december454/Microcontroller-Engine-Governor/Photos/Carb-Wiring Harness.jpg

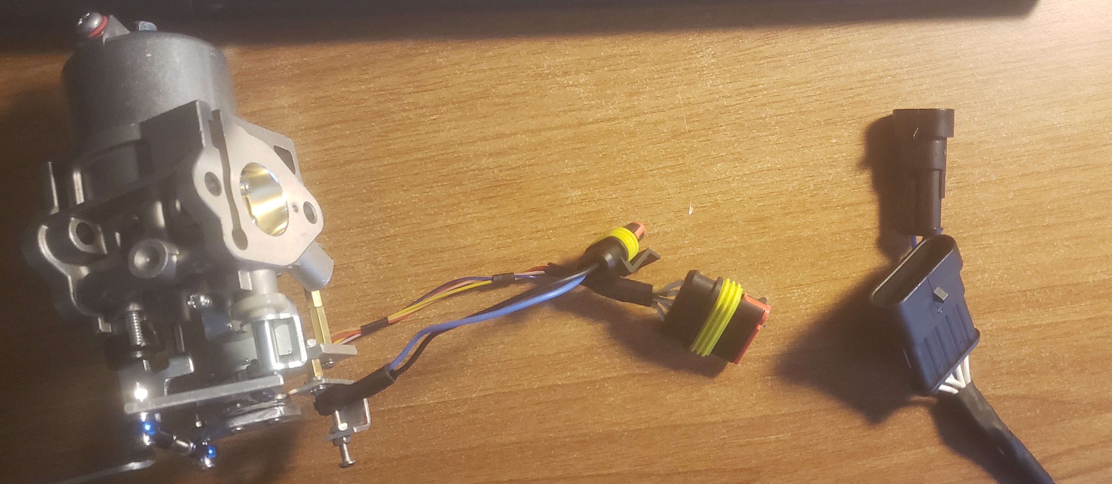
Photos/Carb-Wiring Harness.jpg
