december454/Microcontroller-Engine-Governor/Photos/Commented-Enclosure-Electronics.jpg

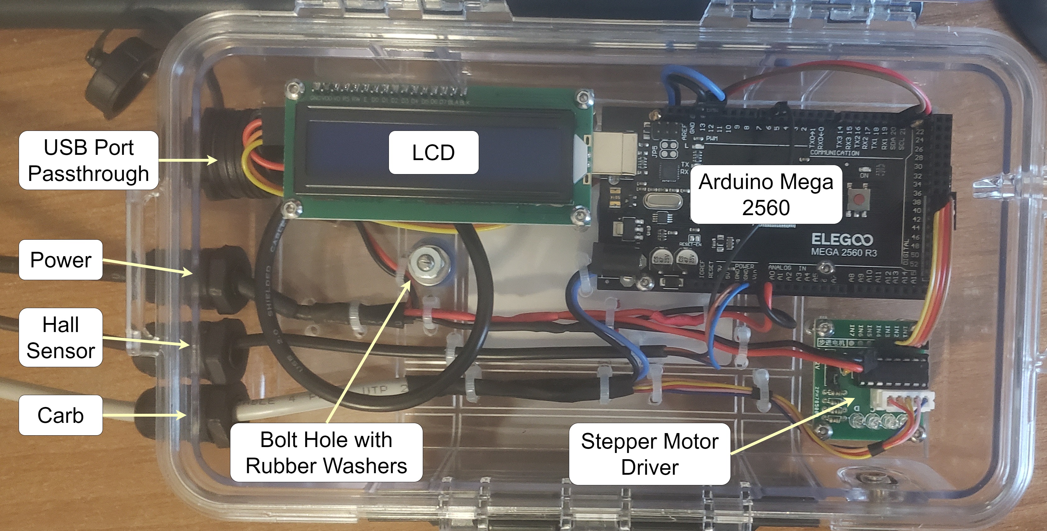
Photos/Commented-Enclosure-Electronics.jpg
