december454/Microcontroller-Engine-Governor/Diagrams/Fall 2022 - Engine Governor Simulator.pdf

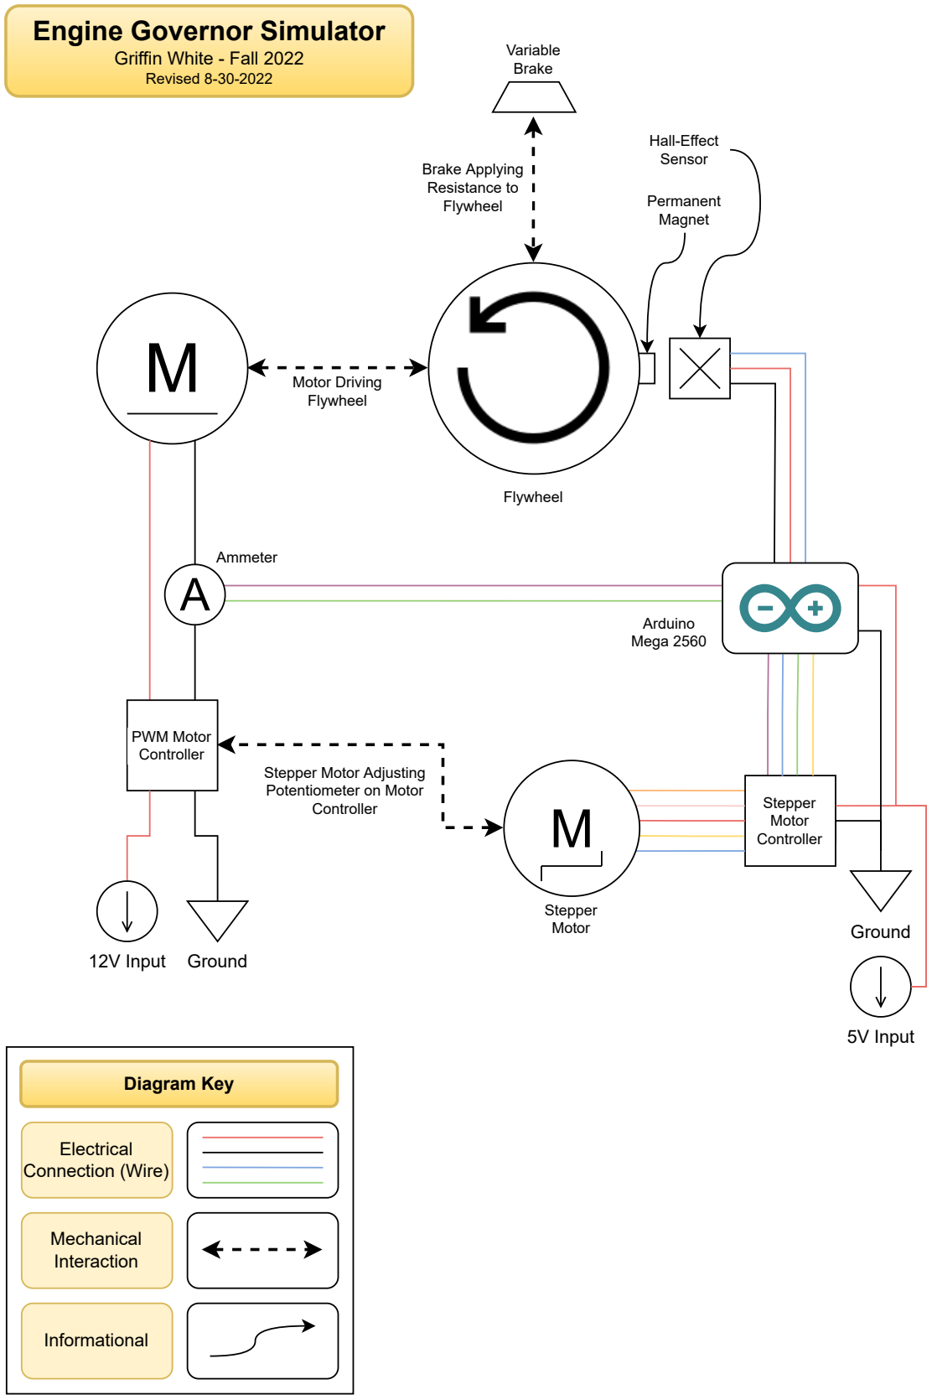
[picture p21: figure]
Ground; Stepper Motor Adjusting Potentiometer on Motor Controller; Motor Driving Flywheel; Variable Brake; Flywheel; Permanent Magnet; Hall-Effect Sensor Brake Applying; Resistance to Flywheel; Stepper Motor Controller; 5V Input; Arduino Mega 2560; Engine Governor Simulator; Griffin White - Fall 2022 Revised 8-30-2022; Diagram Key; Electrical Connection (Wire); Informational; Mechanical Interaction; PWM Motor Controller; 12V Input; Ammeter; Stepper Motor

### Component Descriptions and Functions

The flywheel assembly rotates at a constant speed. It is spun by a DC motor.

M

### Flywheel

DC Motor | The DC motor spins the flywheel. Its speed is controlled via a PWN motor controller.

### PWM Motor Controller

The PMW motor controller regulates the duty cycle of the DC motor, thereby regulating its speed. Its potentiometer is controlled by the stepper motor.

### Stepper

Motor | M

The stepper motor controls the position of the PWM motor controller's potentiometer, thereby controlling the speed of the motor. It is controlled by the Arduino.

### Hall-Effect Sensor

The hall-effect sensor produces a signal each time that a magnet passes by it. Using this signal, we can measure the RPM of the flywheel.

The brake applies a friction force to the flywheel, causing it to slow down.

### Variable Brake

Arduino | The Arduino microcontroller monitors the flywheel RPM and adjusts the stepper motor as needed.

PWM
Motor
Controller

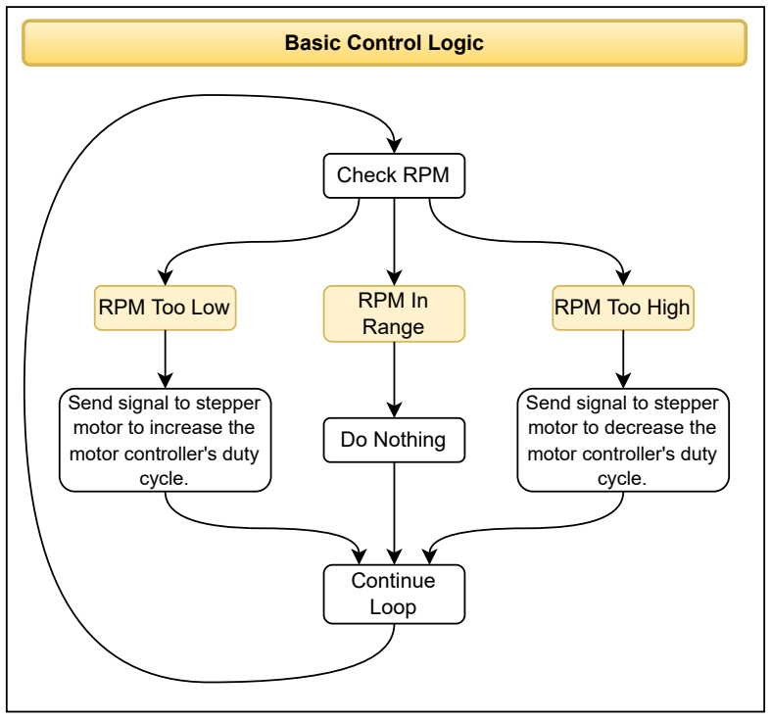
[picture p22: figure]
Check RPM; RPM Too Low; RPM In; Range; RPM Too High; Do Nothing; Send signal to stepper motor to increase the motor controller's duty cycle.; Send signal to stepper motor to decrease the motor controller's duty cycle.; Continue Loop; Basic Control Logic

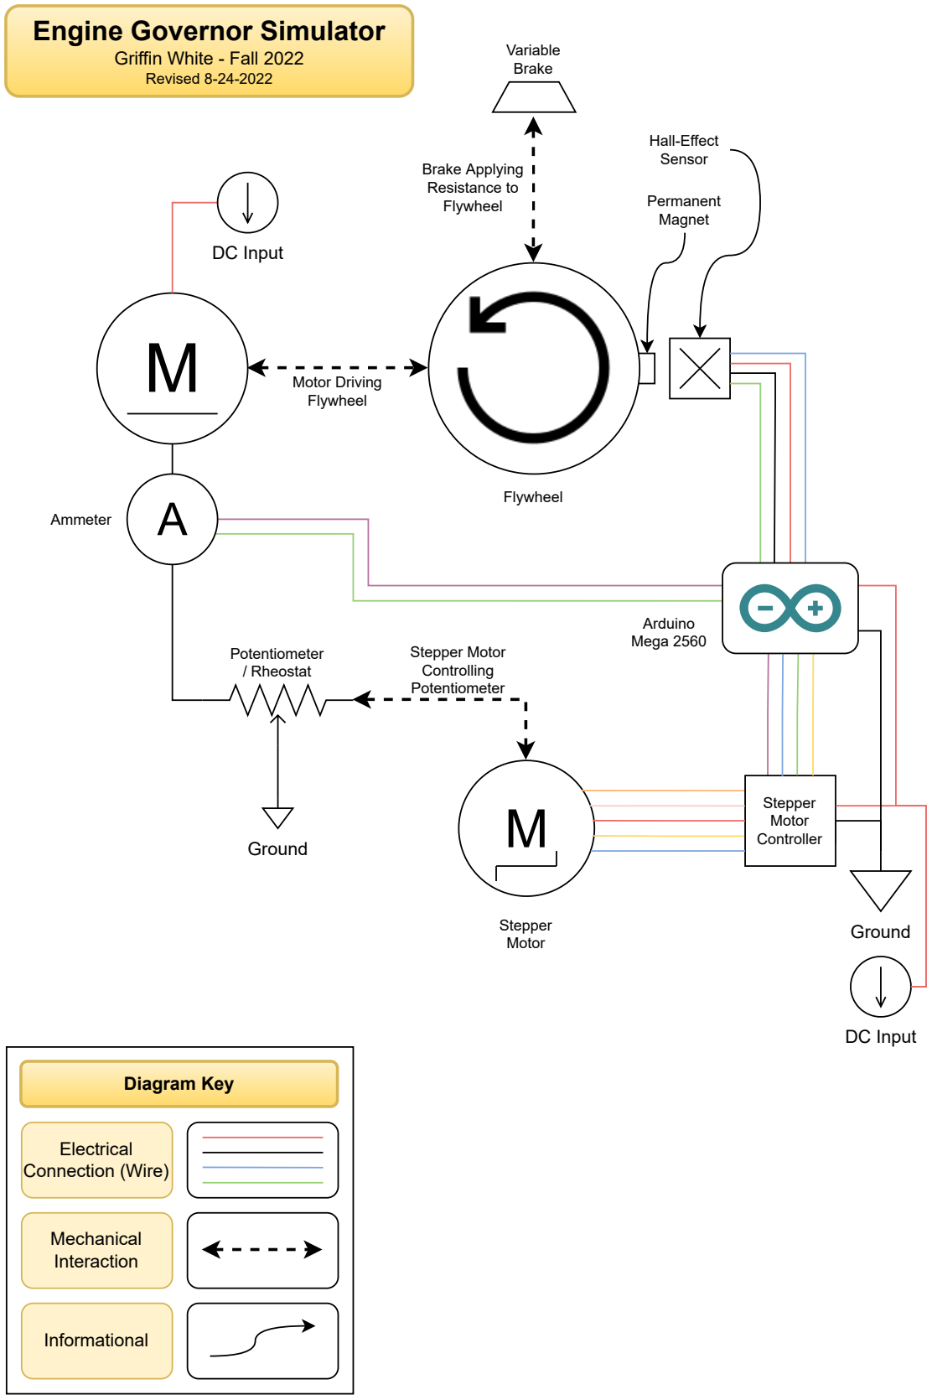
[picture p23: figure]
Ground; DC Input; Stepper Motor Controlling Potentiometer; Stepper Motor; Motor Driving Flywheel; Flywheel; Permanent Magnet; Hall-Effect Sensor Brake Applying; Resistance to Flywheel; Stepper Motor Controller; Arduino Mega 2560; Ammeter; Potentiometer / Rheostat; Engine Governor Simulator; Griffin White - Fall 2022 Revised 8-24-2022; Diagram Key; Electrical Connection (Wire); Informational; Mechanical Interaction

### Component Descriptions and Functions

The flywheel assembly rotates at a constant speed. It is spun by a DC motor.

M

### Flywheel

DC Motor | The DC motor spins the flywheel. Its speed is controlled via a potentiometer.

### Potentiometer / Rheostat

The potentiometer regulates the amount of current supplied to the DC motor, thereby regulating its speed. It is controlled by the stepper motor.

### Stepper

Motor | M

The stepper motor precisely controls the position of the potentiometer, thereby controlling the speed of the motor. It is controlled by the Arduino.

### Hall-Effect Sensor

The hall-effect sensor produces a signal each time that a magnet passes by it. Using this signal, we can measure the RPM of the flywheel.

The brake applies a friction force to the flywheel, causing it to slow down.

### Variable Brake

Arduino | The Arduino microcontroller monitors the flywheel RPM and adjusts the stepper motor as needed.

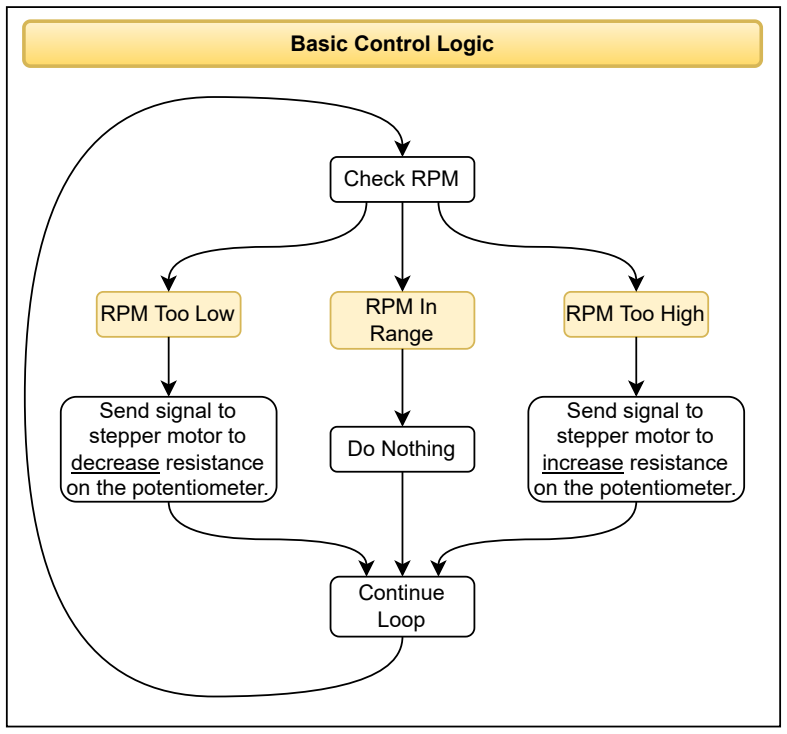
[picture p24: figure]
Check RPM; RPM Too Low; RPM In; Range; RPM Too High; Do Nothing; Send signal to stepper motor to decrease resistance on the potentiometer.; Send signal to stepper motor to increase resistance on the potentiometer.; Continue Loop; Basic Control Logic

## Permanent Magnet

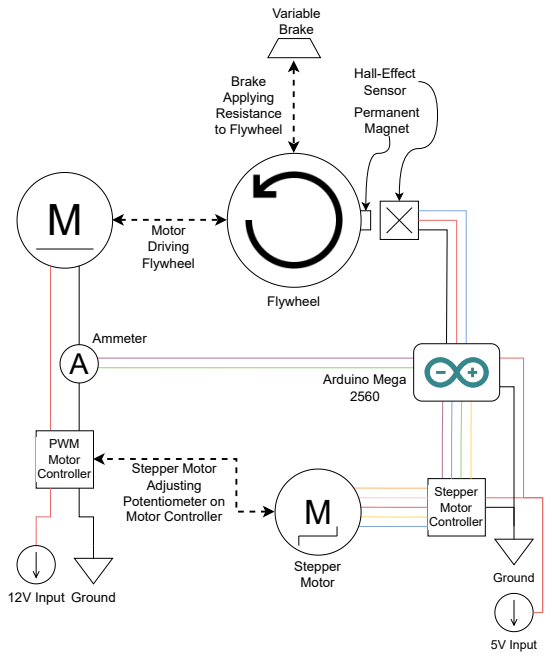
[picture p25: page 3]
Ground; Stepper Motor Adjusting Potentiometer on Motor Controller; Motor Driving Flywheel; Flywheel; Hall-Effect Sensor Brake Applying Resistance to Flywheel; Stepper Motor Controller; 5V Input; Arduino Mega 2560; PWM Motor Controller; 12V Input; Ammeter; Stepper Motor
