december454/Microcontroller-Engine-Governor/Diagrams/Spring 2023 - Microcontroller Engine Governor.pdf

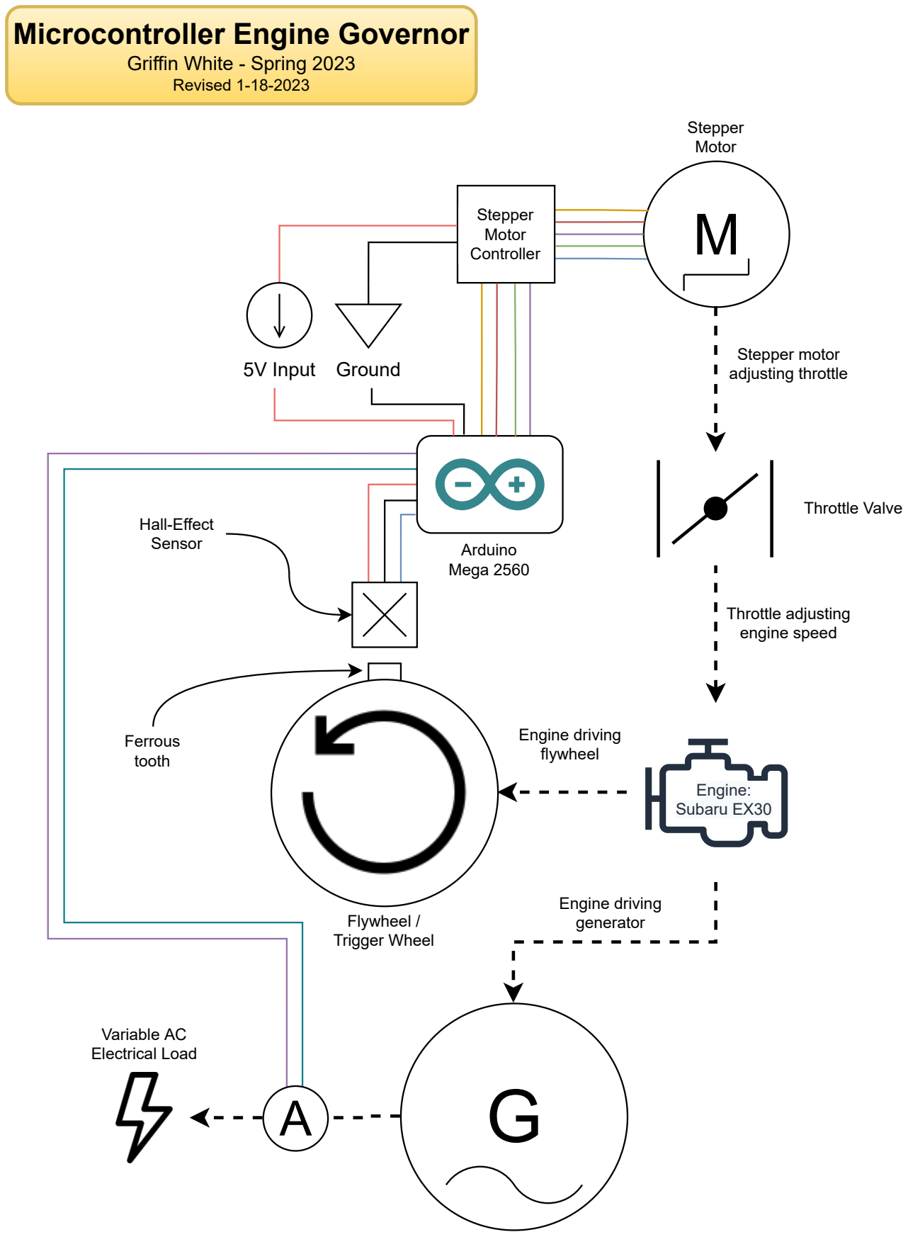
[picture p26: figure]
Microcontroller Engine Governor; Griffin White - Spring 2023 Revised 1-18-2023; Flywheel / Trigger Wheel; Engine driving flywheel; Engine driving generator; Ferrous tooth; Hall-Effect Sensor; Stepper Motor; Stepper motor adjusting throttle; Throttle Valve; Throttle adjusting engine speed; Stepper Motor Controller; Arduino Mega 2560; Engine: Subaru EX30; Variable AC Electrical Load; 5V Input Ground

### Component Descriptions and Functions

The flywheel assembly rotates at a constant speed. It is spun by the gasoline engine.

Flywheel /
Trigger Wheel
Engine | The engine spins the flywheel. Its speed is controlled via the throttle valve.

### Throttle Valve

The throttle valve regulates the amount of fuel / air provided to the engine, thereby regulating its speed. It is controlled by the stepper motor.

### Stepper

Motor | M

The stepper motor controls the position of the throttle valve, thereby controlling the speed of the engine. It is controlled by the Arduino.

### Hall-Effect Sensor

The hall-effect sensor produces a signal each time that a ferrous tooth passes by it. Using this signal, we can measure the RPM of the flywheel.

The electrical load places more / less strain on the generator, requiring the throttle to increase / decrease accordingly.

Variable AC
Electrical Load
Arduino | The Arduino microcontroller monitors the flywheel RPM and adjusts the stepper motor as needed.

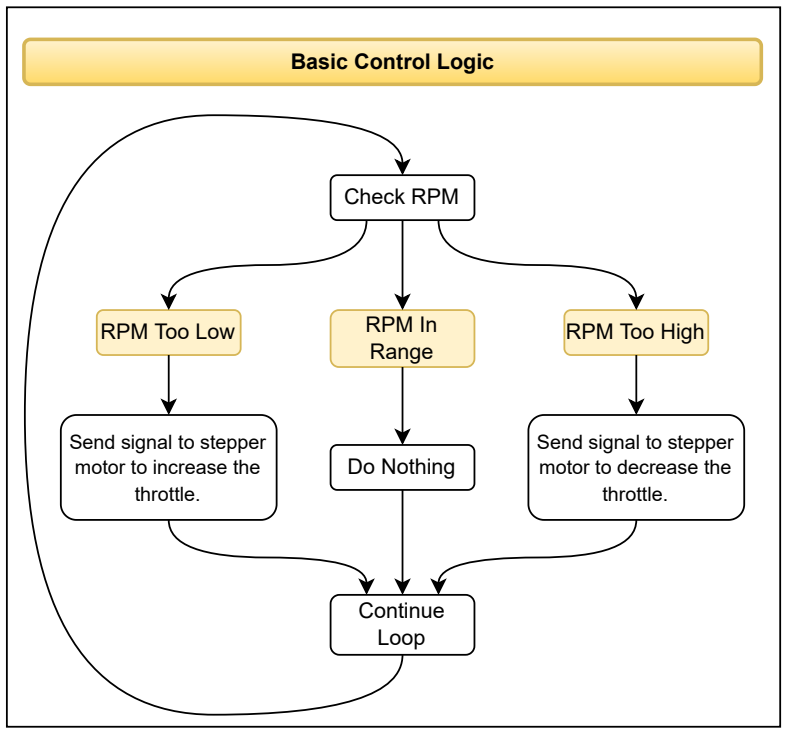
[picture p27: figure]
Check RPM; RPM Too Low; RPM In; Range; RPM Too High; Do Nothing; Send signal to stepper motor to increase the throttle.; Send signal to stepper motor to decrease the throttle.; Continue Loop; Basic Control Logic
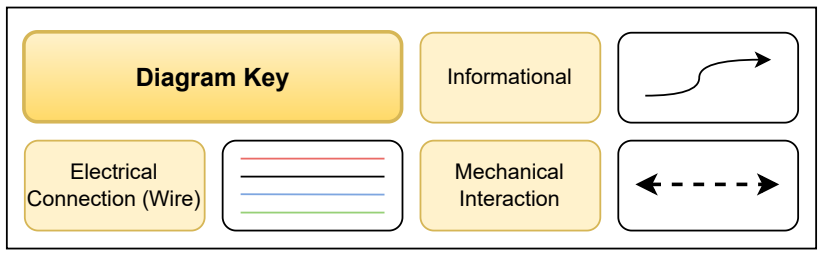
[picture p28: figure]
AC Generator; Ammeter Diagram Key; Electrical Connection (Wire); Mechanical Interaction; Informational
