december454/Microcontroller-Engine-Governor/Data-Logging/Experiments/Mechanical Governor/Abrupt Load Decrease/Trial 1.xlsx

Sheet: Trial 1
 |  |  |  |  |  |  |  |  |  | Results
1226 | 0 | 0 | 0 | 0 | 0 | 0 | 0 | 0 | 0 | Avg RPM | Std Dev | Dev from Setpoint | 20 sec to 60 sec
1276 | 0 | 0 | 0 | 0 | 0 | 0 | 0 | 0 | 0 | 3605.452559 | 37.95415156 | 29.75028714
1326 | 0 | 0 | 0 | 0 | 0 | 0 | 0 | 0 | 0 | Min RPM | Max RPM | Range
1376 | 0 | 0 | 0 | 0 | 0 | 0 | 0 | 0 | 0 | 3420.75 | 3841.23 | 420.48
1426 | 0 | 0 | 0 | 0 | 0 | 0 | 0 | 0 | 0 | Max Startup RPM | Startup Time (ms) | Overshoot Time (ms) | 0 sec to 20 sec
1476 | 0 | 0 | 0 | 0 | 0 | 0 | 0 | 0 | 0 | 3737.85 | 2950 | 150
1526 | 0 | 0 | 0 | 0 | 0 | 0 | 0 | 0 | 0
1576 | 0 | 0 | 0 | 0 | 0 | 0 | 0 | 0 | 0 | Before Load Change
1626 | 0 | 0 | 0 | 0 | 0 | 0 | 0 | 0 | 0 | Avg RPM | Std Dev | Dev from Setpoint | 20 sec to 35 sec
1676 | 0 | 0 | 0 | 0 | 0 | 0 | 0 | 0 | 0 | 3588.108372 | 32.09954969 | 24.88305648
1726 | 0 | 0 | 0 | 0 | 0 | 0 | 0 | 0 | 0 | Min RPM | Max RPM | Range
1776 | 0 | 0 | 0 | 0 | 0 | 0 | 0 | 0 | 0 | 3420.75 | 3841.23 | 420.48
1826 | 0 | 0 | 0 | 0 | 0 | 0 | 0 | 0 | 0 | During Load Change
1876 | 0 | 0 | 0 | 0 | 0 | 0 | 0 | 0 | 0 | Avg RPM | Std Dev | Dev from Setpoint | 35 sec to 45 sec
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
