december454/Microcontroller-Engine-Governor/Data-Logging/Experiments/Mechanical Governor/Abrupt Load Decrease/Trial 10.xlsx

Sheet: Trial 10
Time | RPM | Steps Remaining | PID p | PID i | PID d | RPM Change | P Cmd | I Cmd | D Cmd | Results
1226 | 0 | 0 | 0 | 0 | 0 | 0 | 0 | 0 | 0 | Avg RPM | Std Dev | Dev from Setpoint | 20 sec to 60 sec
1276 | 0 | 0 | 0 | 0 | 0 | 0 | 0 | 0 | 0 | 3603.397528 | 35.49804307 | 26.67525593
1326 | 0 | 0 | 0 | 0 | 0 | 0 | 0 | 0 | 0 | Min RPM | Max RPM | Range
1376 | 0 | 0 | 0 | 0 | 0 | 0 | 0 | 0 | 0 | 3426.22 | 3799.39 | 373.17
1426 | 0 | 0 | 0 | 0 | 0 | 0 | 0 | 0 | 0 | Max Startup RPM | Startup Time (ms) | Overshoot Time (ms) | 0 sec to 20 sec
1476 | 0 | 0 | 0 | 0 | 0 | 0 | 0 | 0 | 0 | 3840.25 | 1100 | 100
1526 | 0 | 0 | 0 | 0 | 0 | 0 | 0 | 0 | 0
1576 | 0 | 0 | 0 | 0 | 0 | 0 | 0 | 0 | 0 | Before Load Change
1626 | 0 | 0 | 0 | 0 | 0 | 0 | 0 | 0 | 0 | Avg RPM | Std Dev | Dev from Setpoint | 20 sec to 35 sec
1676 | 0 | 0 | 0 | 0 | 0 | 0 | 0 | 0 | 0 | 3590.40515 | 31.70714232 | 23.18654485
1726 | 0 | 0 | 0 | 0 | 0 | 0 | 0 | 0 | 0 | Min RPM | Max RPM | Range
1776 | 0 | 0 | 0 | 0 | 0 | 0 | 0 | 0 | 0 | 3493.25 | 3794.59 | 301.34
1826 | 0 | 0 | 0 | 0 | 0 | 0 | 0 | 0 | 0 | During Load Change
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
