december454/Microcontroller-Engine-Governor/Data-Logging/Experiments/Mechanical Governor/Abrupt Load Decrease/Trial 2.xlsx

Sheet: Trial 2
Time | RPM | Steps Remaining | PID p | PID i | PID d | RPM Change | P Cmd | I Cmd | D Cmd | Results
1226 | 0 | 0 | 0 | 0 | 0 | 0 | 0 | 0 | 0 | Avg RPM | Std Dev | Dev from Setpoint | 20 sec to 60 sec
1276 | 0 | 0 | 0 | 0 | 0 | 0 | 0 | 0 | 0 | 3608.396192 | 35.09744687 | 28.64583021
1326 | 0 | 0 | 0 | 0 | 0 | 0 | 0 | 0 | 0 | Min RPM | Max RPM | Range
1376 | 0 | 0 | 0 | 0 | 0 | 0 | 0 | 0 | 0 | 3512.88 | 3826.53 | 313.65
1426 | 0 | 0 | 0 | 0 | 0 | 0 | 0 | 0 | 0 | Max Startup RPM | Startup Time (ms) | Overshoot Time (ms) | 0 sec to 20 sec
1476 | 0 | 0 | 0 | 0 | 0 | 0 | 0 | 0 | 0 | 3726.71 | 650 | 50
1526 | 0 | 0 | 0 | 0 | 0 | 0 | 0 | 0 | 0
1576 | 0 | 0 | 0 | 0 | 0 | 0 | 0 | 0 | 0 | Before Load Change
1626 | 0 | 0 | 0 | 0 | 0 | 0 | 0 | 0 | 0 | Avg RPM | Std Dev | Dev from Setpoint | 20 sec to 35 sec
1676 | 0 | 0 | 0 | 0 | 0 | 0 | 0 | 0 | 0 | 3589.850199 | 26.70385528 | 22.26548173
1726 | 0 | 0 | 0 | 0 | 0 | 0 | 0 | 0 | 0 | Min RPM | Max RPM | Range
1776 | 0 | 0 | 0 | 0 | 0 | 0 | 0 | 0 | 0 | 3544.42 | 3826.53 | 282.11
1826 | 0 | 0 | 0 | 0 | 0 | 0 | 0 | 0 | 0 | During Load Change
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
