december454/Microcontroller-Engine-Governor/Data-Logging/Experiments/Mechanical Governor/Abrupt Load Decrease/Trial 3.xlsx

Sheet: Trial 3
Time | RPM | Steps Remaining | PID p | PID i | PID d | RPM Change | P Cmd | I Cmd | D Cmd | Results
1226 | 0 | 0 | 0 | 0 | 0 | 0 | 0 | 0 | 0 | Avg RPM | Std Dev | Dev from Setpoint | 20 sec to 60 sec
1276 | 0 | 0 | 0 | 0 | 0 | 0 | 0 | 0 | 0 | 3605.248539 | 37.4981848 | 28.23121099
1326 | 0 | 0 | 0 | 0 | 0 | 0 | 0 | 0 | 0 | Min RPM | Max RPM | Range
1376 | 0 | 0 | 0 | 0 | 0 | 0 | 0 | 0 | 0 | 3423.88 | 3834.36 | 410.48
1426 | 0 | 0 | 0 | 0 | 0 | 0 | 0 | 0 | 0 | Max Startup RPM | Startup Time (ms) | Overshoot Time (ms) | 0 sec to 20 sec
1476 | 0 | 0 | 0 | 0 | 0 | 0 | 0 | 0 | 0 | 3948.41 | 800 | 50
1526 | 0 | 0 | 0 | 0 | 0 | 0 | 0 | 0 | 0
1576 | 0 | 0 | 0 | 0 | 0 | 0 | 0 | 0 | 0 | Before Load Change
1626 | 0 | 0 | 0 | 0 | 0 | 0 | 0 | 0 | 0 | Avg RPM | Std Dev | Dev from Setpoint | 20 sec to 35 sec
1676 | 0 | 0 | 0 | 0 | 0 | 0 | 0 | 0 | 0 | 3589.564053 | 30.91480292 | 23.66318937
1726 | 0 | 0 | 0 | 0 | 0 | 0 | 0 | 0 | 0 | Min RPM | Max RPM | Range
1776 | 0 | 0 | 0 | 0 | 0 | 0 | 0 | 0 | 0 | 3517.82 | 3809.04 | 291.22
1826 | 0 | 0 | 0 | 0 | 0 | 0 | 0 | 0 | 0 | During Load Change
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
