december454/Microcontroller-Engine-Governor/Data-Logging/Experiments/Mechanical Governor/Abrupt Load Decrease/Trial 4.xlsx

Sheet: Trial 4
Time | RPM | Steps Remaining | PID p | PID i | PID d | RPM Change | P Cmd | I Cmd | D Cmd | Results
1226 | 0 | 0 | 0 | 0 | 0 | 0 | 0 | 0 | 0 | Avg RPM | Std Dev | Dev from Setpoint | 20 sec to 60 sec
1276 | 0 | 0 | 0 | 0 | 0 | 0 | 0 | 0 | 0 | 3607.228989 | 33.62950333 | 27.28516854
1326 | 0 | 0 | 0 | 0 | 0 | 0 | 0 | 0 | 0 | Min RPM | Max RPM | Range
1376 | 0 | 0 | 0 | 0 | 0 | 0 | 0 | 0 | 0 | 3476.25 | 3803.25 | 327
1426 | 0 | 0 | 0 | 0 | 0 | 0 | 0 | 0 | 0 | Max Startup RPM | Startup Time (ms) | Overshoot Time (ms) | 0 sec to 20 sec
1476 | 0 | 0 | 0 | 0 | 0 | 0 | 0 | 0 | 0 | 3792.67 | 700 | N/A
1526 | 0 | 0 | 0 | 0 | 0 | 0 | 0 | 0 | 0
1576 | 0 | 0 | 0 | 0 | 0 | 0 | 0 | 0 | 0 | Before Load Change
1626 | 0 | 0 | 0 | 0 | 0 | 0 | 0 | 0 | 0 | Avg RPM | Std Dev | Dev from Setpoint | 20 sec to 35 sec
1676 | 0 | 0 | 0 | 0 | 0 | 0 | 0 | 0 | 0 | 3591.365847 | 25.2606089 | 22.40186047
1726 | 0 | 0 | 0 | 0 | 0 | 0 | 0 | 0 | 0 | Min RPM | Max RPM | Range
1776 | 0 | 0 | 0 | 0 | 0 | 0 | 0 | 0 | 0 | 3512.06 | 3638.13 | 126.07
1826 | 0 | 0 | 0 | 0 | 0 | 0 | 0 | 0 | 0 | During Load Change
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
