december454/Microcontroller-Engine-Governor/Data-Logging/3-1-2023/Generator RPM Graph - 3-1-2023 (Intake Leak).png

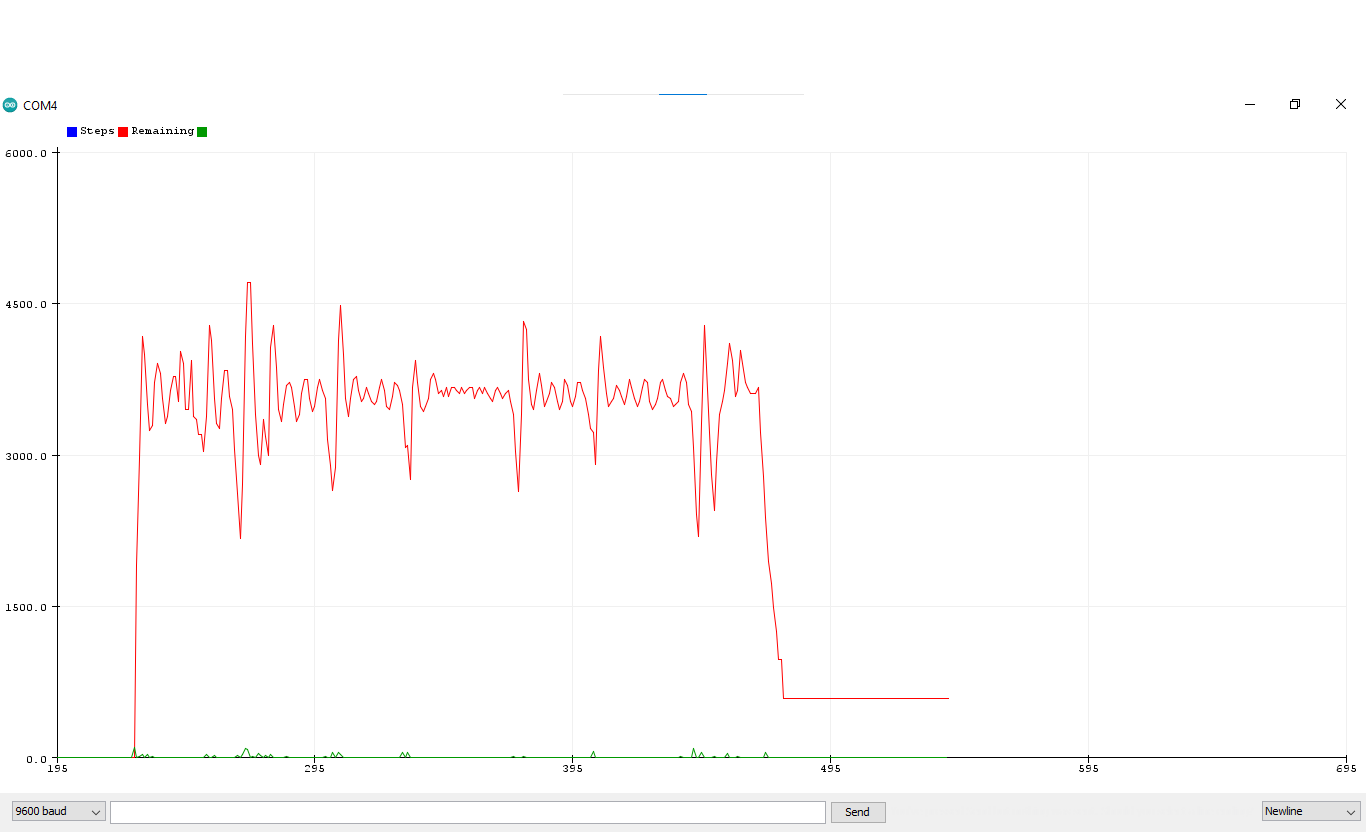
Data-Logging/3-1-2023/Generator RPM Graph - 3-1-2023 (Intake Leak).png
