december454/Microcontroller-Engine-Governor/Photos/Carburetor - Original Stepper Mounting - Commented.jpg

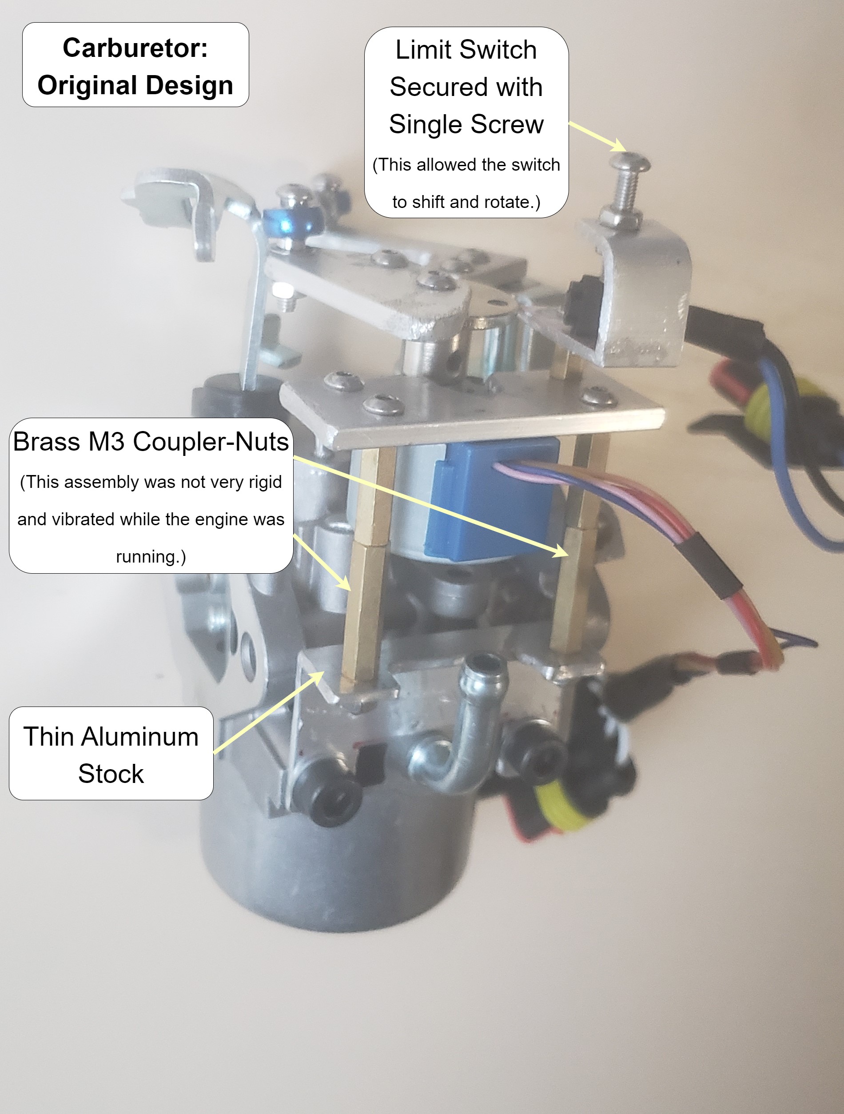
Photos/Carburetor - Original Stepper Mounting - Commented.jpg
