december454/Microcontroller-Engine-Governor/Photos/Carburetor - Revised Stepper Mounting - Commented.jpg

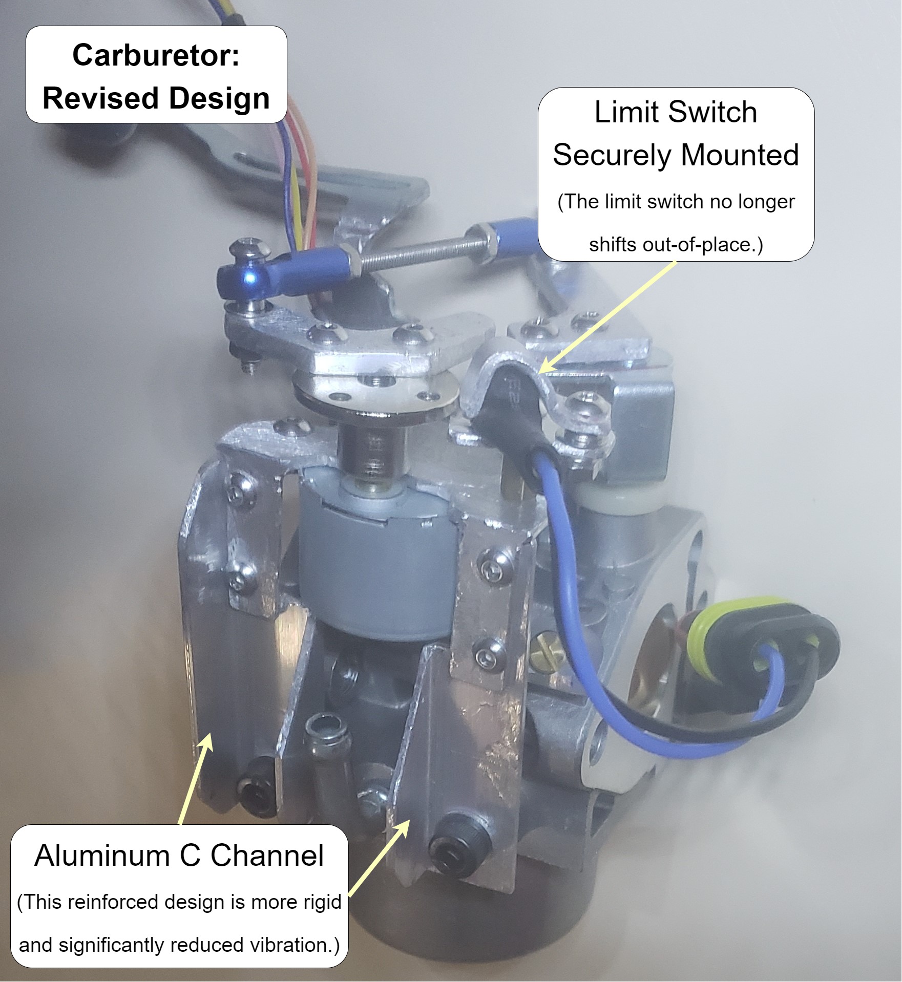
Photos/Carburetor - Revised Stepper Mounting - Commented.jpg
