december454/Microcontroller-Engine-Governor/Photos/Commented Engine Governor Carb - Initial.jpg

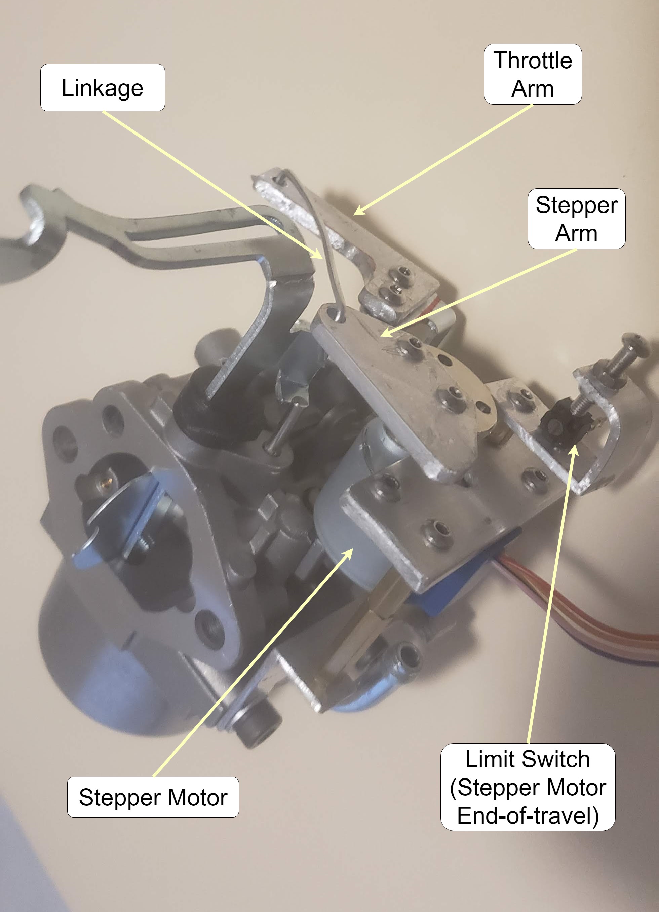
Photos/Commented Engine Governor Carb - Initial.jpg
