december454/Microcontroller-Engine-Governor/Photos/Enclosure - New LCD and Switches - Commented.jpg

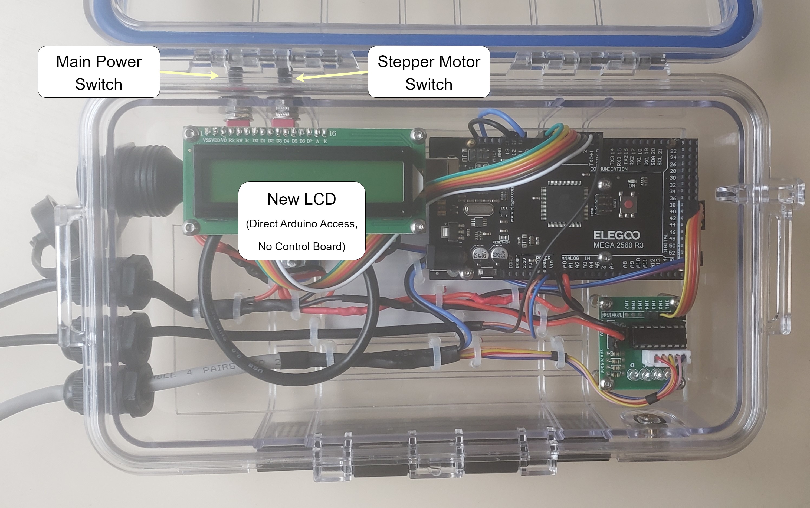
Photos/Enclosure - New LCD and Switches - Commented.jpg
