december454/Microcontroller-Engine-Governor/Photos/Enclosure-Cables Detail.jpg

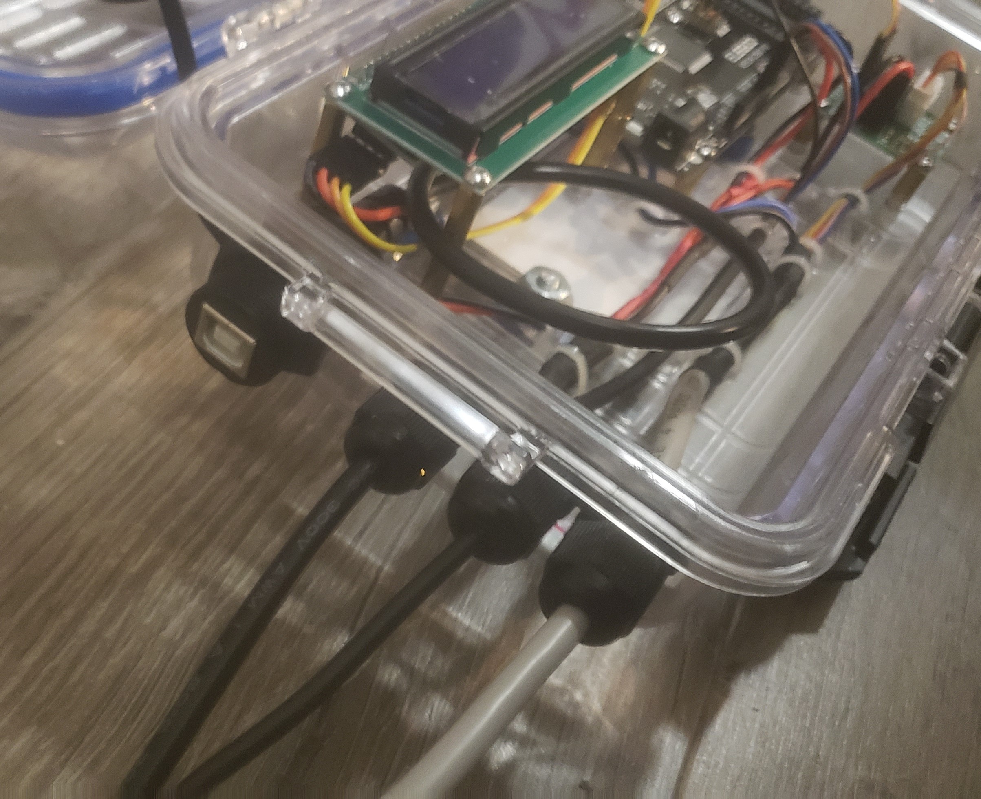
Photos/Enclosure-Cables Detail.jpg
