december454/Microcontroller-Engine-Governor/Photos/Enclosure-Lid Closed.jpg

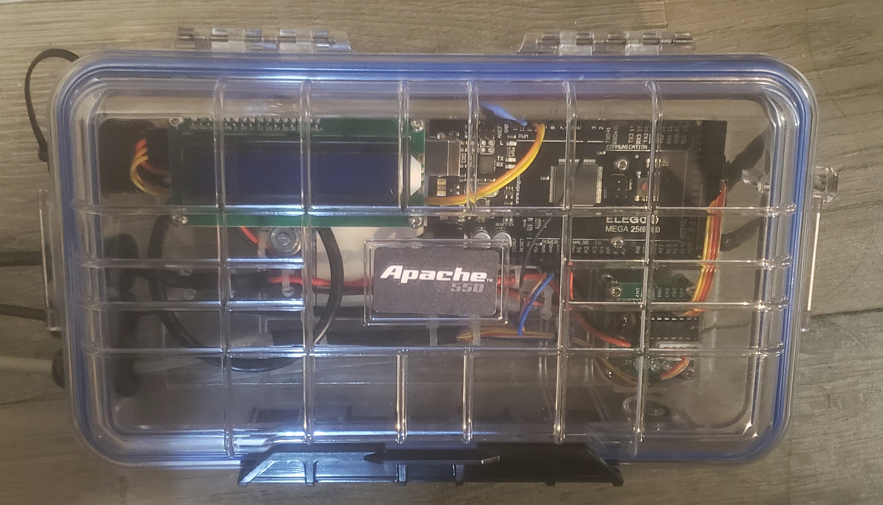
Photos/Enclosure-Lid Closed.jpg
