december454/Microcontroller-Engine-Governor/Photos/Switches - Detail - Commented.jpg

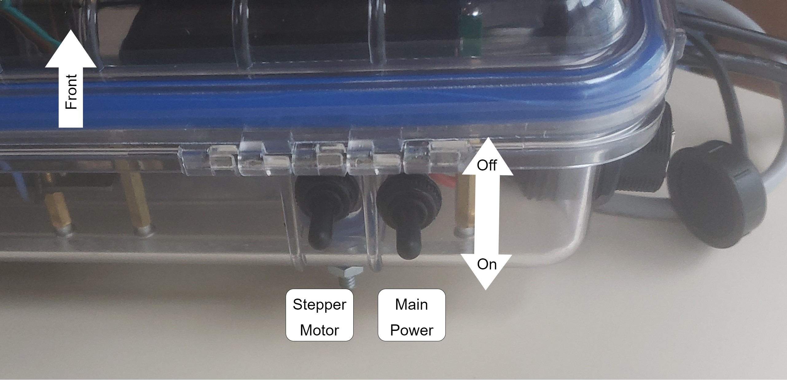
Photos/Switches - Detail - Commented.jpg
