december454/Microcontroller-Engine-Governor/Data-Logging/4-4-2023/4-4-2023 - PID Tuning - PID P Alt - (P 013 I 025 D 1) - Dynamic D Disabled.txt

------ Microcontroller Engine Governor - Version: 1.16 ------
-------------------------------------------------------------
PID Gains:        Kp: 0.013000   Ki: 0.025000   Kd: 1.000000
-------------------------------------------------------------
Set RPM:             3600    |  Min RPM:                300
                             |
RPM Precision        10       |  PID I Precision:         70
                             |
Start Steps:         850     |  Max Steps:               1200
                             |
RPM Calc Interval:   1       |  Num Magnets:             1
                             |
LCD Update Interval: 400     |  Serial Update Interval:  50
-------------------------------------------------------------

Time,RPM,Steps Remaining, PID p, PID i, PID d, RPM Change, P Cmd, I Cmd, D Cmd
1642,0.00,0,0,0,0,0.00,0,0,0
1692,0.00,0,0,0,0,0.00,0,0,0
1742,0.00,0,0,0,0,0.00,0,0,0
1792,0.00,0,0,0,0,0.00,0,0,0
1842,0.00,0,0,0,0,0.00,0,0,0
1892,0.00,0,0,0,0,0.00,0,0,0
1942,0.00,0,0,0,0,0.00,0,0,0
1992,0.00,0,0,0,0,0.00,0,0,0
2042,0.00,0,0,0,0,0.00,0,0,0
2092,0.00,0,0,0,0,0.00,0,0,0
2142,0.00,0,0,0,0,0.00,0,0,0
2192,0.00,0,0,0,0,0.00,0,0,0
2242,0.00,0,0,0,0,0.00,0,0,0
2292,0.00,0,0,0,0,0.00,0,0,0
2342,0.00,0,0,0,0,0.00,0,0,0
2392,0.00,0,0,0,0,0.00,0,0,0
2442,0.00,0,0,0,0,0.00,0,0,0
2492,0.00,0,0,0,0,0.00,0,0,0
2542,0.00,0,0,0,0,0.00,0,0,0
2592,0.00,0,0,0,0,0.00,0,0,0
2642,0.00,0,0,0,0,0.00,0,0,0
2692,0.00,0,0,0,0,0.00,0,0,0
2742,0.00,0,0,0,0,0.00,0,0,0
2792,0.00,0,0,0,0,0.00,0,0,0
2842,0.00,0,0,0,0,0.00,0,0,0
2892,0.00,0,0,0,0,0.00,0,0,0
2942,0.00,0,0,0,0,0.00,0,0,0
2992,0.00,0,0,0,0,0.00,0,0,0
3042,0.00,0,0,0,0,0.00,0,0,0
3092,0.00,0,0,0,0,0.00,0,0,0
3142,inf,0,0,0,0,inf,0,0,0
3192,inf,0,0,0,0,inf,0,0,0
3243,inf,0,0,0,0,inf,0,0,0
3293,inf,0,0,0,0,inf,0,0,0
3343,309.82,13,42,0,0,inf,42,0,0
3393,309.82,0,42,0,0,inf,42,0,0
3443,706.21,0,37,0,-4,-396.39,79,0,4
3493,748.09,23,37,0,0,-41.88,116,0,4
3543,1124.78,15,32,0,-7,-376.68,148,0,11
3593,1135.59,25,32,0,0,-10.81,180,0,11
3643,1507.99,0,27,0,-9,-372.40,207,0,20
3693,1535.78,0,26,0,0,-27.79,233,0,20
3743,1795.98,11,23,0,0,-17.67,279,0,27
3793,2061.86,16,19,0,0,-12.40,318,0,35
3843,2279.29,0,17,0,-8,-217.43,335,0,43
3893,2494.59,18,14,0,6,165.45,379,0,74
3943,2685.28,4,11,0,0,11.59,401,0,83
3993,2852.80,0,9,0,0,7.07,419,0,91
4043,3144.65,0,5,0,-7,-141.65,438,0,106
4093,3267.97,3,4,0,0,4.99,452,0,113
4143,3393.67,0,2,0,0,-3.83,456,0,119
4193,3602.31,0,1,0,0,-0.81,458,0,119
4243,3665.69,0,0,-1,0,11.68,459,1,119
4293,3826.53,-1,-2,0,0,10.77,467,1,124
4343,3945.29,-4,-4,0,-4,-68.32,477,1,131
4393,3997.87,0,-5,0,0,16.05,491,1,136
4443,4055.15,0,-5,0,-2,-43.38,506,1,141
4493,4285.71,-28,-8,0,-25,-356.96,529,1,183
4543,3995.74,0,-5,0,0,302.26,547,1,209
4593,3995.74,-3,-5,0,0,254.76,573,1,242
4643,4173.62,-10,-7,0,-12,-175.76,593,1,272
4694,3995.74,0,-5,0,0,254.76,610,1,297
4744,4040.95,-2,-5,0,-2,-43.08,633,1,352
4794,3986.18,0,-5,0,0,-13.72,647,1,352
4844,3945.29,0,-4,0,0,12.49,659,1,352
4894,4261.36,-50,-8,0,-45,-639.05,675,1,419
4944,3917.47,0,-4,0,0,-13.26,686,1,419
4994,3825.55,0,-2,0,0,39.43,694,1,419
5044,3838.28,0,-3,0,-2,-36.00,702,1,421
5094,3824.58,0,-2,0,0,27.50,709,1,423
5144,3757.52,-44,-2,0,-44,-9.39,719,1,555
5194,3757.52,-42,-2,0,-44,0.94,724,1,687
5244,3722.08,-7,-1,0,-13,26.98,730,1,726
5294,3632.84,0,0,0,0,41.83,731,1,739
5344,3546.10,0,0,1,0,38.99,731,2,739
5394,3494.06,0,1,0,0,8.16,733,3,739
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
