december454/Microcontroller-Engine-Governor/Data-Logging/4-4-2023/4-4-2023 - PID Tuning - PID P Alt - (P 013 I 025 D 1) - Major RPM Change Disabled.txt

Time	RPM	Steps Remaining	 PID p	 PID i	 PID d	 RPM Change	 P Cmd	 I Cmd	 D Cmd
1716	0	0	0	0	0	0	0	0	0
1766	0	0	0	0	0	0	0	0	0
1816	0	0	0	0	0	0	0	0	0
1866	0	0	0	0	0	0	0	0	0
1916	0	0	0	0	0	0	0	0	0
1966	0	0	0	0	0	0	0	0	0
2016	0	0	0	0	0	0	0	0	0
2066	0	0	0	0	0	0	0	0	0
2116	0	0	0	0	0	0	0	0	0
2166	0	0	0	0	0	0	0	0	0
2216	0	0	0	0	0	0	0	0	0
2266	0	0	0	0	0	0	0	0	0
2316	0	0	0	0	0	0	0	0	0
2366	0	0	0	0	0	0	0	0	0
2416	0	0	0	0	0	0	0	0	0
2466	0	0	0	0	0	0	0	0	0
2516	0	0	0	0	0	0	0	0	0
2566	0	0	0	0	0	0	0	0	0
2616	0	0	0	0	0	0	0	0	0
2666	0	0	0	0	0	0	0	0	0
2716	0	0	0	0	0	0	0	0	0
2766	0	0	0	0	0	0	0	0	0
2816	0	0	0	0	0	0	0	0	0
2866	0	0	0	0	0	0	0	0	0
2916	0	0	0	0	0	0	0	0	0
2966	0	0	0	0	0	0	0	0	0
3016	0	0	0	0	0	0	0	0	0
3066	0	0	0	0	0	0	0	0	0
3116	0	0	0	0	0	0	0	0	0
3166	0	0	0	0	0	0	0	0	0
3216	0	0	0	0	0	0	0	0	0
3266	0	0	0	0	0	0	0	0	0
3316	0	0	0	0	0	0	0	0	0
3366	0	0	0	0	0	0	0	0	0
3416	0	0	0	0	0	0	0	0	0
3466	0	0	0	0	0	0	0	0	0
3516	0	0	0	0	0	0	0	0	0
3566	0	0	0	0	0	0	0	0	0
3616	0	0	0	0	0	0	0	0	0
3666	0	0	0	0	0	0	0	0	0
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
4767	inf	0	0	0	0	inf	0	0	0
4817	inf	0	0	0	0	inf	0	0	0
4867	inf	0	0	0	0	inf	0	0	0
4917	inf	0	0	0	0	inf	0	0	0
4967	342.43	0	42	0	0	inf	42	0	0
5017	798.21	10	36	0	-5	-455.79	78	0	5
5067	798.21	0	36	0	-5	-455.79	78	0	5
5117	759.88	0	36	0	0	38.33	114	0	5
5167	742.94	26	37	0	0	16.94	151	0	5
5217	742.94	0	37	0	0	16.94	151	0	5
5267	731.92	8	37	0	0	11.02	188	0	5
5317	1131.31	0	32	0	-7	-399.39	220	0	12
5367	1144.16	10	31	0	0	-12.86	251	0	12
5417	1535.94	0	26	0	-10	-391.78	277	0	22
5467	1792.76	4	23	0	-7	-237.39	326	0	29
5517	1808.75	0	23	0	0	-16	349	0	29
5567	2154.24	0	18	0	-5	-158.5	387	0	40
5617	2310.18	0	16	0	0	-16.95	419	0	45
5667	2517.62	0	14	0	0	2.54	447	0	54
5718	2910.36	0	8	0	-5	-112.9	477	0	71
5768	3068.11	0	6	0	-8	-165.64	492	0	79
5818	3207.87	0	5	0	0	9.63	507	0	87
5868	3460.21	0	1	0	-2	-122.42	514	0	97
5918	3573.13	0	0	0	0	5.97	515	0	97
5968	3763.17	0	-2	0	0	-81.29	519	0	97
6018	3843.2	0	-3	0	0	7.89	527	0	102
6068	3975.62	0	-4	0	-4	-67.33	539	0	112
6118	4051.86	-5	-5	0	-3	-51.86	558	0	118
6168	4077.19	0	-6	0	0	35.77	575	0	123
6218	4144.79	-6	-7	0	0	12.64	601	0	129
6268	4162.04	0	-7	0	0	1.15	622	0	131
6318	4174.78	0	-7	0	0	13.99	643	0	133
6368	4447.08	-31	-11	0	-27	-415.91	674	0	194
6418	4029.01	0	-5	0	0	278.86	695	0	201
6468	4534.46	-42	-12	0	-38	-505.45	734	0	324
6518	4200.5	-6	-7	0	0	-4.7	763	0	326
6568	4137.93	0	-6	0	0	11.45	783	0	326
6618	4142.5	0	-7	0	-1	-18.22	803	0	327
6668	4088.31	-4	-6	0	-3	-58.22	826	0	340
6718	4006.41	0	-5	0	0	9.65	841	0	340
6768	4030.09	0	-5	0	-2	-31.16	856	0	343
6818	4014.99	-17	-5	0	-16	-234.75	873	1	443
6868	3779.29	-10	-2	0	-16	328.05	885	1	470
6918	3780.24	-12	-2	0	-22	415.56	898	1	519
6968	3858.02	-2	-3	0	0	129.22	915	1	533
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
