december454/Microcontroller-Engine-Governor/Data-Logging/4-4-2023/4-4-2023 - PID Tuning - PID P Alt - (P 02 I 025 D 2) - Major RPM Change Disabled.txt

------ Microcontroller Engine Governor - Version: 1.16 ------
-------------------------------------------------------------
PID Gains:        Kp: 0.020000   Ki: 0.025000   Kd: 2.000000
-------------------------------------------------------------
Set RPM:             3600    |  Min RPM:                300
                             |
RPM Precision        10       |  PID I Precision:         70
                             |
Start Steps:         850     |  Max Steps:               1200
                             |
RPM Calc Interval:   1       |  Num Magnets:             1
                             |
LCD Update Interval: 400     |  Serial Update Interval:  50
-------------------------------------------------------------

Time,RPM,Steps Remaining, PID p, PID i, PID d, RPM Change, P Cmd, I Cmd, D Cmd
90,inf,0,0,0,0,0.00,0,0,0
140,3205.13,0,0,0,0,0.00,0,0,0
190,3187.42,0,0,0,0,0.00,0,0,0
240,3240.44,0,0,0,0,0.00,0,0,0
290,3248.86,0,0,0,0,0.00,0,0,0
340,3258.74,0,0,0,0,0.00,0,0,0
390,3196.25,0,0,0,0,0.00,0,0,0
440,3151.92,0,0,0,0,0.00,0,0,0
490,3152.58,0,0,0,0,0.00,0,0,0
540,3186.74,0,0,0,0,0.00,0,0,0
590,3161.89,0,0,0,0,0.00,0,0,0
640,3143.99,0,0,0,0,0.00,0,0,0
690,3205.13,0,0,0,0,0.00,0,0,0
740,3160.56,0,0,0,0,0.00,0,0,0
790,3110.74,0,0,0,0,0.00,0,0,0
840,3056.86,0,0,0,0,0.00,0,0,0
890,3070.00,0,0,0,0,0.00,0,0,0
940,3038.28,0,0,0,0,0.00,0,0,0
990,3046.30,0,0,0,0,0.00,0,0,0
1040,3022.97,0,0,0,0,0.00,0,0,0
1090,3022.37,0,0,0,0,0.00,0,0,0
1140,2946.38,0,0,0,0,0.00,0,0,0
1190,2954.50,0,0,0,0,0.00,0,0,0
1240,2925.12,0,0,0,0,0.00,0,0,0
1290,2931.41,0,0,0,0,0.00,0,0,0
1340,2881.29,0,0,0,0,0.00,0,0,0
1390,2873.56,0,0,0,0,0.00,0,0,0
1440,2831.79,0,0,0,0,0.00,0,0,0
1490,2805.31,0,0,0,0,0.00,0,0,0
1540,2777.78,0,0,0,0,0.00,0,0,0
1590,2726.28,0,0,0,0,0.00,0,0,0
1640,2653.46,0,0,0,0,0.00,0,0,0
1690,2627.43,0,0,0,0,0.00,0,0,0
1740,2633.43,0,0,0,0,0.00,0,0,0
1790,2592.91,0,0,0,0,0.00,0,0,0
1840,2616.43,0,0,0,0,0.00,0,0,0
1890,2610.97,0,0,0,0,0.00,0,0,0
1940,2639.92,0,0,0,0,0.00,0,0,0
1990,2581.76,0,0,0,0,0.00,0,0,0
2040,2526.53,0,0,0,0,0.00,0,0,0
2091,2477.29,0,0,0,0,0.00,0,0,0
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
