december454/Microcontroller-Engine-Governor/Data-Logging/4-5-2023/4-5-2023 - PID Tuning - PID P Alt - (P 013 I 025 D 0_1).txt

846,0.00,0,0,0,0,0.00,0,0,0
9996,0.00,0,0,0,0,0.00,0,0,0
10046,0.00,0,0,0,0,0.00,0,0,0
10096,0.00,0,0,0,0,0.00,0,0,0
------ Microcontroller Engine Governor - Version: 1.16 ------
-------------------------------------------------------------
PID Gains:        Kp: 0.013000   Ki: 0.025000   Kd: 0.100000
-------------------------------------------------------------
Set RPM:             3600    |  Min RPM:                300
                             |
RPM Precision        20       |  PID I Precision:         70
                             |
Start Steps:         850     |  Max Steps:               1200
                             |
RPM Calc Interval:   1       |  Num Magnets:             1
                             |
LCD Update Interval: 400     |  Serial Update Interval:  50
-------------------------------------------------------------

Time,RPM,Steps Remaining, PID p, PID i, PID d, RPM Change, P Cmd, I Cmd, D Cmd
1717,0.00,0,0,0,0,0.00,0,0,0
1767,0.00,0,0,0,0,0.00,0,0,0
1817,0.00,0,0,0,0,0.00,0,0,0
1867,0.00,0,0,0,0,0.00,0,0,0
1917,0.00,0,0,0,0,0.00,0,0,0
1967,0.00,0,0,0,0,0.00,0,0,0
2017,0.00,0,0,0,0,0.00,0,0,0
2067,0.00,0,0,0,0,0.00,0,0,0
2117,0.00,0,0,0,0,0.00,0,0,0
2167,0.00,0,0,0,0,0.00,0,0,0
2217,0.00,0,0,0,0,0.00,0,0,0
2267,0.00,0,0,0,0,0.00,0,0,0
2317,0.00,0,0,0,0,0.00,0,0,0
2367,0.00,0,0,0,0,0.00,0,0,0
2417,0.00,0,0,0,0,0.00,0,0,0
2467,0.00,0,0,0,0,0.00,0,0,0
2518,0.00,0,0,0,0,0.00,0,0,0
2568,0.00,0,0,0,0,0.00,0,0,0
2618,0.00,0,0,0,0,0.00,0,0,0
2668,0.00,0,0,0,0,0.00,0,0,0
2718,0.00,0,0,0,0,0.00,0,0,0
2768,0.00,0,0,0,0,0.00,0,0,0
2818,0.00,0,0,0,0,0.00,0,0,0
2868,0.00,0,0,0,0,0.00,0,0,0
2918,0.00,0,0,0,0,0.00,0,0,0
2968,0.00,0,0,0,0,0.00,0,0,0
3018,0.00,0,0,0,0,0.00,0,0,0
3068,0.00,0,0,0,0,0.00,0,0,0
3118,0.00,0,0,0,0,0.00,0,0,0
3168,0.00,0,0,0,0,0.00,0,0,0
3218,0.00,0,0,0,0,0.00,0,0,0
3268,0.00,0,0,0,0,0.00,0,0,0
3318,0.00,0,0,0,0,0.00,0,0,0
3368,0.00,0,0,0,0,0.00,0,0,0
3418,0.00,0,0,0,0,0.00,0,0,0
3468,0.00,0,0,0,0,0.00,0,0,0
3518,0.00,0,0,0,0,0.00,0,0,0
3568,0.00,0,0,0,0,0.00,0,0,0
3618,0.00,0,0,0,0,0.00,0,0,0
3668,0.00,0,0,0,0,0.00,0,0,0
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
6069,inf,0,0,0,0,inf,0,0,0
6119,828.09,29,36,0,0,inf,36,0,0
6169,828.09,0,36,0,0,inf,36,0,0
6219,779.87,5,36,0,0,48.22,72,0,0
6269,766.64,33,36,0,0,13.23,108,0,0
6319,766.64,0,36,0,0,13.23,108,0,0
6369,760.96,13,36,0,0,5.68,144,0,0
6419,1171.88,9,31,0,0,-410.92,175,0,0
6469,1186.52,9,31,0,0,-14.65,206,0,0
6519,1573.81,0,26,0,-1,-387.29,232,0,1
6569,1841.17,10,22,0,0,-249.32,280,0,1
6619,2129.47,17,19,0,0,-248.83,321,0,1
6669,2154.24,0,18,0,0,-24.77,339,0,1
6719,2619.63,11,12,0,0,-150.90,381,0,1
6769,2814.26,3,10,0,0,-205.11,403,0,1
6819,2992.22,0,7,0,0,-178.49,420,0,1
6870,3163.22,0,5,0,0,-4.00,437,0,1
6920,3457.81,0,1,0,0,-139.96,444,0,2
6970,3575.69,0,0,0,0,24.89,445,0,2
7020,3795.55,0,-2,0,0,-97.32,449,0,2
7070,3849.11,0,-3,0,0,23.85,457,0,2
7120,4012.84,0,-5,0,0,-85.11,470,0,2
7170,4140.22,-4,-7,0,0,-57.47,494,0,2
7220,4125.41,0,-6,0,0,28.56,513,0,2
7270,4263.79,-5,-8,0,0,-2.42,543,0,2
7320,4310.34,0,-9,0,0,-17.27,570,0,2
7370,4410.47,-6,-10,0,0,-67.68,607,0,2
7420,4443.13,-9,-10,0,0,-36.55,646,0,3
7470,4441.81,0,-10,0,0,18.49,677,0,3
7520,4443.13,-4,-10,0,0,33.15,719,0,3
7570,4458.98,-9,-11,0,0,1.33,762,0,3
7620,4512.64,0,-11,0,0,-54.98,795,0,3
7670,4477.61,-3,-11,0,0,-35.80,838,0,3
7720,4373.18,-7,-10,0,0,14.07,878,0,3
7770,4357.93,0,-9,0,0,16.52,906,0,3
7820,4342.79,-3,-9,0,0,31.66,943,0,3
7870,4359.20,-8,-9,0,0,15.26,981,0,3
7920,4357.93,0,-9,0,0,2.53,1009,0,3
7970,4311.58,-5,-9,0,0,-34.42,1044,0,3
8020,4278.38,0,-8,0,0,30.73,1069,0,3
8070,4230.12,-4,-8,0,0,31.24,1101,0,3
8120,4228.93,0,-8,0,0,-14.26,1124,0,3
8170,4184.10,-3,-7,0,0,16.40,1153,0,3
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
