december454/Microcontroller-Engine-Governor/Data-Logging/4-5-2023/4-5-2023 - PID Tuning - PID P Alt - (P 013 I 025 D 3) - Dynamic D Gain Disabled.txt

------ Microcontroller Engine Governor - Version: 1.16 ------
-------------------------------------------------------------
PID Gains:        Kp: 0.013000   Ki: 0.025000   Kd: 3.000000
-------------------------------------------------------------
Set RPM:             3600    |  Min RPM:                300
                             |
RPM Precision        10       |  PID I Precision:         70
                             |
Start Steps:         850     |  Max Steps:               1200
                             |
RPM Calc Interval:   1       |  Num Magnets:             1
                             |
LCD Update Interval: 400     |  Serial Update Interval:  50
-------------------------------------------------------------

Time,RPM,Steps Remaining, PID p, PID i, PID d, RPM Change, P Cmd, I Cmd, D Cmd
1731,0.00,0,0,0,0,0.00,0,0,0
1781,0.00,0,0,0,0,0.00,0,0,0
1831,0.00,0,0,0,0,0.00,0,0,0
1881,0.00,0,0,0,0,0.00,0,0,0
1931,0.00,0,0,0,0,0.00,0,0,0
1981,0.00,0,0,0,0,0.00,0,0,0
2031,0.00,0,0,0,0,0.00,0,0,0
2081,0.00,0,0,0,0,0.00,0,0,0
2131,0.00,0,0,0,0,0.00,0,0,0
2181,0.00,0,0,0,0,0.00,0,0,0
2231,0.00,0,0,0,0,0.00,0,0,0
2281,0.00,0,0,0,0,0.00,0,0,0
2331,0.00,0,0,0,0,0.00,0,0,0
2381,0.00,0,0,0,0,0.00,0,0,0
2432,0.00,0,0,0,0,0.00,0,0,0
2482,0.00,0,0,0,0,0.00,0,0,0
2532,0.00,0,0,0,0,0.00,0,0,0
2582,0.00,0,0,0,0,0.00,0,0,0
2632,0.00,0,0,0,0,0.00,0,0,0
2682,0.00,0,0,0,0,0.00,0,0,0
2732,0.00,0,0,0,0,0.00,0,0,0
2782,0.00,0,0,0,0,0.00,0,0,0
2832,0.00,0,0,0,0,0.00,0,0,0
2882,0.00,0,0,0,0,0.00,0,0,0
2932,0.00,0,0,0,0,0.00,0,0,0
2982,0.00,0,0,0,0,0.00,0,0,0
3032,0.00,0,0,0,0,0.00,0,0,0
3082,0.00,0,0,0,0,0.00,0,0,0
3132,0.00,0,0,0,0,0.00,0,0,0
3182,0.00,0,0,0,0,0.00,0,0,0
3232,0.00,0,0,0,0,0.00,0,0,0
3282,0.00,0,0,0,0,0.00,0,0,0
3332,0.00,0,0,0,0,0.00,0,0,0
3382,0.00,0,0,0,0,0.00,0,0,0
3432,0.00,0,0,0,0,0.00,0,0,0
3482,0.00,0,0,0,0,0.00,0,0,0
3532,0.00,0,0,0,0,0.00,0,0,0
3582,0.00,0,0,0,0,0.00,0,0,0
3632,0.00,0,0,0,0,0.00,0,0,0
3682,0.00,0,0,0,0,0.00,0,0,0
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
8635,inf,0,0,0,0,inf,0,0,0
8685,inf,0,0,0,0,inf,0,0,0
8735,507.80,32,40,0,0,inf,40,0,0
8785,507.80,0,40,0,0,inf,40,0,0
8835,595.99,31,39,0,-2,-88.19,79,0,2
8885,595.99,0,39,0,-2,-88.19,79,0,2
8935,996.88,0,33,0,-19,-400.88,112,0,21
8985,965.19,1,34,0,1,31.69,146,0,22
9035,1271.62,0,30,0,-19,-306.43,176,0,41
9085,1609.96,0,25,0,-25,-327.80,231,0,66
9135,1624.26,8,25,0,-1,-14.30,256,0,67
9185,1883.95,19,22,0,-1,-10.82,300,0,91
9235,2108.22,0,19,0,-24,-224.27,319,0,115
9285,2302.73,0,16,0,-20,-181.09,354,0,136
9335,2500.00,0,14,0,-22,-180.53,384,0,159
9385,2676.18,0,12,0,-22,-174.51,410,0,181
9435,2860.41,19,9,0,16,110.47,442,0,306
9485,2977.96,0,8,0,-3,-24.04,458,0,322
9535,3176.62,-4,5,0,-17,-119.14,476,0,353
9585,3257.33,3,4,0,1,11.36,489,0,371
9635,3361.72,0,3,0,0,13.62,494,0,389
9686,3547.78,0,0,1,0,24.50,497,1,389
9736,3595.40,0,1,0,0,32.43,498,1,389
9786,3653.19,0,0,-1,0,-39.60,498,3,389
9836,3711.95,0,-1,0,0,-87.89,499,3,389
9886,3757.52,-105,-2,0,-104,-11.26,507,3,701
9936,3747.19,-70,-1,0,-73,279.66,514,3,847
9986,3745.32,-34,-1,0,-38,144.72,519,3,923
10036,3689.13,0,-1,0,0,85.41,523,3,923
10086,3677.37,0,-1,0,0,25.42,525,3,923
10136,3665.69,0,0,-1,0,35.27,527,4,923
10186,3690.94,0,-1,0,0,7.28,529,5,923
10236,3712.87,0,-1,0,0,-0.92,533,5,923
10286,3651.41,0,0,-1,0,15.17,534,7,923
10336,3723.01,0,-1,0,0,-57.32,536,8,923
10386,3665.69,0,0,-1,0,27.07,538,9,923
10437,3737.85,0,-1,0,0,23.43,543,9,923
10487,3750.94,0,-1,0,0,10.35,548,9,923
10537,3762.23,0,-2,0,0,23.74,553,9,923
10587,3820.68,-1,-2,0,-6,-34.72,559,9,943
10637,3749.06,0,-1,0,-6,10.34,564,9,961
10687,3785.01,0,-2,0,-6,-25.61,570,9,979
10737,3784.06,0,-2,0,-7,25.95,576,9,999
10787,3757.52,-30,-2,0,-29,-10.33,583,9,1093
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
