december454/Microcontroller-Engine-Governor/Data-Logging/4-5-2023/4-5-2023 - PID Tuning - PID P Alt - (P 013 I 025 D 3) - Dynamic D Gain Updated.txt

------ Microcontroller Engine Governor - Version: 1.16 ------
-------------------------------------------------------------
PID Gains:        Kp: 0.013000   Ki: 0.025000   Kd: 3.000000
-------------------------------------------------------------
Set RPM:             3600    |  Min RPM:                300
                             |
RPM Precision        10       |  PID I Precision:         70
                             |
Start Steps:         850     |  Max Steps:               1200
                             |
RPM Calc Interval:   1       |  Num Magnets:             1
                             |
LCD Update Interval: 400     |  Serial Update Interval:  50
-------------------------------------------------------------

Time,RPM,Steps Remaining, PID p, PID i, PID d, RPM Change, P Cmd, I Cmd, D Cmd
1718,0.00,0,0,0,0,0.00,0,0,0
1768,0.00,0,0,0,0,0.00,0,0,0
1818,0.00,0,0,0,0,0.00,0,0,0
1868,0.00,0,0,0,0,0.00,0,0,0
1918,0.00,0,0,0,0,0.00,0,0,0
1968,0.00,0,0,0,0,0.00,0,0,0
2018,0.00,0,0,0,0,0.00,0,0,0
2068,0.00,0,0,0,0,0.00,0,0,0
2118,0.00,0,0,0,0,0.00,0,0,0
2168,0.00,0,0,0,0,0.00,0,0,0
2219,0.00,0,0,0,0,0.00,0,0,0
2269,0.00,0,0,0,0,0.00,0,0,0
2319,0.00,0,0,0,0,0.00,0,0,0
2369,0.00,0,0,0,0,0.00,0,0,0
2419,0.00,0,0,0,0,0.00,0,0,0
2469,0.00,0,0,0,0,0.00,0,0,0
2519,0.00,0,0,0,0,0.00,0,0,0
2569,0.00,0,0,0,0,0.00,0,0,0
2619,0.00,0,0,0,0,0.00,0,0,0
2669,0.00,0,0,0,0,0.00,0,0,0
2719,0.00,0,0,0,0,0.00,0,0,0
2769,0.00,0,0,0,0,0.00,0,0,0
2819,0.00,0,0,0,0,0.00,0,0,0
2869,0.00,0,0,0,0,0.00,0,0,0
2919,0.00,0,0,0,0,0.00,0,0,0
2969,0.00,0,0,0,0,0.00,0,0,0
3019,0.00,0,0,0,0,0.00,0,0,0
3069,0.00,0,0,0,0,0.00,0,0,0
3119,0.00,0,0,0,0,0.00,0,0,0
3169,0.00,0,0,0,0,0.00,0,0,0
3219,0.00,0,0,0,0,0.00,0,0,0
3269,0.00,0,0,0,0,0.00,0,0,0
3319,0.00,0,0,0,0,0.00,0,0,0
3369,0.00,0,0,0,0,0.00,0,0,0
3419,0.00,0,0,0,0,0.00,0,0,0
3469,0.00,0,0,0,0,0.00,0,0,0
3519,0.00,0,0,0,0,0.00,0,0,0
3569,0.00,0,0,0,0,0.00,0,0,0
3619,0.00,0,0,0,0,0.00,0,0,0
3670,0.00,0,0,0,0,0.00,0,0,0
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
4920,inf,0,0,0,0,inf,0,0,0
4970,inf,0,0,0,0,inf,0,0,0
5020,493.88,33,40,0,0,inf,40,0,0
5070,493.88,0,40,0,0,inf,40,0,0
5120,628.01,23,38,0,-4,-134.13,78,0,4
5170,1069.52,4,32,0,-23,-441.51,110,0,27
5220,1069.52,0,32,0,-23,-441.51,110,0,27
5270,1506.48,0,27,0,-33,-449.25,170,0,60
5320,1488.54,10,27,0,1,17.94,197,0,61
5370,1719.79,0,24,0,-19,-231.25,221,0,80
5420,2020.47,0,20,0,-31,-319.22,265,0,112
5470,2191.06,0,18,0,-22,-200.35,303,0,136
5520,2381.71,0,15,0,-20,-171.28,336,0,158
5570,2562.79,0,13,0,-21,-170.06,364,0,180
5620,2709.54,0,11,0,-20,-150.68,388,0,200
5670,2852.25,0,9,0,-20,-150.04,408,0,220
5720,2858.78,40,9,0,38,256.49,435,0,348
5770,3015.08,5,7,0,14,91.80,448,0,399
5820,3288.03,36,4,0,45,273.22,459,0,448
5870,3385.24,0,2,0,0,2.29,467,0,456
5920,3562.95,0,0,0,0,-86.70,469,0,456
5970,3645.20,0,0,-1,0,-5.31,469,2,456
6020,3791.71,0,-2,0,-4,-74.24,473,2,460
6070,3733.20,0,-1,0,0,133.78,479,2,474
6120,4117.49,-59,-6,0,-69,-372.17,491,2,598
6170,4127.68,-29,-6,0,-28,-135.14,516,2,1028
6220,3746.25,0,-1,0,0,281.67,525,2,1050
6270,4071.66,-6,-6,0,-15,-79.11,545,2,1191
6320,4144.79,-32,-7,0,-30,-153.31,573,2,1519
6370,3992.55,0,-5,0,0,257.95,589,2,1598
6420,3992.55,-4,-5,0,0,179.91,613,2,1667
6470,4158.58,-35,-7,0,-35,-166.03,632,2,1738
6520,3994.67,0,-5,0,0,255.82,649,2,1806
6571,3845.17,-1,-3,0,0,253.19,668,2,1860
6621,3986.18,0,-5,0,0,6.37,685,2,1930
6671,3969.30,0,-4,0,0,29.63,698,2,1933
6721,3917.47,-2,-4,0,0,27.82,715,2,1936
6771,3892.06,-1,-3,0,-4,-25.08,724,2,1940
6821,3864.98,0,-3,0,0,15.00,733,2,1942
6871,3815.82,0,-2,0,0,11.68,740,2,1942
6921,3730.42,0,-1,0,0,22.40,744,2,1942
6971,3705.53,0,-1,0,0,15.63,748,2,1943
7021,3517.82,0,1,0,0,337.23,753,2,1993
7071,3526.92,0,0,0,0,448.69,758,2,2104
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
