december454/Microcontroller-Engine-Governor/Data-Logging/4-5-2023/4-5-2023 - PID Tuning - PID P Alt - (P 02 I 025 D 3) - Dynamic D Gain Updated.txt

------ Microcontroller Engine Governoe, P Cmd, I Cmd, D Cmd
------ Microcontroller Engine Governor - Version: 1.16 ------
-------------------------------------------------------------
PID Gains:        Kp: 0.020000   Ki: 0.025000   Kd: 3.000000
-------------------------------------------------------------
Set RPM:             3600    |  Min RPM:                300
                             |
RPM Precision        10       |  PID I Precision:         70
                             |
Start Steps:         850     |  Max Steps:               1200
                             |
RPM Calc Interval:   1       |  Num Magnets:             1
                             |
LCD Update Interval: 400     |  Serial Update Interval:  50
-------------------------------------------------------------

Time,RPM,Steps Remaining, PID p, PID i, PID d, RPM Change, P Cmd, I Cmd, D Cmd
1648,0.00,0,0,0,0,0.00,0,0,0
1698,0.00,0,0,0,0,0.00,0,0,0
1748,0.00,0,0,0,0,0.00,0,0,0
1798,0.00,0,0,0,0,0.00,0,0,0
1848,0.00,0,0,0,0,0.00,0,0,0
1898,0.00,0,0,0,0,0.00,0,0,0
1948,0.00,0,0,0,0,0.00,0,0,0
1998,0.00,0,0,0,0,0.00,0,0,0
2048,0.00,0,0,0,0,0.00,0,0,0
2098,0.00,0,0,0,0,0.00,0,0,0
2148,0.00,0,0,0,0,0.00,0,0,0
2198,0.00,0,0,0,0,0.00,0,0,0
2248,0.00,0,0,0,0,0.00,0,0,0
2298,0.00,0,0,0,0,0.00,0,0,0
2348,0.00,0,0,0,0,0.00,0,0,0
2398,0.00,0,0,0,0,0.00,0,0,0
2448,0.00,0,0,0,0,0.00,0,0,0
2498,0.00,0,0,0,0,0.00,0,0,0
2548,0.00,0,0,0,0,0.00,0,0,0
2598,0.00,0,0,0,0,0.00,0,0,0
2648,0.00,0,0,0,0,0.00,0,0,0
2698,0.00,0,0,0,0,0.00,0,0,0
2748,0.00,0,0,0,0,0.00,0,0,0
2798,0.00,0,0,0,0,0.00,0,0,0
2848,0.00,0,0,0,0,0.00,0,0,0
2898,0.00,0,0,0,0,0.00,0,0,0
2948,0.00,0,0,0,0,0.00,0,0,0
2998,0.00,0,0,0,0,0.00,0,0,0
3048,0.00,0,0,0,0,0.00,0,0,0
3098,0.00,0,0,0,0,0.00,0,0,0
3148,0.00,0,0,0,0,0.00,0,0,0
3198,0.00,0,0,0,0,0.00,0,0,0
3248,0.00,0,0,0,0,0.00,0,0,0
3298,0.00,0,0,0,0,0.00,0,0,0
3348,inf,0,0,0,0,inf,0,0,0
3398,inf,0,0,0,0,inf,0,0,0
3448,inf,0,0,0,0,inf,0,0,0
3499,530.80,20,61,0,0,inf,61,0,0
3549,1059.85,0,50,0,-28,-529.04,111,0,28
3599,1078.28,20,50,0,-1,-18.44,161,0,29
3649,1388.50,0,44,0,-21,-310.22,205,0,50
3699,1664.08,11,38,0,-18,-225.92,286,0,71
3749,1701.07,11,37,0,-3,-36.99,323,0,74
3799,2008.57,12,31,0,-8,-86.97,387,0,102
3849,2221.23,18,27,0,-2,-20.53,441,0,124
3899,2481.80,1,22,0,-13,-108.76,487,0,155
3949,2615.97,9,19,0,2,17.91,525,0,176
3999,2908.10,0,13,0,-29,-205.40,555,0,216
4049,3241.14,-29,7,0,-46,-280.23,588,0,285
4099,3145.31,35,9,0,27,184.32,614,0,402
4149,3393.67,0,4,0,0,71.34,620,0,402
4199,3546.10,0,1,1,0,-4.19,626,2,402
4249,3647.86,0,0,-1,0,24.11,628,4,402
4299,3934.94,-44,-6,0,-39,-198.95,640,5,463
4349,3746.25,0,-2,0,0,383.70,653,5,558
4399,4221.78,-104,-12,0,-101,-474.59,678,5,735
4449,3993.61,0,-7,0,0,195.16,701,5,806
4499,4246.89,-64,-12,0,-58,-252.21,741,5,1015
4549,3994.67,0,-7,0,0,417.09,769,5,1125
4599,3992.55,-3,-7,0,0,454.53,813,5,1314
4649,4396.25,-96,-15,0,-93,-403.70,851,5,1497
4699,4430.01,-105,-16,0,-93,-436.40,898,5,1732
4749,3992.55,0,-7,0,0,238.76,927,5,1750
4799,3992.55,-5,-7,0,0,320.28,970,5,1890
4849,4249.29,-58,-12,0,-55,-256.74,1003,5,2016
4899,3993.61,0,-7,0,0,256.89,1028,5,2089
4950,4067.25,-18,-9,0,-14,-72.57,1063,5,2289
5000,3993.61,0,-7,0,0,105.87,1085,5,2329
5050,3969.30,0,-7,0,0,15.82,1106,5,2329
5100,4058.44,-72,-9,0,-67,-313.12,1131,5,2468
5150,3745.32,0,-2,0,0,279.37,1142,6,2541
5200,3867.97,-17,-5,0,-21,-134.77,1153,6,2575
5250,3734.13,0,-2,0,0,116.96,1160,7,2600
5300,3681.88,0,-1,0,0,34.67,1165,7,2600
5350,3611.85,0,0,0,0,19.24,1166,8,2600
5400,3562.95,0,0,0,0,34.18,1166,8,2600
5450,3498.13,0,2,0,0,4.90,1170,9,2600
5500,3465.00,0,2,0,0,31.50,1176,9,2600
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
