december454/Microcontroller-Engine-Governor/Data-Logging/4-3-2023/4-3-2023 - PID Tuning - Corrected PID P Alt - (P 013 PA 025 D 0) - Disable Major RPM Change.txt

------ Microcontroller Engine Governor - Version: 1.16 ------
-------------------------------------------------------------
PID Gains:   Kp: 0.013000   KpAlt: 0.025000   Kd: 0.000000
-------------------------------------------------------------
Set RPM:             3600    |  Min RPM:                300
                             |
RPM Precision       10       |  PID I Precision:         70
                             |
Start Steps:         850     |  Max Steps:               1200
                             |
RPM Calc Interval:   1       |  Num Magnets:             1
                             |
LCD Update Interval: 400     |  Serial Update Interval:  50
-------------------------------------------------------------

Time,RPM,Steps Remaining, PID p, PID pAlt, PID d, RPM Change, P Cmd, P Alt Cmd, D Cmd
1742,0.00,0,0,0,0,0.00,0,0,0
1792,0.00,0,0,0,0,0.00,0,0,0
1842,0.00,0,0,0,0,0.00,0,0,0
1892,0.00,0,0,0,0,0.00,0,0,0
1942,0.00,0,0,0,0,0.00,0,0,0
1992,0.00,0,0,0,0,0.00,0,0,0
2042,0.00,0,0,0,0,0.00,0,0,0
2092,0.00,0,0,0,0,0.00,0,0,0
2142,0.00,0,0,0,0,0.00,0,0,0
2192,0.00,0,0,0,0,0.00,0,0,0
2242,0.00,0,0,0,0,0.00,0,0,0
2292,0.00,0,0,0,0,0.00,0,0,0
2342,0.00,0,0,0,0,0.00,0,0,0
2392,0.00,0,0,0,0,0.00,0,0,0
2442,0.00,0,0,0,0,0.00,0,0,0
2492,0.00,0,0,0,0,0.00,0,0,0
2542,0.00,0,0,0,0,0.00,0,0,0
2592,0.00,0,0,0,0,0.00,0,0,0
2642,0.00,0,0,0,0,0.00,0,0,0
2692,0.00,0,0,0,0,0.00,0,0,0
2742,0.00,0,0,0,0,0.00,0,0,0
2792,0.00,0,0,0,0,0.00,0,0,0
2842,0.00,0,0,0,0,0.00,0,0,0
2892,0.00,0,0,0,0,0.00,0,0,0
2942,0.00,0,0,0,0,0.00,0,0,0
2992,0.00,0,0,0,0,0.00,0,0,0
3042,0.00,0,0,0,0,0.00,0,0,0
3092,0.00,0,0,0,0,0.00,0,0,0
3142,0.00,0,0,0,0,0.00,0,0,0
3192,0.00,0,0,0,0,0.00,0,0,0
3243,0.00,0,0,0,0,0.00,0,0,0
3293,0.00,0,0,0,0,0.00,0,0,0
3343,0.00,0,0,0,0,0.00,0,0,0
3393,0.00,0,0,0,0,0.00,0,0,0
3443,0.00,0,0,0,0,0.00,0,0,0
3493,0.00,0,0,0,0,0.00,0,0,0
3543,0.00,0,0,0,0,0.00,0,0,0
3593,0.00,0,0,0,0,0.00,0,0,0
3643,0.00,0,0,0,0,0.00,0,0,0
3693,0.00,0,0,0,0,0.00,0,0,0
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
5494,inf,0,0,0,0,inf,0,0,0
5544,inf,0,0,0,0,inf,0,0,0
5594,inf,0,0,0,0,inf,0,0,0
5644,459.09,19,40,0,0,inf,40,0,0
5694,459.09,0,40,0,0,inf,40,0,0
5744,549.37,27,39,0,0,-90.28,79,0,0
5794,549.37,0,39,0,0,-90.28,79,0,0
5844,723.21,8,37,0,0,-173.83,116,0,0
5894,723.21,0,37,0,0,-173.83,116,0,0
5944,702.74,0,37,0,0,20.46,153,0,0
5994,1039.86,0,33,0,0,-337.12,186,0,0
6044,1042.03,5,33,0,0,-2.17,219,0,0
6094,1431.43,0,28,0,0,-389.41,247,0,0
6144,1702.03,15,24,0,0,-254.99,298,0,0
6194,1719.20,3,24,0,0,-17.17,322,0,0
6244,2005.88,6,20,0,0,-16.23,362,0,0
6294,2255.98,6,17,0,0,-16.84,396,0,0
6344,2470.76,2,14,0,0,4.89,424,0,0
6394,2678.57,0,11,0,0,13.46,446,0,0
6444,3032.75,2,7,0,0,-167.42,471,0,0
6494,3191.49,0,5,0,0,-161.80,483,0,0
6544,3336.30,0,3,0,0,17.16,494,0,0
6594,3594.54,0,1,0,0,15.30,496,0,0
6644,3675.57,0,0,-1,0,9.03,497,2,0
6694,3886.01,0,-3,0,0,-115.27,504,2,0
6744,4071.66,-4,-6,0,0,-112.83,521,2,0
6794,4126.55,0,-6,0,0,18.24,539,2,0
6844,4242.08,-7,-8,0,0,8.41,569,2,0
6894,4345.31,0,-9,0,0,-55.92,595,2,0
6944,4411.76,-5,-10,0,0,-56.36,633,2,0
6994,4398.83,0,-10,0,0,16.83,663,2,0
7044,4641.09,-4,-13,0,0,-341.86,707,2,0
7094,4724.41,-9,-14,0,0,-423.95,752,2,0
7144,4798.46,-13,-15,0,0,-499.24,799,2,0
7194,4297.99,0,-9,0,0,459.38,831,2,0
7244,4400.12,-2,-10,0,0,0.00,874,2,0
7294,4319.03,-7,-9,0,0,13.72,910,2,0
7344,4306.63,0,-9,0,0,41.19,937,2,0
7394,4274.72,-5,-8,0,0,26.97,971,2,0
7444,4256.53,0,-8,0,0,-15.65,995,2,0
7494,4285.71,-3,-8,0,0,-44.83,1027,2,0
7544,4260.15,0,-8,0,0,41.54,1052,2,0
7595,4243.28,-1,-8,0,0,38.76,1085,2,0
7645,4257.73,-7,-8,0,0,26.76,1118,2,0
7695,4299.23,0,-9,0,0,-24.50,1144,2,0
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
