december454/Microcontroller-Engine-Governor/Data-Logging/4-3-2023/4-3-2023 - PID Tuning - Corrected PID P Alt - (P 013 PA 025 D 1) - Disable Major RPM Change.txt

------ Microcontroller Engine Governor - Version: 1.16 ------
-------------------------------------------------------------
PID Gains:   Kp: 0.013000   KpAlt: 0.025000   Kd: 1.000000
-------------------------------------------------------------
Set RPM:             3600    |  Min RPM:                300
                             |
RPM Precision       10       |  PID I Precision:         70
                             |
Start Steps:         850     |  Max Steps:               1200
                             |
RPM Calc Interval:   1       |  Num Magnets:             1
                             |
LCD Update Interval: 400     |  Serial Update Interval:  50
-------------------------------------------------------------

Time,RPM,Steps Remaining, PID p, PID pAlt, PID d, RPM Change, P Cmd, P Alt Cmd, D Cmd
1659,0.00,0,0,0,0,0.00,0,0,0
1709,0.00,0,0,0,0,0.00,0,0,0
1759,0.00,0,0,0,0,0.00,0,0,0
1809,0.00,0,0,0,0,0.00,0,0,0
1859,0.00,0,0,0,0,0.00,0,0,0
1909,0.00,0,0,0,0,0.00,0,0,0
1959,0.00,0,0,0,0,0.00,0,0,0
2009,0.00,0,0,0,0,0.00,0,0,0
2059,0.00,0,0,0,0,0.00,0,0,0
2109,0.00,0,0,0,0,0.00,0,0,0
2159,0.00,0,0,0,0,0.00,0,0,0
2209,0.00,0,0,0,0,0.00,0,0,0
2259,0.00,0,0,0,0,0.00,0,0,0
2309,0.00,0,0,0,0,0.00,0,0,0
2359,0.00,0,0,0,0,0.00,0,0,0
2409,0.00,0,0,0,0,0.00,0,0,0
2459,0.00,0,0,0,0,0.00,0,0,0
2509,0.00,0,0,0,0,0.00,0,0,0
2560,0.00,0,0,0,0,0.00,0,0,0
2610,0.00,0,0,0,0,0.00,0,0,0
2660,0.00,0,0,0,0,0.00,0,0,0
2710,0.00,0,0,0,0,0.00,0,0,0
2760,0.00,0,0,0,0,0.00,0,0,0
2810,0.00,0,0,0,0,0.00,0,0,0
2860,0.00,0,0,0,0,0.00,0,0,0
2910,0.00,0,0,0,0,0.00,0,0,0
2960,0.00,0,0,0,0,0.00,0,0,0
3010,0.00,0,0,0,0,0.00,0,0,0
3060,0.00,0,0,0,0,0.00,0,0,0
3110,0.00,0,0,0,0,0.00,0,0,0
3160,0.00,0,0,0,0,0.00,0,0,0
3210,0.00,0,0,0,0,0.00,0,0,0
3260,0.00,0,0,0,0,0.00,0,0,0
3310,0.00,0,0,0,0,0.00,0,0,0
3360,0.00,0,0,0,0,0.00,0,0,0
3410,0.00,0,0,0,0,0.00,0,0,0
3460,0.00,0,0,0,0,0.00,0,0,0
3510,0.00,0,0,0,0,0.00,0,0,0
3560,0.00,0,0,0,0,0.00,0,0,0
3610,0.00,0,0,0,0,0.00,0,0,0
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
6712,inf,0,0,0,0,inf,0,0,0
6762,inf,0,0,0,0,inf,0,0,0
6812,474.25,35,40,0,0,inf,40,0,0
6862,474.25,0,40,0,0,inf,40,0,0
6912,621.12,30,38,0,-1,-146.87,78,0,1
6962,621.12,0,38,0,-1,-146.87,78,0,1
7012,1004.96,0,33,0,-6,-383.84,111,0,7
7062,1056.56,0,33,0,0,-51.60,144,0,7
7112,1472.03,17,27,0,-2,-91.07,199,0,16
7162,1719.59,0,24,0,-7,-247.56,223,0,23
7212,1973.68,7,21,0,-7,-239.58,268,0,30
7262,1988.34,0,20,0,0,-14.65,288,0,30
7312,2331.36,0,16,0,-9,-234.64,323,0,42
7362,2407.70,0,15,0,0,2.71,353,0,45
7412,2773.67,5,10,0,0,-2.56,387,0,60
7462,2921.70,0,8,0,-7,-159.78,405,0,67
7512,3056.86,5,7,0,0,-4.35,427,0,73
7562,3192.17,0,5,0,0,2.72,437,0,80
7612,3418.41,0,2,0,-4,-104.96,445,0,90
7662,3506.31,0,1,0,0,5.75,449,1,90
7712,3684.60,0,-1,-1,0,-92.64,450,2,90
7762,3747.19,0,-1,0,0,15.98,453,3,90
7812,3890.04,0,-3,0,-4,-69.36,460,3,98
7862,3995.74,-6,-5,0,-3,-58.73,476,3,105
7912,3990.42,0,-5,0,0,42.92,490,3,109
7962,4039.86,0,-5,0,-1,-28.09,505,3,113
8012,4037.68,-4,-5,0,-2,-40.88,525,3,117
8062,3983.01,0,-4,0,0,39.52,538,3,119
8112,3984.06,0,-4,0,-1,-21.05,551,3,120
8162,4087.19,-26,-6,0,-21,-321.19,567,3,165
8212,3766.95,-18,-2,0,-20,257.73,575,3,226
8262,4022.53,-14,-5,0,-17,-256.52,586,3,267
8312,3716.55,0,-1,0,-8,135.53,591,3,283
8363,3686.41,0,-1,-1,0,-3.62,594,5,291
8413,3557.87,0,0,1,0,39.25,594,6,291
8463,3564.64,0,0,0,0,-30.24,594,7,291
8513,3505.49,0,1,0,0,38.93,596,9,291
8563,3510.41,0,1,1,0,-33.36,599,11,291
8613,3433.28,0,2,0,0,47.00,603,11,291
8663,3433.28,0,2,0,0,-19.53,608,11,291
8713,3435.64,0,2,0,-1,-37.36,612,11,292
8763,3579.10,0,0,0,0,-82.59,618,11,305
8813,3445.11,0,2,0,-1,-47.60,624,11,306
8863,3420.75,0,2,0,0,33.08,629,11,307
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
