december454/Microcontroller-Engine-Governor/Data-Logging/4-3-2023/4-3-2023 - PID Tuning - PID P Alt - (P 013 PA 025 D 1) - Disable Major RPM Change.txt

------ Microcontroller Engine Governor - Version: 1.16 ------
-------------------------------------------------------------
PID Gains:   Kp: 0.013000   KpAlt: 0.025000   Kd: 1.000000
-------------------------------------------------------------
Set RPM:             3600    |  Min RPM:                300
                             |
RPM Precision       10       |  PID I Precision:         70
                             |
Start Steps:         850     |  Max Steps:               1200
                             |
RPM Calc Interval:   1       |  Num Magnets:             1
                             |
LCD Update Interval: 400     |  Serial Update Interval:  50
-------------------------------------------------------------

Time,RPM,Steps Remaining, PID p, PID pAlt, PID d, RPM Change, P Cmd, P Alt Cmd, D Cmd
1753,0.00,0,0,0,0,0.00,0,0,0
1803,0.00,0,0,0,0,0.00,0,0,0
1853,0.00,0,0,0,0,0.00,0,0,0
1903,0.00,0,0,0,0,0.00,0,0,0
1953,0.00,0,0,0,0,0.00,0,0,0
2003,0.00,0,0,0,0,0.00,0,0,0
2053,0.00,0,0,0,0,0.00,0,0,0
2103,0.00,0,0,0,0,0.00,0,0,0
2153,0.00,0,0,0,0,0.00,0,0,0
2203,0.00,0,0,0,0,0.00,0,0,0
2253,0.00,0,0,0,0,0.00,0,0,0
2304,0.00,0,0,0,0,0.00,0,0,0
2354,0.00,0,0,0,0,0.00,0,0,0
2404,0.00,0,0,0,0,0.00,0,0,0
2454,0.00,0,0,0,0,0.00,0,0,0
2504,0.00,0,0,0,0,0.00,0,0,0
2554,0.00,0,0,0,0,0.00,0,0,0
2604,0.00,0,0,0,0,0.00,0,0,0
2654,0.00,0,0,0,0,0.00,0,0,0
2704,0.00,0,0,0,0,0.00,0,0,0
2754,0.00,0,0,0,0,0.00,0,0,0
2804,0.00,0,0,0,0,0.00,0,0,0
2854,0.00,0,0,0,0,0.00,0,0,0
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
12900,3660.32,0,0,-1,0,-49.34,571,21,230
12950,3610.98,0,0,0,0,49.34,571,22,230
13000,3639.89,0,0,0,0,-18.45,571,23,230
13050,3600.58,0,0,-1,0,-37.68,571,24,230
13100,3597.98,0,0,0,-1,33.76,571,24,231
13150,3542.75,0,0,1,-1,42.34,571,25,232
13200,3584.23,0,0,0,0,-27.20,571,26,232
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
