december454/Microcontroller-Engine-Governor/Data-Logging/4-3-2023/4-3-2023 - PID Tuning - PID P Alt - (P 013 PA 025 D 1).txt

------ Microcontroller Engine Governor - Version: 1.16 ------
-------------------------------------------------------------
PID Gains:        Kp: 0.013000   KpAlt: 0.025000   Kd: 1.000000
-------------------------------------------------------------
Set RPM:             3600    |  Min RPM:                300
                             |
RPM Precision        10       |  PID I Precision:         70
                             |
Start Steps:         850     |  Max Steps:               1200
                             |
RPM Calc Interval:   1       |  Num Magnets:             1
                             |
LCD Update Interval: 400     |  Serial Update Interval:  50
-------------------------------------------------------------

Time,RPM,Steps Remaining, PID p, PID pAlt, PID d, RPM Change, P Cmd, P Alt Cmd, D Cmd
1641,0.00,0,0,0,0,0.00,0,0,0
1691,0.00,0,0,0,0,0.00,0,0,0
1741,0.00,0,0,0,0,0.00,0,0,0
1792,0.00,0,0,0,0,0.00,0,0,0
1842,0.00,0,0,0,0,0.00,0,0,0
1892,0.00,0,0,0,0,0.00,0,0,0
1942,0.00,0,0,0,0,0.00,0,0,0
1992,0.00,0,0,0,0,0.00,0,0,0
2042,0.00,0,0,0,0,0.00,0,0,0
2092,0.00,0,0,0,0,0.00,0,0,0
2142,0.00,0,0,0,0,0.00,0,0,0
2192,0.00,0,0,0,0,0.00,0,0,0
2242,0.00,0,0,0,0,0.00,0,0,0
2292,0.00,0,0,0,0,0.00,0,0,0
2342,0.00,0,0,0,0,0.00,0,0,0
2392,0.00,0,0,0,0,0.00,0,0,0
2442,0.00,0,0,0,0,0.00,0,0,0
2492,0.00,0,0,0,0,0.00,0,0,0
2542,0.00,0,0,0,0,0.00,0,0,0
2592,0.00,0,0,0,0,0.00,0,0,0
2642,0.00,0,0,0,0,0.00,0,0,0
2692,0.00,0,0,0,0,0.00,0,0,0
2742,0.00,0,0,0,0,0.00,0,0,0
2792,0.00,0,0,0,0,0.00,0,0,0
2842,0.00,0,0,0,0,0.00,0,0,0
2892,0.00,0,0,0,0,0.00,0,0,0
2942,0.00,0,0,0,0,0.00,0,0,0
2992,0.00,0,0,0,0,0.00,0,0,0
3042,0.00,0,0,0,0,0.00,0,0,0
3092,0.00,0,0,0,0,0.00,0,0,0
3142,0.00,0,0,0,0,0.00,0,0,0
3192,0.00,0,0,0,0,0.00,0,0,0
3243,0.00,0,0,0,0,0.00,0,0,0
3293,0.00,0,0,0,0,0.00,0,0,0
3343,0.00,0,0,0,0,0.00,0,0,0
3393,0.00,0,0,0,0,0.00,0,0,0
3443,0.00,0,0,0,0,0.00,0,0,0
3493,0.00,0,0,0,0,0.00,0,0,0
3543,0.00,0,0,0,0,0.00,0,0,0
3593,0.00,0,0,0,0,0.00,0,0,0
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
15348,inf,0,0,0,0,inf,0,0,0
15398,inf,0,0,0,0,inf,0,0,0
15448,inf,0,0,0,0,inf,0,0,0
15498,inf,0,0,0,0,inf,0,0,0
15548,325.56,0,42,0,0,inf,42,0,0
15598,650.96,28,38,0,-3,-325.40,80,0,3
15648,650.96,0,38,0,-3,-325.40,80,0,3
15698,713.06,13,37,0,0,-62.11,117,0,3
15748,1118.74,6,32,0,-7,-405.67,149,0,10
15798,1125.45,16,32,0,0,-6.72,181,0,10
15848,1482.07,0,27,0,-8,-356.62,208,0,18
15898,1743.98,17,24,0,-6,-239.32,259,0,24
15948,1764.71,6,23,0,0,-20.72,282,0,24
15998,2027.85,12,20,0,0,-17.39,322,0,32
16048,2260.40,13,17,0,0,-18.92,356,0,39
16098,2455.39,9,14,0,0,3.62,384,0,47
16148,2638.06,3,12,0,1,23.40,408,0,57
16198,2807.94,0,10,0,0,14.80,428,0,65
16248,3103.66,0,6,0,-7,-137.48,450,0,79
16299,3225.11,3,4,0,0,10.44,464,0,86
16349,3316.38,0,3,0,0,5.14,470,0,91
16399,3526.92,0,0,-1,0,-97.57,474,1,95
16449,3600.58,0,0,0,0,-114.36,475,3,95
16499,3745.32,0,-1,0,0,-79.63,477,6,95
16549,3885.00,-6,-3,0,-4,-68.21,485,6,103
16599,3766.01,-4,-2,0,-5,242.55,494,6,127
16649,4251.70,-33,-8,0,-34,-485.70,511,6,197
16699,4016.06,0,-5,0,0,92.40,526,6,209
16749,4035.51,-2,-5,0,-1,-19.45,546,6,231
16799,4004.27,0,-5,0,-1,-20.21,560,6,232
16849,3954.65,0,-4,0,0,51.76,573,6,234
16899,4193.46,-33,-7,0,-28,-426.51,591,6,278
16949,3967.20,0,-4,0,0,13.69,603,6,281
16999,3960.92,0,-4,0,-3,-55.69,614,6,284
17049,3901.17,0,-3,0,0,-8.10,624,6,284
17099,3758.46,-26,-2,0,-26,6.60,635,6,383
17149,3921.57,-8,-4,0,-10,-154.62,645,6,411
17199,3757.52,-6,-2,0,-11,118.45,651,6,434
17249,3654.97,0,0,-1,0,35.97,653,9,445
17299,3654.08,0,0,-1,0,-19.48,654,12,445
17349,3591.09,0,0,0,0,0.00,654,12,445
17399,3562.95,0,0,0,0,-2.54,654,12,446
17449,3507.95,0,1,-2,0,43.19,656,17,446
17499,3524.44,0,0,-1,0,-44.16,657,19,446
17549,3455.42,0,1,0,0,47.61,660,22,446
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
