december454/Microcontroller-Engine-Governor/Data-Logging/3-10-2023/3-10-2023 - Simulator - Microseconds Test (Control - Milliseconds).txt

------- Microcontroller Governor Sim -- Version: 1.03 -------
-------------------------------------------------------------
PID Gains:        Kp: 1.10       Ki: 0.00       Kd: 0.00
-------------------------------------------------------------
Set RPM:             500.00  |  Min RPM:                300
                             |
RPM Precision        2       |  PID I Precision:         22
                             |
Start Steps:         900     |  Max Steps:               1200
                             |
RPM Calc Interval:   8       |  Num Magnets:             8
                             |
LCD Update Interval: 400     |  Serial Update Interval:  100
-------------------------------------------------------------

Time,RPM,Steps Remaining, PID p, PID i, PID d
100,0.00,0,0,0,0
200,inf,0,0,0,0
300,500.00,0,0,0,0
400,500.00,0,0,0,0
500,504.20,0,-4,0,0
600,504.20,0,-4,0,0
700,504.20,0,-4,0,0
800,500.00,0,-4,0,0
900,495.87,0,4,0,0
1000,500.00,0,4,0,0
1100,500.00,0,4,0,0
1200,500.00,0,4,0,0
1300,500.00,0,4,0,0
1400,504.20,0,-4,0,0
1500,495.87,0,4,0,0
1600,500.00,0,4,0,0
1700,500.00,0,4,0,0
1800,495.87,2,4,0,0
1900,495.87,0,4,0,0
2000,504.20,0,-4,0,0
2100,500.00,0,-4,0,0
2200,495.87,0,4,0,0
2300,500.00,0,4,0,0
2400,495.87,3,4,0,0
2501,495.87,0,4,0,0
2601,500.00,0,4,0,0
2701,504.20,0,-4,0,0
2801,495.87,0,4,0,0
2902,500.00,0,4,0,0
3002,500.00,0,4,0,0
3102,500.00,0,4,0,0
3202,500.00,0,4,0,0
3302,500.00,0,4,0,0
3402,500.00,0,4,0,0
3502,500.00,0,4,0,0
3602,500.00,0,4,0,0
3702,500.00,0,4,0,0
3802,500.00,0,4,0,0
3902,504.20,0,-4,0,0
4002,500.00,0,-4,0,0
4102,500.00,0,-4,0,0
4202,500.00,0,-4,0,0
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
