december454/Microcontroller-Engine-Governor/Data-Logging/3-24-2023/3-24-2023 - PID Tuning - (I 003) 2.txt

------ Microcontroller Engine Governor - Version: 1.13 ------
-------------------------------------------------------------
PID Gains:        Kp: 0.010000   Ki: 0.005000   Kd: 3.000000
-------------------------------------------------------------
Set RPM:             3600    |  Min RPM:                300
                             |
RPM Precision        2       |  PID I Precision:         202
                             |
Start Steps:         900     |  Max Steps:               1200
                             |
RPM Calc Interval:   1       |  Num Magnets:             1
                             |
LCD Update Interval: 400     |  Serial Update Interval:  50
-------------------------------------------------------------

Time,RPM,Steps Remaining, PID p, PID i, PID d
1810,0.00,0,0,0,0
1860,0.00,0,0,0,0
1910,0.00,0,0,0,0
1960,0.00,0,0,0,0
2010,0.00,0,0,0,0
2060,0.00,0,0,0,0
2110,0.00,0,0,0,0
2160,0.00,0,0,0,0
2210,0.00,0,0,0,0
2260,0.00,0,0,0,0
2310,0.00,0,0,0,0
2360,0.00,0,0,0,0
2410,0.00,0,0,0,0
2460,0.00,0,0,0,0
2510,0.00,0,0,0,0
2560,0.00,0,0,0,0
2610,0.00,0,0,0,0
2660,0.00,0,0,0,0
2710,0.00,0,0,0,0
2760,0.00,0,0,0,0
2810,0.00,0,0,0,0
2860,0.00,0,0,0,0
2910,0.00,0,0,0,0
2960,0.00,0,0,0,0
3010,0.00,0,0,0,0
3060,0.00,0,0,0,0
3110,0.00,0,0,0,0
3160,0.00,0,0,0,0
3210,0.00,0,0,0,0
3260,0.00,0,0,0,0
3310,0.00,0,0,0,0
3360,0.00,0,0,0,0
3410,0.00,0,0,0,0
3460,0.00,0,0,0,0
3510,0.00,0,0,0,0
3560,0.00,0,0,0,0
3610,0.00,0,0,0,0
3660,0.00,0,0,0,0
3710,0.00,0,0,0,0
3760,0.00,0,0,0,0
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
13515,inf,0,0,0,0
13565,inf,0,0,0,0
13615,548.53,18,30,0,0
13665,548.53,0,30,0,0
13715,623.47,11,29,0,-2
13765,623.47,0,29,0,-2
13815,590.04,16,30,0,0
13865,955.96,8,26,0,-17
13915,955.96,0,26,0,-17
13965,942.45,0,26,0,0
14015,1297.02,0,23,0,-23
14065,1548.79,0,20,0,-19
14115,1546.55,3,20,0,0
14166,1736.92,0,18,0,-16
14216,1907.18,0,16,0,-16
14266,2078.71,0,15,0,-17
14316,2212.06,0,13,0,-14
14366,2218.61,0,13,0,0
14416,2341.19,0,12,0,0
14466,2448.18,0,11,0,0
14516,2638.52,-3,9,0,-14
14566,2724.80,0,8,0,-13
14616,2826.46,0,7,0,-15
14666,2906.98,5,6,0,1
14716,3062.47,-1,5,0,-18
14766,3163.22,-6,4,0,-13
14816,3225.81,0,3,0,-13
14866,3247.46,0,3,0,2
14916,3357.21,0,2,0,-6
14966,3351.96,1,2,0,1
15016,3382.19,0,2,0,1
15066,3468.21,0,1,0,0
15116,3488.37,0,1,0,0
15166,3545.26,0,0,0,0
15216,3564.64,0,0,0,0
15266,3640.78,0,0,0,0
15316,3645.20,0,0,0,0
15366,3646.09,0,0,0,0
15416,3645.20,0,0,0,0
15466,3695.49,0,0,0,0
15516,3676.47,0,0,0,0
15566,3704.62,0,-1,0,0
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
