december454/Microcontroller-Engine-Governor/Data-Logging/3-27-2023/3-27-2023 - PID Tuning - (P 02 I 005 D 6) .txt

------ Microcontroller Engine Governor - Version: 1.13 ------
-------------------------------------------------------------
PID Gains:        Kp: 0.020000   Ki: 0.005000   Kd: 6.000000
-------------------------------------------------------------
Set RPM:             3600    |  Min RPM:                300
                             |
RPM Precision        2       |  PID I Precision:         202
                             |
Start Steps:         800     |  Max Steps:               1200
                             |
RPM Calc Interval:   1       |  Num Magnets:             1
                             |
LCD Update Interval: 400     |  Serial Update Interval:  50
-------------------------------------------------------------

Time,RPM,Steps Remaining, PID p, PID i, PID d
1543,0.00,0,0,0,0
1593,0.00,0,0,0,0
1643,0.00,0,0,0,0
1693,0.00,0,0,0,0
1743,0.00,0,0,0,0
1793,0.00,0,0,0,0
1843,0.00,0,0,0,0
1893,0.00,0,0,0,0
1943,0.00,0,0,0,0
1993,0.00,0,0,0,0
2043,0.00,0,0,0,0
2093,0.00,0,0,0,0
2143,0.00,0,0,0,0
2193,0.00,0,0,0,0
2243,0.00,0,0,0,0
2293,0.00,0,0,0,0
2343,0.00,0,0,0,0
2393,0.00,0,0,0,0
2443,0.00,0,0,0,0
2493,0.00,0,0,0,0
2543,0.00,0,0,0,0
2593,0.00,0,0,0,0
2643,0.00,0,0,0,0
2693,0.00,0,0,0,0
2743,0.00,0,0,0,0
2793,0.00,0,0,0,0
2843,0.00,0,0,0,0
2893,0.00,0,0,0,0
2944,0.00,0,0,0,0
2994,0.00,0,0,0,0
3044,0.00,0,0,0,0
3094,0.00,0,0,0,0
3144,0.00,0,0,0,0
3194,inf,0,0,0,0
3244,inf,0,0,0,0
3294,471.03,55,62,0,0
3344,471.03,6,62,0,0
3394,1002.00,0,51,0,-53
3444,959.26,21,52,0,4
3494,949.37,31,53,0,0
3544,928.05,48,53,0,1
3594,1253.97,0,46,0,-39
3644,1300.50,27,45,0,-6
3694,1619.70,0,39,0,-53
3744,1970.57,-11,32,0,-53
3794,2153.01,-7,28,0,-36
3844,2283.80,0,26,0,-30
3894,2630.66,-16,19,0,-37
3944,2736.23,-9,17,0,-33
3994,2896.31,-5,14,0,-34
4044,2884.62,46,14,0,35
4094,3187.42,0,8,0,-23
4144,3165.22,12,8,0,12
4194,3536.07,0,1,0,0
4244,3519.47,0,1,0,0
4294,3546.94,0,1,0,0
4344,3659.43,0,-1,0,0
4395,3704.62,0,-2,0,0
4445,3801.32,0,-4,-1,0
4495,3830.44,0,-4,0,0
4545,3917.47,-13,-6,0,-20
4595,4084.97,-138,-9,0,-131
4645,3778.34,0,-3,0,0
4695,3977.72,-77,-7,0,-79
4745,3779.29,0,-3,0,0
4795,3881.99,0,-5,0,0
4845,3791.71,-1,-3,0,0
4895,3769.79,0,-3,0,0
4945,3781.19,0,-3,0,0
4995,3740.65,0,-2,0,0
5045,3699.14,0,-1,0,0
5095,3684.60,0,-1,0,0
5145,3678.27,0,-1,0,0
5195,3641.66,0,0,0,0
5245,3573.98,0,0,0,0
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
