december454/Microcontroller-Engine-Governor/Data-Logging/3-27-2023/3-27-2023 - PID Tuning - (P 02 I 005 D 8) - Load.txt

------ Microcontroller Engine Governor - 50
-------------------------------------------------------------

Time,RPM,Steps Remaining, PID p, PID i, PID d
e Interval:  50
-------------------------------------------------------------

Time,RPM,Steps Remaining, PID p, PID i, PID d
------ Microcontroller Engine Governor - Version: 1.13 ------
-------------------------------------------------------------
PID Gains:        Kp: 0.020000   Ki: 0.000000   Kd: 8.000000
-------------------------------------------------------------
Set RPM:             3600    |  Min RPM:                300
                             |
RPM Precision        2       |  PID I Precision:         202
                             |
Start Steps:         900     |  Max Steps:               1200
                             |
RPM Calc Interval:   1       |  Num Magnets:             1
                             |
LCD Update Interval: 400     |  Serial Update Interval:  50
-------------------------------------------------------------

Time,RPM,Steps Remaining, PID p, PID i, PID d
1720,0.00,0,0,0,0
1770,0.00,0,0,0,0
1820,0.00,0,0,0,0
1870,0.00,0,0,0,0
1920,0.00,0,0,0,0
1970,0.00,0,0,0,0
2020,0.00,0,0,0,0
2070,0.00,0,0,0,0
2120,0.00,0,0,0,0
2170,0.00,0,0,0,0
2220,inf,0,0,0,0
2270,inf,0,0,0,0
2320,inf,0,0,0,0
2370,475.24,37,62,0,0
2420,475.24,0,62,0,0
2470,546.09,40,61,0,-5
2520,546.09,0,61,0,-5
2570,822.28,0,55,0,-30
2620,815.00,36,55,0,0
2670,1157.41,0,48,0,-51
2720,1180.36,29,48,0,-3
2770,1499.10,0,42,0,-62
2820,1766.58,-14,36,0,-52
2870,1779.36,14,36,0,-3
2920,2008.03,18,31,0,-4
2970,2191.70,24,28,0,0
3020,2332.81,39,25,0,17
3070,2521.86,2,21,0,-14
3120,2560.16,20,20,0,8
3170,2616.89,0,19,0,-8
3220,2712.97,0,17,0,1
3270,3009.63,-85,11,0,-101
3320,3008.42,-45,11,0,-70
3371,3108.81,0,9,0,-7
3421,3186.07,23,8,0,34
3471,3485.94,0,2,0,0
3521,3441.16,0,3,0,0
3571,3577.39,0,0,0,0
3621,3574.83,0,0,0,0
3671,3705.53,0,-2,0,0
3721,3720.24,0,-2,0,0
3771,3753.75,0,-3,0,0
3821,3760.34,0,-3,0,0
3871,3790.75,-1,-3,0,0
3921,3824.58,0,-4,0,0
3971,3830.44,0,-4,0,0
4021,3824.58,0,-4,0,0
4071,3823.60,0,-4,0,0
4121,3791.71,0,-3,0,0
4171,3772.64,-1,-3,0,0
4221,3750.00,0,-3,0,0
4271,3766.01,0,-3,0,0
4321,3720.24,0,-2,0,0
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
