december454/Microcontroller-Engine-Governor/Data-Logging/3-27-2023/3-27-2023 - PID Tuning - D Major RPM Change - (P 02 I 0 D 8) - Load 2.txt

------ Microcontroller Engine Governor 
------ Microcontroller Engine Governor - Version: 1.13 ------
-------------------------------------------------------------
PID Gains:        Kp: 0.020000   Ki: 0.000000   Kd: 8.000000
-------------------------------------------------------------
Set RPM:             3600    |  Min RPM:                300
                             |
RPM Precision        2       |  PID I Precision:         202
                             |
Start Steps:         850     |  Max Steps:               1200
                             |
RPM Calc Interval:   1       |  Num Magnets:             1
                             |
LCD Update Interval: 400     |  Serial Update Interval:  50
-------------------------------------------------------------

Time,RPM,Steps Remaining, PID p, PID i, PID d, RPM Change
1643,0.00,0,0,0,0,0.00
1693,0.00,0,0,0,0,0.00
1743,0.00,0,0,0,0,0.00
1793,0.00,0,0,0,0,0.00
1843,0.00,0,0,0,0,0.00
1893,0.00,0,0,0,0,0.00
1943,0.00,0,0,0,0,0.00
1993,0.00,0,0,0,0,0.00
2043,0.00,0,0,0,0,0.00
2093,0.00,0,0,0,0,0.00
2143,0.00,0,0,0,0,0.00
2193,0.00,0,0,0,0,0.00
2243,0.00,0,0,0,0,0.00
2293,0.00,0,0,0,0,0.00
2343,0.00,0,0,0,0,0.00
2393,0.00,0,0,0,0,0.00
2443,0.00,0,0,0,0,0.00
2493,0.00,0,0,0,0,0.00
2543,0.00,0,0,0,0,0.00
2593,0.00,0,0,0,0,0.00
2643,0.00,0,0,0,0,0.00
2693,0.00,0,0,0,0,0.00
2743,0.00,0,0,0,0,0.00
2793,0.00,0,0,0,0,0.00
2843,0.00,0,0,0,0,0.00
2893,0.00,0,0,0,0,0.00
2944,0.00,0,0,0,0,0.00
2994,0.00,0,0,0,0,0.00
3044,0.00,0,0,0,0,0.00
3094,0.00,0,0,0,0,0.00
3144,0.00,0,0,0,0,0.00
3194,0.00,0,0,0,0,0.00
3244,0.00,0,0,0,0,0.00
3294,0.00,0,0,0,0,0.00
3344,0.00,0,0,0,0,0.00
3394,0.00,0,0,0,0,0.00
3444,0.00,0,0,0,0,0.00
3494,0.00,0,0,0,0,0.00
3544,0.00,0,0,0,0,0.00
3594,0.00,0,0,0,0,0.00
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
4194,inf,0,0,0,0,inf
4244,inf,0,0,0,0,inf
4294,555.37,31,60,0,0,inf
4344,555.37,0,60,0,0,inf
4395,700.48,0,57,0,-13,-145.11
4445,1094.97,0,50,0,-58,-394.49
4495,1101.24,17,49,0,0,-6.27
4545,1521.92,24,41,0,-14,-73.62
4595,1706.48,0,37,0,-42,-184.57
4645,1945.78,-24,33,0,-60,-225.20
4695,1958.22,8,32,0,-3,-12.45
4745,2194.27,0,28,0,-27,-91.95
4795,2306.63,12,25,0,0,-1.42
4845,2444.99,9,23,0,0,-1.99
4895,2596.05,0,20,0,-14,-44.17
4945,2867.52,-76,14,0,-92,-231.78
4995,2866.42,-13,14,0,-36,-95.32
5045,3147.95,-72,9,0,-100,-238.16
5095,3027.25,47,11,0,45,120.71
5145,3028.47,72,11,0,62,148.83
5195,3186.07,0,8,0,5,12.23
5245,3340.76,-54,5,0,-68,-154.01
5295,3368.52,-3,4,0,-10,-26.27
5345,3434.07,2,3,0,0,12.63
5395,3448.28,0,3,0,0,15.13
5445,3540.24,0,1,0,0,103.19
5495,3518.65,0,1,0,0,28.29
5545,3554.50,0,0,0,0,-44.91
5595,3557.87,0,0,0,0,34.08
5645,3628.45,0,0,0,0,-29.60
5695,3609.24,0,0,0,0,7.83
5745,3646.97,0,0,0,0,-23.78
5795,3618.82,0,0,0,0,28.16
5846,3638.13,0,0,0,0,-6.17
5896,3641.66,0,0,0,0,24.92
5946,3710.12,0,-2,0,-1,-53.36
5996,3639.89,0,0,0,0,102.62
6046,3785.01,-15,-3,0,-13,-227.98
6096,3679.18,0,-1,0,0,59.61
6146,3617.94,0,0,0,0,14.02
6196,3609.24,0,0,0,0,9.58
6246,3564.64,0,0,0,0,30.76
6296,3585.09,0,0,0,0,-19.60
6347,3548.62,0,1,0,0,32.19
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
