december454/Microcontroller-Engine-Governor/Data-Logging/3-27-2023/3-27-2023 - PID Tuning - D Major RPM Change - (P 02 I 0 D 8) - Load.txt

------ Microcontroller Engine Governor - Version: 1.13 ------
-------------------------------------------------------------
PID Gains:        Kp: 0.020000   Ki: 0.000000   Kd: 8.000000
-------------------------------------------------------------
Set RPM:             3600    |  Min RPM:                300
                             |
RPM Precision        2       |  PID I Precision:         202
                             |
Start Steps:         900     |  Max Steps:               1200
                             |
RPM Calc Interval:   1       |  Num Magnets:             1
                             |
LCD Update Interval: 400     |  Serial Update Interval:  50
-------------------------------------------------------------

Time,RPM,Steps Remaining, PID p, PID i, PID d
1735,0.00,0,0,0,0
1785,0.00,0,0,0,0
1835,0.00,0,0,0,0
1885,0.00,0,0,0,0
1935,0.00,0,0,0,0
1985,0.00,0,0,0,0
2035,0.00,0,0,0,0
2085,0.00,0,0,0,0
2135,0.00,0,0,0,0
2185,0.00,0,0,0,0
2235,0.00,0,0,0,0
2285,0.00,0,0,0,0
2335,0.00,0,0,0,0
2385,0.00,0,0,0,0
2435,0.00,0,0,0,0
2485,0.00,0,0,0,0
2535,0.00,0,0,0,0
2585,0.00,0,0,0,0
2635,0.00,0,0,0,0
2685,0.00,0,0,0,0
2735,0.00,0,0,0,0
2785,0.00,0,0,0,0
2835,0.00,0,0,0,0
2885,0.00,0,0,0,0
2935,0.00,0,0,0,0
2985,0.00,0,0,0,0
3035,0.00,0,0,0,0
3085,0.00,0,0,0,0
3135,0.00,0,0,0,0
3185,0.00,0,0,0,0
3235,0.00,0,0,0,0
3286,0.00,0,0,0,0
3336,0.00,0,0,0,0
3386,0.00,0,0,0,0
3436,0.00,0,0,0,0
3486,0.00,0,0,0,0
3536,0.00,0,0,0,0
3586,0.00,0,0,0,0
3636,0.00,0,0,0,0
3686,0.00,0,0,0,0
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
7337,inf,0,0,0,0
7387,inf,0,0,0,0
7437,inf,0,0,0,0
7487,inf,0,0,0,0
7537,352.53,19,64,0,0
7587,873.52,0,54,0,-60
7638,852.85,51,54,0,2
7688,1114.74,9,49,0,-38
7738,1114.74,0,49,0,-38
7788,1402.39,0,43,0,-49
7838,1457.73,17,42,0,-10
7888,1665.00,0,38,0,-46
7938,1884.90,-7,34,0,-52
7988,2090.88,-17,30,0,-48
8038,2102.02,3,29,0,-3
8088,2315.89,0,25,0,-31
8138,2407.70,6,23,0,3
8188,2570.25,0,20,0,-26
8238,2689.14,0,18,0,-18
8288,2781.90,-11,16,0,-36
8338,2881.84,-9,14,0,-40
8388,3088.96,-79,10,0,-94
8438,3008.42,0,11,0,-11
8488,3165.89,-45,8,0,-61
8538,3340.01,-57,5,0,-64
8588,3340.76,0,5,0,-14
8638,3419.19,-4,3,0,-20
8688,3503.85,0,1,0,0
8738,3567.18,0,0,0,0
8788,3579.95,0,0,0,0
8838,3685.50,0,-1,0,0
8888,3670.17,0,-1,0,0
8938,3719.32,0,-2,0,0
8988,3724.86,0,-2,0,0
9038,3782.15,0,-3,0,0
9088,3824.58,-27,-4,0,-24
9138,3778.34,0,-3,0,0
9188,3750.94,0,-3,0,0
9238,3660.32,0,-1,0,0
9288,3617.07,0,0,0,0
9338,3579.95,0,0,0,0
9388,3593.67,0,0,0,0
9438,3561.25,0,0,0,0
9488,3568.88,0,0,0,0
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
