december454/Microcontroller-Engine-Governor/Data-Logging/3-27-2023/3-27-2023 - PID Tuning - D Major RPM Change - (P 04 I 0 D 16) - Load 2.txt

------ Microcontroller Engine Governor - Ver
-------------------------------------------------------------

Time,RPM,Steps Remaining, PID p, PID i, PID d, RPM Change
 50
-------------------------------------------------------------

Time,RPM,Steps Remaining, PID p, PID i, PID d, RPM Change
------ Microcontroller Engine Governor - Version: 1.13 ------
-------------------------------------------------------------
PID Gains:        Kp: 0.040000   Ki: 0.000000   Kd: 16.000000
-------------------------------------------------------------
Set RPM:             3600    |  Min RPM:                300
                             |
RPM Precision        2       |  PID I Precision:         202
                             |
Start Steps:         850     |  Max Steps:               1200
                             |
RPM Calc Interval:   1       |  Num Magnets:             1
                             |
LCD Update Interval: 400     |  Serial Update Interval:  50
-------------------------------------------------------------

Time,RPM,Steps Remaining, PID p, PID i, PID d, RPM Change
1643,0.00,0,0,0,0,0.00
1693,0.00,0,0,0,0,0.00
1743,0.00,0,0,0,0,0.00
1793,0.00,0,0,0,0,0.00
1843,0.00,0,0,0,0,0.00
1893,0.00,0,0,0,0,0.00
1943,0.00,0,0,0,0,0.00
1993,0.00,0,0,0,0,0.00
2043,0.00,0,0,0,0,0.00
2093,0.00,0,0,0,0,0.00
2143,0.00,0,0,0,0,0.00
2193,0.00,0,0,0,0,0.00
2243,0.00,0,0,0,0,0.00
2293,0.00,0,0,0,0,0.00
2343,0.00,0,0,0,0,0.00
2393,0.00,0,0,0,0,0.00
2443,0.00,0,0,0,0,0.00
2493,0.00,0,0,0,0,0.00
2543,0.00,0,0,0,0,0.00
2593,0.00,0,0,0,0,0.00
2643,0.00,0,0,0,0,0.00
2693,0.00,0,0,0,0,0.00
2743,0.00,0,0,0,0,0.00
2793,0.00,0,0,0,0,0.00
2843,0.00,0,0,0,0,0.00
2893,0.00,0,0,0,0,0.00
2944,0.00,0,0,0,0,0.00
2994,0.00,0,0,0,0,0.00
3044,0.00,0,0,0,0,0.00
3094,0.00,0,0,0,0,0.00
3144,0.00,0,0,0,0,0.00
3194,0.00,0,0,0,0,0.00
3244,0.00,0,0,0,0,0.00
3294,0.00,0,0,0,0,0.00
3344,0.00,0,0,0,0,0.00
3394,0.00,0,0,0,0,0.00
3444,0.00,0,0,0,0,0.00
3494,0.00,0,0,0,0,0.00
3544,0.00,0,0,0,0,0.00
3594,0.00,0,0,0,0,0.00
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
3794,inf,0,0,0,0,inf
3844,inf,0,0,0,0,inf
3894,inf,0,0,0,0,inf
3944,390.83,94,128,0,0,inf
3994,954.93,-17,105,0,-143,-564.10
4044,954.87,97,105,0,0,0.06
4094,1324.39,-24,91,0,-128,-369.52
4144,1352.94,62,89,0,-10,-28.55
4194,1556.50,0,81,0,-83,-203.56
4244,1774.73,-8,73,0,-88,-188.27
4294,1822.82,23,71,0,-23,-48.09
4344,2025.66,13,62,0,-35,-65.90
4395,2226.51,-17,54,0,-80,-131.25
4445,2318.03,10,51,0,-35,-60.70
4495,2428.76,95,46,0,57,90.56
4545,2634.81,-15,38,0,-65,-98.46
4595,2785.52,-43,32,0,-93,-128.30
4645,2866.97,-71,29,0,-103,-129.25
4695,3009.63,-162,23,0,-196,-245.16
4745,3010.23,-54,23,0,-97,-121.73
4795,3159.89,302,17,0,297,352.99
4845,3185.39,74,16,0,64,76.19
4895,3339.27,198,10,0,191,203.48
4945,3462.60,-7,5,0,-30,-106.15
4995,3558.72,0,1,0,0,412.69
5045,3580.81,0,0,0,0,9.43
5095,3690.04,0,-3,0,-2,-58.08
5145,3700.05,0,-4,0,0,22.96
5195,3916.45,-393,-12,0,-383,-359.42
5245,3558.72,0,1,0,0,312.25
5295,3908.29,-358,-12,0,-350,-350.41
5345,3780.24,0,-7,0,0,-45.18
5395,3689.13,0,-3,0,0,39.43
5445,3671.07,0,-2,0,0,-34.71
5495,3590.23,0,0,0,0,30.33
5545,3551.14,0,1,0,0,19.44
5595,3484.32,0,4,0,0,11.37
5645,3537.74,0,2,0,0,-43.68
5695,3488.37,1,4,0,0,28.63
5745,3570.58,0,1,0,-1,-53.58
5795,3557.03,0,1,0,0,21.21
5846,3558.72,0,1,0,0,4.23
5896,3536.07,1,2,0,0,22.65
5946,3602.31,0,0,0,0,-43.59
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
