december454/Microcontroller-Engine-Governor/Data-Logging/3-27-2023/3-27-2023 - PID Tuning - D Major RPM Change - (P 06 I 0 D 24) - Load 2.txt

------ Microcontroller Engine Governor -
------ Microcontroller Engine Governor - Version: 1.13 ------
-------------------------------------------------------------
PID Gains:        Kp: 0.060000   Ki: 0.000000   Kd: 24.000000
-------------------------------------------------------------
Set RPM:             3600    |  Min RPM:                300
                             |
RPM Precision        2       |  PID I Precision:         202
                             |
Start Steps:         850     |  Max Steps:               1200
                             |
RPM Calc Interval:   1       |  Num Magnets:             1
                             |
LCD Update Interval: 400     |  Serial Update Interval:  50
-------------------------------------------------------------

Time,RPM,Steps Remaining, PID p, PID i, PID d, RPM Change
1629,0.00,0,0,0,0,0.00
1679,0.00,0,0,0,0,0.00
1729,0.00,0,0,0,0,0.00
1779,0.00,0,0,0,0,0.00
1829,0.00,0,0,0,0,0.00
1879,0.00,0,0,0,0,0.00
1929,0.00,0,0,0,0,0.00
1979,0.00,0,0,0,0,0.00
2029,0.00,0,0,0,0,0.00
2079,0.00,0,0,0,0,0.00
2129,0.00,0,0,0,0,0.00
2179,0.00,0,0,0,0,0.00
2229,0.00,0,0,0,0,0.00
2279,0.00,0,0,0,0,0.00
2329,0.00,0,0,0,0,0.00
2379,0.00,0,0,0,0,0.00
2429,0.00,0,0,0,0,0.00
2479,0.00,0,0,0,0,0.00
2529,0.00,0,0,0,0,0.00
2579,0.00,0,0,0,0,0.00
2629,0.00,0,0,0,0,0.00
2679,0.00,0,0,0,0,0.00
2729,0.00,0,0,0,0,0.00
2779,0.00,0,0,0,0,0.00
2829,0.00,0,0,0,0,0.00
2879,inf,0,0,0,0,inf
2929,inf,0,0,0,0,inf
2979,inf,0,0,0,0,inf
3030,491.19,147,186,0,0,inf
3080,491.19,98,186,0,0,inf
3130,589.07,120,180,0,-23,-97.88
3180,1010.17,0,155,0,-171,-421.10
3230,1021.94,131,154,0,-4,-11.77
3280,1410.17,-63,131,0,-221,-388.23
3330,1482.65,50,127,0,-42,-72.48
3380,1825.71,-14,106,0,-136,-181.51
3430,1994.42,64,96,0,-27,-34.91
3480,2094.68,0,90,0,-85,-100.26
3530,2399.62,-140,72,0,-236,-256.45
3580,2509.20,-169,65,0,-258,-258.30
3630,2635.28,278,57,0,224,214.81
3680,2638.52,163,57,0,114,109.74
3730,2885.17,19,42,0,-6,-6.09
3780,3028.47,118,34,0,91,75.84
3830,3165.89,-108,26,0,-153,-127.61
3880,3179.31,740,25,0,728,546.47
3930,3662.11,-8,-3,0,-15,-298.88
3980,3517.82,0,4,0,0,85.35
4030,3639.01,0,-2,0,-5,-76.91
4080,3667.48,0,-4,0,0,8.99
4130,3744.38,0,-8,0,0,-40.68
4180,3749.06,0,-8,0,0,15.05
4230,3791.71,0,-11,0,0,-38.89
4281,3807.11,-11,-12,0,0,-26.86
4331,3723.01,-4,-7,0,0,26.05
4381,3715.63,-1,-6,0,0,-34.65
4431,3689.13,0,-5,0,0,35.73
4481,3661.22,0,-3,0,0,3.58
4531,3640.78,0,-2,0,0,24.91
4581,3612.72,0,0,0,0,13.98
4631,3541.08,0,3,0,0,26.11
4681,3495.69,1,6,0,0,12.26
4731,3480.28,3,7,0,0,14.60
4781,3526.92,2,4,0,-1,-37.74
4832,3523.61,3,4,0,0,26.69
4882,3606.64,0,0,0,0,-48.76
4932,3592.81,0,0,0,0,30.37
4982,3623.19,0,-1,0,0,-38.96
5032,3626.69,0,-1,0,0,10.55
5082,3665.69,-1,-3,0,0,-24.03
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
