december454/Microcontroller-Engine-Governor/Data-Logging/3-27-2023/3-27-2023 - PID Tuning - D Smoothing - (P 03 I 0 D 12) .txt

------ Microcontroller Engine Govehange
------ Microcontroller Engine Governor - Version: 1.14 ------
-------------------------------------------------------------
PID Gains:        Kp: 0.030000   Ki: 0.000000   Kd: 12.000000
-------------------------------------------------------------
Set RPM:             3600    |  Min RPM:                300
                             |
RPM Precision        2       |  PID I Precision:         202
                             |
Start Steps:         800     |  Max Steps:               1200
                             |
RPM Calc Interval:   1       |  Num Magnets:             1
                             |
LCD Update Interval: 400     |  Serial Update Interval:  50
-------------------------------------------------------------

Time,RPM,Steps Remaining, PID p, PID i, PID d, RPM Change
1589,0.00,0,0,0,0,0.00
1639,0.00,0,0,0,0,0.00
1689,0.00,0,0,0,0,0.00
1739,0.00,0,0,0,0,0.00
1789,0.00,0,0,0,0,0.00
1839,0.00,0,0,0,0,0.00
1889,0.00,0,0,0,0,0.00
1939,0.00,0,0,0,0,0.00
1989,0.00,0,0,0,0,0.00
2039,0.00,0,0,0,0,0.00
2089,0.00,0,0,0,0,0.00
2139,0.00,0,0,0,0,0.00
2189,0.00,0,0,0,0,0.00
2239,0.00,0,0,0,0,0.00
2289,0.00,0,0,0,0,0.00
2339,0.00,0,0,0,0,0.00
2390,0.00,0,0,0,0,0.00
2440,0.00,0,0,0,0,0.00
2490,0.00,0,0,0,0,0.00
2540,inf,0,0,0,0,inf
2590,inf,0,0,0,0,inf
2640,547.67,89,91,0,0,inf
2690,547.67,41,91,0,0,inf
2740,643.58,19600,88,0,19520,-95.92
2790,1076.35,-15539,75,0,-15616,-432.77
2840,1076.35,-15495,75,0,-15616,-432.77
2890,1515.30,7609,62,0,7552,-412.77
2940,1586.63,29874,60,0,29824,-71.33
2990,1785.29,52,54,0,0,-22.24
3040,1990.97,26139,48,0,26112,-205.69
3090,2217.29,-9417,41,0,-9472,-168.11
3140,2415.46,18327,35,0,18304,-217.66
3190,2516.36,18321,32,0,18304,-100.51
3240,2741.73,5,25,0,0,-143.43
3290,3027.25,10,17,0,0,-166.29
3340,3073.77,0,15,0,0,13.28
3390,3389.06,0,6,0,0,-121.09
3440,3512.88,0,2,0,0,0.00
3490,3759.40,0,-4,0,0,-126.56
3540,3859.02,0,-7,0,0,1.99
3590,3973.51,-8,-11,0,0,50.10
3640,4035.51,-10,-13,0,0,-8.67
3690,4311.58,-18,-21,0,0,-161.06
3740,4508.57,-17,-27,0,0,-174.56
3790,4503.15,-23,-27,0,0,-244.21
3840,4418.26,-14,-24,0,0,-107.92
3890,4322.77,-13,-21,0,0,49.14
3940,4279.60,-16,-20,0,0,294.96
3990,4239.68,-11,-19,0,0,26.53
4040,4481.63,-23,-26,0,0,-290.51
4090,4024.68,0,-12,0,0,324.40
4140,4026.85,-10,-12,0,0,150.26
4190,4066.14,-5,-13,0,0,-40.38
4240,3956.74,0,-10,0,0,8.37
4290,3829.46,-5,-6,0,0,24.60
4340,3740.65,-1,-4,0,0,30.09
4390,3665.69,0,-1,0,0,15.29
4440,3613.59,0,0,0,0,26.31
4490,3530.24,0,2,0,0,26.79
4540,3439.58,3,4,0,0,37.47
4590,3388.30,0,6,0,0,29.34
4640,3345.97,0,7,0,0,23.30
4690,3267.26,1,9,0,0,28.72
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
