december454/Microcontroller-Engine-Governor/Data-Logging/3-27-2023/3-27-2023 - PID Tuning - D Smoothing 30 - (P 03 I 0 D 12) .txt

------ Microcontroller Engine Governor - Version: 1.14 ------
-------------------------------------------------------------
PID Gains:        Kp: 0.030000   Ki: 0.000000   Kd: 12.000000
-------------------------------------------------------------
Set RPM:             3600    |  Min RPM:                300
                             |
RPM Precision        2       |  PID I Precision:         202
                             |
Start Steps:         800     |  Max Steps:               1200
                             |
RPM Calc Interval:   1       |  Num Magnets:             1
                             |
LCD Update Interval: 400     |  Serial Update Interval:  50
-------------------------------------------------------------

Time,RPM,Steps Remaining, PID p, PID i, PID d, RPM Change
1543,0.00,0,0,0,0,0.00
1593,0.00,0,0,0,0,0.00
1643,0.00,0,0,0,0,0.00
1693,0.00,0,0,0,0,0.00
1743,0.00,0,0,0,0,0.00
1793,0.00,0,0,0,0,0.00
1843,0.00,0,0,0,0,0.00
1893,0.00,0,0,0,0,0.00
1943,0.00,0,0,0,0,0.00
1993,0.00,0,0,0,0,0.00
2043,0.00,0,0,0,0,0.00
2093,0.00,0,0,0,0,0.00
2143,inf,0,0,0,0,inf
2193,inf,0,0,0,0,inf
2243,558.06,55,91,0,0,inf
2293,1074.73,27948,75,0,27904,-516.67
2343,1094.97,49,75,0,0,-20.24
2393,1415.63,-28062,65,0,-28160,-320.66
2443,1723.35,31793,56,0,31744,-249.29
2493,1765.33,17824,55,0,17792,-41.98
2543,2022.38,26146,47,0,26112,-84.65
2593,2233.47,32,40,0,0,-10.26
2643,2397.70,27,36,0,0,26.35
2693,2608.24,22,29,0,0,44.28
2743,2801.64,10,23,0,0,-20.78
2793,3260.16,6,10,0,0,-245.09
2843,3367.00,2,6,0,0,-203.11
2893,3533.57,0,1,0,0,-132.98
2944,3661.22,0,-1,0,0,-0.89
2994,3882.99,-4,-8,0,0,-119.82
3044,3954.65,-1,-10,0,0,6.27
3094,4106.21,-6,-15,0,0,-78.29
3144,4356.67,-20,-22,0,0,-313.54
3194,4293.07,-7,-20,0,0,-268.39
3244,4388.53,-16,-23,0,0,-78.19
3294,4285.71,-18,-20,0,0,22.15
3344,4582.95,-23,-29,0,0,-557.19
3394,4043.13,-11,-13,0,0,265.98
3444,4332.76,-10,-21,0,0,-24.89
3494,4024.68,-9,-12,0,0,438.27
3544,4117.49,-7,-15,0,0,-92.80
3594,3862.00,0,-7,0,0,334.98
3644,3862.00,-5,-7,0,0,38.16
3694,3781.19,-1,-5,0,0,27.85
3744,3697.31,0,-2,0,0,36.82
3794,3635.48,0,-1,0,0,30.21
3844,3546.94,0,1,0,0,34.72
3894,3472.22,0,3,0,0,17.77
3944,3391.36,4,6,0,0,28.61
3994,3385.24,0,6,0,0,26.95
4044,3351.96,0,7,0,0,-9.71
4094,3282.28,6,9,0,0,20.96
4144,3342.25,4,7,0,0,-33.18
4194,3377.62,0,6,0,0,-48.72
4244,3392.90,0,6,0,0,120.81
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
