december454/Microcontroller-Engine-Governor/Data-Logging/3-27-2023/3-27-2023 - PID Tuning - Dynamic D Gain 240 - (P 02 I 0 D 8) .txt

------ Microcontroller Engine Governor ------- Microcontroller Engine Governor - Version: 1.16 ------
-------------------------------------------------------------
PID Gains:        Kp: 0.020000   Ki: 0.000000   Kd: 8.000000
-------------------------------------------------------------
Set RPM:             3600    |  Min RPM:                300
                             |
RPM Precision        2       |  PID I Precision:         202
                             |
Start Steps:         850     |  Max Steps:               1200
                             |
RPM Calc Interval:   1       |  Num Magnets:             1
                             |
LCD Update Interval: 400     |  Serial Update Interval:  50
-------------------------------------------------------------

Time,RPM,Steps Remaining, PID p, PID i, PID d, RPM Change
1629,0.00,0,0,0,0,0.00
1679,0.00,0,0,0,0,0.00
1729,0.00,0,0,0,0,0.00
1779,0.00,0,0,0,0,0.00
1829,0.00,0,0,0,0,0.00
1879,0.00,0,0,0,0,0.00
1929,0.00,0,0,0,0,0.00
1979,0.00,0,0,0,0,0.00
2029,0.00,0,0,0,0,0.00
2079,0.00,0,0,0,0,0.00
2129,0.00,0,0,0,0,0.00
2179,0.00,0,0,0,0,0.00
2229,0.00,0,0,0,0,0.00
2279,0.00,0,0,0,0,0.00
2329,0.00,0,0,0,0,0.00
2379,0.00,0,0,0,0,0.00
2429,0.00,0,0,0,0,0.00
2479,0.00,0,0,0,0,0.00
2529,0.00,0,0,0,0,0.00
2579,0.00,0,0,0,0,0.00
2629,0.00,0,0,0,0,0.00
2679,0.00,0,0,0,0,0.00
2729,0.00,0,0,0,0,0.00
2779,0.00,0,0,0,0,0.00
2829,0.00,0,0,0,0,0.00
2879,0.00,0,0,0,0,0.00
2929,0.00,0,0,0,0,0.00
2979,0.00,0,0,0,0,0.00
3030,0.00,0,0,0,0,0.00
3080,0.00,0,0,0,0,0.00
3130,inf,0,0,0,0,inf
3180,inf,0,0,0,0,inf
3230,inf,0,0,0,0,inf
3280,407.96,28,63,0,0,inf
3330,908.21,0,53,0,-61,-500.25
3380,903.12,51,53,0,0,5.09
3430,1269.04,-11,46,0,-62,-365.91
3480,1317.41,28,45,0,-8,-48.37
3530,1558.12,0,40,0,-49,-240.71
3580,1607.89,0,39,0,-10,-49.77
3630,1893.22,0,34,0,-42,-171.06
3680,2020.75,13,31,0,-12,-48.10
3730,2164.50,23,28,0,-4,-14.27
3780,2305.92,0,25,0,-43,-141.42
3830,2459.82,0,22,0,-47,-147.15
3880,2635.74,47,19,0,31,87.57
3930,2635.74,58,19,0,47,131.79
3980,2754.82,53,16,0,52,137.58
4030,3033.98,-44,11,0,-59,-149.92
4080,3017.50,-18,11,0,-43,-114.46
4130,3029.08,122,11,0,117,278.53
4180,3362.47,-61,4,0,-84,-183.16
4230,3358.71,0,4,0,0,368.00
4280,3428.57,-4,3,0,-17,-89.30
4330,3518.65,0,1,0,-1,-64.81
4380,3573.13,0,0,0,0,6.82
4430,3673.77,0,-1,0,0,-56.70
4480,3680.08,0,-1,0,0,18.15
4530,3763.17,0,-3,0,0,-40.16
4580,3774.53,0,-3,0,0,26.78
4630,3821.66,0,-4,0,0,-29.95
4680,3864.98,-45,-5,0,-42,-84.74
4730,3777.39,0,-3,0,0,288.76
4780,3854.06,-38,-5,0,-40,-75.72
4830,3779.29,0,-3,0,0,237.85
4880,3781.19,0,-3,0,0,0.00
4930,3767.90,0,-3,0,0,22.85
4980,3723.01,0,-2,0,0,-15.64
5030,3732.27,-1,-2,0,0,-172.71
5080,3615.33,0,0,0,0,-4.35
5130,3563.79,0,0,0,0,231.75
5180,3562.95,0,0,0,0,120.75
5230,3516.17,0,1,0,0,26.57
5280,3543.59,0,1,0,0,-28.24
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
