december454/Microcontroller-Engine-Governor/Data-Logging/3-27-2023/3-27-2023 - PID Tuning - Dynamic D Gain 300 - (P 02 I 0 D 8).txt

------ Microcontroller Engine Governoe
------ Microcontroller Engine Governor - Version: 1.16 ------
-------------------------------------------------------------
PID Gains:        Kp: 0.020000   Ki: 0.005000   Kd: 8.000000
-------------------------------------------------------------
Set RPM:             3600    |  Min RPM:                300
                             |
RPM Precision        2       |  PID I Precision:         202
                             |
Start Steps:         850     |  Max Steps:               1200
                             |
RPM Calc Interval:   1       |  Num Magnets:             1
                             |
LCD Update Interval: 400     |  Serial Update Interval:  50
-------------------------------------------------------------

Time,RPM,Steps Remaining, PID p, PID i, PID d, RPM Change
1629,0.00,0,0,0,0,0.00
1679,0.00,0,0,0,0,0.00
1729,0.00,0,0,0,0,0.00
1779,0.00,0,0,0,0,0.00
1829,0.00,0,0,0,0,0.00
1879,0.00,0,0,0,0,0.00
1929,0.00,0,0,0,0,0.00
1979,0.00,0,0,0,0,0.00
2029,0.00,0,0,0,0,0.00
2079,0.00,0,0,0,0,0.00
2129,0.00,0,0,0,0,0.00
2179,0.00,0,0,0,0,0.00
2229,0.00,0,0,0,0,0.00
2279,0.00,0,0,0,0,0.00
2329,0.00,0,0,0,0,0.00
2379,0.00,0,0,0,0,0.00
2429,0.00,0,0,0,0,0.00
2479,0.00,0,0,0,0,0.00
2529,0.00,0,0,0,0,0.00
2579,inf,0,0,0,0,inf
2629,inf,0,0,0,0,inf
2679,inf,0,0,0,0,inf
2729,inf,0,0,0,0,inf
4370,2850.12,13,14,0,0,inf
4420,5023.44,-274,-28,0,-254,-382.35
4470,4643.96,-13,-20,0,0,-1.44
4520,4641.09,-15,-20,0,0,1.44
4570,4641.09,-219,-20,0,-201,-327.02
4620,4312.82,-3,-14,0,0,1.24
4670,4314.06,-7,-14,0,0,-1.24
4720,4468.28,-286,-17,0,-270,-440.35
4770,4027.93,-1,-8,0,0,327.47
4820,4143.65,-51,-10,0,-55,-104.87
4870,4246.89,-258,-12,0,-249,-467.60
4920,3779.29,0,-3,0,0,351.80
4970,3908.29,-59,-6,0,-64,-128.04
5020,3558.72,0,0,0,0,439.15
5070,3801.32,0,-4,-1,0,-243.44
5120,3585.09,0,0,-7,0,27.63
5170,3364.74,0,4,0,0,163.01
5220,3412.97,0,3,0,0,33.72
5270,3332.59,13,5,0,14,31.39
5320,3174.60,81,8,0,74,166.90
5370,3309.07,55,5,0,65,80.00
5420,3340.76,-59,5,0,-73,-175.53
5470,3185.39,0,8,0,-7,-18.16
5520,3028.47,95,11,0,97,244.50
5570,3165.22,-40,8,0,-54,-136.76
5620,3018.11,10,11,0,15,38.13
5670,3028.47,79,11,0,76,181.46
5720,3113.32,-5,9,0,-32,-76.27
5770,3027.25,55,11,0,53,139.32
5820,3165.22,-45,8,0,-54,-136.76
5870,3115.91,36,9,0,40,102.28
5920,3186.74,0,8,0,-9,-21.52
5970,3175.95,53,8,0,64,153.69
6020,3200.34,128,7,0,133,316.66
6070,3260.16,0,6,0,-10,-25.31
6120,3294.53,-1,6,0,-26,-56.19
6170,3348.96,113,5,0,123,379.60
6220,3411.42,0,3,0,0,-51.20
6270,3427.00,0,3,0,0,30.81
6320,3523.61,0,1,0,0,-53.80
6370,3543.59,0,1,0,0,26.99
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
