december454/Microcontroller-Engine-Governor/Data-Logging/3-27-2023/3-27-2023 - PID Tuning - PID D Overspeed Control.txt

------ Microcontroller Engine Governor - Version: 1.13 ------
-------------------------------------------------------------
PID Gains:        Kp: 0.010000   Ki: 0.005000   Kd: 3.000000
-------------------------------------------------------------
Set RPM:             3600    |  Min RPM:                300
                             |
RPM Precision        2       |  PID I Precision:         202
                             |
Start Steps:         900     |  Max Steps:               1200
                             |
RPM Calc Interval:   1       |  Num Magnets:             1
                             |
LCD Update Interval: 400     |  Serial Update Interval:  50
-------------------------------------------------------------

Time,RPM,Steps Remaining, PID p, PID i, PID d
1727,0.00,0,0,0,0
1777,0.00,0,0,0,0
1827,0.00,0,0,0,0
1878,0.00,0,0,0,0
1928,0.00,0,0,0,0
1978,0.00,0,0,0,0
2028,0.00,0,0,0,0
2078,0.00,0,0,0,0
2128,0.00,0,0,0,0
2178,0.00,0,0,0,0
2228,0.00,0,0,0,0
2278,0.00,0,0,0,0
2328,0.00,0,0,0,0
2378,0.00,0,0,0,0
2428,0.00,0,0,0,0
2478,0.00,0,0,0,0
2528,0.00,0,0,0,0
2578,0.00,0,0,0,0
2628,0.00,0,0,0,0
2678,0.00,0,0,0,0
2728,0.00,0,0,0,0
2778,0.00,0,0,0,0
2828,0.00,0,0,0,0
2878,0.00,0,0,0,0
2928,0.00,0,0,0,0
2978,0.00,0,0,0,0
3028,0.00,0,0,0,0
3078,0.00,0,0,0,0
3128,0.00,0,0,0,0
3178,0.00,0,0,0,0
3228,0.00,0,0,0,0
3278,0.00,0,0,0,0
3328,0.00,0,0,0,0
3378,0.00,0,0,0,0
3428,0.00,0,0,0,0
3478,0.00,0,0,0,0
3528,0.00,0,0,0,0
3578,0.00,0,0,0,0
3628,0.00,0,0,0,0
3678,0.00,0,0,0,0
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
10782,inf,0,0,0,0
10832,inf,0,0,0,0
10882,506.91,0,30,0,0
10932,506.91,0,30,0,0
10982,579.71,3,30,0,-2
11032,969.99,0,26,0,-18
11082,972.01,23,26,0,0
11132,1317.87,0,22,0,-23
11182,1327.79,10,22,0,0
11232,1572.16,0,20,0,-19
11282,1775.57,0,18,0,-17
11332,1779.57,0,18,0,0
11382,1949.32,9,16,0,0
11432,2090.88,0,15,0,-14
11482,2277.56,0,13,0,-24
11532,2355.16,0,12,0,-14
11582,2457.00,0,11,0,-12
11632,2571.58,0,10,0,-15
11682,2662.41,6,9,0,1
11732,2753.30,0,8,0,1
11782,2853.88,0,7,0,1
11832,3027.86,0,5,0,-11
11882,3106.88,0,4,0,-13
11932,3169.91,0,4,0,3
11982,3315.65,-13,2,0,-21
12032,3351.96,1,2,0,0
12082,3406.77,0,1,0,0
12132,3531.90,0,0,0,0
12182,3564.64,0,0,0,0
12232,3719.32,0,-1,0,0
12282,3646.09,0,0,0,0
12332,3714.71,0,-1,0,0
12382,3709.20,0,-1,0,0
12432,3749.06,0,-1,0,0
12482,3791.71,0,-1,0,0
12532,3770.74,0,-1,0,0
12582,3801.32,0,-2,-1,0
12632,3796.51,0,-1,-8,0
12682,3810.98,0,-2,0,0
12732,3792.67,0,-1,0,0
12782,3791.71,0,-1,0,0
12832,3812.91,0,-2,0,0
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
