december454/Microcontroller-Engine-Governor/Data-Logging/3-27-2023/3-27-2023 - PID Tuning - Tuning Dynamic D Gain - (P 02 I 005 D 8) .txt

------ Microcontroller Engine Governor - Version: 1.14 ------
-------------------------------------------------------------
PID Gains:        Kp: 0.020000   Ki: 0.005000   Kd: 8.000000
-------------------------------------------------------------
Set RPM:             3600    |  Min RPM:                300
                             |
RPM Precision        2       |  PID I Precision:         202
                             |
Start Steps:         800     |  Max Steps:               1200
                             |
RPM Calc Interval:   1       |  Num Magnets:             1
                             |
LCD Update Interval: 400     |  Serial Update Interval:  50
-------------------------------------------------------------

Time,RPM,Steps Remaining, PID p, PID i, PID d
1521,0.00,0,0,0,0
1571,0.00,0,0,0,0
1622,0.00,0,0,0,0
1672,0.00,0,0,0,0
1722,0.00,0,0,0,0
1772,0.00,0,0,0,0
1822,0.00,0,0,0,0
1872,0.00,0,0,0,0
1922,0.00,0,0,0,0
1972,0.00,0,0,0,0
2022,0.00,0,0,0,0
2072,0.00,0,0,0,0
2122,0.00,0,0,0,0
2172,0.00,0,0,0,0
2222,0.00,0,0,0,0
2272,0.00,0,0,0,0
2322,0.00,0,0,0,0
2372,0.00,0,0,0,0
2422,0.00,0,0,0,0
2472,0.00,0,0,0,0
2522,0.00,0,0,0,0
2572,0.00,0,0,0,0
2622,0.00,0,0,0,0
2672,0.00,0,0,0,0
2722,0.00,0,0,0,0
2772,0.00,0,0,0,0
2822,0.00,0,0,0,0
2872,0.00,0,0,0,0
2922,0.00,0,0,0,0
2972,0.00,0,0,0,0
3022,0.00,0,0,0,0
3072,0.00,0,0,0,0
3122,0.00,0,0,0,0
3172,0.00,0,0,0,0
3222,0.00,0,0,0,0
3272,0.00,0,0,0,0
3322,0.00,0,0,0,0
3372,0.00,0,0,0,0
3422,0.00,0,0,0,0
3472,0.00,0,0,0,0
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
7124,inf,0,0,0,0
7174,inf,0,0,0,0
7224,508.04,45,61,0,0
7274,508.04,0,61,0,0
7324,639.17,26,59,0,-11
7374,1095.37,0,50,0,-66
7424,1105.05,36,49,0,-1
7474,1499.25,-13,42,0,-78
7524,1530.30,1,41,0,-6
7574,1790.19,4,36,0,-17
7624,1992.83,24,32,0,-3
7674,2132.20,0,29,0,-39
7724,2412.35,-21,23,0,-68
7774,2510.04,-27,21,0,-72
7824,2635.74,45,19,0,30
7874,2815.84,-17,15,0,-42
7924,2866.97,-26,14,0,-58
7974,3015.68,-34,11,0,-52
8024,3165.22,-53,8,0,-78
8074,3027.25,56,11,0,53
8124,3166.56,14,8,0,7
8174,3176.62,64,8,0,71
8224,3351.96,0,4,0,0
8274,3477.05,0,2,0,-1
8324,3495.69,0,2,0,0
8374,3549.46,0,1,0,0
8424,3629.32,0,0,0,0
8474,3720.24,0,-2,0,0
8524,3713.79,0,-2,0,0
8574,3775.48,0,-3,0,0
8624,3759.40,0,-3,0,0
8674,3802.28,0,-4,0,0
8724,3790.75,-2,-3,0,0
8774,3770.74,-2,-3,-2,0
8824,3779.29,-17,-3,-20,0
8875,3785.01,-155,-3,-160,0
8925,3785.01,-1272,-3,-1278,0
8975,3562.95,-10212,0,-10221,0
9025,3541.08,-16220,1,-16230,0
9075,3346.72,208,5,0,210
9125,3342.25,88,5,0,87
9175,3165.89,41,8,0,49
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
