december454/Microcontroller-Engine-Governor/Data-Logging/3-27-2023/3-27-2023 - PID Tuning - Tuning Dynamic D Gain - (P 023 I 0 D 12) .txt

------ Microcontroller Engine Governor - Version: 1.14 ------
-------------------------------------------------------------
PID Gains:        Kp: 0.023000   Ki: 0.000000   Kd: 12.000000
-------------------------------------------------------------
Set RPM:             3600    |  Min RPM:                300
                             |
RPM Precision        2       |  PID I Precision:         202
                             |
Start Steps:         800     |  Max Steps:               1200
                             |
RPM Calc Interval:   1       |  Num Magnets:             1
                             |
LCD Update Interval: 400     |  Serial Update Interval:  50
-------------------------------------------------------------

Time,RPM,Steps Remaining, PID p, PID i, PID d
1543,0.00,0,0,0,0
1593,0.00,0,0,0,0
1643,0.00,0,0,0,0
1693,0.00,0,0,0,0
1743,0.00,0,0,0,0
1793,0.00,0,0,0,0
1843,0.00,0,0,0,0
1893,0.00,0,0,0,0
1943,0.00,0,0,0,0
1993,0.00,0,0,0,0
2043,0.00,0,0,0,0
2093,0.00,0,0,0,0
2143,0.00,0,0,0,0
2193,0.00,0,0,0,0
2243,0.00,0,0,0,0
2293,0.00,0,0,0,0
2343,0.00,0,0,0,0
2393,0.00,0,0,0,0
2443,0.00,0,0,0,0
2493,0.00,0,0,0,0
2543,0.00,0,0,0,0
2593,0.00,0,0,0,0
2643,inf,0,0,0,0
2693,inf,0,0,0,0
2743,521.99,53,70,0,0
2793,521.99,7,70,0,0
2843,660.56,23,67,0,-18
2893,1113.75,-22,57,0,-102
2944,1124.02,35,56,0,-2
2994,1499.25,-34,48,0,-112
3044,1763.88,-15,42,0,-64
3094,1782.32,11,41,0,-6
3144,2042.76,0,35,0,-45
3194,2148.38,25,33,0,0
3244,2297.79,-7,29,0,-39
3294,2359.60,28,28,0,3
3344,2539.79,-48,24,0,-76
3394,2510.04,10,25,0,-9
3444,2526.53,97,24,0,83
3494,2755.33,0,19,0,-32
3544,2866.97,-46,16,0,-64
3594,3016.89,-77,13,0,-101
3644,3008.42,-73,13,0,-106
3694,3029.08,0,13,0,-22
3744,3027.25,51,13,0,58
3794,3175.95,90,9,0,93
3844,3227.19,-27,8,0,-39
3894,3341.50,-337,5,0,-359
3944,3351.96,0,5,0,-16
3994,3354.20,-26,5,0,-39
4044,3546.94,0,1,0,0
4094,3441.16,1,3,0,0
4144,3481.09,0,2,0,0
4194,3578.24,0,0,0,0
4244,3580.81,0,0,0,0
4294,3660.32,0,-1,0,0
4344,3720.24,-1,-2,0,0
4395,3712.87,0,-2,0,0
4445,3766.95,0,-3,0,0
4495,3767.90,0,-3,0,0
4545,3801.32,0,-4,0,0
4595,3778.34,0,-4,0,0
4645,3781.19,0,-4,0,0
4695,3745.32,0,-3,0,0
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
