december454/Microcontroller-Engine-Governor/Data-Logging/3-27-2023/3-27-2023 - PID Tuning - Tuning Dynamic D Gain - (P 025 I 005 D 8) .txt

------ Microcontroller Engine Governor - Version: 1.14 ------
-------------------------------------------------------------
PID Gains:        Kp: 0.025000   Ki: 0.005000   Kd: 8.000000
-------------------------------------------------------------
Set RPM:             3600    |  Min RPM:                300
                             |
RPM Precision        2       |  PID I Precision:         202
                             |
Start Steps:         800     |  Max Steps:               1200
                             |
RPM Calc Interval:   1       |  Num Magnets:             1
                             |
LCD Update Interval: 400     |  Serial Update Interval:  50
-------------------------------------------------------------

Time,RPM,Steps Remaining, PID p, PID i, PID d
1423,0.00,0,0,0,0
1473,0.00,0,0,0,0
1523,0.00,0,0,0,0
1573,0.00,0,0,0,0
1623,0.00,0,0,0,0
1673,0.00,0,0,0,0
1723,0.00,0,0,0,0
1773,0.00,0,0,0,0
1823,0.00,0,0,0,0
1873,0.00,0,0,0,0
1923,0.00,0,0,0,0
1973,0.00,0,0,0,0
2023,0.00,0,0,0,0
2073,0.00,0,0,0,0
2123,0.00,0,0,0,0
2173,0.00,0,0,0,0
2223,0.00,0,0,0,0
2273,0.00,0,0,0,0
2323,0.00,0,0,0,0
2373,0.00,0,0,0,0
2423,0.00,0,0,0,0
2473,0.00,0,0,0,0
2523,0.00,0,0,0,0
2573,0.00,0,0,0,0
2623,0.00,0,0,0,0
2673,0.00,0,0,0,0
2723,0.00,0,0,0,0
2774,0.00,0,0,0,0
2824,0.00,0,0,0,0
2874,0.00,0,0,0,0
2924,0.00,0,0,0,0
2974,0.00,0,0,0,0
3024,0.00,0,0,0,0
3074,0.00,0,0,0,0
3124,0.00,0,0,0,0
3174,0.00,0,0,0,0
3224,0.00,0,0,0,0
3274,0.00,0,0,0,0
3324,0.00,0,0,0,0
3374,0.00,0,0,0,0
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
3474,inf,0,0,0,0
3524,inf,0,0,0,0
3574,inf,0,0,0,0
3624,493.40,41,77,0,0
3674,493.40,0,77,0,0
3724,630.12,23,74,0,-11
3774,1073.73,0,63,0,-63
3824,1117.15,25,62,0,-6
3874,1556.50,37,51,0,-12
3924,1758.29,0,46,0,-46
3974,2052.83,-13,38,0,-56
4024,2060.72,10,38,0,-2
4074,2299.20,0,32,0,-24
4124,2618.26,-36,24,0,-61
4174,2737.23,-26,21,0,-53
4224,2866.42,-31,18,0,-61
4275,3020.54,-22,14,0,-37
4325,3165.22,-52,10,0,-75
4375,3395.97,-98,5,0,-110
4425,3351.21,-2,6,0,-11
4475,3530.24,0,1,0,0
4525,3484.32,0,2,0,0
4575,3521.95,0,1,0,0
4625,3649.63,0,-1,0,0
4675,3607.50,0,0,0,0
4725,3719.32,-1,-2,0,0
4775,3761.28,-1,-4,0,0
4825,3765.06,0,-4,0,0
4875,3827.51,0,-5,0,0
4925,3788.84,0,-4,0,0
4975,3829.46,0,-5,0,0
5025,3813.88,0,-5,0,0
5075,3779.29,-2,-4,0,0
5125,3785.97,-1,-4,0,0
5175,3755.63,0,-3,0,0
5225,3750.00,0,-3,0,0
5275,3708.28,0,-2,0,0
5325,3674.67,0,-1,0,0
5376,3649.63,0,-1,0,0
5426,3631.08,0,0,0,0
5476,3607.50,0,0,0,0
5526,3602.31,0,0,0,0
5576,3588.52,0,0,0,0
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
