december454/Microcontroller-Engine-Governor/Data-Logging/3-27-2023/3-27-2023 - PID Tuning - Tuning Dynamic D Gain 100 - (P 025 I 0 D 12) .txt

------ Microcontroller Engine Governor - Version: 1.14 ------
-------------------------------------------------------------
PID Gains:        Kp: 0.025000   Ki: 0.000000   Kd: 12.000000
-------------------------------------------------------------
Set RPM:             3600    |  Min RPM:                300
                             |
RPM Precision        2       |  PID I Precision:         202
                             |
Start Steps:         800     |  Max Steps:               1200
                             |
RPM Calc Interval:   1       |  Num Magnets:             1
                             |
LCD Update Interval: 400     |  Serial Update Interval:  50
-------------------------------------------------------------

Time,RPM,Steps Remaining, PID p, PID i, PID d
1519,0.00,0,0,0,0
1569,0.00,0,0,0,0
1619,0.00,0,0,0,0
1669,0.00,0,0,0,0
1719,0.00,0,0,0,0
1769,0.00,0,0,0,0
1819,0.00,0,0,0,0
1869,0.00,0,0,0,0
1920,0.00,0,0,0,0
1970,0.00,0,0,0,0
2020,0.00,0,0,0,0
2070,0.00,0,0,0,0
2120,0.00,0,0,0,0
2170,0.00,0,0,0,0
2220,0.00,0,0,0,0
2270,0.00,0,0,0,0
2320,0.00,0,0,0,0
2370,0.00,0,0,0,0
2420,0.00,0,0,0,0
2470,0.00,0,0,0,0
2520,0.00,0,0,0,0
2570,0.00,0,0,0,0
2620,0.00,0,0,0,0
2670,0.00,0,0,0,0
2720,0.00,0,0,0,0
2770,0.00,0,0,0,0
2820,0.00,0,0,0,0
2870,0.00,0,0,0,0
2920,0.00,0,0,0,0
2970,0.00,0,0,0,0
3020,0.00,0,0,0,0
3070,0.00,0,0,0,0
3120,0.00,0,0,0,0
3170,0.00,0,0,0,0
3220,0.00,0,0,0,0
3270,0.00,0,0,0,0
3320,0.00,0,0,0,0
3371,0.00,0,0,0,0
3421,0.00,0,0,0,0
3471,0.00,0,0,0,0
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
3871,inf,0,0,0,0
3921,inf,0,0,0,0
3971,inf,0,0,0,0
4021,378.82,41,80,0,0
4071,907.55,-8,67,0,-96
4121,909.53,58,67,0,0
4171,1349.28,-46,56,0,-117
4221,1354.40,37,56,0,-1
4271,1617.95,-3,49,0,-85
4321,1869.86,-33,43,0,-90
4371,1981.51,-6,40,0,-47
4421,2050.02,0,38,0,-27
4471,2150.85,20,36,0,0
4521,2319.83,0,32,0,-46
4571,2380.20,24,30,0,6
4621,2468.32,26,28,0,11
4671,2547.55,21,26,0,7
4721,2615.52,12,24,0,8
4771,2758.87,22,21,0,6
4822,2743.74,58,21,0,48
4872,3007.22,-86,14,0,-119
4922,2884.62,158,17,0,150
4972,3027.86,38,14,0,40
5022,3155.24,118,11,0,113
5072,3187.42,37,10,0,31
5122,3366.25,-47,5,0,-69
5172,3407.54,0,4,0,0
5222,3418.41,0,4,0,0
5272,3477.05,0,3,0,0
5322,3495.69,0,2,0,0
5372,3578.24,0,0,0,0
5422,3587.66,0,0,0,0
5472,3655.86,0,-1,0,0
5522,3650.52,0,-1,0,0
5572,3891.05,-279,-7,0,-279
5622,3557.87,0,1,0,0
5672,3961.96,-342,-9,0,-345
5722,3559.56,0,1,0,0
5772,3959.87,-313,-8,0,-320
5822,3915.43,-291,-7,0,-285
5872,3541.08,0,1,0,0
5922,3703.70,-508,-2,0,-508
5972,3426.22,3,4,0,0
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
