december454/Microcontroller-Engine-Governor/Data-Logging/3-27-2023/3-27-2023 - PID Tuning - Tuning Dynamic D Gain 100 - (P 03 I 0 D 12) .txt

------ Microcontroller Engine Governor :  50
-------------------------------------------------------------

Time,RPM,Steps Remaining, PID p, PID i, PID d
e Interval:  50
-------------------------------------------------------------

Time,RPM,Steps Remaining, PID p, PID i, PID d
------ Microcontroller Engine Governor - Version: 1.14 ------
-------------------------------------------------------------
PID Gains:        Kp: 0.030000   Ki: 0.000000   Kd: 12.000000
-------------------------------------------------------------
Set RPM:             3600    |  Min RPM:                300
                             |
RPM Precision        2       |  PID I Precision:         202
                             |
Start Steps:         800     |  Max Steps:               1200
                             |
RPM Calc Interval:   1       |  Num Magnets:             1
                             |
LCD Update Interval: 400     |  Serial Update Interval:  50
-------------------------------------------------------------

Time,RPM,Steps Remaining, PID p, PID i, PID d
1544,0.00,0,0,0,0
1594,0.00,0,0,0,0
1644,0.00,0,0,0,0
1694,0.00,0,0,0,0
1744,0.00,0,0,0,0
1794,0.00,0,0,0,0
1844,0.00,0,0,0,0
1894,0.00,0,0,0,0
1944,0.00,0,0,0,0
1994,0.00,0,0,0,0
2044,0.00,0,0,0,0
2094,0.00,0,0,0,0
2144,0.00,0,0,0,0
2194,0.00,0,0,0,0
2244,0.00,0,0,0,0
2294,0.00,0,0,0,0
2344,0.00,0,0,0,0
2394,0.00,0,0,0,0
2444,0.00,0,0,0,0
2494,0.00,0,0,0,0
2544,0.00,0,0,0,0
2594,0.00,0,0,0,0
2644,0.00,0,0,0,0
2694,0.00,0,0,0,0
2744,0.00,0,0,0,0
2794,0.00,0,0,0,0
2844,0.00,0,0,0,0
2894,0.00,0,0,0,0
2944,inf,0,0,0,0
2994,inf,0,0,0,0
3044,inf,0,0,0,0
3094,403.94,77,95,0,0
3144,972.13,-27,78,0,-111
3194,972.13,0,78,0,-111
3244,964.13,37,79,0,1
3294,1294.67,71,69,0,3
3344,1428.84,18,65,0,-38
3394,1465.70,36,64,0,-10
3444,1708.43,0,56,0,-83
3494,1944.01,-14,49,0,-81
3544,2197.16,-35,42,0,-87
3594,2415.46,-84,35,0,-126
3644,2510.04,-20,32,0,-60
3694,2618.71,-23,29,0,-63
3744,2754.82,0,25,0,-23
3794,2866.97,-40,21,0,-64
3844,3007.82,-71,17,0,-100
3894,3117.21,-48,14,0,-64
3944,3167.23,-95,12,0,-120
3994,3351.96,-101,7,0,-116
4044,3362.47,-3,7,0,-14
4094,3428.57,4,5,0,0
4144,3465.00,0,4,0,0
4194,3582.52,0,0,0,0
4244,3608.37,0,0,0,0
4294,3711.03,-192,-3,0,-205
4344,3950.49,-323,-10,0,-314
4395,3572.28,0,0,0,0
4445,3814.85,-25,-6,0,-25
4495,3780.24,0,-5,0,0
4545,3879.98,-72,-8,0,-76
4595,3558.72,0,1,0,0
4645,3960.92,-317,-10,0,-324
4695,3741.58,-3,-4,0,0
4745,3540.24,0,1,0,0
4795,3839.26,-213,-7,0,-209
4845,3559.56,0,1,0,0
4895,3566.33,0,1,0,0
4945,3481.09,0,3,0,0
4995,3469.01,2,3,0,0
5045,3472.22,0,3,0,-1
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
