december454/Microcontroller-Engine-Governor/Data-Logging/3-29-2023/3-29-2023 - PID Tuning - (P 015 I 0 D 0).txt

------ Microcontroller Engine Governor - 0
-------------------------------------------------------------

Time,RPM,Steps Remaining, PID p, PID i, PID d, RPM Change
 50
-------------------------------------------------------------

Time,RPM,Steps Remaining, PID p, PID i, PID d, RPM Change
------ Microcontroller Engine Governor - Version: 1.16 ------
-------------------------------------------------------------
PID Gains:        Kp: 0.015000   Ki: 0.000000   Kd: 0.000000
-------------------------------------------------------------
Set RPM:             3600    |  Min RPM:                300
                             |
RPM Precision        2       |  PID I Precision:         52
                             |
Start Steps:         850     |  Max Steps:               1200
                             |
RPM Calc Interval:   1       |  Num Magnets:             1
                             |
LCD Update Interval: 400     |  Serial Update Interval:  50
-------------------------------------------------------------

Time,RPM,Steps Remaining, PID p, PID i, PID d, RPM Change
1636,0.00,0,0,0,0,0.00
1686,0.00,0,0,0,0,0.00
1736,0.00,0,0,0,0,0.00
1786,0.00,0,0,0,0,0.00
1836,0.00,0,0,0,0,0.00
1886,0.00,0,0,0,0,0.00
1936,0.00,0,0,0,0,0.00
1986,0.00,0,0,0,0,0.00
2036,0.00,0,0,0,0,0.00
2086,0.00,0,0,0,0,0.00
2136,0.00,0,0,0,0,0.00
2186,0.00,0,0,0,0,0.00
2236,0.00,0,0,0,0,0.00
2286,0.00,0,0,0,0,0.00
2336,0.00,0,0,0,0,0.00
2386,0.00,0,0,0,0,0.00
2436,0.00,0,0,0,0,0.00
2486,0.00,0,0,0,0,0.00
2536,0.00,0,0,0,0,0.00
2586,0.00,0,0,0,0,0.00
2636,0.00,0,0,0,0,0.00
2686,0.00,0,0,0,0,0.00
2736,0.00,0,0,0,0,0.00
2786,0.00,0,0,0,0,0.00
2836,0.00,0,0,0,0,0.00
2886,0.00,0,0,0,0,0.00
2936,0.00,0,0,0,0,0.00
2987,inf,0,0,0,0,inf
3037,inf,0,0,0,0,inf
3087,526.83,42,46,0,0,inf
3137,526.83,0,46,0,0,inf
3187,604.21,39,44,0,0,-77.37
3237,604.21,0,44,0,0,-77.37
3287,1012.83,0,38,0,0,-408.62
3337,1015.57,2,38,0,0,-2.74
3387,1462.42,29,32,0,0,-24.81
3437,1732.90,9,28,0,0,-270.49
3487,2012.34,19,23,0,0,-264.91
3537,2029.22,0,23,0,0,-16.88
3587,2270.66,0,19,0,0,-15.36
3637,2478.11,0,16,0,0,-6.53
3687,2933.12,3,10,0,0,-128.86
3737,3063.10,0,8,0,0,-184.57
3787,3230.67,0,5,0,0,1.39
3837,3533.57,0,0,0,0,-155.19
3887,3649.63,0,0,0,0,8.01
3937,3887.02,0,-4,0,0,-106.78
3987,3977.72,0,-5,0,0,22.28
4037,4144.79,-2,-8,0,0,12.64
4087,4225.35,0,-9,0,0,-80.56
4137,4334.01,-5,-11,0,0,-71.43
4187,4349.09,0,-11,0,0,21.54
4237,4455.00,-3,-12,0,0,-139.70
4287,4383.40,-7,-11,0,0,29.66
4337,4378.28,0,-11,0,0,-30.46
4387,4288.16,-2,-10,0,0,33.36
4438,4288.16,-9,-10,0,0,-14.66
4488,4277.16,-1,-10,0,0,9.78
4538,4273.50,-7,-10,0,0,26.95
4588,4300.46,0,-10,0,0,-12.29
4638,4286.94,-4,-10,0,0,-12.22
4688,4248.09,0,-9,0,0,19.34
4738,4248.09,-3,-9,0,0,21.77
4788,4280.82,0,-10,0,0,-32.73
4838,4255.32,-2,-9,0,0,-26.39
4888,4163.20,0,-8,0,0,38.48
4938,4054.05,0,-6,0,0,36.48
4988,3977.72,0,-5,0,0,32.97
5038,3914.40,0,-4,0,0,32.96
5088,3838.28,-1,-3,0,0,26.70
5138,3785.97,0,-2,0,0,21.14
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
