december454/Microcontroller-Engine-Governor/Data-Logging/3-29-2023/3-29-2023 - PID Tuning - (P 015 I 0 D 6).txt

------ Microcontroller Engine Governor - Version: 1.16 ------
-------------------------------------------------------------
PID Gains:        Kp: 0.015000   Ki: 0.000000   Kd: 6.000000
-------------------------------------------------------------
Set RPM:             3600    |  Min RPM:                300
                             |
RPM Precision        2       |  PID I Precision:         72
                             |
Start Steps:         850     |  Max Steps:               1200
                             |
RPM Calc Interval:   1       |  Num Magnets:             1
                             |
LCD Update Interval: 400     |  Serial Update Interval:  50
-------------------------------------------------------------

Time,RPM,Steps Remaining, PID p, PID i, PID d, RPM Change
1560,0.00,0,0,0,0,0.00
1610,0.00,0,0,0,0,0.00
1660,0.00,0,0,0,0,0.00
1710,0.00,0,0,0,0,0.00
1760,0.00,0,0,0,0,0.00
1810,0.00,0,0,0,0,0.00
1860,0.00,0,0,0,0,0.00
1910,0.00,0,0,0,0,0.00
1960,0.00,0,0,0,0,0.00
2010,0.00,0,0,0,0,0.00
2060,0.00,0,0,0,0,0.00
2110,0.00,0,0,0,0,0.00
2160,0.00,0,0,0,0,0.00
2210,0.00,0,0,0,0,0.00
2260,0.00,0,0,0,0,0.00
2310,0.00,0,0,0,0,0.00
2360,0.00,0,0,0,0,0.00
2410,inf,0,0,0,0,inf
2460,inf,0,0,0,0,inf
2510,inf,0,0,0,0,inf
2560,477.92,15,46,0,0,inf
2610,477.92,0,46,0,0,inf
2660,623.75,0,44,0,-9,-145.83
2710,1046.61,0,38,0,-44,-422.86
2760,1043.33,18,38,0,0,3.28
2810,1400.69,0,32,0,-49,-357.36
2860,1399.65,0,33,0,0,1.05
2910,1597.44,21,30,0,-1,-9.13
2960,1833.74,0,26,0,-44,-236.30
3010,2036.66,-2,23,0,-39,-195.04
3060,2203.61,-8,20,0,-35,-159.46
3110,2344.85,-9,18,0,-31,-131.81
3160,2462.65,-9,17,0,-29,-117.07
3210,2585.32,-16,15,0,-37,-143.11
3260,2618.71,0,14,0,-20,-78.93
3310,2753.81,0,12,0,-4,-15.08
3360,2844.14,11,11,0,2,7.57
3410,2920.56,4,10,0,5,17.16
3460,2982.11,0,9,0,7,24.51
3510,3186.74,0,6,0,-10,-34.82
3560,3192.17,8,6,0,7,22.58
3610,3085.78,42,7,0,52,175.08
3660,3491.62,0,1,0,0,47.79
3710,3351.21,0,3,0,0,62.54
3760,3510.41,0,1,0,0,-56.58
3810,3516.17,0,1,0,0,1.65
3860,3592.81,0,0,0,0,-45.88
3910,3582.52,0,0,0,0,11.16
3960,3665.69,0,0,0,0,-47.74
4011,3656.75,0,0,0,0,29.66
4061,3692.76,0,-1,0,0,-18.99
4111,3693.67,0,-1,0,0,21.04
4161,3744.38,0,-2,0,0,-36.10
4211,3750.00,0,-2,0,0,13.17
4261,3801.32,0,-3,0,0,-42.86
4311,3801.32,-1,-3,0,0,-22.98
4361,3795.55,0,-2,0,0,16.40
4411,3831.42,0,-3,0,0,-24.31
4461,3765.06,0,-2,0,0,35.29
4511,3789.79,0,-2,0,0,-19.05
4561,3768.84,0,-2,0,0,21.91
4611,3801.32,0,-3,0,0,-16.31
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
