december454/Microcontroller-Engine-Governor/Data-Logging/3-29-2023/3-29-2023 - PID Tuning - Tweaking Equations - (P 015 I 002 D 6).txt

------ Microcontroller Engine Governor - Version: 1.16 ------
-------------------------------------------------------------
PID Gains:        Kp: 0.015000   Ki: 0.002000   Kd: 6.000000
-------------------------------------------------------------
Set RPM:             3600    |  Min RPM:                300
                             |
RPM Precision        2       |  PID I Precision:         152
                             |
Start Steps:         850     |  Max Steps:               1200
                             |
RPM Calc Interval:   1       |  Num Magnets:             1
                             |
LCD Update Interval: 400     |  Serial Update Interval:  50
-------------------------------------------------------------

Time,RPM,Steps Remaining, PID p, PID i, PID d, RPM Change
88,inf,0,0,0,0,0.00
138,3666.59,0,0,0,0,0.00
188,3685.50,0,0,0,0,0.00
238,3687.32,0,0,0,0,0.00
288,3628.45,0,0,0,0,0.00
338,3676.47,0,0,0,0,0.00
388,3638.13,0,0,0,0,0.00
438,3656.75,0,0,0,0,0.00
488,3638.13,0,0,0,0,0.00
538,3685.50,0,0,0,0,0.00
588,3666.59,0,0,0,0,0.00
638,3666.59,0,0,0,0,0.00
688,3646.97,0,0,0,0,0.00
738,3695.49,0,0,0,0,0.00
788,3675.57,0,0,0,0,0.00
838,3694.58,0,0,0,0,0.00
888,3656.75,0,0,0,0,0.00
939,3639.01,0,0,0,0,0.00
989,3601.44,0,0,0,0,0.00
1039,3646.97,0,0,0,0,0.00
1089,3599.71,0,0,0,0,0.00
1139,3638.13,0,0,0,0,0.00
1189,3619.69,0,0,0,0,0.00
1239,3629.32,0,0,0,0,0.00
1289,3619.69,0,0,0,0,0.00
1339,3647.86,0,0,0,0,0.00
1389,3601.44,0,0,0,0,0.00
1439,3638.13,0,0,0,0,0.00
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
1589,3637.25,0,0,0,0,0.00
1639,3665.69,0,0,0,0,0.00
1689,3629.32,0,0,0,0,0.00
1739,3677.37,0,0,0,0,0.00
1789,3639.01,0,0,0,0,0.00
1839,3686.41,0,0,0,0,0.00
1889,3657.64,0,0,0,0,0.00
1939,3685.50,0,0,0,0,0.00
1989,3666.59,0,0,0,0,0.00
2039,3637.25,0,0,0,0,0.00
2089,3686.41,0,0,0,0,0.00
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
