december454/Microcontroller-Engine-Governor/Data-Logging/3-9-2023/3-9-2023 - PID Tuning Initial - Kd 01 - V109 - Calc Int 1.txt

------ Microcontroller Engine Governor - Version: 1.09 ------
-------------------------------------------------------------
PID Gains:        Kp: 0.100000   Ki: 0.000000   Kd: 10.000000
-------------------------------------------------------------
Set RPM:             3600    |  Min RPM:                300
                             |
RPM Precision        2       |  PID I Precision:         22
                             |
Start Steps:         900     |  Max Steps:               1200
                             |
RPM Calc Interval:   1       |  Num Magnets:             1
                             |
LCD Update Interval: 400     |  Serial Update Interval:  50
-------------------------------------------------------------

Time,RPM,Steps Remaining, PID p, PID i, PID d
87,0.00,0,0,0,0
137,0.00,0,0,0,0
187,0.00,0,0,0,0
237,0.00,0,0,0,0
287,0.00,0,0,0,0
337,0.00,0,0,0,0
387,0.00,0,0,0,0
437,0.00,0,0,0,0
487,0.00,0,0,0,0
537,0.00,0,0,0,0
587,0.00,0,0,0,0
637,0.00,0,0,0,0
687,0.00,0,0,0,0
737,0.00,0,0,0,0
787,0.00,0,0,0,0
837,0.00,0,0,0,0
887,0.00,0,0,0,0
937,0.00,0,0,0,0
987,0.00,0,0,0,0
1037,0.00,0,0,0,0
1087,0.00,0,0,0,0
1137,0.00,0,0,0,0
1187,0.00,0,0,0,0
1238,0.00,0,0,0,0
1288,0.00,0,0,0,0
1338,0.00,0,0,0,0
1388,0.00,0,0,0,0
1438,0.00,0,0,0,0
1488,0.00,0,0,0,0
1538,0.00,0,0,0,0
1588,0.00,0,0,0,0
1638,0.00,0,0,0,0
1688,0.00,0,0,0,0
1738,0.00,0,0,0,0
1788,0.00,0,0,0,0
1838,0.00,0,0,0,0
1888,0.00,0,0,0,0
1938,0.00,0,0,0,0
1988,0.00,0,0,0,0
2038,0.00,0,0,0,0
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
6285,inf,0,0,0,0
6335,inf,0,0,0,0
6385,inf,0,0,0,0
6435,422.54,-296,317,0,0
6486,1016.95,-245,258,0,-100
6536,1052.63,-248,254,0,-6
6586,1304.35,-219,229,0,-54
6636,1333.33,-211,226,0,-6
6686,1578.95,-175,202,0,-64
6736,1818.18,-171,178,0,-59
6786,1875.00,-147,172,0,-17
6836,2142.86,-128,145,0,-51
6886,2307.69,-115,129,0,-32
6936,2500.00,-94,110,0,0
6986,3000.00,-59,60,0,-129
7036,3157.89,-33,44,0,-226
7086,3333.33,-22,26,0,0
7136,3333.33,-23,26,0,108
7186,3529.41,-3,7,0,276
7236,4000.00,-32,-40,0,-166
7286,4000.00,-26,-40,0,0
7336,4615.38,-94,-101,0,-253
7386,4615.38,-100,-101,0,-253
7436,4000.00,-30,-40,0,410
7486,5000.00,-133,-140,0,-833
7536,5000.00,-136,-140,0,-833
7586,5000.00,-139,-140,0,-595
7636,4285.71,-57,-68,0,510
7686,4000.00,-36,-40,0,190
7736,3750.00,-2,-15,0,540
7786,4285.71,-62,-68,0,-204
7836,4285.71,-56,-68,0,-382
7887,4000.00,-38,-40,0,190
7937,4000.00,-34,-40,0,0
7987,3529.41,0,7,0,276
8037,3750.00,-5,-15,0,-137
8087,3333.33,-15,26,0,231
8137,3529.41,0,7,0,0
8187,3529.41,0,7,0,-115
8237,3157.89,-42,44,0,92
8287,3529.41,0,7,0,-108
8337,3000.00,-50,60,0,175
8387,3157.89,-41,44,0,0
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
