december454/Microcontroller-Engine-Governor/Data-Logging/3-9-2023/3-9-2023 - PID Tuning Initial - Kd 01 - V109.txt

------ Microcontroller Engine Governor - Version: 1.09 ------
-------------------------------------------------------------
PID Gains:        Kp: 0.100000   Ki: 0.000000   Kd: 0.010000
-------------------------------------------------------------
Set RPM:             3600    |  Min RPM:                300
                             |
RPM Precision        2       |  PID I Precision:         22
                             |
Start Steps:         900     |  Max Steps:               1200
                             |
RPM Calc Interval:   8       |  Num Magnets:             1
                             |
LCD Update Interval: 400     |  Serial Update Interval:  100
-------------------------------------------------------------

Time,RPM,Steps Remaining, PID p, PID i, PID d
113,0.00,0,0,0,0
214,0.00,0,0,0,0
314,0.00,0,0,0,0
414,0.00,0,0,0,0
514,0.00,0,0,0,0
614,0.00,0,0,0,0
714,0.00,0,0,0,0
814,0.00,0,0,0,0
914,0.00,0,0,0,0
1014,0.00,0,0,0,0
2775,0.00,0,0,0,0
2875,0.00,0,0,0,0
2975,0.00,0,0,0,0
3075,0.00,0,0,0,0
3175,0.00,0,0,0,0
3275,0.00,0,0,0,0
3375,0.00,0,0,0,0
3475,0.00,0,0,0,0
3575,0.00,0,0,0,0
3675,0.00,0,0,0,0
3775,0.00,0,0,0,0
3875,0.00,0,0,0,0
3975,0.00,0,0,0,0
4075,0.00,0,0,0,0
4175,0.00,0,0,0,0
4275,0.00,0,0,0,0
4375,0.00,0,0,0,0
4475,0.00,0,0,0,0
4575,0.00,0,0,0,0
4675,0.00,0,0,0,0
4775,0.00,0,0,0,0
4875,0.00,0,0,0,0
4975,0.00,0,0,0,0
5075,0.00,0,0,0,0
5175,0.00,0,0,0,0
5275,0.00,0,0,0,0
5376,0.00,0,0,0,0
5476,0.00,0,0,0,0
5576,0.00,0,0,0,0
5676,0.00,0,0,0,0
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
6776,inf,0,0,0,0
6876,inf,0,0,0,0
8657,3350.73,-23,24,0,0
8757,3350.73,0,24,0,0
8857,4571.43,0,-97,0,0
8957,4033.61,0,-43,0,0
9057,3779.53,0,-17,0,0
9157,3555.56,0,4,0,0
9257,3555.56,0,4,0,0
9357,3356.64,0,24,0,0
9457,3076.92,-34,52,0,0
9558,3076.92,0,52,0,0
9658,2874.25,-20,72,0,0
9758,2874.25,0,72,0,0
9858,2742.86,-8,85,0,0
9958,2742.86,0,85,0,0
10058,2651.93,0,94,0,0
10158,2727.27,-69,87,0,0
10258,2727.27,0,87,0,0
10358,2944.79,-8,65,0,0
10458,3243.24,-27,35,0,0
10558,3243.24,0,35,0,0
10658,3529.41,0,7,0,0
10758,3779.53,0,-17,0,0
10858,4033.61,-17,-43,0,0
10958,4067.80,-38,-46,0,0
11058,4067.80,0,-46,0,0
11158,4102.56,0,-50,0,0
11258,4000.00,0,-40,0,0
11358,3902.44,0,-30,0,0
11458,3720.93,0,-12,0,0
11558,3720.93,0,-12,0,0
11658,3555.56,0,4,0,0
11758,3428.57,0,17,0,0
11858,3428.57,0,17,0,0
11958,3356.64,0,24,0,0
12058,3287.67,0,31,0,0
12158,3356.64,-14,24,0,0
12258,3356.64,0,24,0,0
12358,3428.57,0,17,0,0
12459,3609.02,0,0,0,0
12559,3692.31,-1,-9,0,0
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
