december454/Microcontroller-Engine-Governor/Data-Logging/3-9-2023/3-9-2023 - PID Tuning Initial - Kd 10 - V109.txt

------ Microcontroller Engine Governor - Version: 1.09 ------
-------------------------------------------------------------
PID Gains:        Kp: 0.100000   Ki: 0.000000   Kd: 10.000000
-------------------------------------------------------------
Set RPM:             3600    |  Min RPM:                300
                             |
RPM Precision        2       |  PID I Precision:         22
                             |
Start Steps:         900     |  Max Steps:               1200
                             |
RPM Calc Interval:   8       |  Num Magnets:             1
                             |
LCD Update Interval: 400     |  Serial Update Interval:  100
-------------------------------------------------------------

Time,RPM,Steps Remaining, PID p, PID i, PID d
113,0.00,0,0,0,0
214,0.00,0,0,0,0
314,0.00,0,0,0,0
414,0.00,0,0,0,0
514,0.00,0,0,0,0
614,0.00,0,0,0,0
714,0.00,0,0,0,0
814,0.00,0,0,0,0
2359,0.00,0,0,0,0
2459,0.00,0,0,0,0
2560,0.00,0,0,0,0
2660,0.00,0,0,0,0
2760,0.00,0,0,0,0
2860,0.00,0,0,0,0
2960,0.00,0,0,0,0
3060,0.00,0,0,0,0
3160,0.00,0,0,0,0
3260,0.00,0,0,0,0
3360,0.00,0,0,0,0
3460,0.00,0,0,0,0
3560,0.00,0,0,0,0
3660,0.00,0,0,0,0
3760,0.00,0,0,0,0
3860,0.00,0,0,0,0
3960,inf,0,0,0,0
4060,inf,0,0,0,0
5813,3647.80,-3,-4,0,0
5913,3647.80,0,-4,0,0
6013,4615.38,-1,-101,0,-93
6113,4000.00,0,-40,0,51
6213,3779.53,0,-17,0,17
6313,3555.56,0,4,0,16
6413,3555.56,0,4,0,16
6513,3333.33,0,26,0,15
6614,3096.77,-33,50,0,15
6714,3096.77,0,50,0,15
6814,2857.14,-23,74,0,14
6914,2857.14,0,74,0,14
7014,2696.63,-17,90,0,9
7114,2696.63,0,90,0,9
7214,2580.65,-14,101,0,6
7314,2651.93,-89,94,0,-3
7414,2651.93,0,94,0,-3
7514,2891.57,-31,70,0,-14
7614,2891.57,0,70,0,-14
7714,3200.00,0,40,0,-20
7814,3529.41,0,7,0,-24
7914,3779.53,0,-17,0,-19
8014,3966.94,-32,-36,0,-15
8114,3966.94,0,-36,0,-15
8214,4067.80,0,-46,0,-8
8314,4067.80,0,-46,0,0
8414,3966.94,0,-36,0,8
8514,3870.97,-3,-27,0,7
8614,3870.97,0,-27,0,7
8714,3750.00,0,-15,0,9
8814,3636.36,0,-3,0,8
8914,3503.65,0,9,0,9
9014,3503.65,0,9,0,9
9114,3428.57,0,17,0,5
9214,3404.26,0,19,0,1
9314,3404.26,-15,19,0,0
9414,3404.26,0,19,0,0
9515,3529.41,0,7,0,-9
9615,3582.09,0,1,0,-3
9715,3636.36,0,-3,0,-4
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
