december454/Microcontroller-Engine-Governor/Data-Logging/3-9-2023/Disregard 3-9-2023 - PID Tuning Initial - Ki 0001 - V109.txt

------ Microcontroller Engine Governor - Version: 1.09 ------
-------------------------------------------------------------
PID Gains:        Kp: 0.10       Ki: 0.00       Kd: 0.00
-------------------------------------------------------------
Set RPM:             3600    |  Min RPM:                300
                             |
RPM Precision        2       |  PID I Precision:         22
                             |
Start Steps:         900     |  Max Steps:               1200
                             |
RPM Calc Interval:   8       |  Num Magnets:             1
                             |
LCD Update Interval: 400     |  Serial Update Interval:  100
-------------------------------------------------------------

Time,RPM,Steps Remaining, PID p, PID i, PID d
113,0.00,0,0,0,0
214,0.00,0,0,0,0
314,0.00,0,0,0,0
414,0.00,0,0,0,0
514,0.00,0,0,0,0
614,0.00,0,0,0,0
714,0.00,0,0,0,0
814,0.00,0,0,0,0
914,0.00,0,0,0,0
1014,0.00,0,0,0,0
1114,0.00,0,0,0,0
1214,0.00,0,0,0,0
1314,0.00,0,0,0,0
1414,0.00,0,0,0,0
1514,0.00,0,0,0,0
1614,0.00,0,0,0,0
1714,0.00,0,0,0,0
1814,0.00,0,0,0,0
1914,0.00,0,0,0,0
2014,0.00,0,0,0,0
2114,0.00,0,0,0,0
2214,0.00,0,0,0,0
2314,0.00,0,0,0,0
2414,0.00,0,0,0,0
2514,0.00,0,0,0,0
2614,0.00,0,0,0,0
2714,0.00,0,0,0,0
2814,0.00,0,0,0,0
2914,0.00,0,0,0,0
3014,0.00,0,0,0,0
3115,0.00,0,0,0,0
3215,0.00,0,0,0,0
3315,0.00,0,0,0,0
3415,0.00,0,0,0,0
3515,0.00,0,0,0,0
3615,0.00,0,0,0,0
3715,0.00,0,0,0,0
3815,0.00,0,0,0,0
3915,0.00,0,0,0,0
4015,0.00,0,0,0,0
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
8772,inf,0,0,0,0
8872,inf,0,0,0,0
10693,3571.43,-1,2,0,0
10793,3571.43,0,2,0,0
10893,4485.98,0,-88,0,0
10993,4102.56,0,-50,0,0
11094,3840.00,0,-24,0,0
11194,3609.02,0,0,0,0
11294,3609.02,0,0,0,0
11394,3404.26,0,19,0,0
11494,3200.00,-10,40,0,0
11594,3200.00,0,40,0,0
11694,2962.96,0,63,0,0
11794,2962.96,0,63,0,0
11894,2758.62,0,84,0,0
11994,2608.70,-89,99,0,0
12094,2608.70,0,99,0,0
12194,2553.19,-81,104,0,0
12294,2553.19,0,104,0,0
12394,2758.62,-36,84,0,0
12494,2758.62,0,84,0,0
12594,3037.97,0,56,0,0
12694,3380.28,0,21,0,0
12794,3664.12,0,-6,0,0
12894,3664.12,0,-6,0,0
12994,3902.44,0,-30,0,0
13094,4067.80,0,-46,0,0
13194,4067.80,0,-46,0,0
13294,4000.00,-3,-40,0,0
13394,3902.44,-16,-30,0,0
13494,3902.44,0,-30,0,0
13594,3809.52,0,-20,0,0
13694,3692.31,0,-9,0,0
13794,3609.02,0,0,0,0
13894,3609.02,0,0,0,0
13995,3478.26,0,12,0,0
14095,3404.26,0,19,0,0
14195,3478.26,-3,12,0,0
14295,3478.26,0,12,0,0
14395,3529.41,0,7,0,0
14495,3555.56,0,4,0,0
14595,3636.36,0,-3,0,0
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
