december454/Microcontroller-Engine-Governor/Data-Logging/3-9-2023/GovernorOutputTest.txt

Time,RPM,Steps Remaining, PID p, PID i, PID d
100,0.00,0,0,0,0
200,inf,0,0,0,0
300,504.20,0,-4,0,0
400,504.20,0,-4,0,0
500,504.20,0,-4,0,0
600,504.20,0,-4,0,0
700,504.20,0,-4,0,0
800,504.20,0,-4,0,0
900,504.20,0,-4,0,0
1000,500.00,0,-4,0,0
1100,504.20,0,-4,0,0
1200,500.00,0,-4,0,0
1300,500.00,0,-4,0,0
1400,500.00,0,-4,0,0
1500,500.00,0,-4,0,0
1600,500.00,0,-4,0,0
1700,504.20,0,-4,0,0
1800,500.00,0,-4,0,0
1900,500.00,0,-4,0,0
2000,495.87,0,4,0,0
2100,500.00,0,4,0,0
2200,500.00,0,4,0,0
2300,500.00,0,4,0,0
2400,504.20,0,-4,0,0
2500,504.20,0,-4,0,0
2600,500.00,0,-4,0,0
2700,500.00,0,-4,0,0
2800,500.00,0,-4,0,0
2900,504.20,0,-4,0,0
3000,504.20,0,-4,0,0
3100,500.00,0,-4,0,0
3200,500.00,0,-4,0,0
3300,500.00,0,-4,0,0
3400,504.20,0,-4,0,0
3500,504.20,0,-4,0,0
3600,504.20,0,-4,0,0
3700,500.00,0,-4,0,0
3800,500.00,0,-4,0,0
3900,500.00,0,-4,0,0
4000,500.00,0,-4,0,0
4100,504.20,0,-4,0,0
4200,504.20,0,-4,0,0
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
