december454/Microcontroller-Engine-Governor/Data-Logging/3-9-2023/Test 5.txt

------ Microcontroller Engine Governor - Version: 1.09 ------
-------------------------------------------------------------
PID Gains:        Kp: 0.007000   Ki: 0.000000   Kd: 1.000000
-------------------------------------------------------------
Set RPM:             3600    |  Min RPM:                300
                             |
RPM Precision        2       |  PID I Precision:         22
                             |
Start Steps:         900     |  Max Steps:               1200
                             |
RPM Calc Interval:   1       |  Num Magnets:             1
                             |
LCD Update Interval: 400     |  Serial Update Interval:  50
-------------------------------------------------------------

Time,RPM,Steps Remaining, PID p, PID i, PID d
87,0.00,0,0,0,0
137,0.00,0,0,0,0
187,0.00,0,0,0,0
237,0.00,0,0,0,0
287,0.00,0,0,0,0
337,0.00,0,0,0,0
387,0.00,0,0,0,0
437,0.00,0,0,0,0
487,0.00,0,0,0,0
537,0.00,0,0,0,0
587,0.00,0,0,0,0
637,0.00,0,0,0,0
687,0.00,0,0,0,0
737,0.00,0,0,0,0
787,0.00,0,0,0,0
837,0.00,0,0,0,0
887,0.00,0,0,0,0
937,0.00,0,0,0,0
987,0.00,0,0,0,0
1037,0.00,0,0,0,0
1087,0.00,0,0,0,0
1137,0.00,0,0,0,0
1187,0.00,0,0,0,0
1238,0.00,0,0,0,0
1288,0.00,0,0,0,0
1338,0.00,0,0,0,0
1388,0.00,0,0,0,0
1438,0.00,0,0,0,0
1488,0.00,0,0,0,0
1538,0.00,0,0,0,0
1588,0.00,0,0,0,0
1638,0.00,0,0,0,0
1688,0.00,0,0,0,0
1738,0.00,0,0,0,0
1788,0.00,0,0,0,0
1838,0.00,0,0,0,0
1888,0.00,0,0,0,0
1938,0.00,0,0,0,0
1988,0.00,0,0,0,0
2038,0.00,0,0,0,0
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
6038,inf,0,0,0,0
6088,845.07,0,19,0,0
6138,845.07,0,19,0,0
6188,845.07,0,19,0,0
6238,1071.43,0,17,0,-4
6288,1090.91,0,17,0,0
6338,1304.35,0,16,0,-4
6388,1500.00,5,14,0,-4
6438,1500.00,0,14,0,0
6488,1666.67,0,13,0,-4
6538,1935.48,0,11,0,-8
6588,1875.00,0,12,0,1
6638,2068.97,0,10,0,-4
6688,2142.86,0,10,0,0
6738,2307.69,0,9,0,0
6788,2400.00,0,8,0,0
6838,2608.70,0,6,0,-4
6888,2500.00,0,7,0,4
6938,3000.00,-10,4,0,-18
6988,3000.00,0,4,0,-13
7038,3157.89,-11,3,0,-15
7088,3157.89,0,3,0,-8
7138,3157.89,0,3,0,0
7189,3529.41,-19,0,0,-20
7239,3333.33,0,1,0,10
7289,3529.41,0,0,0,-11
7339,3529.41,0,0,0,0
7389,3529.41,2,0,0,12
7439,3333.33,15,1,0,24
7489,3529.41,15,0,0,26
7539,4000.00,-34,-2,0,-44
7589,3750.00,-1,-1,0,-13
7639,3750.00,-1,-1,0,-13
7689,3750.00,0,-1,0,0
7739,3529.41,0,0,0,12
7789,4000.00,-45,-2,0,-44
7839,3750.00,0,-1,0,0
7889,3750.00,0,-1,0,0
7939,3750.00,0,-1,0,0
7989,3750.00,0,-1,0,0
8039,3750.00,-4,-1,0,-13
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
