december454/Microcontroller-Engine-Governor/Data-Logging/3-9-2023/Test6.txt

------ Microcontroller Engine Governor - Version: 1.09 ------
-------------------------------------------------------------
PID Gains:        Kp: 0.008000   Ki: 0.000000   Kd: 1.000000
-------------------------------------------------------------
Set RPM:             3600    |  Min RPM:                300
                             |
RPM Precision        2       |  PID I Precision:         22
                             |
Start Steps:         900     |  Max Steps:               1200
                             |
RPM Calc Interval:   1       |  Num Magnets:             1
                             |
LCD Update Interval: 400     |  Serial Update Interval:  50
-------------------------------------------------------------

Time,RPM,Steps Remaining, PID p, PID i, PID d
87,0.00,0,0,0,0
137,0.00,0,0,0,0
187,0.00,0,0,0,0
237,0.00,0,0,0,0
287,0.00,0,0,0,0
337,0.00,0,0,0,0
387,0.00,0,0,0,0
437,0.00,0,0,0,0
487,0.00,0,0,0,0
537,0.00,0,0,0,0
587,0.00,0,0,0,0
637,0.00,0,0,0,0
687,0.00,0,0,0,0
737,0.00,0,0,0,0
787,0.00,0,0,0,0
837,0.00,0,0,0,0
887,0.00,0,0,0,0
937,0.00,0,0,0,0
987,0.00,0,0,0,0
1037,0.00,0,0,0,0
1087,0.00,0,0,0,0
1137,0.00,0,0,0,0
1187,0.00,0,0,0,0
1238,0.00,0,0,0,0
1288,0.00,0,0,0,0
1338,0.00,0,0,0,0
1388,0.00,0,0,0,0
1438,0.00,0,0,0,0
3013,0.00,0,0,0,0
3063,0.00,0,0,0,0
3113,0.00,0,0,0,0
3163,0.00,0,0,0,0
3213,0.00,0,0,0,0
3263,0.00,0,0,0,0
3313,0.00,0,0,0,0
3363,0.00,0,0,0,0
3414,0.00,0,0,0,0
3464,0.00,0,0,0,0
3514,0.00,0,0,0,0
3564,0.00,0,0,0,0
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
10216,inf,0,0,0,0
10266,inf,0,0,0,0
10316,inf,0,0,0,0
10366,500.00,0,24,0,0
10416,500.00,0,24,0,0
10466,659.34,0,23,0,-1
10516,1016.95,0,20,0,-6
10566,1016.95,0,20,0,0
10616,1250.00,0,18,0,-4
10667,1276.60,0,18,0,0
10717,1500.00,10,16,0,0
10767,1764.71,0,14,0,-7
10817,1875.00,3,13,0,-5
10867,1875.00,0,13,0,0
10917,2068.97,0,12,0,0
10967,2307.69,0,10,0,-6
11017,2307.69,1,10,0,0
11068,2400.00,5,9,0,4
11118,2608.70,0,7,0,0
11168,2608.70,0,7,0,5
11218,3000.00,-2,4,0,-13
11268,3000.00,0,4,0,-7
11318,3000.00,4,4,0,7
11368,3157.89,2,3,0,0
11418,3333.33,0,2,0,0
11468,3529.41,0,0,0,-11
11518,3529.41,-1,0,0,-11
11568,3333.33,17,2,0,23
11618,3750.00,-5,-1,0,-13
11668,3529.41,2,0,0,12
11718,3750.00,-2,-1,0,-13
11768,3750.00,-1,-1,0,-13
11819,4000.00,-16,-3,0,-29
11869,3750.00,12,-1,0,15
11919,3529.41,23,0,0,27
11969,4000.00,-25,-3,0,-29
12019,3750.00,0,-1,0,0
12069,4000.00,-36,-3,0,-44
12119,3750.00,-2,-1,0,-13
12169,3750.00,0,-1,0,0
12219,3333.33,25,2,0,39
12269,3529.41,27,0,0,44
12319,3529.41,0,0,0,0
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
