december454/Microcontroller-Engine-Governor/Data-Logging/3-24-2023/3-24-2023 - PID Tuning - (I 003).txt

------ Microcontroller Engine Governor - Version: 1.13 ------
-------------------------------------------------------------
PID Gains:        Kp: 0.010000   Ki: 0.003000   Kd: 3.000000
-------------------------------------------------------------
Set RPM:             3600    |  Min RPM:                300
                             |
RPM Precision        2       |  PID I Precision:         202
                             |
Start Steps:         900     |  Max Steps:               1200
                             |
RPM Calc Interval:   1       |  Num Magnets:             1
                             |
LCD Update Interval: 400     |  Serial Update Interval:  50
-------------------------------------------------------------

Time,RPM,Steps Remaining, PID p, PID i, PID d
87,inf,0,0,0,0
137,3570.58,0,0,0,0
187,3568.03,0,0,0,0
237,3576.54,0,0,0,0
287,3604.90,0,0,0,0
337,3591.95,0,0,0,0
387,3605.77,0,0,0,0
437,3580.81,0,0,0,0
487,3586.80,0,0,0,0
537,3581.66,0,0,0,0
587,3624.06,0,0,0,0
637,3550.30,0,0,0,0
687,3585.09,0,0,0,0
737,3558.72,0,0,0,0
787,3577.39,0,0,0,0
837,3587.66,0,0,0,0
887,3553.66,0,0,0,0
937,3579.10,0,0,0,0
987,3526.92,0,0,0,0
1037,3573.13,0,0,0,0
1087,3518.65,0,0,0,0
1137,3574.83,0,0,0,0
1187,3546.10,0,0,0,0
1238,3541.91,0,0,0,0
1288,3518.65,0,0,0,0
1338,3556.19,0,0,0,0
1388,3538.57,0,0,0,0
1438,3593.67,0,0,0,0
1488,3564.64,0,0,0,0
1538,3593.67,0,0,0,0
1588,3588.52,0,0,0,0
1638,3606.64,0,0,0,0
1688,3563.79,0,0,0,0
1738,3610.98,0,0,0,0
1788,3538.57,0,0,0,0
1838,3564.64,0,0,0,0
1888,3556.19,0,0,0,0
1938,3564.64,0,0,0,0
1988,3509.59,0,0,0,0
2038,3509.59,0,0,0,0
2088,3563.79,0,0,0,0
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
