december454/Microcontroller-Engine-Governor/Data-Logging/3-24-2023/3-24-2023 - Tuning - RPM Precision 30 2.txt

------ Microcontroller Engine Governor - Version: 1.13 ------
-------------------------------------------------------------
PID Gains:        Kp: 0.010000   Ki: 0.000000   Kd: 3.000000
-------------------------------------------------------------
Set RPM:             3600    |  Min RPM:                300
                             |
RPM Precision        30       |  PID I Precision:         50
                             |
Start Steps:         900     |  Max Steps:               1200
                             |
RPM Calc Interval:   1       |  Num Magnets:             1
                             |
LCD Update Interval: 400     |  Serial Update Interval:  50
-------------------------------------------------------------

Time,RPM,Steps Remaining, PID p, PID i, PID d
87,inf,0,0,0,0
137,3628.45,0,0,0,0
187,3623.19,0,0,0,0
237,3592.81,0,0,0,0
287,3637.25,0,0,0,0
337,3628.45,0,0,0,0
387,3610.98,0,0,0,0
437,3607.50,0,0,0,0
487,3677.37,0,0,0,0
537,3656.75,0,0,0,0
587,3669.28,0,0,0,0
637,3657.64,0,0,0,0
687,3662.11,0,0,0,0
737,3592.81,0,0,0,0
787,3562.10,0,0,0,0
837,3570.58,0,0,0,0
887,3629.32,0,0,0,0
937,3600.58,0,0,0,0
987,3638.13,0,0,0,0
1037,3577.39,0,0,0,0
1087,3599.71,0,0,0,0
1137,3599.71,0,0,0,0
1187,3645.20,0,0,0,0
1238,3610.11,0,0,0,0
1288,3638.13,0,0,0,0
1338,3627.57,0,0,0,0
1388,3645.20,0,0,0,0
1438,3610.11,0,0,0,0
1488,3638.13,0,0,0,0
1538,3638.13,0,0,0,0
1588,3629.32,0,0,0,0
1638,3579.95,0,0,0,0
1688,3661.22,0,0,0,0
1738,3585.09,0,0,0,0
1788,3653.19,0,0,0,0
1838,3638.13,0,0,0,0
1888,3629.32,0,0,0,0
1938,3628.45,0,0,0,0
1988,3653.19,0,0,0,0
2038,3597.98,0,0,0,0
2088,3656.75,0,0,0,0
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
