december454/Microcontroller-Engine-Governor/Data-Logging/3-24-2023/3-24-2023 - Tuning - RPM Precision 50.txt

------ Microcontroller Engine Governor - Version: 1.13 ------
-------------------------------------------------------------
PID Gains:        Kp: 0.010000   Ki: 0.000000   Kd: 3.000000
-------------------------------------------------------------
Set RPM:             3600    |  Min RPM:                300
                             |
RPM Precision        50       |  PID I Precision:         70
                             |
Start Steps:         900     |  Max Steps:               1200
                             |
RPM Calc Interval:   1       |  Num Magnets:             1
                             |
LCD Update Interval: 400     |  Serial Update Interval:  50
-------------------------------------------------------------

Time,RPM,Steps Remaining, PID p, PID i, PID d
87,inf,0,0,0,0
137,3578.24,0,0,0,0
187,3622.31,0,0,0,0
237,3576.54,0,0,0,0
287,3643.43,0,0,0,0
337,3585.09,0,0,0,0
387,3605.77,0,0,0,0
437,3668.38,0,0,0,0
487,3607.50,0,0,0,0
537,3592.81,0,0,0,0
587,3622.31,0,0,0,0
637,3561.25,0,0,0,0
687,3620.56,0,0,0,0
737,3553.66,0,0,0,0
787,3629.32,0,0,0,0
837,3600.58,0,0,0,0
887,3606.64,0,0,0,0
937,3607.50,0,0,0,0
987,3661.22,0,0,0,0
1037,3615.33,0,0,0,0
1087,3653.19,0,0,0,0
1137,3619.69,0,0,0,0
1187,3622.31,0,0,0,0
1238,3603.17,0,0,0,0
1288,3590.23,0,0,0,0
1338,3554.50,0,0,0,0
1388,3607.50,0,0,0,0
1438,3585.94,0,0,0,0
1488,3607.50,0,0,0,0
1538,3575.69,0,0,0,0
1588,3612.72,0,0,0,0
1638,3604.04,0,0,0,0
1688,3645.20,0,0,0,0
1738,3614.46,0,0,0,0
1788,3637.25,0,0,0,0
1838,3615.33,0,0,0,0
1888,3614.46,0,0,0,0
1938,3599.71,0,0,0,0
1988,3636.36,0,0,0,0
2038,3629.32,0,0,0,0
2088,3677.37,0,0,0,0
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
