december454/Microcontroller-Engine-Governor/Data-Logging/3-24-2023/3-24-2023 - Tuning - RPM Precision 70.txt

------ Microcontroller Engine Governor - Version: 1.13 ------
-------------------------------------------------------------
PID Gains:        Kp: 0.010000   Ki: 0.000000   Kd: 3.000000
-------------------------------------------------------------
Set RPM:             3600    |  Min RPM:                300
                             |
RPM Precision        70       |  PID I Precision:         90
                             |
Start Steps:         900     |  Max Steps:               1200
                             |
RPM Calc Interval:   1       |  Num Magnets:             1
                             |
LCD Update Interval: 400     |  Serial Update Interval:  50
-------------------------------------------------------------

Time,RPM,Steps Remaining, PID p, PID i, PID d
87,inf,0,0,0,0
137,3622.31,0,0,0,0
187,3608.37,0,0,0,0
237,3629.32,0,0,0,0
287,3623.19,0,0,0,0
337,3652.30,0,0,0,0
387,3623.19,0,0,0,0
437,3677.37,0,0,0,0
487,3568.88,0,0,0,0
537,3577.39,0,0,0,0
587,3576.54,0,0,0,0
637,3614.46,0,0,0,0
687,3585.09,0,0,0,0
737,3606.64,0,0,0,0
787,3561.25,0,0,0,0
837,3683.69,0,0,0,0
887,3547.78,0,0,0,0
937,3575.69,0,0,0,0
987,3547.78,0,0,0,0
1037,3547.78,0,0,0,0
1087,3545.26,0,0,0,0
1137,3548.62,0,0,0,0
1187,3605.77,0,0,0,0
1238,3581.66,0,0,0,0
1288,3606.64,0,0,0,0
1338,3576.54,0,0,0,0
1388,3629.32,0,0,0,0
1438,3607.50,0,0,0,0
1488,3644.31,0,0,0,0
1538,3623.19,0,0,0,0
1588,3639.01,0,0,0,0
1638,3572.28,0,0,0,0
1688,3638.13,0,0,0,0
1738,3668.38,0,0,0,0
1788,3608.37,0,0,0,0
1838,3654.08,0,0,0,0
1888,3599.71,0,0,0,0
1938,3630.20,0,0,0,0
1988,3598.85,0,0,0,0
2038,3615.33,0,0,0,0
2088,3576.54,0,0,0,0
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
