december454/Microcontroller-Engine-Governor/Data-Logging/3-20-2023/3-20-2023 - Load Test (15A Chop Saw - Rigid CM14500) - Dynamic D Gain Improved .txt

Time	RPM	Steps Remaining	 PID p	 PID i	 PID d
1766	0	0	0	0	0
1816	0	0	0	0	0
1866	0	0	0	0	0
1916	0	0	0	0	0
1966	0	0	0	0	0
2016	0	0	0	0	0
2066	0	0	0	0	0
2116	0	0	0	0	0
2166	0	0	0	0	0
2216	0	0	0	0	0
2266	0	0	0	0	0
2316	0	0	0	0	0
2366	0	0	0	0	0
2416	0	0	0	0	0
2466	0	0	0	0	0
2516	0	0	0	0	0
2566	inf	0	0	0	0
2616	inf	0	0	0	0
2666	515.55	0	30	0	0
2716	515.55	0	30	0	0
2766	643.17	0	29	0	-4
2816	1030.29	0	25	0	-19
2866	1012.15	6	25	0	0
2916	1249.58	0	23	0	-14
2966	1252.09	0	23	0	0
3016	1487.21	0	21	0	-18
3066	1710.96	0	18	0	-18
3116	1715.85	0	18	0	0
3166	1901.62	8	16	0	0
3216	2073.54	14	15	0	0
3266	2223.54	0	13	0	-16
3316	2347.42	0	12	0	-14
3366	2468.32	0	11	0	-14
3416	2590.67	0	10	0	-15
3466	2687.21	11	9	0	7
3516	2791.22	0	8	0	1
3566	2872.46	0	7	0	2
3616	3026.02	6	5	0	11
3666	3078.19	5	5	0	1
3716	3154.57	0	4	0	2
3766	3288.03	0	3	0	-10
3816	3326.68	0	2	0	1
3866	3367.76	0	2	0	1
3916	3477.86	0	1	0	0
3966	3460.21	0	1	0	0
4016	3557.03	0	0	0	0
4066	3569.73	0	0	0	0
4116	3646.09	0	0	0	0
4166	3646.97	0	0	0	0
4216	3742.51	0	-1	0	0
4267	3700.05	0	-1	0	0
4317	3761.28	0	-1	0	0
4367	4025.76	-90	-4	0	-88
4417	3777.39	0	-1	0	0
4467	3782.15	0	-1	0	0
4517	3760.34	0	-1	0	0
4567	3760.34	0	-1	0	0
4617	3731.34	0	-1	0	0
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
