december454/Microcontroller-Engine-Governor/Data-Logging/3-10-2023/3-10-2023 - PID Tuning - D 10 (MICROS).txt

------ Microcontroller Engine Governor - Version: 1.11 ------
-------------------------------------------------------------
PID Gains:        Kp: 0.010000   Ki: 0.000000   Kd: 10.000000
-------------------------------------------------------------
Set RPM:             3600    |  Min RPM:                300
                             |
RPM Precision        2       |  PID I Precision:         22
                             |
Start Steps:         900     |  Max Steps:               1200
                             |
RPM Calc Interval:   1       |  Num Magnets:             1
                             |
LCD Update Interval: 400     |  Serial Update Interval:  50
-------------------------------------------------------------

Time,RPM,Steps Remaining, PID p, PID i, PID d
87,0.00,0,0,0,0
137,0.00,0,0,0,0
187,0.00,0,0,0,0
237,0.00,0,0,0,0
287,0.00,0,0,0,0
337,0.00,0,0,0,0
387,0.00,0,0,0,0
437,0.00,0,0,0,0
487,0.00,0,0,0,0
537,0.00,0,0,0,0
587,0.00,0,0,0,0
637,0.00,0,0,0,0
687,0.00,0,0,0,0
737,0.00,0,0,0,0
787,0.00,0,0,0,0
837,0.00,0,0,0,0
887,0.00,0,0,0,0
937,0.00,0,0,0,0
987,0.00,0,0,0,0
1037,0.00,0,0,0,0
1087,0.00,0,0,0,0
1137,0.00,0,0,0,0
1187,0.00,0,0,0,0
1238,0.00,0,0,0,0
1288,0.00,0,0,0,0
1338,0.00,0,0,0,0
1388,0.00,0,0,0,0
2969,0.00,0,0,0,0
3019,0.00,0,0,0,0
3069,0.00,0,0,0,0
3119,0.00,0,0,0,0
3169,0.00,0,0,0,0
3219,0.00,0,0,0,0
3269,0.00,0,0,0,0
3319,0.00,0,0,0,0
3369,0.00,0,0,0,0
3419,0.00,0,0,0,0
3469,0.00,0,0,0,0
3519,0.00,0,0,0,0
3569,0.00,0,0,0,0
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
6771,inf,0,0,0,0
6821,inf,0,0,0,0
6871,528.56,13,30,0,0
6921,528.56,0,30,0,0
6971,579.69,13,30,0,-4
7021,579.69,0,30,0,-4
7071,926.15,0,26,0,-54
7121,923.19,0,26,0,0
7171,1263.16,-13,23,0,-72
7221,1257.02,0,23,0,1
7271,1478.71,16,21,0,2
7321,1617.43,0,19,0,-37
7371,1595.24,0,20,0,5
7421,1642.40,12,19,0,3
7471,1735.71,0,18,0,-26
7521,1838.24,-8,17,0,-32
7571,1834.86,0,17,0,1
7621,1928.52,7,16,0,4
7671,1995.21,17,16,0,4
7721,2059.59,0,15,0,-21
7771,2118.64,0,14,0,-26
7821,2192.66,-4,14,0,-28
7871,2248.54,-5,13,0,-23
7921,2315.53,-13,12,0,-28
7971,2362.95,-9,12,0,-22
8022,2403.46,-5,11,0,-17
8072,2412.74,3,11,0,-7
8122,2469.54,-14,11,0,-27
8172,2490.45,-2,11,0,-16
8222,2535.50,-8,10,0,-24
8272,2596.50,-14,10,0,-33
8322,2735.73,-96,8,0,-116
8372,2617.80,0,9,0,-10
8422,2573.78,23,10,0,33
8472,2634.35,53,9,0,45
8522,2617.34,0,9,0,-12
8572,2634.81,57,9,0,59
8622,2752.80,30,8,0,36
8672,2930.83,-12,6,0,-22
8722,2734.73,56,8,0,60
8772,2882.95,0,7,0,-24
8822,2735.23,64,8,0,62
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
