december454/Microcontroller-Engine-Governor/Data-Logging/3-10-2023/3-10-2023 - PID Tuning - D 3 (Dynamic Gain).txt

------ Microcontroller Engine Governor - Version: 1.11 ------
-------------------------------------------------------------
PID Gains:        Kp: 0.010000   Ki: 0.000000   Kd: 3.000000
-------------------------------------------------------------
Set RPM:             3600    |  Min RPM:                300
                             |
RPM Precision        2       |  PID I Precision:         22
                             |
Start Steps:         900     |  Max Steps:               1200
                             |
RPM Calc Interval:   1       |  Num Magnets:             1
                             |
LCD Update Interval: 400     |  Serial Update Interval:  50
-------------------------------------------------------------

Time,RPM,Steps Remaining, PID p, PID i, PID d
87,0.00,0,0,0,0
137,0.00,0,0,0,0
187,0.00,0,0,0,0
237,0.00,0,0,0,0
287,0.00,0,0,0,0
337,0.00,0,0,0,0
387,0.00,0,0,0,0
437,0.00,0,0,0,0
487,0.00,0,0,0,0
537,0.00,0,0,0,0
587,0.00,0,0,0,0
637,0.00,0,0,0,0
687,0.00,0,0,0,0
737,0.00,0,0,0,0
787,0.00,0,0,0,0
837,0.00,0,0,0,0
887,0.00,0,0,0,0
937,0.00,0,0,0,0
987,0.00,0,0,0,0
1037,0.00,0,0,0,0
1087,0.00,0,0,0,0
1137,0.00,0,0,0,0
1187,0.00,0,0,0,0
1238,0.00,0,0,0,0
1288,0.00,0,0,0,0
1338,0.00,0,0,0,0
1388,0.00,0,0,0,0
1438,0.00,0,0,0,0
1488,0.00,0,0,0,0
1538,0.00,0,0,0,0
1588,0.00,0,0,0,0
1638,0.00,0,0,0,0
1688,0.00,0,0,0,0
1738,0.00,0,0,0,0
1788,0.00,0,0,0,0
1838,0.00,0,0,0,0
1888,0.00,0,0,0,0
1938,0.00,0,0,0,0
1988,0.00,0,0,0,0
2038,0.00,0,0,0,0
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
5804,inf,0,0,0,0
5854,inf,0,0,0,0
5904,859.30,0,27,0,0
5954,863.26,9,27,0,0
6004,1115.32,0,24,0,-14
6054,1112.92,14,24,0,0
6104,1359.31,0,22,0,-16
6154,1365.37,1,22,0,0
6204,1575.96,0,20,0,-16
6254,1769.70,0,18,0,-16
6304,1776.83,0,18,0,0
6354,1949.32,0,16,0,0
6404,2102.02,6,14,0,0
6454,2245.17,7,13,0,-1
6504,2365.18,8,12,0,0
6554,2477.29,5,11,0,0
6604,2587.10,1,10,0,0
6654,2691.07,0,9,0,1
6704,2775.21,0,8,0,2
6754,2881.84,12,7,0,13
6804,3122.40,-1,4,0,-24
6854,3250.27,-26,3,0,-40
6904,3337.78,-50,2,0,-55
6955,3337.04,-14,2,0,-33
7005,3346.72,0,2,0,4
7055,3475.44,0,1,0,-8
7105,3498.13,0,1,0,1
7155,3585.94,0,0,0,-1
7205,3587.66,0,0,0,0
7255,3625.82,0,0,0,-1
7305,3639.89,0,0,0,0
7355,3686.41,0,0,0,-3
7405,3649.63,0,0,0,1
7455,3690.04,0,0,0,-2
7505,3773.58,-13,-1,0,-24
7555,3758.46,0,-1,0,-1
7605,3722.08,0,-1,0,4
7655,3753.75,0,-1,0,-5
7705,3741.58,-32,-1,0,-32
7755,3555.34,13,0,0,15
7805,3658.54,0,0,0,4
7855,3620.56,0,0,0,0
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
