december454/Microcontroller-Engine-Governor/Data-Logging/3-10-2023/3-10-2023 - PID Tuning - D 3 (MICROS).txt

------ Microcontroller Engine Governor - Version: 1.11 ------
-------------------------------------------------------------
PID Gains:        Kp: 0.010000   Ki: 0.000000   Kd: 3.000000
-------------------------------------------------------------
Set RPM:             3600    |  Min RPM:                300
                             |
RPM Precision        2       |  PID I Precision:         22
                             |
Start Steps:         900     |  Max Steps:               1200
                             |
RPM Calc Interval:   1       |  Num Magnets:             1
                             |
LCD Update Interval: 400     |  Serial Update Interval:  50
-------------------------------------------------------------

Time,RPM,Steps Remaining, PID p, PID i, PID d
87,0.00,0,0,0,0
137,0.00,0,0,0,0
187,0.00,0,0,0,0
237,0.00,0,0,0,0
287,0.00,0,0,0,0
337,0.00,0,0,0,0
387,0.00,0,0,0,0
437,0.00,0,0,0,0
487,0.00,0,0,0,0
537,0.00,0,0,0,0
587,0.00,0,0,0,0
637,0.00,0,0,0,0
687,0.00,0,0,0,0
737,0.00,0,0,0,0
787,0.00,0,0,0,0
837,0.00,0,0,0,0
887,0.00,0,0,0,0
937,0.00,0,0,0,0
987,0.00,0,0,0,0
1037,0.00,0,0,0,0
1087,0.00,0,0,0,0
1137,0.00,0,0,0,0
1187,0.00,0,0,0,0
1238,0.00,0,0,0,0
1288,0.00,0,0,0,0
1338,0.00,0,0,0,0
1388,0.00,0,0,0,0
1438,0.00,0,0,0,0
1488,0.00,0,0,0,0
1538,0.00,0,0,0,0
1588,0.00,0,0,0,0
1638,0.00,0,0,0,0
1688,0.00,0,0,0,0
1738,0.00,0,0,0,0
1788,0.00,0,0,0,0
1838,0.00,0,0,0,0
1888,0.00,0,0,0,0
1938,0.00,0,0,0,0
1988,0.00,0,0,0,0
2038,0.00,0,0,0,0
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
6214,inf,0,0,0,0
6264,inf,0,0,0,0
6315,inf,0,0,0,0
6365,474.52,0,31,0,0
6415,1044.79,0,25,0,-30
6465,1047.49,6,25,0,0
6515,1310.96,0,22,0,-17
6565,1311.07,0,22,0,0
6615,1500.45,0,20,0,-14
6665,1677.10,0,19,0,-14
6715,1676.35,0,19,0,0
6765,1827.93,7,17,0,0
6815,1973.94,0,16,0,-14
6865,2110.00,0,14,0,-13
6915,2238.14,0,13,0,-14
6965,2365.93,0,12,0,-14
7015,2487.15,0,11,0,-14
7065,2598.75,0,10,0,-14
7115,2695.90,0,9,0,-13
7165,2775.21,4,8,0,1
7215,2858.23,0,7,0,2
7265,3022.37,-6,5,0,-13
7315,3094.70,0,5,0,-13
7365,3147.29,2,4,0,3
7415,3199.66,0,4,0,4
7465,3301.78,0,2,0,-10
7515,3337.04,0,2,0,4
7565,3399.82,-3,2,0,-9
7615,3423.09,4,1,0,4
7665,3441.16,0,1,0,5
7715,3470.62,0,1,0,-8
7766,3419.19,3,1,0,13
7816,3533.57,-19,0,0,-30
7866,3359.46,51,2,0,59
7916,3532.74,-19,0,0,-28
7966,3360.21,52,2,0,57
8016,3620.56,-4,0,0,-11
8066,3534.40,-31,0,0,-34
8116,3477.86,14,1,0,15
8166,3485.13,0,1,0,-6
8216,3359.46,12,2,0,24
8266,3532.74,-18,0,0,-30
8316,3360.21,22,2,0,29
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
