december454/Microcontroller-Engine-Governor/Data-Logging/3-10-2023/3-10-2023 - Test (PID P Only - MICROS.txt

------ Microcontroller Engine Governor - Version: 1.10 ------
-------------------------------------------------------------
PID Gains:        Kp: 0.010000   Ki: 0.000000   Kd: 0.000000
-------------------------------------------------------------
Set RPM:             3600    |  Min RPM:                300
                             |
RPM Precision        2       |  PID I Precision:         22
                             |
Start Steps:         900     |  Max Steps:               1200
                             |
RPM Calc Interval:   1       |  Num Magnets:             1
                             |
LCD Update Interval: 400     |  Serial Update Interval:  50
-------------------------------------------------------------

Time,RPM,Steps Remaining, PID p, PID i, PID d
87,0.00,0,0,0,0
137,0.00,0,0,0,0
187,0.00,0,0,0,0
237,0.00,0,0,0,0
287,0.00,0,0,0,0
337,0.00,0,0,0,0
387,0.00,0,0,0,0
437,0.00,0,0,0,0
487,0.00,0,0,0,0
537,0.00,0,0,0,0
587,0.00,0,0,0,0
637,0.00,0,0,0,0
687,0.00,0,0,0,0
737,0.00,0,0,0,0
787,0.00,0,0,0,0
837,0.00,0,0,0,0
887,0.00,0,0,0,0
937,0.00,0,0,0,0
987,0.00,0,0,0,0
1037,0.00,0,0,0,0
1087,0.00,0,0,0,0
1137,0.00,0,0,0,0
1187,0.00,0,0,0,0
1238,0.00,0,0,0,0
1288,0.00,0,0,0,0
1338,0.00,0,0,0,0
1388,0.00,0,0,0,0
1438,0.00,0,0,0,0
1488,0.00,0,0,0,0
1538,0.00,0,0,0,0
1588,0.00,0,0,0,0
1638,0.00,0,0,0,0
1688,0.00,0,0,0,0
1738,0.00,0,0,0,0
1788,0.00,0,0,0,0
1838,0.00,0,0,0,0
1888,0.00,0,0,0,0
1938,0.00,0,0,0,0
1988,0.00,0,0,0,0
2038,0.00,0,0,0,0
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
6372,inf,0,0,0,0
6422,inf,0,0,0,0
6472,520.98,21,30,0,0
6522,520.98,0,30,0,0
6572,619.58,18,29,0,0
6622,619.58,0,29,0,0
6672,965.13,0,26,0,0
6722,995.49,0,26,0,0
6772,1305.48,0,22,0,0
6822,1462.70,15,21,0,0
6872,1424.77,8,21,0,0
6922,1436.78,0,21,0,0
6972,1439.68,0,21,0,0
7022,1733.10,8,18,0,0
7072,1978.37,0,16,0,0
7122,2215.33,0,13,0,0
7172,2394.25,0,12,0,0
7222,2565.42,0,10,0,0
7272,2728.26,4,8,0,0
7322,2889.62,0,7,0,0
7372,3197.61,0,4,0,0
7422,3318.58,0,2,0,0
7472,3434.07,0,1,0,0
7522,3651.41,0,0,0,0
7572,3739.72,0,-1,0,0
7622,3900.16,-1,-3,0,0
7672,4048.58,0,-4,0,0
7723,4099.48,0,-4,0,0
7773,4179.44,0,-5,0,0
7823,4269.85,0,-6,0,0
7873,4243.28,0,-6,0,0
7923,4192.29,0,-5,0,0
7973,4166.67,0,-5,0,0
8023,4173.62,0,-5,0,0
8073,4135.65,0,-5,0,0
8123,4073.87,0,-4,0,0
8173,4033.34,-2,-4,0,0
8223,3975.62,0,-3,0,0
8273,3956.74,0,-3,0,0
8323,3877.97,0,-2,0,0
8373,3830.44,0,-2,0,0
8423,3770.74,0,-1,0,0
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
