december454/Microcontroller-Engine-Governor/Data-Logging/Experiments/Mechanical Governor/Adjustment Test.txt

------ Microcontroller Engine Governor - Version: 1.16 ------
-------------------------------------------------------------
PID Gains:        Kp: 0.013000   Ki: 0.025000   Kd: 1.000000
-------------------------------------------------------------
Set RPM:             3600    |  Min RPM:                300
                             |
RPM Precision        10       |  PID I Precision:         70
                             |
Start Steps:         850     |  Max Steps:               1200
                             |
RPM Calc Interval:   1       |  Num Magnets:             1
                             |
LCD Update Interval: 400     |  Serial Update Interval:  50
-------------------------------------------------------------

Time,RPM,Steps Remaining, PID p, PID i, PID d, RPM Change, P Cmd, I Cmd, D Cmd
1226,0.00,0,0,0,0,0.00,0,0,0
1276,0.00,0,0,0,0,0.00,0,0,0
1326,0.00,0,0,0,0,0.00,0,0,0
1376,0.00,0,0,0,0,0.00,0,0,0
1426,0.00,0,0,0,0,0.00,0,0,0
1476,0.00,0,0,0,0,0.00,0,0,0
1526,0.00,0,0,0,0,0.00,0,0,0
1576,0.00,0,0,0,0,0.00,0,0,0
1626,0.00,0,0,0,0,0.00,0,0,0
1676,0.00,0,0,0,0,0.00,0,0,0
1726,0.00,0,0,0,0,0.00,0,0,0
1776,0.00,0,0,0,0,0.00,0,0,0
1826,0.00,0,0,0,0,0.00,0,0,0
1876,0.00,0,0,0,0,0.00,0,0,0
1926,0.00,0,0,0,0,0.00,0,0,0
1976,0.00,0,0,0,0,0.00,0,0,0
2026,0.00,0,0,0,0,0.00,0,0,0
2076,0.00,0,0,0,0,0.00,0,0,0
2126,0.00,0,0,0,0,0.00,0,0,0
2176,0.00,0,0,0,0,0.00,0,0,0
2226,0.00,0,0,0,0,0.00,0,0,0
2276,0.00,0,0,0,0,0.00,0,0,0
2326,0.00,0,0,0,0,0.00,0,0,0
2376,0.00,0,0,0,0,0.00,0,0,0
2426,0.00,0,0,0,0,0.00,0,0,0
2476,0.00,0,0,0,0,0.00,0,0,0
2526,0.00,0,0,0,0,0.00,0,0,0
2576,0.00,0,0,0,0,0.00,0,0,0
2626,0.00,0,0,0,0,0.00,0,0,0
2676,0.00,0,0,0,0,0.00,0,0,0
2726,0.00,0,0,0,0,0.00,0,0,0
2776,0.00,0,0,0,0,0.00,0,0,0
2826,0.00,0,0,0,0,0.00,0,0,0
2876,0.00,0,0,0,0,0.00,0,0,0
2926,0.00,0,0,0,0,0.00,0,0,0
2976,0.00,0,0,0,0,0.00,0,0,0
3026,0.00,0,0,0,0,0.00,0,0,0
3076,0.00,0,0,0,0,0.00,0,0,0
3126,0.00,0,0,0,0,0.00,0,0,0
3176,0.00,0,0,0,0,0.00,0,0,0
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
7828,inf,0,0,0,0,inf,0,0,0
7878,inf,0,0,0,0,inf,0,0,0
7928,inf,0,0,0,0,inf,0,0,0
7979,470.65,6,40,0,0,inf,40,0,0
8029,919.91,9,34,0,-6,-449.26,74,0,6
8079,929.66,30,34,0,0,-9.75,108,0,6
8129,1361.78,10,29,0,-9,-432.12,137,0,15
8179,1387.86,11,28,0,0,-26.08,165,0,15
8229,1744.59,0,24,0,-10,-356.73,189,0,25
8279,2049.46,0,20,0,-10,-313.75,233,0,35
8329,2281.72,0,17,0,-9,-244.23,270,0,44
8379,2546.26,0,13,0,-10,-248.46,299,0,54
8429,2779.84,0,10,0,-11,-246.91,322,0,65
8479,2992.82,1,7,0,0,-5.36,346,0,75
8529,3239.04,0,4,0,-6,-113.39,356,0,87
8579,3518.65,0,1,0,0,187.80,365,0,116
8629,3670.17,0,0,0,0,14.42,366,0,116
8679,3960.92,-30,-4,0,-27,-416.50,373,1,157
8729,3670.17,0,0,0,0,29.88,375,1,157
8779,3602.31,0,0,0,0,15.93,375,2,157
8829,3545.26,0,0,1,0,21.07,375,3,157
8879,3576.54,0,0,0,0,11.12,375,4,157
8929,3664.79,0,0,-1,0,-42.48,375,5,157
8979,3625.82,0,0,0,0,39.87,375,6,157
9029,3644.31,0,0,-1,0,-29.86,375,8,157
9079,3591.09,0,0,0,0,-24.39,375,8,157
9129,3606.64,0,0,0,0,49.14,375,8,157
9179,3574.83,0,0,0,0,33.54,375,8,157
9229,3627.57,0,0,0,0,-45.05,375,8,157
9279,3590.23,0,0,0,0,-32.86,375,8,157
9329,3627.57,0,0,0,0,-45.91,375,8,157
9379,3591.95,0,0,0,0,-31.43,375,8,157
9430,3635.48,0,0,0,0,-33.18,375,8,157
9480,3591.95,0,0,0,0,-38.27,375,8,157
9530,3624.06,0,0,0,0,-32.97,375,8,157
9580,3583.37,0,0,0,0,24.13,375,8,157
9630,3639.01,0,0,0,0,-57.35,375,8,157
9680,3601.44,0,0,0,0,-55.64,375,8,157
9730,3632.84,0,0,0,0,-39.17,375,8,157
9780,3601.44,0,0,0,0,-34.04,375,8,157
9830,3632.84,0,0,0,0,-42.61,375,8,157
9880,3591.09,0,0,0,0,-39.15,375,8,157
9930,3614.46,0,0,0,0,-22.50,375,8,157
9980,3591.09,0,0,0,0,-45.10,375,8,157
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
