december454/Microcontroller-Engine-Governor/Experiment Summaries/Summary - Mech Gov - Constant Load.xlsx

Sheet: Summary
Summary of Results
Mechanical Governor - Constant Load (1500 W)
Average of Results |  |  |  | Average of Results (TRIMMEAN: 20%)
Avg RPM | Std Dev | Dev from Setpoint | 20 sec to 60 sec | Avg RPM | Std Dev | Dev from Setpoint | 20 sec to 60 sec
3591.036511 | 28.59153512 | 22.62482272 |  | 3591.018532 | 28.38395039 | 22.6023221
Min RPM | Max RPM | Range |  | Min RPM | Max RPM | Range
3421.415 | 3828.879 | 407.464 |  | 3419.13625 | 3826.50625 | 405.90125
Max Startup RPM | Startup Time (ms) | Overshoot Time (ms) | 0 sec to 20 sec | Max Startup RPM | Startup Time (ms) | Overshoot Time (ms) | 0 sec to 20 sec
3808.065 | 810 | 85 |  | 3804.89125 | 787.5 | 81.25
Min Results |  |  |  | Max Results
Avg RPM | Std Dev | Dev from Setpoint | 20 sec to 60 sec | Avg RPM | Std Dev | Dev from Setpoint | 20 sec to 60 sec
3588.930175 | 24.1934204 | 21.2413608 |  | 3593.286679 | 34.65032771 | 24.18828964
Min RPM | Max RPM | Range |  | Min RPM | Max RPM | Range
3357.21 | 3663.9 | 240.81 |  | 3503.85 | 4012.84 | 586.62
Max Startup RPM | Startup Time (ms) | Overshoot Time (ms) | 0 sec to 20 sec | Max Startup RPM | Startup Time (ms) | Overshoot Time (ms) | 0 sec to 20 sec
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
