december454/Microcontroller-Engine-Governor/Experiment Summaries/Summary - Mech Gov - Load Decrease.xlsx

Sheet: Summary
Summary of Results
Mechanical Governor - Abrupt Load Decrease (1500 W)
Average of Results |  |  |  | Average of Results (TRIMMEAN: 20%)
Avg RPM | Std Dev | Dev from Setpoint | 20 sec to 60 sec | Avg RPM | Std Dev | Dev from Setpoint | 20 sec to 60 sec
3604.124026 | 34.96268966 | 26.6819563 |  | 3604.33096 | 34.91150942 | 26.58625156
Min RPM | Max RPM | Range |  | Min RPM | Max RPM | Range
3449.891 | 3829.066 | 379.175 |  | 3453.03 | 3820.85875 | 365.32875
Max Startup RPM | Startup Time (ms) | Overshoot Time (ms) | 0 sec to 20 sec | Max Startup RPM | Startup Time (ms) | Overshoot Time (ms) | 0 sec to 20 sec
3816.028 | 1010 | 72.22222222 |  | 3810.87625 | 812.5 | 72.22222222
Min Results |  |  |  | Max Results
Avg RPM | Std Dev | Dev from Setpoint | 20 sec to 60 sec | Avg RPM | Std Dev | Dev from Setpoint | 20 sec to 60 sec
3598.196392 | 32.3806697 | 24.37926342 |  | 3608.396192 | 37.95415156 | 29.75028714
Min RPM | Max RPM | Range |  | Min RPM | Max RPM | Range
3360.97 | 3766.01 | 276.83 |  | 3513.7 | 3957.78 | 592.29
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
