december454/Microcontroller-Engine-Governor/Experiment Summaries/Summary - Mech Gov - Load Increase (Initially No Load).xlsx

Sheet: Summary
Summary of Results
Mechanical Governor - Abrupt Load Increase (1800 W) - Initially No Load
Average of Results |  |  |  | Average of Results (TRIMMEAN: 20%)
Avg RPM | Std Dev | Dev from Setpoint | 20 sec to 60 sec | Avg RPM | Std Dev | Dev from Setpoint | 20 sec to 60 sec
3621.392909 | 36.40855016 | 32.64970537 |  | 3621.261028 | 35.93307733 | 32.47378433
Min RPM | Max RPM | Range |  | Min RPM | Max RPM | Range
3355.882 | 3848.323 | 492.441 |  | 3353.0775 | 3845.3625 | 493.80375
Max Startup RPM | Startup Time (ms) | Overshoot Time (ms) | 0 sec to 20 sec | Max Startup RPM | Startup Time (ms) | Overshoot Time (ms) | 0 sec to 20 sec
3806.079 | 735 | 70 |  | 3806.28125 | 737.5 | 62.5
Min Results |  |  |  | Max Results
Avg RPM | Std Dev | Dev from Setpoint | 20 sec to 60 sec | Avg RPM | Std Dev | Dev from Setpoint | 20 sec to 60 sec
3618.867303 | 33.94419031 | 30.05661673 |  | 3624.973558 | 42.67669272 | 36.6501623
Min RPM | Max RPM | Range |  | Min RPM | Max RPM | Range
3313.45 | 3793.63 | 449.15 |  | 3420.75 | 3926.7 | 524.83
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
