december454/Microcontroller-Engine-Governor/Experiment Summaries/Summary - Mech Gov - Load Increse (Initially Constant Load).xlsx

Sheet: Summary
Summary of Results
Mechanical Governor - Abrupt Load Increase (1800 W) - Initially Constant Load (1500 W)
Average of Results |  |  |  | Average of Results (TRIMMEAN: 20%)
Avg RPM | Std Dev | Dev from Setpoint | 20 sec to 60 sec | Avg RPM | Std Dev | Dev from Setpoint | 20 sec to 60 sec
3584.925905 | 32.75827472 | 26.46512609 |  | 3584.824622 | 32.73308754 | 26.40999532
Min RPM | Max RPM | Range |  | Min RPM | Max RPM | Range
3354.257 | 3775.106 | 420.849 |  | 3354.59625 | 3781.12 | 429.31
Max Startup RPM | Startup Time (ms) | Overshoot Time (ms) | 0 sec to 20 sec | Max Startup RPM | Startup Time (ms) | Overshoot Time (ms) | 0 sec to 20 sec
3783.134 | 700 | 83.33333333 |  | 3778.70125 | 725 | 83.33333333
Min Results |  |  |  | Max Results
Avg RPM | Std Dev | Dev from Setpoint | 20 sec to 60 sec | Avg RPM | Std Dev | Dev from Setpoint | 20 sec to 60 sec
3582.592871 | 29.12169641 | 25.19189763 |  | 3588.069201 | 36.5963505 | 28.17940075
Min RPM | Max RPM | Range |  | Min RPM | Max RPM | Range
3327.42 | 3675.57 | 297.19 |  | 3378.38 | 3826.53 | 476.82
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
