december454/Microcontroller-Engine-Governor/Experiment Summaries/Summary - Mech Gov - No Load.xlsx

Sheet: Summary
Summary of Results
Mechanical Governor - No Load
Average of Results |  |  |  | Average of Results (TRIMMEAN: 20%)
Avg RPM | Std Dev | Dev from Setpoint | 20 sec to 60 sec | Avg RPM | Std Dev | Dev from Setpoint | 20 sec to 60 sec
3623.258367 | 33.38791005 | 32.65228215 |  | 3623.146019 | 33.20737197 | 32.62889513
Min RPM | Max RPM | Range |  | Min RPM | Max RPM | Range
3423.649 | 3823.963 | 400.314 |  | 3417.9525 | 3822.97125 | 396.28
Max Startup RPM | Startup Time (ms) | Overshoot Time (ms) | 0 sec to 20 sec | Max Startup RPM | Startup Time (ms) | Overshoot Time (ms) | 0 sec to 20 sec
3866.228 | 700 | 85 |  | 3863.89375 | 756.25 | 81.25
Min Results |  |  |  | Max Results
Avg RPM | Std Dev | Dev from Setpoint | 20 sec to 60 sec | Avg RPM | Std Dev | Dev from Setpoint | 20 sec to 60 sec
3618.964732 | 30.77506683 | 29.93099875 |  | 3628.450787 | 37.44505793 | 35.56066167
Min RPM | Max RPM | Range |  | Min RPM | Max RPM | Range
3360.97 | 3768.84 | 308.35 |  | 3531.9 | 3887.02 | 524.55
Max Startup RPM | Startup Time (ms) | Overshoot Time (ms) | 0 sec to 20 sec | Max Startup RPM | Startup Time (ms) | Overshoot Time (ms) | 0 sec to 20 sec
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
