december454/Microcontroller-Engine-Governor/Experiment Summaries/Summary - Micocontroller Gov - No Load.xlsx

Sheet: Summary
Summary of Results
Electronic Governor - No Load
Average of Results |  |  |  | Average of Results (TRIMMEAN: 20%)
Avg RPM | Std Dev | Dev from Setpoint | 20 sec to 60 sec | Avg RPM | Std Dev | Dev from Setpoint | 20 sec to 60 sec
3595.865453 | 47.1880583 | 36.33313858 |  | 3595.783235 | 47.17078248 | 36.40963951
Min RPM | Max RPM | Range |  | Min RPM | Max RPM | Range
3406.712 | 3765.55 | 358.838 |  | 3410.8375 | 3755.6775 | 344.93125
Max Startup RPM | Startup Time (ms) | Overshoot Time (ms) | 0 sec to 20 sec | Max Startup RPM | Startup Time (ms) | Overshoot Time (ms) | 0 sec to 20 sec
4123.878 | 1005 | 1060 |  | 4049.32875 | 1093.75 | 1087.5
Min Results |  |  |  | Max Results
Avg RPM | Std Dev | Dev from Setpoint | 20 sec to 60 sec | Avg RPM | Std Dev | Dev from Setpoint | 20 sec to 60 sec
3593.187378 | 40.89195619 | 31.84474407 |  | 3599.201273 | 53.62236698 | 40.20952559
Min RPM | Max RPM | Range |  | Min RPM | Max RPM | Range
3309.8 | 3711.95 | 241.33 |  | 3470.62 | 3898.13 | 587.6
Max Startup RPM | Startup Time (ms) | Overshoot Time (ms) | 0 sec to 20 sec | Max Startup RPM | Startup Time (ms) | Overshoot Time (ms) | 0 sec to 20 sec
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
