december454/Microcontroller-Engine-Governor/Experiment Summaries/Summary - Micrcontroller Gov - Load Decrease.xlsx

Sheet: Summary
Summary of Results
Microcontroller Governor - Abrupt Load Decrease (1500 W)
Average of Results |  |  |  | Average of Results (TRIMMEAN: 20%)
Avg RPM | Std Dev | Dev from Setpoint | 20 sec to 60 sec | Avg RPM | Std Dev | Dev from Setpoint | 20 sec to 60 sec
3593.468886 | 55.79376167 | 40.35171286 |  | 3594.030179 | 55.9153824 | 40.44712859
Min RPM | Max RPM | Range |  | Min RPM | Max RPM | Range
3348.066 | 3904.763 | 556.697 |  | 3342.8775 | 3875.16875 | 536.48875
Max Startup RPM | Startup Time (ms) | Overshoot Time (ms) | 0 sec to 20 sec | Max Startup RPM | Startup Time (ms) | Overshoot Time (ms) | 0 sec to 20 sec
3865.345 | 1090 | 815 |  | 3861.8825 | 1087.5 | 812.5
Min Results |  |  |  | Max Results
Avg RPM | Std Dev | Dev from Setpoint | 20 sec to 60 sec | Avg RPM | Std Dev | Dev from Setpoint | 20 sec to 60 sec
3584.627441 | 45.56922697 | 33.52397004 |  | 3597.819988 | 65.04533054 | 46.41612984
Min RPM | Max RPM | Range |  | Min RPM | Max RPM | Range
3309.07 | 3799.39 | 405.79 |  | 3428.57 | 4246.89 | 869.27
Max Startup RPM | Startup Time (ms) | Overshoot Time (ms) | 0 sec to 20 sec | Max Startup RPM | Startup Time (ms) | Overshoot Time (ms) | 0 sec to 20 sec
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
