december454/Microcontroller-Engine-Governor/Experiment Summaries/Summary - Microcontroller Gov - Constant Load.xlsx

Sheet: Summary
Summary of Results
Microcontroller Governor - Constant Load (1500 W)
Average of Results |  |  |  | Average of Results (TRIMMEAN: 20%)
Avg RPM | Std Dev | Dev from Setpoint | 20 sec to 60 sec | Avg RPM | Std Dev | Dev from Setpoint | 20 sec to 60 sec
3601.420891 | 267.3100685 | 42.77790762 |  | 3591.168421 | 39.04763626 | 31.22240793
Min RPM | Max RPM | Range |  | Min RPM | Max RPM | Range
3429.035 | 8606.601 | 5177.566 |  | 3437.52375 | 3765.92875 | 343.395
Max Startup RPM | Startup Time (ms) | Overshoot Time (ms) | 0 sec to 20 sec | Max Startup RPM | Startup Time (ms) | Overshoot Time (ms) | 0 sec to 20 sec
3889.187 | 1015 | 650 |  | 3887.7525 | 1112.5 | 631.25
Min Results |  |  |  | Max Results
Avg RPM | Std Dev | Dev from Setpoint | 20 sec to 60 sec | Avg RPM | Std Dev | Dev from Setpoint | 20 sec to 60 sec
3577.908577 | 33.27409705 | 26.28214732 |  | 3706.952971 | 2327.445498 | 151.7176654
Min RPM | Max RPM | Range |  | Min RPM | Max RPM | Range
3309.07 | 3673.77 | 226.29 |  | 3481.09 | 52264.81 | 48802.21
Max Startup RPM | Startup Time (ms) | Overshoot Time (ms) | 0 sec to 20 sec | Max Startup RPM | Startup Time (ms) | Overshoot Time (ms) | 0 sec to 20 sec
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
