december454/Microcontroller-Engine-Governor/Experiment Summaries/Summary - Microcontroller Gov - Load Increase (Constant Load).xlsx

Sheet: Summary
Summary of Results
Microcontroller Governor - Abrupt Load Increase (1800 W) - Initially Constant Load (1500 W)
Average of Results |  |  |  | Average of Results (TRIMMEAN: 20%)
Avg RPM | Std Dev | Dev from Setpoint | 20 sec to 60 sec | Avg RPM | Std Dev | Dev from Setpoint | 20 sec to 60 sec
3590.146853 | 69.39110553 | 41.97250062 |  | 3590.238026 | 69.22807848 | 41.82801186
Min RPM | Max RPM | Range |  | Min RPM | Max RPM | Range
3125.638 | 3865.506 | 739.868 |  | 3123.9275 | 3862.77125 | 737.30625
Max Startup RPM | Startup Time (ms) | Overshoot Time (ms) | 0 sec to 20 sec | Max Startup RPM | Startup Time (ms) | Overshoot Time (ms) | 0 sec to 20 sec
3851.939 | 1060 | 510 |  | 3855.6975 | 1062.5 | 493.75
Min Results |  |  |  | Max Results
Avg RPM | Std Dev | Dev from Setpoint | 20 sec to 60 sec | Avg RPM | Std Dev | Dev from Setpoint | 20 sec to 60 sec
3585.042297 | 66.07216598 | 39.15411985 |  | 3594.522022 | 74.01426142 | 45.94679151
Min RPM | Max RPM | Range |  | Min RPM | Max RPM | Range
3101.74 | 3760.34 | 609.42 |  | 3163.22 | 3992.55 | 890.81
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
