december454/Microcontroller-Engine-Governor/Experiment Summaries/Summary - Microcontroller Gov - Load Increase (No Load).xlsx

Sheet: Summary
Summary of Results
Microcontroller Governor - Abrupt Load Increase (1800 W) - Initially No Load
Average of Results |  |  |  | Average of Results (TRIMMEAN: 20%)
Avg RPM | Std Dev | Dev from Setpoint | 20 sec to 60 sec | Avg RPM | Std Dev | Dev from Setpoint | 20 sec to 60 sec
3591.251318 | 78.85041627 | 51.01983021 |  | 3591.374443 | 78.62774414 | 51.09879682
Min RPM | Max RPM | Range |  | Min RPM | Max RPM | Range
3116.703 | 3880.832 | 764.129 |  | 3121.31875 | 3878.8975 | 764.6025
Max Startup RPM | Startup Time (ms) | Overshoot Time (ms) | 0 sec to 20 sec | Max Startup RPM | Startup Time (ms) | Overshoot Time (ms) | 0 sec to 20 sec
4106.042 | 980 | 1150 |  | 4018.07125 | 1068.75 | 1193.75
Min Results |  |  |  | Max Results
Avg RPM | Std Dev | Dev from Setpoint | 20 sec to 60 sec | Avg RPM | Std Dev | Dev from Setpoint | 20 sec to 60 sec
3586.755506 | 72.51614917 | 46.11093633 |  | 3594.762135 | 86.96606045 | 55.29699126
Min RPM | Max RPM | Range |  | Min RPM | Max RPM | Range
3034.59 | 3810.98 | 687.22 |  | 3161.89 | 3966.16 | 837.25
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
