december454/Microcontroller-Engine-Governor/Experiment Summaries/Summary - No Throttle Input - Constant Load.xlsx

Sheet: Summary
Summary of Results
No Throttle Input - Constant Load (1500 W)
Average of Results |  |  |  | Average of Results (TRIMMEAN: 20%)
Avg RPM | Std Dev | Dev from Setpoint | 20 sec to 60 sec | Avg RPM | Std Dev | Dev from Setpoint | 20 sec to 60 sec
3600.099973 | 28.69888217 | 27.58760549 |  | 3601.537903 | 28.49370707 | 26.74118914
Min RPM | Max RPM | Range |  | Min RPM | Max RPM | Range
3509.778 | 3703.749 | 193.971 |  | 3512.66875 | 3704.8675 | 193.02125
Max Startup RPM | Startup Time (ms) | Overshoot Time (ms) | 0 sec to 20 sec | Max Startup RPM | Startup Time (ms) | Overshoot Time (ms) | 0 sec to 20 sec
3663.019 | 1110 | #DIV/0! |  | 3661.09875 | 1106.25 | #NUM!
Min Results |  |  |  | Max Results
Avg RPM | Std Dev | Dev from Setpoint | 20 sec to 60 sec | Avg RPM | Std Dev | Dev from Setpoint | 20 sec to 60 sec
3564.453795 | 26.13321288 | 21.96123596 |  | 3624.242709 | 32.90595223 | 39.98530587
Min RPM | Max RPM | Range |  | Min RPM | Max RPM | Range
3457.02 | 3652.3 | 150.48 |  | 3539.41 | 3746.25 | 245.06
Max Startup RPM | Startup Time (ms) | Overshoot Time (ms) | 0 sec to 20 sec | Max Startup RPM | Startup Time (ms) | Overshoot Time (ms) | 0 sec to 20 sec
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
