december454/Microcontroller-Engine-Governor/Experiment Summaries/Summary - No Throttle Input - No load.xlsx

Sheet: Summary
Summary of Results
No Throttle Input - No Load
Average of Results |  |  |  | Average of Results (TRIMMEAN: 20%)
Avg RPM | Std Dev | Dev from Setpoint | 20 sec to 60 sec | Avg RPM | Std Dev | Dev from Setpoint | 20 sec to 60 sec
3613.906226 | 32.67058817 | 37.85657553 |  | 3614.758541 | 32.51143077 | 36.82308208
Min RPM | Max RPM | Range |  | Min RPM | Max RPM | Range
3506.961 | 3732.109 | 225.148 |  | 3507.25 | 3727.155 | 227.3425
Max Startup RPM | Startup Time (ms) | Overshoot Time (ms) | 0 sec to 20 sec | Max Startup RPM | Startup Time (ms) | Overshoot Time (ms) | 0 sec to 20 sec
3666.905 | 2785 | #DIV/0! |  | 3664.55375 | 2737.5 | #NUM!
Min Results |  |  |  | Max Results
Avg RPM | Std Dev | Dev from Setpoint | 20 sec to 60 sec | Avg RPM | Std Dev | Dev from Setpoint | 20 sec to 60 sec
3564.857553 | 28.82616373 | 27.63867665 |  | 3656.13638 | 37.78827184 | 56.34242197
Min RPM | Max RPM | Range |  | Min RPM | Max RPM | Range
3423.09 | 3690.94 | 158.67 |  | 3588.52 | 3812.91 | 274.07
Max Startup RPM | Startup Time (ms) | Overshoot Time (ms) | 0 sec to 20 sec | Max Startup RPM | Startup Time (ms) | Overshoot Time (ms) | 0 sec to 20 sec
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
