december454/Microcontroller-Engine-Governor/Data-Logging/4-4-2023/4-4-2023 - PID Tuning - PID P Alt - (P 02 I 025 D 2) - Major RPM Change Disabled.xlsx

Sheet: 4-4-2023 - PID Tuning - PID P A
Time | RPM | Steps Remaining | PID p | PID i | PID d | RPM Change | P Cmd | I Cmd | D Cmd
90 | inf | 0 | 0 | 0 | 0 | 0 | 0 | 0 | 0
140 | 3205.13 | 0 | 0 | 0 | 0 | 0 | 0 | 0 | 0
190 | 3187.42 | 0 | 0 | 0 | 0 | 0 | 0 | 0 | 0
240 | 3240.44 | 0 | 0 | 0 | 0 | 0 | 0 | 0 | 0
290 | 3248.86 | 0 | 0 | 0 | 0 | 0 | 0 | 0 | 0
340 | 3258.74 | 0 | 0 | 0 | 0 | 0 | 0 | 0 | 0
390 | 3196.25 | 0 | 0 | 0 | 0 | 0 | 0 | 0 | 0
440 | 3151.92 | 0 | 0 | 0 | 0 | 0 | 0 | 0 | 0
490 | 3152.58 | 0 | 0 | 0 | 0 | 0 | 0 | 0 | 0
540 | 3186.74 | 0 | 0 | 0 | 0 | 0 | 0 | 0 | 0
590 | 3161.89 | 0 | 0 | 0 | 0 | 0 | 0 | 0 | 0
640 | 3143.99 | 0 | 0 | 0 | 0 | 0 | 0 | 0 | 0
690 | 3205.13 | 0 | 0 | 0 | 0 | 0 | 0 | 0 | 0
740 | 3160.56 | 0 | 0 | 0 | 0 | 0 | 0 | 0 | 0
790 | 3110.74 | 0 | 0 | 0 | 0 | 0 | 0 | 0 | 0
840 | 3056.86 | 0 | 0 | 0 | 0 | 0 | 0 | 0 | 0
890 | 3070 | 0 | 0 | 0 | 0 | 0 | 0 | 0 | 0
940 | 3038.28 | 0 | 0 | 0 | 0 | 0 | 0 | 0 | 0
990 | 3046.3 | 0 | 0 | 0 | 0 | 0 | 0 | 0 | 0
1040 | 3022.97 | 0 | 0 | 0 | 0 | 0 | 0 | 0 | 0
1090 | 3022.37 | 0 | 0 | 0 | 0 | 0 | 0 | 0 | 0
1140 | 2946.38 | 0 | 0 | 0 | 0 | 0 | 0 | 0 | 0
1190 | 2954.5 | 0 | 0 | 0 | 0 | 0 | 0 | 0 | 0
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
