december454/Microcontroller-Engine-Governor/Data-Logging/4-5-2023/4-5-2023 - PID Tuning - PID P Alt - (P 013 I 025 D 0_1).xlsx

Sheet: 4-5-2023 - PID Tuning - PID P A
Time | RPM | Steps Remaining | PID p | PID i | PID d | RPM Change | P Cmd | I Cmd | D Cmd
1717 | 0 | 0 | 0 | 0 | 0 | 0 | 0 | 0 | 0
1767 | 0 | 0 | 0 | 0 | 0 | 0 | 0 | 0 | 0
1817 | 0 | 0 | 0 | 0 | 0 | 0 | 0 | 0 | 0
1867 | 0 | 0 | 0 | 0 | 0 | 0 | 0 | 0 | 0
1917 | 0 | 0 | 0 | 0 | 0 | 0 | 0 | 0 | 0
1967 | 0 | 0 | 0 | 0 | 0 | 0 | 0 | 0 | 0
2017 | 0 | 0 | 0 | 0 | 0 | 0 | 0 | 0 | 0
2067 | 0 | 0 | 0 | 0 | 0 | 0 | 0 | 0 | 0
2117 | 0 | 0 | 0 | 0 | 0 | 0 | 0 | 0 | 0
2167 | 0 | 0 | 0 | 0 | 0 | 0 | 0 | 0 | 0
2217 | 0 | 0 | 0 | 0 | 0 | 0 | 0 | 0 | 0
2267 | 0 | 0 | 0 | 0 | 0 | 0 | 0 | 0 | 0
2317 | 0 | 0 | 0 | 0 | 0 | 0 | 0 | 0 | 0
2367 | 0 | 0 | 0 | 0 | 0 | 0 | 0 | 0 | 0
2417 | 0 | 0 | 0 | 0 | 0 | 0 | 0 | 0 | 0
2467 | 0 | 0 | 0 | 0 | 0 | 0 | 0 | 0 | 0
2518 | 0 | 0 | 0 | 0 | 0 | 0 | 0 | 0 | 0
2568 | 0 | 0 | 0 | 0 | 0 | 0 | 0 | 0 | 0
2618 | 0 | 0 | 0 | 0 | 0 | 0 | 0 | 0 | 0
2668 | 0 | 0 | 0 | 0 | 0 | 0 | 0 | 0 | 0
2718 | 0 | 0 | 0 | 0 | 0 | 0 | 0 | 0 | 0
2768 | 0 | 0 | 0 | 0 | 0 | 0 | 0 | 0 | 0
2818 | 0 | 0 | 0 | 0 | 0 | 0 | 0 | 0 | 0
2868 | 0 | 0 | 0 | 0 | 0 | 0 | 0 | 0 | 0
2918 | 0 | 0 | 0 | 0 | 0 | 0 | 0 | 0 | 0
2968 | 0 | 0 | 0 | 0 | 0 | 0 | 0 | 0 | 0
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
