december454/Microcontroller-Engine-Governor/Data-Logging/4-5-2023/4-5-2023 - PID Tuning - PID P Alt - (P 013 I 025 D 3) - Dynamic D Gain Disabled.xlsx

Sheet: 4-5-2023 - PID Tuning - PID P A
Time | RPM | Steps Remaining | PID p | PID i | PID d | RPM Change | P Cmd | I Cmd | D Cmd
1731 | 0 | 0 | 0 | 0 | 0 | 0 | 0 | 0 | 0
1781 | 0 | 0 | 0 | 0 | 0 | 0 | 0 | 0 | 0
1831 | 0 | 0 | 0 | 0 | 0 | 0 | 0 | 0 | 0
1881 | 0 | 0 | 0 | 0 | 0 | 0 | 0 | 0 | 0
1931 | 0 | 0 | 0 | 0 | 0 | 0 | 0 | 0 | 0
1981 | 0 | 0 | 0 | 0 | 0 | 0 | 0 | 0 | 0
2031 | 0 | 0 | 0 | 0 | 0 | 0 | 0 | 0 | 0
2081 | 0 | 0 | 0 | 0 | 0 | 0 | 0 | 0 | 0
2131 | 0 | 0 | 0 | 0 | 0 | 0 | 0 | 0 | 0
2181 | 0 | 0 | 0 | 0 | 0 | 0 | 0 | 0 | 0
2231 | 0 | 0 | 0 | 0 | 0 | 0 | 0 | 0 | 0
2281 | 0 | 0 | 0 | 0 | 0 | 0 | 0 | 0 | 0
2331 | 0 | 0 | 0 | 0 | 0 | 0 | 0 | 0 | 0
2381 | 0 | 0 | 0 | 0 | 0 | 0 | 0 | 0 | 0
2432 | 0 | 0 | 0 | 0 | 0 | 0 | 0 | 0 | 0
2482 | 0 | 0 | 0 | 0 | 0 | 0 | 0 | 0 | 0
2532 | 0 | 0 | 0 | 0 | 0 | 0 | 0 | 0 | 0
2582 | 0 | 0 | 0 | 0 | 0 | 0 | 0 | 0 | 0
2632 | 0 | 0 | 0 | 0 | 0 | 0 | 0 | 0 | 0
2682 | 0 | 0 | 0 | 0 | 0 | 0 | 0 | 0 | 0
2732 | 0 | 0 | 0 | 0 | 0 | 0 | 0 | 0 | 0
2782 | 0 | 0 | 0 | 0 | 0 | 0 | 0 | 0 | 0
2832 | 0 | 0 | 0 | 0 | 0 | 0 | 0 | 0 | 0
2882 | 0 | 0 | 0 | 0 | 0 | 0 | 0 | 0 | 0
2932 | 0 | 0 | 0 | 0 | 0 | 0 | 0 | 0 | 0
2982 | 0 | 0 | 0 | 0 | 0 | 0 | 0 | 0 | 0
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
