december454/Microcontroller-Engine-Governor/Data-Logging/4-5-2023/4-5-2023 - PID Tuning - PID P Alt - (P 02 I 025 D 3) - Dynamic D Gain Updated.xlsx

Sheet: 4-5-2023 - PID Tuning - PID P A
Time | RPM | Steps Remaining | PID p | PID i | PID d | RPM Change | P Cmd | I Cmd | D Cmd
1648 | 0 | 0 | 0 | 0 | 0 | 0 | 0 | 0 | 0
1698 | 0 | 0 | 0 | 0 | 0 | 0 | 0 | 0 | 0
1748 | 0 | 0 | 0 | 0 | 0 | 0 | 0 | 0 | 0
1798 | 0 | 0 | 0 | 0 | 0 | 0 | 0 | 0 | 0
1848 | 0 | 0 | 0 | 0 | 0 | 0 | 0 | 0 | 0
1898 | 0 | 0 | 0 | 0 | 0 | 0 | 0 | 0 | 0
1948 | 0 | 0 | 0 | 0 | 0 | 0 | 0 | 0 | 0
1998 | 0 | 0 | 0 | 0 | 0 | 0 | 0 | 0 | 0
2048 | 0 | 0 | 0 | 0 | 0 | 0 | 0 | 0 | 0
2098 | 0 | 0 | 0 | 0 | 0 | 0 | 0 | 0 | 0
2148 | 0 | 0 | 0 | 0 | 0 | 0 | 0 | 0 | 0
2198 | 0 | 0 | 0 | 0 | 0 | 0 | 0 | 0 | 0
2248 | 0 | 0 | 0 | 0 | 0 | 0 | 0 | 0 | 0
2298 | 0 | 0 | 0 | 0 | 0 | 0 | 0 | 0 | 0
2348 | 0 | 0 | 0 | 0 | 0 | 0 | 0 | 0 | 0
2398 | 0 | 0 | 0 | 0 | 0 | 0 | 0 | 0 | 0
2448 | 0 | 0 | 0 | 0 | 0 | 0 | 0 | 0 | 0
2498 | 0 | 0 | 0 | 0 | 0 | 0 | 0 | 0 | 0
2548 | 0 | 0 | 0 | 0 | 0 | 0 | 0 | 0 | 0
2598 | 0 | 0 | 0 | 0 | 0 | 0 | 0 | 0 | 0
2648 | 0 | 0 | 0 | 0 | 0 | 0 | 0 | 0 | 0
2698 | 0 | 0 | 0 | 0 | 0 | 0 | 0 | 0 | 0
2748 | 0 | 0 | 0 | 0 | 0 | 0 | 0 | 0 | 0
2798 | 0 | 0 | 0 | 0 | 0 | 0 | 0 | 0 | 0
2848 | 0 | 0 | 0 | 0 | 0 | 0 | 0 | 0 | 0
2898 | 0 | 0 | 0 | 0 | 0 | 0 | 0 | 0 | 0
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
