december454/Microcontroller-Engine-Governor/Data-Logging/4-3-2023/4-3-2023 - PID Tuning - Corrected PID D - (P 013 PA 025 D 1) - Disable Major RPM Change.xlsx

Sheet: 4-3-2023 - PID Tuning - Correct
Time | RPM | Steps Remaining | PID p | PID pAlt | PID d | RPM Change | P Cmd | P Alt Cmd | D Cmd
1650 | 0 | 0 | 0 | 0 | 0 | 0 | 0 | 0 | 0
1700 | 0 | 0 | 0 | 0 | 0 | 0 | 0 | 0 | 0
1750 | 0 | 0 | 0 | 0 | 0 | 0 | 0 | 0 | 0
1800 | 0 | 0 | 0 | 0 | 0 | 0 | 0 | 0 | 0
1850 | 0 | 0 | 0 | 0 | 0 | 0 | 0 | 0 | 0
1900 | 0 | 0 | 0 | 0 | 0 | 0 | 0 | 0 | 0
1950 | 0 | 0 | 0 | 0 | 0 | 0 | 0 | 0 | 0
2000 | 0 | 0 | 0 | 0 | 0 | 0 | 0 | 0 | 0
2050 | 0 | 0 | 0 | 0 | 0 | 0 | 0 | 0 | 0
2100 | 0 | 0 | 0 | 0 | 0 | 0 | 0 | 0 | 0
2150 | 0 | 0 | 0 | 0 | 0 | 0 | 0 | 0 | 0
2200 | 0 | 0 | 0 | 0 | 0 | 0 | 0 | 0 | 0
2250 | 0 | 0 | 0 | 0 | 0 | 0 | 0 | 0 | 0
2300 | 0 | 0 | 0 | 0 | 0 | 0 | 0 | 0 | 0
2350 | 0 | 0 | 0 | 0 | 0 | 0 | 0 | 0 | 0
2400 | 0 | 0 | 0 | 0 | 0 | 0 | 0 | 0 | 0
2450 | 0 | 0 | 0 | 0 | 0 | 0 | 0 | 0 | 0
2500 | 0 | 0 | 0 | 0 | 0 | 0 | 0 | 0 | 0
2550 | inf | 0 | 0 | 0 | 0 | inf | 0 | 0 | 0
2600 | inf | 0 | 0 | 0 | 0 | inf | 0 | 0 | 0
2650 | 483.11 | 16 | 40 | 0 | 0 | inf | 40 | 0 | 0
2700 | 483.11 | 0 | 40 | 0 | 0 | inf | 40 | 0 | 0
2750 | 555.16 | 23 | 39 | 0 | 0 | -72.06 | 79 | 0 | 0
2800 | 944.11 | 25 | 34 | 0 | -6 | -388.94 | 113 | 0 | 6
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
