december454/Microcontroller-Engine-Governor/Data-Logging/4-3-2023/4-3-2023 - PID Tuning - Corrected PID P Alt - (P 013 PA 025 D 0) - Disable Major RPM Change.xlsx

Sheet: 4-3-2023 - PID Tuning - Correct
Time | RPM | Steps Remaining | PID p | PID pAlt | PID d | RPM Change | P Cmd | P Alt Cmd | D Cmd
1742 | 0 | 0 | 0 | 0 | 0 | 0 | 0 | 0 | 0
1792 | 0 | 0 | 0 | 0 | 0 | 0 | 0 | 0 | 0
1842 | 0 | 0 | 0 | 0 | 0 | 0 | 0 | 0 | 0
1892 | 0 | 0 | 0 | 0 | 0 | 0 | 0 | 0 | 0
1942 | 0 | 0 | 0 | 0 | 0 | 0 | 0 | 0 | 0
1992 | 0 | 0 | 0 | 0 | 0 | 0 | 0 | 0 | 0
2042 | 0 | 0 | 0 | 0 | 0 | 0 | 0 | 0 | 0
2092 | 0 | 0 | 0 | 0 | 0 | 0 | 0 | 0 | 0
2142 | 0 | 0 | 0 | 0 | 0 | 0 | 0 | 0 | 0
2192 | 0 | 0 | 0 | 0 | 0 | 0 | 0 | 0 | 0
2242 | 0 | 0 | 0 | 0 | 0 | 0 | 0 | 0 | 0
2292 | 0 | 0 | 0 | 0 | 0 | 0 | 0 | 0 | 0
2342 | 0 | 0 | 0 | 0 | 0 | 0 | 0 | 0 | 0
2392 | 0 | 0 | 0 | 0 | 0 | 0 | 0 | 0 | 0
2442 | 0 | 0 | 0 | 0 | 0 | 0 | 0 | 0 | 0
2492 | 0 | 0 | 0 | 0 | 0 | 0 | 0 | 0 | 0
2542 | 0 | 0 | 0 | 0 | 0 | 0 | 0 | 0 | 0
2592 | 0 | 0 | 0 | 0 | 0 | 0 | 0 | 0 | 0
2642 | 0 | 0 | 0 | 0 | 0 | 0 | 0 | 0 | 0
2692 | 0 | 0 | 0 | 0 | 0 | 0 | 0 | 0 | 0
2742 | 0 | 0 | 0 | 0 | 0 | 0 | 0 | 0 | 0
2792 | 0 | 0 | 0 | 0 | 0 | 0 | 0 | 0 | 0
2842 | 0 | 0 | 0 | 0 | 0 | 0 | 0 | 0 | 0
2892 | 0 | 0 | 0 | 0 | 0 | 0 | 0 | 0 | 0
2942 | 0 | 0 | 0 | 0 | 0 | 0 | 0 | 0 | 0
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
