december454/Microcontroller-Engine-Governor/Data-Logging/4-3-2023/4-3-2023 - PID Tuning - Corrected PID P Alt - (P 013 PA 025 D 1) - Disable Major RPM Change.xlsx

Sheet: 4-3-2023 - PID Tuning - Correct
Time | RPM | Steps Remaining | PID p | PID pAlt | PID d | RPM Change | P Cmd | P Alt Cmd | D Cmd
1659 | 0 | 0 | 0 | 0 | 0 | 0 | 0 | 0 | 0
1709 | 0 | 0 | 0 | 0 | 0 | 0 | 0 | 0 | 0
1759 | 0 | 0 | 0 | 0 | 0 | 0 | 0 | 0 | 0
1809 | 0 | 0 | 0 | 0 | 0 | 0 | 0 | 0 | 0
1859 | 0 | 0 | 0 | 0 | 0 | 0 | 0 | 0 | 0
1909 | 0 | 0 | 0 | 0 | 0 | 0 | 0 | 0 | 0
1959 | 0 | 0 | 0 | 0 | 0 | 0 | 0 | 0 | 0
2009 | 0 | 0 | 0 | 0 | 0 | 0 | 0 | 0 | 0
2059 | 0 | 0 | 0 | 0 | 0 | 0 | 0 | 0 | 0
2109 | 0 | 0 | 0 | 0 | 0 | 0 | 0 | 0 | 0
2159 | 0 | 0 | 0 | 0 | 0 | 0 | 0 | 0 | 0
2209 | 0 | 0 | 0 | 0 | 0 | 0 | 0 | 0 | 0
2259 | 0 | 0 | 0 | 0 | 0 | 0 | 0 | 0 | 0
2309 | 0 | 0 | 0 | 0 | 0 | 0 | 0 | 0 | 0
2359 | 0 | 0 | 0 | 0 | 0 | 0 | 0 | 0 | 0
2409 | 0 | 0 | 0 | 0 | 0 | 0 | 0 | 0 | 0
2459 | 0 | 0 | 0 | 0 | 0 | 0 | 0 | 0 | 0
2509 | 0 | 0 | 0 | 0 | 0 | 0 | 0 | 0 | 0
2560 | 0 | 0 | 0 | 0 | 0 | 0 | 0 | 0 | 0
2610 | 0 | 0 | 0 | 0 | 0 | 0 | 0 | 0 | 0
2660 | 0 | 0 | 0 | 0 | 0 | 0 | 0 | 0 | 0
2710 | 0 | 0 | 0 | 0 | 0 | 0 | 0 | 0 | 0
2760 | 0 | 0 | 0 | 0 | 0 | 0 | 0 | 0 | 0
2810 | 0 | 0 | 0 | 0 | 0 | 0 | 0 | 0 | 0
2860 | 0 | 0 | 0 | 0 | 0 | 0 | 0 | 0 | 0
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
