december454/Microcontroller-Engine-Governor/Data-Logging/4-3-2023/4-3-2023 - PID Tuning - PID P Alt - (P 013 PA 025 D 1) - Disable Major RPM Change.xlsx

Sheet: 4-3-2023 - PID Tuning - PID P A
Time | RPM | Steps Remaining | PID p | PID pAlt | PID d | RPM Change | P Cmd | P Alt Cmd | D Cmd
1753 | 0 | 0 | 0 | 0 | 0 | 0 | 0 | 0 | 0
1803 | 0 | 0 | 0 | 0 | 0 | 0 | 0 | 0 | 0
1853 | 0 | 0 | 0 | 0 | 0 | 0 | 0 | 0 | 0
1903 | 0 | 0 | 0 | 0 | 0 | 0 | 0 | 0 | 0
1953 | 0 | 0 | 0 | 0 | 0 | 0 | 0 | 0 | 0
2003 | 0 | 0 | 0 | 0 | 0 | 0 | 0 | 0 | 0
2053 | 0 | 0 | 0 | 0 | 0 | 0 | 0 | 0 | 0
2103 | 0 | 0 | 0 | 0 | 0 | 0 | 0 | 0 | 0
2153 | 0 | 0 | 0 | 0 | 0 | 0 | 0 | 0 | 0
2203 | 0 | 0 | 0 | 0 | 0 | 0 | 0 | 0 | 0
2253 | 0 | 0 | 0 | 0 | 0 | 0 | 0 | 0 | 0
2304 | 0 | 0 | 0 | 0 | 0 | 0 | 0 | 0 | 0
2354 | 0 | 0 | 0 | 0 | 0 | 0 | 0 | 0 | 0
2404 | 0 | 0 | 0 | 0 | 0 | 0 | 0 | 0 | 0
2454 | 0 | 0 | 0 | 0 | 0 | 0 | 0 | 0 | 0
2504 | 0 | 0 | 0 | 0 | 0 | 0 | 0 | 0 | 0
2554 | 0 | 0 | 0 | 0 | 0 | 0 | 0 | 0 | 0
2604 | 0 | 0 | 0 | 0 | 0 | 0 | 0 | 0 | 0
2654 | 0 | 0 | 0 | 0 | 0 | 0 | 0 | 0 | 0
2704 | 0 | 0 | 0 | 0 | 0 | 0 | 0 | 0 | 0
2754 | 0 | 0 | 0 | 0 | 0 | 0 | 0 | 0 | 0
2804 | 0 | 0 | 0 | 0 | 0 | 0 | 0 | 0 | 0
2854 | 0 | 0 | 0 | 0 | 0 | 0 | 0 | 0 | 0
2904 | 0 | 0 | 0 | 0 | 0 | 0 | 0 | 0 | 0
2954 | 0 | 0 | 0 | 0 | 0 | 0 | 0 | 0 | 0
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
