december454/Microcontroller-Engine-Governor/Data-Logging/4-3-2023/4-3-2023 - PID Tuning - PID P Alt - (P 013 PA 025 D 1).xlsx

Sheet: 4-3-2023 - PID Tuning - PID P A
Time | RPM | Steps Remaining | PID p | PID pAlt | PID d | RPM Change | P Cmd | P Alt Cmd | D Cmd
1641 | 0 | 0 | 0 | 0 | 0 | 0 | 0 | 0 | 0
1691 | 0 | 0 | 0 | 0 | 0 | 0 | 0 | 0 | 0
1741 | 0 | 0 | 0 | 0 | 0 | 0 | 0 | 0 | 0
1792 | 0 | 0 | 0 | 0 | 0 | 0 | 0 | 0 | 0
1842 | 0 | 0 | 0 | 0 | 0 | 0 | 0 | 0 | 0
1892 | 0 | 0 | 0 | 0 | 0 | 0 | 0 | 0 | 0
1942 | 0 | 0 | 0 | 0 | 0 | 0 | 0 | 0 | 0
1992 | 0 | 0 | 0 | 0 | 0 | 0 | 0 | 0 | 0
2042 | 0 | 0 | 0 | 0 | 0 | 0 | 0 | 0 | 0
2092 | 0 | 0 | 0 | 0 | 0 | 0 | 0 | 0 | 0
2142 | 0 | 0 | 0 | 0 | 0 | 0 | 0 | 0 | 0
2192 | 0 | 0 | 0 | 0 | 0 | 0 | 0 | 0 | 0
2242 | 0 | 0 | 0 | 0 | 0 | 0 | 0 | 0 | 0
2292 | 0 | 0 | 0 | 0 | 0 | 0 | 0 | 0 | 0
2342 | 0 | 0 | 0 | 0 | 0 | 0 | 0 | 0 | 0
2392 | 0 | 0 | 0 | 0 | 0 | 0 | 0 | 0 | 0
2442 | 0 | 0 | 0 | 0 | 0 | 0 | 0 | 0 | 0
2492 | 0 | 0 | 0 | 0 | 0 | 0 | 0 | 0 | 0
2542 | 0 | 0 | 0 | 0 | 0 | 0 | 0 | 0 | 0
2592 | 0 | 0 | 0 | 0 | 0 | 0 | 0 | 0 | 0
2642 | 0 | 0 | 0 | 0 | 0 | 0 | 0 | 0 | 0
2692 | 0 | 0 | 0 | 0 | 0 | 0 | 0 | 0 | 0
2742 | 0 | 0 | 0 | 0 | 0 | 0 | 0 | 0 | 0
2792 | 0 | 0 | 0 | 0 | 0 | 0 | 0 | 0 | 0
2842 | 0 | 0 | 0 | 0 | 0 | 0 | 0 | 0 | 0
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
