december454/Microcontroller-Engine-Governor/Data-Logging/3-10-2023/3-10-2023 - Simulator - Microseconds Test (Control - Milliseconds).xlsx

Sheet: 3-10-2023 - Simulator - Microse
Time | RPM | Steps Remaining | PID p | PID i | PID d
100 | 0 | 0 | 0 | 0 | 0
200 | inf | 0 | 0 | 0 | 0
300 | 500 | 0 | 0 | 0 | 0
400 | 500 | 0 | 0 | 0 | 0
500 | 504.2 | 0 | -4 | 0 | 0
600 | 504.2 | 0 | -4 | 0 | 0
700 | 504.2 | 0 | -4 | 0 | 0
800 | 500 | 0 | -4 | 0 | 0
900 | 495.87 | 0 | 4 | 0 | 0
1000 | 500 | 0 | 4 | 0 | 0
1100 | 500 | 0 | 4 | 0 | 0
1200 | 500 | 0 | 4 | 0 | 0
1300 | 500 | 0 | 4 | 0 | 0
1400 | 504.2 | 0 | -4 | 0 | 0
1500 | 495.87 | 0 | 4 | 0 | 0
1600 | 500 | 0 | 4 | 0 | 0
1700 | 500 | 0 | 4 | 0 | 0
1800 | 495.87 | 2 | 4 | 0 | 0
1900 | 495.87 | 0 | 4 | 0 | 0
2000 | 504.2 | 0 | -4 | 0 | 0
2100 | 500 | 0 | -4 | 0 | 0
2200 | 495.87 | 0 | 4 | 0 | 0
2300 | 500 | 0 | 4 | 0 | 0
2400 | 495.87 | 3 | 4 | 0 | 0
2501 | 495.87 | 0 | 4 | 0 | 0
2601 | 500 | 0 | 4 | 0 | 0
2701 | 504.2 | 0 | -4 | 0 | 0
2801 | 495.87 | 0 | 4 | 0 | 0
2902 | 500 | 0 | 4 | 0 | 0
3002 | 500 | 0 | 4 | 0 | 0
3102 | 500 | 0 | 4 | 0 | 0
3202 | 500 | 0 | 4 | 0 | 0
3302 | 500 | 0 | 4 | 0 | 0
3402 | 500 | 0 | 4 | 0 | 0
3502 | 500 | 0 | 4 | 0 | 0
3602 | 500 | 0 | 4 | 0 | 0
3702 | 500 | 0 | 4 | 0 | 0
3802 | 500 | 0 | 4 | 0 | 0
3902 | 504.2 | 0 | -4 | 0 | 0
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
