december454/Microcontroller-Engine-Governor/Data-Logging/3-10-2023/3-10-2023 - Simulator - Microseconds Test.xlsx

Sheet: 3-10-2023 - Simulator - Microse
Time | RPM | Steps Remaining | PID p | PID i | PID d
100 | 0 | 0 | 0 | 0 | 0
200 | inf | 0 | 0 | 0 | 0
300 | 503.74 | 0 | -4 | 0 | 0
400 | 503.02 | 0 | -3 | 0 | 0
500 | 502.87 | 0 | -3 | 0 | 0
600 | 502.97 | 0 | -3 | 0 | 0
700 | 502.97 | 0 | -3 | 0 | 0
800 | 503.76 | 0 | -4 | 0 | 0
900 | 504.15 | 0 | -4 | 0 | 0
1000 | 504.41 | 0 | -4 | 0 | 0
1100 | 503.39 | 0 | -3 | 0 | 0
1200 | 502.6 | 0 | -2 | 0 | 0
1300 | 502.6 | 0 | -2 | 0 | 0
1400 | 501.57 | 0 | -2 | 0 | 0
1500 | 501.72 | 0 | -2 | 0 | 0
1600 | 502.28 | 0 | -2 | 0 | 0
1700 | 502.13 | 0 | -2 | 0 | 0
1800 | 503.25 | 0 | -3 | 0 | 0
1900 | 503.25 | 0 | -3 | 0 | 0
2000 | 501.25 | 0 | -3 | 0 | 0
2100 | 504.3 | 0 | -4 | 0 | 0
2200 | 503.1 | 0 | -3 | 0 | 0
2300 | 502.19 | 0 | -2 | 0 | 0
2400 | 501.59 | 0 | -2 | 0 | 0
2500 | 501.71 | 0 | -2 | 0 | 0
2600 | 501.71 | 0 | -2 | 0 | 0
2700 | 501.61 | 0 | -2 | 0 | 0
2800 | 501.86 | 0 | -2 | 0 | 0
2900 | 501.71 | 0 | -2 | 0 | 0
3000 | 501.29 | 0 | -2 | 0 | 0
3100 | 501.84 | 0 | -2 | 0 | 0
3200 | 501.84 | 0 | -2 | 0 | 0
3300 | 501.35 | 0 | -2 | 0 | 0
3400 | 502.23 | 0 | -2 | 0 | 0
3500 | 501.74 | 0 | -2 | 0 | 0
3600 | 500.35 | 0 | -2 | 0 | 0
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
