december454/Microcontroller-Engine-Governor/Data-Logging/3-24-2023/3-24-2023 - PID Tuning - (I 005) 2.xlsx

Sheet: 3-24-2023 - PID Tuning - (I 003
Time | RPM | Steps Remaining | PID p | PID i | PID d
1810 | 0 | 0 | 0 | 0 | 0
1860 | 0 | 0 | 0 | 0 | 0
1910 | 0 | 0 | 0 | 0 | 0
1960 | 0 | 0 | 0 | 0 | 0
2010 | 0 | 0 | 0 | 0 | 0
2060 | 0 | 0 | 0 | 0 | 0
2110 | 0 | 0 | 0 | 0 | 0
2160 | 0 | 0 | 0 | 0 | 0
2210 | 0 | 0 | 0 | 0 | 0
2260 | 0 | 0 | 0 | 0 | 0
2310 | 0 | 0 | 0 | 0 | 0
2360 | 0 | 0 | 0 | 0 | 0
2410 | 0 | 0 | 0 | 0 | 0
2460 | 0 | 0 | 0 | 0 | 0
2510 | 0 | 0 | 0 | 0 | 0
2560 | 0 | 0 | 0 | 0 | 0
2610 | 0 | 0 | 0 | 0 | 0
2660 | 0 | 0 | 0 | 0 | 0
2710 | 0 | 0 | 0 | 0 | 0
2760 | 0 | 0 | 0 | 0 | 0
2810 | 0 | 0 | 0 | 0 | 0
2860 | 0 | 0 | 0 | 0 | 0
2910 | 0 | 0 | 0 | 0 | 0
2960 | 0 | 0 | 0 | 0 | 0
3010 | 0 | 0 | 0 | 0 | 0
3060 | 0 | 0 | 0 | 0 | 0
3110 | 0 | 0 | 0 | 0 | 0
3160 | 0 | 0 | 0 | 0 | 0
3210 | 0 | 0 | 0 | 0 | 0
3260 | 0 | 0 | 0 | 0 | 0
3310 | 0 | 0 | 0 | 0 | 0
3360 | 0 | 0 | 0 | 0 | 0
3410 | 0 | 0 | 0 | 0 | 0
3460 | 0 | 0 | 0 | 0 | 0
3510 | 0 | 0 | 0 | 0 | 0
3560 | 0 | 0 | 0 | 0 | 0
3610 | 0 | 0 | 0 | 0 | 0
3660 | 0 | 0 | 0 | 0 | 0
3710 | 0 | 0 | 0 | 0 | 0
3760 | 0 | 0 | 0 | 0 | 0
3810 | 0 | 0 | 0 | 0 | 0
3860 | 0 | 0 | 0 | 0 | 0
3910 | 0 | 0 | 0 | 0 | 0
3960 | 0 | 0 | 0 | 0 | 0
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
