december454/Microcontroller-Engine-Governor/Data-Logging/3-24-2023/3-27-2023 - PID Tuning - (P 02 I 005 D 8) .xlsx

Sheet: 3-27-2023 - PID Tuning - (P 02
Time | RPM | Steps Remaining | PID p | PID i | PID d
1617 | 0 | 0 | 0 | 0 | 0
1667 | 0 | 0 | 0 | 0 | 0
1717 | 0 | 0 | 0 | 0 | 0
1767 | 0 | 0 | 0 | 0 | 0
1817 | 0 | 0 | 0 | 0 | 0
1867 | 0 | 0 | 0 | 0 | 0
1917 | 0 | 0 | 0 | 0 | 0
1967 | 0 | 0 | 0 | 0 | 0
2017 | 0 | 0 | 0 | 0 | 0
2067 | 0 | 0 | 0 | 0 | 0
2117 | 0 | 0 | 0 | 0 | 0
2167 | 0 | 0 | 0 | 0 | 0
2217 | 0 | 0 | 0 | 0 | 0
2267 | 0 | 0 | 0 | 0 | 0
2317 | 0 | 0 | 0 | 0 | 0
2367 | 0 | 0 | 0 | 0 | 0
2417 | 0 | 0 | 0 | 0 | 0
2467 | 0 | 0 | 0 | 0 | 0
2518 | 0 | 0 | 0 | 0 | 0
2568 | 0 | 0 | 0 | 0 | 0
2618 | 0 | 0 | 0 | 0 | 0
2668 | 0 | 0 | 0 | 0 | 0
2718 | 0 | 0 | 0 | 0 | 0
2768 | 0 | 0 | 0 | 0 | 0
2818 | 0 | 0 | 0 | 0 | 0
2868 | 0 | 0 | 0 | 0 | 0
2918 | 0 | 0 | 0 | 0 | 0
2968 | 0 | 0 | 0 | 0 | 0
3018 | 0 | 0 | 0 | 0 | 0
3068 | 0 | 0 | 0 | 0 | 0
3118 | 0 | 0 | 0 | 0 | 0
3168 | 0 | 0 | 0 | 0 | 0
3218 | 0 | 0 | 0 | 0 | 0
3268 | 0 | 0 | 0 | 0 | 0
3318 | 0 | 0 | 0 | 0 | 0
3368 | 0 | 0 | 0 | 0 | 0
3418 | 0 | 0 | 0 | 0 | 0
3468 | 0 | 0 | 0 | 0 | 0
3518 | 0 | 0 | 0 | 0 | 0
3568 | 0 | 0 | 0 | 0 | 0
3618 | 0 | 0 | 0 | 0 | 0
3668 | 0 | 0 | 0 | 0 | 0
3718 | 0 | 0 | 0 | 0 | 0
3768 | 0 | 0 | 0 | 0 | 0
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
