december454/Microcontroller-Engine-Governor/Data-Logging/3-27-2023/3-27-2023 - PID Tuning - (P 02 I 005 D 10) .xlsx

Sheet: 3-27-2023 - PID Tuning - (P 02
Time | RPM | Steps Remaining | PID p | PID i | PID d
1528 | 0 | 0 | 0 | 0 | 0
1579 | 0 | 0 | 0 | 0 | 0
1629 | 0 | 0 | 0 | 0 | 0
1679 | 0 | 0 | 0 | 0 | 0
1729 | 0 | 0 | 0 | 0 | 0
1779 | 0 | 0 | 0 | 0 | 0
1829 | 0 | 0 | 0 | 0 | 0
1879 | 0 | 0 | 0 | 0 | 0
1929 | 0 | 0 | 0 | 0 | 0
1979 | 0 | 0 | 0 | 0 | 0
2029 | 0 | 0 | 0 | 0 | 0
2079 | 0 | 0 | 0 | 0 | 0
2129 | 0 | 0 | 0 | 0 | 0
2179 | 0 | 0 | 0 | 0 | 0
2229 | 0 | 0 | 0 | 0 | 0
2279 | 0 | 0 | 0 | 0 | 0
2329 | 0 | 0 | 0 | 0 | 0
2379 | 0 | 0 | 0 | 0 | 0
2429 | 0 | 0 | 0 | 0 | 0
2479 | 0 | 0 | 0 | 0 | 0
2529 | 0 | 0 | 0 | 0 | 0
2579 | 0 | 0 | 0 | 0 | 0
2629 | 0 | 0 | 0 | 0 | 0
2679 | 0 | 0 | 0 | 0 | 0
2729 | 0 | 0 | 0 | 0 | 0
2779 | 0 | 0 | 0 | 0 | 0
2829 | 0 | 0 | 0 | 0 | 0
2879 | 0 | 0 | 0 | 0 | 0
2929 | 0 | 0 | 0 | 0 | 0
2979 | 0 | 0 | 0 | 0 | 0
3030 | 0 | 0 | 0 | 0 | 0
3080 | 0 | 0 | 0 | 0 | 0
3130 | 0 | 0 | 0 | 0 | 0
3180 | 0 | 0 | 0 | 0 | 0
3230 | 0 | 0 | 0 | 0 | 0
3280 | 0 | 0 | 0 | 0 | 0
3330 | 0 | 0 | 0 | 0 | 0
3380 | 0 | 0 | 0 | 0 | 0
3430 | 0 | 0 | 0 | 0 | 0
3480 | 0 | 0 | 0 | 0 | 0
3530 | 0 | 0 | 0 | 0 | 0
3580 | 0 | 0 | 0 | 0 | 0
3630 | 0 | 0 | 0 | 0 | 0
3680 | 0 | 0 | 0 | 0 | 0
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
