december454/Microcontroller-Engine-Governor/Data-Logging/3-27-2023/3-27-2023 - PID Tuning - (P 02 I 005 D 6) .xlsx

Sheet: 3-27-2023 - PID Tuning - (P 02
Time | RPM | Steps Remaining | PID p | PID i | PID d
1543 | 0 | 0 | 0 | 0 | 0
1593 | 0 | 0 | 0 | 0 | 0
1643 | 0 | 0 | 0 | 0 | 0
1693 | 0 | 0 | 0 | 0 | 0
1743 | 0 | 0 | 0 | 0 | 0
1793 | 0 | 0 | 0 | 0 | 0
1843 | 0 | 0 | 0 | 0 | 0
1893 | 0 | 0 | 0 | 0 | 0
1943 | 0 | 0 | 0 | 0 | 0
1993 | 0 | 0 | 0 | 0 | 0
2043 | 0 | 0 | 0 | 0 | 0
2093 | 0 | 0 | 0 | 0 | 0
2143 | 0 | 0 | 0 | 0 | 0
2193 | 0 | 0 | 0 | 0 | 0
2243 | 0 | 0 | 0 | 0 | 0
2293 | 0 | 0 | 0 | 0 | 0
2343 | 0 | 0 | 0 | 0 | 0
2393 | 0 | 0 | 0 | 0 | 0
2443 | 0 | 0 | 0 | 0 | 0
2493 | 0 | 0 | 0 | 0 | 0
2543 | 0 | 0 | 0 | 0 | 0
2593 | 0 | 0 | 0 | 0 | 0
2643 | 0 | 0 | 0 | 0 | 0
2693 | 0 | 0 | 0 | 0 | 0
2743 | 0 | 0 | 0 | 0 | 0
2793 | 0 | 0 | 0 | 0 | 0
2843 | 0 | 0 | 0 | 0 | 0
2893 | 0 | 0 | 0 | 0 | 0
2944 | 0 | 0 | 0 | 0 | 0
2994 | 0 | 0 | 0 | 0 | 0
3044 | 0 | 0 | 0 | 0 | 0
3094 | 0 | 0 | 0 | 0 | 0
3144 | 0 | 0 | 0 | 0 | 0
3194 | inf | 0 | 0 | 0 | 0
3244 | inf | 0 | 0 | 0 | 0
3294 | 471.03 | 55 | 62 | 0 | 0
3344 | 471.03 | 6 | 62 | 0 | 0
3394 | 1002 | 0 | 51 | 0 | -53
3444 | 959.26 | 21 | 52 | 0 | 4
3494 | 949.37 | 31 | 53 | 0 | 0
3544 | 928.05 | 48 | 53 | 0 | 1
3594 | 1253.97 | 0 | 46 | 0 | -39
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
