december454/Microcontroller-Engine-Governor/Data-Logging/3-27-2023/3-27-2023 - PID Tuning - (P 02 I 005 D 7) .xlsx

Sheet: 3-27-2023 - PID Tuning - (P 02
Time | RPM | Steps Remaining | PID p | PID i | PID d
87 | inf | 0 | 0 | 0 | 0
137 | 3586.8 | 0 | 0 | 0 | 0
187 | 3541.08 | 0 | 0 | 0 | 0
237 | 3554.5 | 0 | 0 | 0 | 0
287 | 3610.11 | 0 | 0 | 0 | 0
337 | 3583.37 | 0 | 0 | 0 | 0
387 | 3647.86 | 0 | 0 | 0 | 0
437 | 3598.85 | 0 | 0 | 0 | 0
487 | 3604.9 | 0 | 0 | 0 | 0
537 | 3582.52 | 0 | 0 | 0 | 0
587 | 3576.54 | 0 | 0 | 0 | 0
637 | 3573.13 | 0 | 0 | 0 | 0
687 | 3623.19 | 0 | 0 | 0 | 0
737 | 3610.11 | 0 | 0 | 0 | 0
787 | 3656.75 | 0 | 0 | 0 | 0
837 | 3646.09 | 0 | 0 | 0 | 0
887 | 3619.69 | 0 | 0 | 0 | 0
937 | 3619.69 | 0 | 0 | 0 | 0
987 | 3656.75 | 0 | 0 | 0 | 0
1037 | 3628.45 | 0 | 0 | 0 | 0
1087 | 3628.45 | 0 | 0 | 0 | 0
1137 | 3656.75 | 0 | 0 | 0 | 0
1187 | 3638.13 | 0 | 0 | 0 | 0
1238 | 3618.82 | 0 | 0 | 0 | 0
1288 | 3619.69 | 0 | 0 | 0 | 0
1338 | 3623.19 | 0 | 0 | 0 | 0
1388 | 3601.44 | 0 | 0 | 0 | 0
1438 | 3638.13 | 0 | 0 | 0 | 0
1488 | 3638.13 | 0 | 0 | 0 | 0
1538 | 3666.59 | 0 | 0 | 0 | 0
1588 | 3657.64 | 0 | 0 | 0 | 0
1638 | 3705.53 | 0 | 0 | 0 | 0
1688 | 3675.57 | 0 | 0 | 0 | 0
1738 | 3657.64 | 0 | 0 | 0 | 0
1788 | 3638.13 | 0 | 0 | 0 | 0
1838 | 3610.11 | 0 | 0 | 0 | 0
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
