december454/Microcontroller-Engine-Governor/Data-Logging/3-27-2023/3-27-2023 - PID Tuning - (P 02 I 005 D 8) - Load.xlsx

Sheet: 3-27-2023 - PID Tuning - (P 02
Time | RPM | Steps Remaining | PID p | PID i | PID d
1720 | 0 | 0 | 0 | 0 | 0
1770 | 0 | 0 | 0 | 0 | 0
1820 | 0 | 0 | 0 | 0 | 0
1870 | 0 | 0 | 0 | 0 | 0
1920 | 0 | 0 | 0 | 0 | 0
1970 | 0 | 0 | 0 | 0 | 0
2020 | 0 | 0 | 0 | 0 | 0
2070 | 0 | 0 | 0 | 0 | 0
2120 | 0 | 0 | 0 | 0 | 0
2170 | 0 | 0 | 0 | 0 | 0
2220 | inf | 0 | 0 | 0 | 0
2270 | inf | 0 | 0 | 0 | 0
2320 | inf | 0 | 0 | 0 | 0
2370 | 475.24 | 37 | 62 | 0 | 0
2420 | 475.24 | 0 | 62 | 0 | 0
2470 | 546.09 | 40 | 61 | 0 | -5
2520 | 546.09 | 0 | 61 | 0 | -5
2570 | 822.28 | 0 | 55 | 0 | -30
2620 | 815 | 36 | 55 | 0 | 0
2670 | 1157.41 | 0 | 48 | 0 | -51
2720 | 1180.36 | 29 | 48 | 0 | -3
2770 | 1499.1 | 0 | 42 | 0 | -62
2820 | 1766.58 | -14 | 36 | 0 | -52
2870 | 1779.36 | 14 | 36 | 0 | -3
2920 | 2008.03 | 18 | 31 | 0 | -4
2970 | 2191.7 | 24 | 28 | 0 | 0
3020 | 2332.81 | 39 | 25 | 0 | 17
3070 | 2521.86 | 2 | 21 | 0 | -14
3120 | 2560.16 | 20 | 20 | 0 | 8
3170 | 2616.89 | 0 | 19 | 0 | -8
3220 | 2712.97 | 0 | 17 | 0 | 1
3270 | 3009.63 | -85 | 11 | 0 | -101
3320 | 3008.42 | -45 | 11 | 0 | -70
3371 | 3108.81 | 0 | 9 | 0 | -7
3421 | 3186.07 | 23 | 8 | 0 | 34
3471 | 3485.94 | 0 | 2 | 0 | 0
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
