december454/Microcontroller-Engine-Governor/Data-Logging/3-27-2023/3-27-2023 - PID Tuning - D Major RPM Change - (P 02 I 0 D 8) - Load.xlsx

Sheet: 3-27-2023 - PID Tuning - D Majo
Time | RPM | Steps Remaining | PID p | PID i | PID d
1735 | 0 | 0 | 0 | 0 | 0
1785 | 0 | 0 | 0 | 0 | 0
1835 | 0 | 0 | 0 | 0 | 0
1885 | 0 | 0 | 0 | 0 | 0
1935 | 0 | 0 | 0 | 0 | 0
1985 | 0 | 0 | 0 | 0 | 0
2035 | 0 | 0 | 0 | 0 | 0
2085 | 0 | 0 | 0 | 0 | 0
2135 | 0 | 0 | 0 | 0 | 0
2185 | 0 | 0 | 0 | 0 | 0
2235 | 0 | 0 | 0 | 0 | 0
2285 | 0 | 0 | 0 | 0 | 0
2335 | 0 | 0 | 0 | 0 | 0
2385 | 0 | 0 | 0 | 0 | 0
2435 | 0 | 0 | 0 | 0 | 0
2485 | 0 | 0 | 0 | 0 | 0
2535 | 0 | 0 | 0 | 0 | 0
2585 | 0 | 0 | 0 | 0 | 0
2635 | 0 | 0 | 0 | 0 | 0
2685 | 0 | 0 | 0 | 0 | 0
2735 | 0 | 0 | 0 | 0 | 0
2785 | 0 | 0 | 0 | 0 | 0
2835 | 0 | 0 | 0 | 0 | 0
2885 | 0 | 0 | 0 | 0 | 0
2935 | 0 | 0 | 0 | 0 | 0
2985 | 0 | 0 | 0 | 0 | 0
3035 | 0 | 0 | 0 | 0 | 0
3085 | 0 | 0 | 0 | 0 | 0
3135 | 0 | 0 | 0 | 0 | 0
3185 | 0 | 0 | 0 | 0 | 0
3235 | 0 | 0 | 0 | 0 | 0
3286 | 0 | 0 | 0 | 0 | 0
3336 | 0 | 0 | 0 | 0 | 0
3386 | 0 | 0 | 0 | 0 | 0
3436 | 0 | 0 | 0 | 0 | 0
3486 | 0 | 0 | 0 | 0 | 0
3536 | 0 | 0 | 0 | 0 | 0
3586 | 0 | 0 | 0 | 0 | 0
3636 | 0 | 0 | 0 | 0 | 0
3686 | 0 | 0 | 0 | 0 | 0
3736 | 0 | 0 | 0 | 0 | 0
3786 | 0 | 0 | 0 | 0 | 0
3836 | 0 | 0 | 0 | 0 | 0
3886 | 0 | 0 | 0 | 0 | 0
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
