december454/Microcontroller-Engine-Governor/Data-Logging/3-27-2023/3-27-2023 - PID Tuning - D Major RPM Change - (P 06 I 0 D 24) - Load 2.xlsx

Sheet: 3-27-2023 - PID Tuning - D Majo
Time | RPM | Steps Remaining | PID p | PID i | PID d | RPM Change
1629 | 0 | 0 | 0 | 0 | 0 | 0
1679 | 0 | 0 | 0 | 0 | 0 | 0
1729 | 0 | 0 | 0 | 0 | 0 | 0
1779 | 0 | 0 | 0 | 0 | 0 | 0
1829 | 0 | 0 | 0 | 0 | 0 | 0
1879 | 0 | 0 | 0 | 0 | 0 | 0
1929 | 0 | 0 | 0 | 0 | 0 | 0
1979 | 0 | 0 | 0 | 0 | 0 | 0
2029 | 0 | 0 | 0 | 0 | 0 | 0
2079 | 0 | 0 | 0 | 0 | 0 | 0
2129 | 0 | 0 | 0 | 0 | 0 | 0
2179 | 0 | 0 | 0 | 0 | 0 | 0
2229 | 0 | 0 | 0 | 0 | 0 | 0
2279 | 0 | 0 | 0 | 0 | 0 | 0
2329 | 0 | 0 | 0 | 0 | 0 | 0
2379 | 0 | 0 | 0 | 0 | 0 | 0
2429 | 0 | 0 | 0 | 0 | 0 | 0
2479 | 0 | 0 | 0 | 0 | 0 | 0
2529 | 0 | 0 | 0 | 0 | 0 | 0
2579 | 0 | 0 | 0 | 0 | 0 | 0
2629 | 0 | 0 | 0 | 0 | 0 | 0
2679 | 0 | 0 | 0 | 0 | 0 | 0
2729 | 0 | 0 | 0 | 0 | 0 | 0
2779 | 0 | 0 | 0 | 0 | 0 | 0
2829 | 0 | 0 | 0 | 0 | 0 | 0
2879 | inf | 0 | 0 | 0 | 0 | inf
2929 | inf | 0 | 0 | 0 | 0 | inf
2979 | inf | 0 | 0 | 0 | 0 | inf
3030 | 491.19 | 147 | 186 | 0 | 0 | inf
3080 | 491.19 | 98 | 186 | 0 | 0 | inf
3130 | 589.07 | 120 | 180 | 0 | -23 | -97.88
3180 | 1010.17 | 0 | 155 | 0 | -171 | -421.1
3230 | 1021.94 | 131 | 154 | 0 | -4 | -11.77
3280 | 1410.17 | -63 | 131 | 0 | -221 | -388.23
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
