december454/Microcontroller-Engine-Governor/Data-Logging/3-27-2023/3-27-2023 - PID Tuning - D Smoothing - (P 03 I 0 D 12) .xlsx

Sheet: 3-27-2023 - PID Tuning - D Smoo
Time | RPM | Steps Remaining | PID p | PID i | PID d | RPM Change
1589 | 0 | 0 | 0 | 0 | 0 | 0
1639 | 0 | 0 | 0 | 0 | 0 | 0
1689 | 0 | 0 | 0 | 0 | 0 | 0
1739 | 0 | 0 | 0 | 0 | 0 | 0
1789 | 0 | 0 | 0 | 0 | 0 | 0
1839 | 0 | 0 | 0 | 0 | 0 | 0
1889 | 0 | 0 | 0 | 0 | 0 | 0
1939 | 0 | 0 | 0 | 0 | 0 | 0
1989 | 0 | 0 | 0 | 0 | 0 | 0
2039 | 0 | 0 | 0 | 0 | 0 | 0
2089 | 0 | 0 | 0 | 0 | 0 | 0
2139 | 0 | 0 | 0 | 0 | 0 | 0
2189 | 0 | 0 | 0 | 0 | 0 | 0
2239 | 0 | 0 | 0 | 0 | 0 | 0
2289 | 0 | 0 | 0 | 0 | 0 | 0
2339 | 0 | 0 | 0 | 0 | 0 | 0
2390 | 0 | 0 | 0 | 0 | 0 | 0
2440 | 0 | 0 | 0 | 0 | 0 | 0
2490 | 0 | 0 | 0 | 0 | 0 | 0
2540 | inf | 0 | 0 | 0 | 0 | inf
2590 | inf | 0 | 0 | 0 | 0 | inf
2640 | 547.67 | 89 | 91 | 0 | 0 | inf
2690 | 547.67 | 41 | 91 | 0 | 0 | inf
2740 | 643.58 | 19600 | 88 | 0 | 19520 | -95.92
2790 | 1076.35 | -15539 | 75 | 0 | -15616 | -432.77
2840 | 1076.35 | -15495 | 75 | 0 | -15616 | -432.77
2890 | 1515.3 | 7609 | 62 | 0 | 7552 | -412.77
2940 | 1586.63 | 29874 | 60 | 0 | 29824 | -71.33
2990 | 1785.29 | 52 | 54 | 0 | 0 | -22.24
3040 | 1990.97 | 26139 | 48 | 0 | 26112 | -205.69
3090 | 2217.29 | -9417 | 41 | 0 | -9472 | -168.11
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
