december454/Microcontroller-Engine-Governor/Data-Logging/3-27-2023/3-27-2023 - PID Tuning - D Smoothing 30 - (P 03 I 0 D 12) .xlsx

Sheet: 3-27-2023 - PID Tuning - D Smoo
Time | RPM | Steps Remaining | PID p | PID i | PID d | RPM Change
2293 | 1074.73 | 27948 | 75 | 0 | 27904 | -516.67
2343 | 1094.97 | 49 | 75 | 0 | 0 | -20.24
2393 | 1415.63 | -28062 | 65 | 0 | -28160 | -320.66
2443 | 1723.35 | 31793 | 56 | 0 | 31744 | -249.29
2493 | 1765.33 | 17824 | 55 | 0 | 17792 | -41.98
2543 | 2022.38 | 26146 | 47 | 0 | 26112 | -84.65
2593 | 2233.47 | 32 | 40 | 0 | 0 | -10.26
2643 | 2397.7 | 27 | 36 | 0 | 0 | 26.35
2693 | 2608.24 | 22 | 29 | 0 | 0 | 44.28
2743 | 2801.64 | 10 | 23 | 0 | 0 | -20.78
2793 | 3260.16 | 6 | 10 | 0 | 0 | -245.09
2843 | 3367 | 2 | 6 | 0 | 0 | -203.11
2893 | 3533.57 | 0 | 1 | 0 | 0 | -132.98
2944 | 3661.22 | 0 | -1 | 0 | 0 | -0.89
2994 | 3882.99 | -4 | -8 | 0 | 0 | -119.82
3044 | 3954.65 | -1 | -10 | 0 | 0 | 6.27
3094 | 4106.21 | -6 | -15 | 0 | 0 | -78.29
3144 | 4356.67 | -20 | -22 | 0 | 0 | -313.54
3194 | 4293.07 | -7 | -20 | 0 | 0 | -268.39
3244 | 4388.53 | -16 | -23 | 0 | 0 | -78.19
3294 | 4285.71 | -18 | -20 | 0 | 0 | 22.15
3344 | 4582.95 | -23 | -29 | 0 | 0 | -557.19
3394 | 4043.13 | -11 | -13 | 0 | 0 | 265.98
3444 | 4332.76 | -10 | -21 | 0 | 0 | -24.89
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
