december454/Microcontroller-Engine-Governor/Data-Logging/3-27-2023/3-27-2023 - PID Tuning - Dynamic D Gain 200 - (P 02 I 0 D 8) .xlsx

Sheet: 3-27-2023 - PID Tuning - Dynami
Time | RPM | Steps Remaining | PID p | PID i | PID d | RPM Change
2122 | inf | 0 | 0 | 0 | 0 | inf
2172 | inf | 0 | 0 | 0 | 0 | inf
2222 | inf | 0 | 0 | 0 | 0 | inf
2272 | 468.22 | 17 | 62 | 0 | 0 | inf
2322 | 468.22 | 0 | 62 | 0 | 0 | inf
2372 | 530.5 | 25 | 61 | 0 | -4 | -62.28
2422 | 872.91 | 2 | 54 | 0 | -39 | -342.4
2472 | 872.91 | 0 | 54 | 0 | -39 | -342.4
2522 | 867.9 | 11 | 54 | 0 | 0 | 5
2572 | 1269.47 | 0 | 46 | 0 | -68 | -401.56
2622 | 1626.9 | -25 | 39 | 0 | -76 | -355.39
2672 | 1647.63 | 9 | 39 | 0 | -4 | -20.73
2722 | 1897.05 | 22 | 34 | 0 | 1 | 6.5
2772 | 2136.75 | 14 | 29 | 0 | -9 | -31.19
2822 | 2304.86 | 21 | 25 | 0 | -1 | -4.95
2872 | 2475.66 | 7 | 22 | 0 | -11 | -34.65
2922 | 2575.55 | 18 | 20 | 0 | 6 | 18.71
2972 | 2743.23 | -1 | 17 | 0 | -32 | -90.71
3022 | 2768.55 | 4 | 16 | 0 | 8 | 23.19
3072 | 2925.12 | -6 | 13 | 0 | -25 | -62.52
3122 | 3021.15 | -18 | 11 | 0 | -45 | -108.53
3172 | 3027.86 | 56 | 11 | 0 | 52 | 138.71
3222 | 3361.72 | -77 | 4 | 0 | -82 | -174.98
3272 | 3340.76 | -31 | 5 | 0 | -51 | -122.56
3322 | 3363.23 | 0 | 4 | 0 | -10 | -23.22
3372 | 3518.65 | 0 | 1 | 0 | 0 | -63.22
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
