december454/Microcontroller-Engine-Governor/Data-Logging/3-27-2023/3-27-2023 - PID Tuning - Dynamic D Gain 240 - (P 02 I 0 D 8) .xlsx

Sheet: 3-27-2023 - PID Tuning - Dynami
Time | RPM | Steps Remaining | PID p | PID i | PID d | RPM Change
1629 | 0 | 0 | 0 | 0 | 0 | 0
1679 | 0 | 0 | 0 | 0 | 0 | 0
1729 | 0 | 0 | 0 | 0 | 0 | 0
1779 | 0 | 0 | 0 | 0 | 0 | 0
1829 | 0 | 0 | 0 | 0 | 0 | 0
1879 | 0 | 0 | 0 | 0 | 0 | 0
1929 | 0 | 0 | 0 | 0 | 0 | 0
1979 | 0 | 0 | 0 | 0 | 0 | 0
2029 | 0 | 0 | 0 | 0 | 0 | 0
2079 | 0 | 0 | 0 | 0 | 0 | 0
2129 | 0 | 0 | 0 | 0 | 0 | 0
2179 | 0 | 0 | 0 | 0 | 0 | 0
2229 | 0 | 0 | 0 | 0 | 0 | 0
2279 | 0 | 0 | 0 | 0 | 0 | 0
2329 | 0 | 0 | 0 | 0 | 0 | 0
2379 | 0 | 0 | 0 | 0 | 0 | 0
2429 | 0 | 0 | 0 | 0 | 0 | 0
2479 | 0 | 0 | 0 | 0 | 0 | 0
2529 | 0 | 0 | 0 | 0 | 0 | 0
2579 | 0 | 0 | 0 | 0 | 0 | 0
2629 | 0 | 0 | 0 | 0 | 0 | 0
2679 | 0 | 0 | 0 | 0 | 0 | 0
2729 | 0 | 0 | 0 | 0 | 0 | 0
2779 | 0 | 0 | 0 | 0 | 0 | 0
2829 | 0 | 0 | 0 | 0 | 0 | 0
2879 | 0 | 0 | 0 | 0 | 0 | 0
2929 | 0 | 0 | 0 | 0 | 0 | 0
2979 | 0 | 0 | 0 | 0 | 0 | 0
3030 | 0 | 0 | 0 | 0 | 0 | 0
3080 | 0 | 0 | 0 | 0 | 0 | 0
3130 | inf | 0 | 0 | 0 | 0 | inf
3180 | inf | 0 | 0 | 0 | 0 | inf
3230 | inf | 0 | 0 | 0 | 0 | inf
3280 | 407.96 | 28 | 63 | 0 | 0 | inf
3330 | 908.21 | 0 | 53 | 0 | -61 | -500.25
3380 | 903.12 | 51 | 53 | 0 | 0 | 5.09
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
