december454/Microcontroller-Engine-Governor/Data-Logging/3-27-2023/3-27-2023 - PID Tuning - Dynamic D Gain 300 - (P 02 I 0 D 8).xlsx

Sheet: 3-27-2023 - (Control) - Dynamic
Time | RPM | Steps Remaining | PID p | PID i | PID d | RPM Change
1629 | 0 | 0 | 0 | 0 | 0 | 0
1679 | 0 | 0 | 0 | 0 | 0 | 0
1729 | 0 | 0 | 0 | 0 | 0 | 0
1779 | 0 | 0 | 0 | 0 | 0 | 0
1829 | 0 | 0 | 0 | 0 | 0 | 0
1879 | 0 | 0 | 0 | 0 | 0 | 0
1929 | 0 | 0 | 0 | 0 | 0 | 0
1979 | 0 | 0 | 0 | 0 | 0 | 0
2029 | 0 | 0 | 0 | 0 | 0 | 0
2079 | 0 | 0 | 0 | 0 | 0 | 0
2129 | 0 | 0 | 0 | 0 | 0 | 0
2179 | 0 | 0 | 0 | 0 | 0 | 0
2229 | 0 | 0 | 0 | 0 | 0 | 0
2279 | 0 | 0 | 0 | 0 | 0 | 0
2329 | 0 | 0 | 0 | 0 | 0 | 0
2379 | 0 | 0 | 0 | 0 | 0 | 0
2429 | 0 | 0 | 0 | 0 | 0 | 0
2479 | 0 | 0 | 0 | 0 | 0 | 0
2529 | 0 | 0 | 0 | 0 | 0 | 0
2579 | inf | 0 | 0 | 0 | 0 | inf
2629 | inf | 0 | 0 | 0 | 0 | inf
2679 | inf | 0 | 0 | 0 | 0 | inf
2729 | inf | 0 | 0 | 0 | 0 | inf
4370 | 2850.12 | 13 | 14 | 0 | 0 | inf
4420 | 5023.44 | -274 | -28 | 0 | -254 | -382.35
4470 | 4643.96 | -13 | -20 | 0 | 0 | -1.44
4520 | 4641.09 | -15 | -20 | 0 | 0 | 1.44
4570 | 4641.09 | -219 | -20 | 0 | -201 | -327.02
4620 | 4312.82 | -3 | -14 | 0 | 0 | 1.24
4670 | 4314.06 | -7 | -14 | 0 | 0 | -1.24
4720 | 4468.28 | -286 | -17 | 0 | -270 | -440.35
4770 | 4027.93 | -1 | -8 | 0 | 0 | 327.47
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
