december454/Microcontroller-Engine-Governor/Data-Logging/3-27-2023/3-27-2023 - PID Tuning - Tuning Dynamic D Gain - (P 02 I 005 D 8) .xlsx

Sheet: 3-27-2023 - PID Tuning - Tuning
Time | RPM | Steps Remaining | PID p | PID i | PID d
1521 | 0 | 0 | 0 | 0 | 0
1571 | 0 | 0 | 0 | 0 | 0
1622 | 0 | 0 | 0 | 0 | 0
1672 | 0 | 0 | 0 | 0 | 0
1722 | 0 | 0 | 0 | 0 | 0
1772 | 0 | 0 | 0 | 0 | 0
1822 | 0 | 0 | 0 | 0 | 0
1872 | 0 | 0 | 0 | 0 | 0
1922 | 0 | 0 | 0 | 0 | 0
1972 | 0 | 0 | 0 | 0 | 0
2022 | 0 | 0 | 0 | 0 | 0
2072 | 0 | 0 | 0 | 0 | 0
2122 | 0 | 0 | 0 | 0 | 0
2172 | 0 | 0 | 0 | 0 | 0
2222 | 0 | 0 | 0 | 0 | 0
2272 | 0 | 0 | 0 | 0 | 0
2322 | 0 | 0 | 0 | 0 | 0
2372 | 0 | 0 | 0 | 0 | 0
2422 | 0 | 0 | 0 | 0 | 0
2472 | 0 | 0 | 0 | 0 | 0
2522 | 0 | 0 | 0 | 0 | 0
2572 | 0 | 0 | 0 | 0 | 0
2622 | 0 | 0 | 0 | 0 | 0
2672 | 0 | 0 | 0 | 0 | 0
2722 | 0 | 0 | 0 | 0 | 0
2772 | 0 | 0 | 0 | 0 | 0
2822 | 0 | 0 | 0 | 0 | 0
2872 | 0 | 0 | 0 | 0 | 0
2922 | 0 | 0 | 0 | 0 | 0
2972 | 0 | 0 | 0 | 0 | 0
3022 | 0 | 0 | 0 | 0 | 0
3072 | 0 | 0 | 0 | 0 | 0
3122 | 0 | 0 | 0 | 0 | 0
3172 | 0 | 0 | 0 | 0 | 0
3222 | 0 | 0 | 0 | 0 | 0
3272 | 0 | 0 | 0 | 0 | 0
3322 | 0 | 0 | 0 | 0 | 0
3372 | 0 | 0 | 0 | 0 | 0
3422 | 0 | 0 | 0 | 0 | 0
3472 | 0 | 0 | 0 | 0 | 0
3522 | 0 | 0 | 0 | 0 | 0
3572 | 0 | 0 | 0 | 0 | 0
3622 | 0 | 0 | 0 | 0 | 0
3672 | 0 | 0 | 0 | 0 | 0
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
