december454/Microcontroller-Engine-Governor/Data-Logging/3-27-2023/3-27-2023 - PID Tuning - Tuning Dynamic D Gain - (P 025 I 0 D 12) .xlsx

Sheet: 3-27-2023 - PID Tuning - Tuning
Time | RPM | Steps Remaining | PID p | PID i | PID d
1537 | 0 | 0 | 0 | 0 | 0
1587 | 0 | 0 | 0 | 0 | 0
1637 | 0 | 0 | 0 | 0 | 0
1687 | 0 | 0 | 0 | 0 | 0
1737 | 0 | 0 | 0 | 0 | 0
1787 | 0 | 0 | 0 | 0 | 0
1837 | 0 | 0 | 0 | 0 | 0
1887 | 0 | 0 | 0 | 0 | 0
1937 | 0 | 0 | 0 | 0 | 0
1987 | 0 | 0 | 0 | 0 | 0
2037 | 0 | 0 | 0 | 0 | 0
2087 | 0 | 0 | 0 | 0 | 0
2137 | 0 | 0 | 0 | 0 | 0
2187 | 0 | 0 | 0 | 0 | 0
2237 | 0 | 0 | 0 | 0 | 0
2287 | 0 | 0 | 0 | 0 | 0
2337 | 0 | 0 | 0 | 0 | 0
2387 | 0 | 0 | 0 | 0 | 0
2437 | 0 | 0 | 0 | 0 | 0
2487 | 0 | 0 | 0 | 0 | 0
2537 | inf | 0 | 0 | 0 | 0
2587 | inf | 0 | 0 | 0 | 0
2637 | 626.1 | 65 | 74 | 0 | 0
2688 | 626.1 | 16 | 74 | 0 | 0
2738 | 710.33 | 37 | 72 | 0 | -11
2788 | 1099.22 | -4 | 62 | 0 | -86
2838 | 1137.23 | 35 | 61 | 0 | -8
2888 | 1492.69 | -26 | 52 | 0 | -106
2938 | 1774.31 | -31 | 45 | 0 | -81
2988 | 1797.27 | 16 | 45 | 0 | -8
3038 | 2023.47 | 16 | 39 | 0 | -12
3088 | 2270.32 | -12 | 33 | 0 | -52
3138 | 2353.31 | 30 | 31 | 0 | 5
3188 | 2549.29 | -49 | 26 | 0 | -82
3238 | 2618.26 | -35 | 24 | 0 | -69
3288 | 2617.8 | 0 | 24 | 0 | -11
3338 | 2635.74 | 128 | 24 | 0 | 124
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
