december454/Microcontroller-Engine-Governor/Data-Logging/3-27-2023/3-27-2023 - PID Tuning - Tuning Dynamic D Gain - (P 025 I 005 D 10) .xlsx

Sheet: 3-27-2023 - PID Tuning - Tuning
Time | RPM | Steps Remaining | PID p | PID i | PID d
1536 | 0 | 0 | 0 | 0 | 0
1586 | 0 | 0 | 0 | 0 | 0
1636 | 0 | 0 | 0 | 0 | 0
1686 | 0 | 0 | 0 | 0 | 0
1736 | 0 | 0 | 0 | 0 | 0
1786 | 0 | 0 | 0 | 0 | 0
1836 | 0 | 0 | 0 | 0 | 0
1886 | 0 | 0 | 0 | 0 | 0
1936 | 0 | 0 | 0 | 0 | 0
1986 | 0 | 0 | 0 | 0 | 0
2036 | 0 | 0 | 0 | 0 | 0
2086 | 0 | 0 | 0 | 0 | 0
2136 | 0 | 0 | 0 | 0 | 0
2186 | 0 | 0 | 0 | 0 | 0
2236 | 0 | 0 | 0 | 0 | 0
2286 | 0 | 0 | 0 | 0 | 0
2336 | inf | 0 | 0 | 0 | 0
2386 | inf | 0 | 0 | 0 | 0
2436 | inf | 0 | 0 | 0 | 0
2486 | 495.97 | 33 | 77 | 0 | 0
2536 | 495.97 | 0 | 77 | 0 | 0
2586 | 628.83 | 12 | 74 | 0 | -13
2636 | 1073.88 | 0 | 63 | 0 | -80
2686 | 1097.53 | 20 | 62 | 0 | -4
2736 | 1557.79 | 27 | 51 | 0 | -15
2786 | 1758.71 | 0 | 46 | 0 | -59
2836 | 2001.07 | -4 | 39 | 0 | -55
2886 | 2152.7 | -12 | 36 | 0 | -52
2936 | 2373.42 | -27 | 30 | 0 | -59
2987 | 2618.26 | -116 | 24 | 0 | -143
3037 | 2737.23 | -89 | 21 | 0 | -117
3087 | 2866.97 | -100 | 18 | 0 | -131
3137 | 2867.52 | -38 | 18 | 0 | -76
3187 | 2925.69 | 98 | 16 | 0 | 91
3237 | 3165.89 | -61 | 10 | 0 | -72
3287 | 3341.5 | -292 | 6 | 0 | -311
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
