december454/Microcontroller-Engine-Governor/Data-Logging/3-27-2023/3-27-2023 - PID Tuning - Tuning Dynamic D Gain - (P 025 I 005 D 8) .xlsx

Sheet: 3-27-2023 - PID Tuning - Tuning
Time | RPM | Steps Remaining | PID p | PID i | PID d
1423 | 0 | 0 | 0 | 0 | 0
1473 | 0 | 0 | 0 | 0 | 0
1523 | 0 | 0 | 0 | 0 | 0
1573 | 0 | 0 | 0 | 0 | 0
1623 | 0 | 0 | 0 | 0 | 0
1673 | 0 | 0 | 0 | 0 | 0
1723 | 0 | 0 | 0 | 0 | 0
1773 | 0 | 0 | 0 | 0 | 0
1823 | 0 | 0 | 0 | 0 | 0
1873 | 0 | 0 | 0 | 0 | 0
1923 | 0 | 0 | 0 | 0 | 0
1973 | 0 | 0 | 0 | 0 | 0
2023 | 0 | 0 | 0 | 0 | 0
2073 | 0 | 0 | 0 | 0 | 0
2123 | 0 | 0 | 0 | 0 | 0
2173 | 0 | 0 | 0 | 0 | 0
2223 | 0 | 0 | 0 | 0 | 0
2273 | 0 | 0 | 0 | 0 | 0
2323 | 0 | 0 | 0 | 0 | 0
2373 | 0 | 0 | 0 | 0 | 0
2423 | 0 | 0 | 0 | 0 | 0
2473 | 0 | 0 | 0 | 0 | 0
2523 | 0 | 0 | 0 | 0 | 0
2573 | 0 | 0 | 0 | 0 | 0
2623 | 0 | 0 | 0 | 0 | 0
2673 | 0 | 0 | 0 | 0 | 0
2723 | 0 | 0 | 0 | 0 | 0
2774 | 0 | 0 | 0 | 0 | 0
2824 | 0 | 0 | 0 | 0 | 0
2874 | 0 | 0 | 0 | 0 | 0
2924 | 0 | 0 | 0 | 0 | 0
2974 | 0 | 0 | 0 | 0 | 0
3024 | 0 | 0 | 0 | 0 | 0
3074 | 0 | 0 | 0 | 0 | 0
3124 | 0 | 0 | 0 | 0 | 0
3174 | 0 | 0 | 0 | 0 | 0
3224 | 0 | 0 | 0 | 0 | 0
3274 | 0 | 0 | 0 | 0 | 0
3324 | 0 | 0 | 0 | 0 | 0
3374 | 0 | 0 | 0 | 0 | 0
3424 | 0 | 0 | 0 | 0 | 0
3474 | inf | 0 | 0 | 0 | 0
3524 | inf | 0 | 0 | 0 | 0
3574 | inf | 0 | 0 | 0 | 0
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
