december454/Microcontroller-Engine-Governor/Data-Logging/3-27-2023/3-27-2023 - PID Tuning - Tuning Dynamic D Gain 100 - (P 03 I 0 D 12) .xlsx

Sheet: 3-27-2023 - PID Tuning - Tuning
Time | RPM | Steps Remaining | PID p | PID i | PID d
1544 | 0 | 0 | 0 | 0 | 0
1594 | 0 | 0 | 0 | 0 | 0
1644 | 0 | 0 | 0 | 0 | 0
1694 | 0 | 0 | 0 | 0 | 0
1744 | 0 | 0 | 0 | 0 | 0
1794 | 0 | 0 | 0 | 0 | 0
1844 | 0 | 0 | 0 | 0 | 0
1894 | 0 | 0 | 0 | 0 | 0
1944 | 0 | 0 | 0 | 0 | 0
1994 | 0 | 0 | 0 | 0 | 0
2044 | 0 | 0 | 0 | 0 | 0
2094 | 0 | 0 | 0 | 0 | 0
2144 | 0 | 0 | 0 | 0 | 0
2194 | 0 | 0 | 0 | 0 | 0
2244 | 0 | 0 | 0 | 0 | 0
2294 | 0 | 0 | 0 | 0 | 0
2344 | 0 | 0 | 0 | 0 | 0
2394 | 0 | 0 | 0 | 0 | 0
2444 | 0 | 0 | 0 | 0 | 0
2494 | 0 | 0 | 0 | 0 | 0
2544 | 0 | 0 | 0 | 0 | 0
2594 | 0 | 0 | 0 | 0 | 0
2644 | 0 | 0 | 0 | 0 | 0
2694 | 0 | 0 | 0 | 0 | 0
2744 | 0 | 0 | 0 | 0 | 0
2794 | 0 | 0 | 0 | 0 | 0
2844 | 0 | 0 | 0 | 0 | 0
2894 | 0 | 0 | 0 | 0 | 0
2944 | inf | 0 | 0 | 0 | 0
2994 | inf | 0 | 0 | 0 | 0
3044 | inf | 0 | 0 | 0 | 0
3094 | 403.94 | 77 | 95 | 0 | 0
3144 | 972.13 | -27 | 78 | 0 | -111
3194 | 972.13 | 0 | 78 | 0 | -111
3244 | 964.13 | 37 | 79 | 0 | 1
3294 | 1294.67 | 71 | 69 | 0 | 3
3344 | 1428.84 | 18 | 65 | 0 | -38
3394 | 1465.7 | 36 | 64 | 0 | -10
3444 | 1708.43 | 0 | 56 | 0 | -83
3494 | 1944.01 | -14 | 49 | 0 | -81
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
