december454/Microcontroller-Engine-Governor/Data-Logging/3-29-2023/3-29-2023 - Good Results - PID I as alt P gain - (P 013 I 025 D 0_1).xlsx

Sheet: 3-29-2023 - PID Tuning - PID I
Time | RPM | Steps Remaining | PID p | PID i | PID d | RPM Change | P Cmd | I Cmd | D Cmd
90 | inf | 0 | 0 | 0 | 0 | 0 | 0 | 0 | 0
140 | 3504.67 | 0 | 0 | 0 | 0 | 0 | 0 | 0 | 0
190 | 3531.9 | 0 | 0 | 0 | 0 | 0 | 0 | 0 | 0
240 | 3505.49 | 0 | 0 | 0 | 0 | 0 | 0 | 0 | 0
290 | 3515.35 | 0 | 0 | 0 | 0 | 0 | 0 | 0 | 0
340 | 3523.61 | 0 | 0 | 0 | 0 | 0 | 0 | 0 | 0
390 | 3577.39 | 0 | 0 | 0 | 0 | 0 | 0 | 0 | 0
440 | 3567.18 | 0 | 0 | 0 | 0 | 0 | 0 | 0 | 0
490 | 3500.58 | 0 | 0 | 0 | 0 | 0 | 0 | 0 | 0
540 | 3546.1 | 0 | 0 | 1 | 0 | 15.15 | 0 | 1 | 0
590 | 3543.59 | 0 | 0 | 1 | 0 | 26.99 | 1 | 2 | 0
640 | 3528.58 | 0 | 0 | 0 | 0 | 14.17 | 1 | 3 | 0
690 | 3501.4 | 0 | 1 | 0 | 0 | 29.67 | 3 | 4 | 0
740 | 3557.87 | 0 | 0 | 1 | 0 | -38.4 | 4 | 6 | 0
790 | 3544.42 | 0 | 0 | 1 | 0 | 20.22 | 4 | 8 | 0
840 | 3578.24 | 0 | 0 | 0 | 0 | -24.58 | 4 | 9 | 0
890 | 3569.73 | 0 | 0 | 0 | 0 | 32.58 | 4 | 10 | 0
940 | 3581.66 | 0 | 0 | 0 | 0 | -20.41 | 4 | 10 | 0
990 | 3543.59 | 0 | 0 | 1 | 0 | 21.9 | 4 | 12 | 0
1040 | 3610.11 | 0 | 0 | 0 | 0 | -34.42 | 4 | 12 | 0
1090 | 3585.94 | 0 | 0 | 0 | 0 | 24.17 | 4 | 12 | 0
1140 | 3599.71 | 0 | 0 | 0 | 0 | 10.18 | 4 | 12 | 0
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
