december454/Microcontroller-Engine-Governor/Data-Logging/3-29-2023/3-29-2023 - PID Tuning - (P 015 I 0 D 0).xlsx

Sheet: 3-29-2023 - PID Tuning - (P 015
Time | RPM | Steps Remaining | PID p | PID i | PID d | RPM Change
1636 | 0 | 0 | 0 | 0 | 0 | 0
1686 | 0 | 0 | 0 | 0 | 0 | 0
1736 | 0 | 0 | 0 | 0 | 0 | 0
1786 | 0 | 0 | 0 | 0 | 0 | 0
1836 | 0 | 0 | 0 | 0 | 0 | 0
1886 | 0 | 0 | 0 | 0 | 0 | 0
1936 | 0 | 0 | 0 | 0 | 0 | 0
1986 | 0 | 0 | 0 | 0 | 0 | 0
2036 | 0 | 0 | 0 | 0 | 0 | 0
2086 | 0 | 0 | 0 | 0 | 0 | 0
2136 | 0 | 0 | 0 | 0 | 0 | 0
2186 | 0 | 0 | 0 | 0 | 0 | 0
2236 | 0 | 0 | 0 | 0 | 0 | 0
2286 | 0 | 0 | 0 | 0 | 0 | 0
2336 | 0 | 0 | 0 | 0 | 0 | 0
2386 | 0 | 0 | 0 | 0 | 0 | 0
2436 | 0 | 0 | 0 | 0 | 0 | 0
2486 | 0 | 0 | 0 | 0 | 0 | 0
2536 | 0 | 0 | 0 | 0 | 0 | 0
2586 | 0 | 0 | 0 | 0 | 0 | 0
2636 | 0 | 0 | 0 | 0 | 0 | 0
2686 | 0 | 0 | 0 | 0 | 0 | 0
2736 | 0 | 0 | 0 | 0 | 0 | 0
2786 | 0 | 0 | 0 | 0 | 0 | 0
2836 | 0 | 0 | 0 | 0 | 0 | 0
2886 | 0 | 0 | 0 | 0 | 0 | 0
2936 | 0 | 0 | 0 | 0 | 0 | 0
2987 | inf | 0 | 0 | 0 | 0 | inf
3037 | inf | 0 | 0 | 0 | 0 | inf
3087 | 526.83 | 42 | 46 | 0 | 0 | inf
3137 | 526.83 | 0 | 46 | 0 | 0 | inf
3187 | 604.21 | 39 | 44 | 0 | 0 | -77.37
3237 | 604.21 | 0 | 44 | 0 | 0 | -77.37
3287 | 1012.83 | 0 | 38 | 0 | 0 | -408.62
3337 | 1015.57 | 2 | 38 | 0 | 0 | -2.74
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
