december454/Microcontroller-Engine-Governor/Data-Logging/3-29-2023/3-29-2023 - PID Tuning - (P 015 I 002 D 6).xlsx

Sheet: 3-29-2023 - PID Tuning - (P 015
Time | RPM | Steps Remaining | PID p | PID i | PID d | RPM Change
1628 | 0 | 0 | 0 | 0 | 0 | 0
1678 | 0 | 0 | 0 | 0 | 0 | 0
1728 | 0 | 0 | 0 | 0 | 0 | 0
1778 | 0 | 0 | 0 | 0 | 0 | 0
1828 | 0 | 0 | 0 | 0 | 0 | 0
1878 | 0 | 0 | 0 | 0 | 0 | 0
1928 | 0 | 0 | 0 | 0 | 0 | 0
1978 | 0 | 0 | 0 | 0 | 0 | 0
2028 | 0 | 0 | 0 | 0 | 0 | 0
2078 | 0 | 0 | 0 | 0 | 0 | 0
2128 | 0 | 0 | 0 | 0 | 0 | 0
2178 | inf | 0 | 0 | 0 | 0 | inf
2228 | inf | 0 | 0 | 0 | 0 | inf
2278 | inf | 0 | 0 | 0 | 0 | inf
2328 | 378.79 | 34 | 48 | 0 | 0 | inf
2378 | 378.79 | 0 | 48 | 0 | 0 | inf
2428 | 909.86 | 0 | 40 | 0 | -48 | -531.07
2478 | 842.98 | 19 | 41 | 0 | 5 | 66.88
2528 | 832.73 | 37 | 41 | 0 | 0 | 10.25
2578 | 832.73 | 0 | 41 | 0 | 0 | 10.25
2628 | 787.69 | 16 | 42 | 0 | 3 | 45.04
2678 | 1030.57 | 0 | 38 | 0 | -24 | -242.88
2728 | 1034.98 | 25 | 38 | 0 | 0 | -4.41
2778 | 1470.01 | -11 | 31 | 0 | -63 | -435.03
2828 | 1490.76 | 0 | 31 | 0 | -3 | -20.75
2878 | 1788.91 | 13 | 27 | 0 | 0 | 0.85
2928 | 2001.33 | 19 | 23 | 0 | 0 | -1.07
2978 | 2178.65 | 0 | 21 | 0 | -37 | -177.32
3028 | 2374.92 | -6 | 18 | 0 | -48 | -208.86
3078 | 2509.2 | -25 | 16 | 0 | -63 | -245.05
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
