december454/Microcontroller-Engine-Governor/Data-Logging/3-29-2023/3-29-2023 - PID Tuning - Tweaking Equations - (P 015 I 002 D 6).xlsx

Sheet: 3-29-2023 - PID Tuning - Tweaki
Time | RPM | Steps Remaining | PID p | PID i | PID d | RPM Change
88 | inf | 0 | 0 | 0 | 0 | 0
138 | 3656.75 | 0 | 0 | 0 | 0 | 0
188 | 3610.11 | 0 | 0 | 0 | 0 | 0
238 | 3638.13 | 0 | 0 | 0 | 0 | 0
288 | 3610.11 | 0 | 0 | 0 | 0 | 0
338 | 3656.75 | 0 | 0 | 0 | 0 | 0
388 | 3628.45 | 0 | 0 | 0 | 0 | 0
438 | 3675.57 | 0 | 0 | 0 | 0 | 0
488 | 3600.58 | 0 | 0 | 0 | 0 | 0
538 | 3645.2 | 0 | 0 | 0 | 0 | 0
588 | 3619.69 | 0 | 0 | 0 | 0 | 0
638 | 3638.13 | 0 | 0 | 0 | 0 | 0
688 | 3610.11 | 0 | 0 | 0 | 0 | 0
738 | 3656.75 | 0 | 0 | 0 | 0 | 0
788 | 3619.69 | 0 | 0 | 0 | 0 | 0
838 | 3699.14 | 0 | 0 | 0 | 0 | 0
888 | 3618.82 | 0 | 0 | 0 | 0 | 0
939 | 3666.59 | 0 | 0 | 0 | 0 | 0
989 | 3619.69 | 0 | 0 | 0 | 0 | 0
1039 | 3656.75 | 0 | 0 | 0 | 0 | 0
1089 | 3610.11 | 0 | 0 | 0 | 0 | 0
1139 | 3665.69 | 0 | 0 | 0 | 0 | 0
1189 | 3638.13 | 0 | 0 | 0 | 0 | 0
1239 | 3666.59 | 0 | 0 | 0 | 0 | 0
1289 | 3629.32 | 0 | 0 | 0 | 0 | 0
1339 | 3638.13 | 0 | 0 | 0 | 0 | 0
1389 | 3619.69 | 0 | 0 | 0 | 0 | 0
1439 | 3666.59 | 0 | 0 | 0 | 0 | 0
1489 | 3629.32 | 0 | 0 | 0 | 0 | 0
1539 | 3657.64 | 0 | 0 | 0 | 0 | 0
1589 | 3637.25 | 0 | 0 | 0 | 0 | 0
1639 | 3665.69 | 0 | 0 | 0 | 0 | 0
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
