december454/Microcontroller-Engine-Governor/Data-Logging/3-9-2023/GovernorOutputTest2.xlsx

Time | RPM | Steps Remaining | PID p | PID i | PID d
100 | 0 | 0 | 0 | 0 | 0
200 | inf | 0 | 0 | 0 | 0
300 | 500 | 0 | 0 | 0 | 0
400 | 500 | 0 | 0 | 0 | 0
500 | 508.47 | 0 | -9 | 0 | 0
600 | 500 | 0 | -9 | 0 | 0
700 | 500 | 0 | -9 | 0 | 0
800 | 500 | 0 | -9 | 0 | 0
900 | 500 | 0 | -9 | 0 | 0
1000 | 500 | 0 | -9 | 0 | 0
1100 | 508.47 | 0 | -9 | 0 | 0
1200 | 495.87 | 0 | 4 | 0 | 0
1300 | 495.87 | 0 | 4 | 0 | 0
1400 | 500 | 0 | 4 | 0 | 0
1500 | 500 | 0 | 4 | 0 | 0
1600 | 495.87 | 0 | 4 | 0 | 0
1700 | 504.2 | 0 | -4 | 0 | 0
1800 | 500 | 0 | -4 | 0 | 0
1900 | 500 | 0 | -4 | 0 | 0
2000 | 500 | 0 | -4 | 0 | 0
2100 | 500 | 0 | -4 | 0 | 0
2200 | 500 | 0 | -4 | 0 | 0
2300 | 500 | 0 | -4 | 0 | 0
2400 | 504.2 | 0 | -4 | 0 | 0
2500 | 504.2 | 0 | -4 | 0 | 0
2600 | 500 | 0 | -4 | 0 | 0
2700 | 495.87 | 0 | 4 | 0 | 0
2800 | 495.87 | 0 | 4 | 0 | 0
2900 | 495.87 | 0 | 4 | 0 | 0
3000 | 504.2 | 0 | -4 | 0 | 0
3100 | 504.2 | 0 | -4 | 0 | 0
3200 | 495.87 | 0 | 4 | 0 | 0
3300 | 500 | 0 | 4 | 0 | 0
3400 | 495.87 | 0 | 4 | 0 | 0
3500 | 500 | 0 | 4 | 0 | 0
3600 | 500 | 0 | 4 | 0 | 0
3700 | 500 | 0 | 4 | 0 | 0
3800 | 500 | 0 | 4 | 0 | 0
3900 | 500 | 0 | 4 | 0 | 0
4000 | 500 | 0 | 4 | 0 | 0
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
