december454/Microcontroller-Engine-Governor/Data-Logging/3-20-2023/3-20-2023 - Load Test (15A Chop Saw - Rigid CM14500) - Dynamic D Gain Improved .xlsx

Sheet: 3-20-2023 - Load Test (15A Chop
Time | RPM | Steps Remaining | PID p | PID i | PID d
1766 | 0 | 0 | 0 | 0 | 0
1816 | 0 | 0 | 0 | 0 | 0
1866 | 0 | 0 | 0 | 0 | 0
1916 | 0 | 0 | 0 | 0 | 0
1966 | 0 | 0 | 0 | 0 | 0
2016 | 0 | 0 | 0 | 0 | 0
2066 | 0 | 0 | 0 | 0 | 0
2116 | 0 | 0 | 0 | 0 | 0
2166 | 0 | 0 | 0 | 0 | 0
2216 | 0 | 0 | 0 | 0 | 0
2266 | 0 | 0 | 0 | 0 | 0
2316 | 0 | 0 | 0 | 0 | 0
2366 | 0 | 0 | 0 | 0 | 0
2416 | 0 | 0 | 0 | 0 | 0
2466 | 0 | 0 | 0 | 0 | 0
2516 | 0 | 0 | 0 | 0 | 0
2566 | inf | 0 | 0 | 0 | 0
2616 | inf | 0 | 0 | 0 | 0
2666 | 515.55 | 0 | 30 | 0 | 0
2716 | 515.55 | 0 | 30 | 0 | 0
2766 | 643.17 | 0 | 29 | 0 | -4
2816 | 1030.29 | 0 | 25 | 0 | -19
2866 | 1012.15 | 6 | 25 | 0 | 0
2916 | 1249.58 | 0 | 23 | 0 | -14
2966 | 1252.09 | 0 | 23 | 0 | 0
3016 | 1487.21 | 0 | 21 | 0 | -18
3066 | 1710.96 | 0 | 18 | 0 | -18
3116 | 1715.85 | 0 | 18 | 0 | 0
3166 | 1901.62 | 8 | 16 | 0 | 0
3216 | 2073.54 | 14 | 15 | 0 | 0
3266 | 2223.54 | 0 | 13 | 0 | -16
3316 | 2347.42 | 0 | 12 | 0 | -14
3366 | 2468.32 | 0 | 11 | 0 | -14
3416 | 2590.67 | 0 | 10 | 0 | -15
3466 | 2687.21 | 11 | 9 | 0 | 7
3516 | 2791.22 | 0 | 8 | 0 | 1
3566 | 2872.46 | 0 | 7 | 0 | 2
3616 | 3026.02 | 6 | 5 | 0 | 11
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
