december454/Microcontroller-Engine-Governor/Data-Logging/3-20-2023/3-20-2023 - PID Tuning - (Control - No D Gain).xlsx

Sheet: 3-20-2023 - PID Tuning - (Contr
Time | RPM | Steps Remaining | PID p | PID i | PID d
1742 | 0 | 0 | 0 | 0 | 0
1792 | 0 | 0 | 0 | 0 | 0
1842 | 0 | 0 | 0 | 0 | 0
1892 | 0 | 0 | 0 | 0 | 0
1942 | 0 | 0 | 0 | 0 | 0
1992 | 0 | 0 | 0 | 0 | 0
2042 | 0 | 0 | 0 | 0 | 0
2092 | 0 | 0 | 0 | 0 | 0
2142 | 0 | 0 | 0 | 0 | 0
2192 | 0 | 0 | 0 | 0 | 0
2242 | 0 | 0 | 0 | 0 | 0
2292 | 0 | 0 | 0 | 0 | 0
2342 | 0 | 0 | 0 | 0 | 0
2392 | 0 | 0 | 0 | 0 | 0
2442 | 0 | 0 | 0 | 0 | 0
2492 | 0 | 0 | 0 | 0 | 0
2542 | 0 | 0 | 0 | 0 | 0
2592 | 0 | 0 | 0 | 0 | 0
2642 | 0 | 0 | 0 | 0 | 0
2692 | 0 | 0 | 0 | 0 | 0
2742 | 0 | 0 | 0 | 0 | 0
2792 | 0 | 0 | 0 | 0 | 0
2842 | 0 | 0 | 0 | 0 | 0
2892 | 0 | 0 | 0 | 0 | 0
2942 | inf | 0 | 0 | 0 | 0
2992 | inf | 0 | 0 | 0 | 0
3042 | 487.84 | 25 | 31 | 0 | 0
3092 | 487.84 | 0 | 31 | 0 | 0
3142 | 595.36 | 25 | 30 | 0 | 0
3192 | 595.36 | 0 | 30 | 0 | 0
3243 | 595.36 | 0 | 30 | 0 | 0
3293 | 563.53 | 0 | 30 | 0 | 0
3343 | 563.53 | 0 | 30 | 0 | 0
3393 | 511.63 | 0 | 30 | 0 | 0
3443 | 873.52 | 13 | 27 | 0 | 0
3493 | 873.52 | 0 | 27 | 0 | 0
3543 | 862.81 | 0 | 27 | 0 | 0
3593 | 1336.18 | 19 | 22 | 0 | 0
3643 | 1626.19 | 3 | 19 | 0 | 0
3693 | 1645.82 | 0 | 19 | 0 | 0
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
