december454/Microcontroller-Engine-Governor/Data-Logging/3-20-2023/3-20-2023 - PID Tuning - Dynamic D Gain Improved 2.xlsx

Sheet: 3-20-2023 - PID Tuning - Dynami
Time | RPM | Steps Remaining | PID p | PID i | PID d
1803 | 0 | 0 | 0 | 0 | 0
1853 | 0 | 0 | 0 | 0 | 0
1903 | 0 | 0 | 0 | 0 | 0
1953 | 0 | 0 | 0 | 0 | 0
2003 | 0 | 0 | 0 | 0 | 0
2053 | 0 | 0 | 0 | 0 | 0
2103 | 0 | 0 | 0 | 0 | 0
2153 | 0 | 0 | 0 | 0 | 0
2203 | 0 | 0 | 0 | 0 | 0
2253 | 0 | 0 | 0 | 0 | 0
2304 | 0 | 0 | 0 | 0 | 0
2354 | 0 | 0 | 0 | 0 | 0
2404 | 0 | 0 | 0 | 0 | 0
2454 | 0 | 0 | 0 | 0 | 0
2504 | 0 | 0 | 0 | 0 | 0
2554 | 0 | 0 | 0 | 0 | 0
2604 | 0 | 0 | 0 | 0 | 0
2654 | 0 | 0 | 0 | 0 | 0
2704 | 0 | 0 | 0 | 0 | 0
2754 | 0 | 0 | 0 | 0 | 0
2804 | 0 | 0 | 0 | 0 | 0
2854 | 0 | 0 | 0 | 0 | 0
2904 | 0 | 0 | 0 | 0 | 0
2954 | 0 | 0 | 0 | 0 | 0
3004 | 0 | 0 | 0 | 0 | 0
3054 | 0 | 0 | 0 | 0 | 0
3104 | 0 | 0 | 0 | 0 | 0
3154 | 0 | 0 | 0 | 0 | 0
3204 | 0 | 0 | 0 | 0 | 0
3254 | 0 | 0 | 0 | 0 | 0
3304 | 0 | 0 | 0 | 0 | 0
3354 | 0 | 0 | 0 | 0 | 0
3404 | 0 | 0 | 0 | 0 | 0
3454 | inf | 0 | 0 | 0 | 0
3504 | inf | 0 | 0 | 0 | 0
3554 | 521.23 | 0 | 30 | 0 | 0
3604 | 521.23 | 0 | 30 | 0 | 0
3654 | 705.09 | 0 | 28 | 0 | -6
3704 | 1082.41 | 0 | 25 | 0 | -20
3755 | 1077.04 | 0 | 25 | 0 | 0
3805 | 1313.37 | 0 | 22 | 0 | -15
3855 | 1555.69 | 0 | 20 | 0 | -17
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
