december454/Microcontroller-Engine-Governor/Data-Logging/3-10-2023/3-10-2023 - Test (PID P Only - MICROS.xlsx

Sheet: 3-10-2023 - Test (PID P Only -
Time | RPM | Steps Remaining | PID p | PID i | PID d
87 | 0 | 0 | 0 | 0 | 0
137 | 0 | 0 | 0 | 0 | 0
187 | 0 | 0 | 0 | 0 | 0
237 | 0 | 0 | 0 | 0 | 0
287 | 0 | 0 | 0 | 0 | 0
337 | 0 | 0 | 0 | 0 | 0
387 | 0 | 0 | 0 | 0 | 0
437 | 0 | 0 | 0 | 0 | 0
487 | 0 | 0 | 0 | 0 | 0
537 | 0 | 0 | 0 | 0 | 0
587 | 0 | 0 | 0 | 0 | 0
637 | 0 | 0 | 0 | 0 | 0
687 | 0 | 0 | 0 | 0 | 0
737 | 0 | 0 | 0 | 0 | 0
787 | 0 | 0 | 0 | 0 | 0
837 | 0 | 0 | 0 | 0 | 0
887 | 0 | 0 | 0 | 0 | 0
937 | 0 | 0 | 0 | 0 | 0
987 | 0 | 0 | 0 | 0 | 0
1037 | 0 | 0 | 0 | 0 | 0
1087 | 0 | 0 | 0 | 0 | 0
1137 | 0 | 0 | 0 | 0 | 0
1187 | 0 | 0 | 0 | 0 | 0
1238 | 0 | 0 | 0 | 0 | 0
1288 | 0 | 0 | 0 | 0 | 0
1338 | 0 | 0 | 0 | 0 | 0
1388 | 0 | 0 | 0 | 0 | 0
1438 | 0 | 0 | 0 | 0 | 0
1488 | 0 | 0 | 0 | 0 | 0
1538 | 0 | 0 | 0 | 0 | 0
1588 | 0 | 0 | 0 | 0 | 0
1638 | 0 | 0 | 0 | 0 | 0
1688 | 0 | 0 | 0 | 0 | 0
1738 | 0 | 0 | 0 | 0 | 0
1788 | 0 | 0 | 0 | 0 | 0
1838 | 0 | 0 | 0 | 0 | 0
1888 | 0 | 0 | 0 | 0 | 0
1938 | 0 | 0 | 0 | 0 | 0
1988 | 0 | 0 | 0 | 0 | 0
2038 | 0 | 0 | 0 | 0 | 0
3471 | 0 | 0 | 0 | 0 | 0
3521 | 0 | 0 | 0 | 0 | 0
3571 | 0 | 0 | 0 | 0 | 0
3621 | 0 | 0 | 0 | 0 | 0
3671 | 0 | 0 | 0 | 0 | 0
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
