december454/Microcontroller-Engine-Governor/Data-Logging/3-9-2023/Test4 - Good Results.xlsx

Sheet: Test4 - Very Good Results
Time | RPM | Steps Remaining | PID p | PID i | PID d
1051 | 0 | 0 | 0 | 0 | 0
1101 | 0 | 0 | 0 | 0 | 0
1152 | 0 | 0 | 0 | 0 | 0
1202 | 0 | 0 | 0 | 0 | 0
1252 | 0 | 0 | 0 | 0 | 0
1302 | 0 | 0 | 0 | 0 | 0
1352 | 0 | 0 | 0 | 0 | 0
1402 | 0 | 0 | 0 | 0 | 0
1452 | 0 | 0 | 0 | 0 | 0
1502 | 0 | 0 | 0 | 0 | 0
1552 | 0 | 0 | 0 | 0 | 0
1602 | 0 | 0 | 0 | 0 | 0
1652 | 0 | 0 | 0 | 0 | 0
1702 | 0 | 0 | 0 | 0 | 0
1752 | 0 | 0 | 0 | 0 | 0
1802 | 0 | 0 | 0 | 0 | 0
1852 | 0 | 0 | 0 | 0 | 0
1902 | 0 | 0 | 0 | 0 | 0
1952 | 0 | 0 | 0 | 0 | 0
2002 | 0 | 0 | 0 | 0 | 0
2052 | 0 | 0 | 0 | 0 | 0
2102 | 0 | 0 | 0 | 0 | 0
2152 | 0 | 0 | 0 | 0 | 0
2202 | 0 | 0 | 0 | 0 | 0
2252 | 0 | 0 | 0 | 0 | 0
2302 | 0 | 0 | 0 | 0 | 0
2352 | 0 | 0 | 0 | 0 | 0
2402 | 0 | 0 | 0 | 0 | 0
2452 | 0 | 0 | 0 | 0 | 0
2502 | 0 | 0 | 0 | 0 | 0
2552 | 0 | 0 | 0 | 0 | 0
2603 | 0 | 0 | 0 | 0 | 0
2653 | 0 | 0 | 0 | 0 | 0
2703 | 0 | 0 | 0 | 0 | 0
2753 | 0 | 0 | 0 | 0 | 0
2803 | 0 | 0 | 0 | 0 | 0
2853 | 0 | 0 | 0 | 0 | 0
2903 | 0 | 0 | 0 | 0 | 0
2953 | 0 | 0 | 0 | 0 | 0
3003 | 0 | 0 | 0 | 0 | 0
3053 | 0 | 0 | 0 | 0 | 0
3103 | 0 | 0 | 0 | 0 | 0
3153 | 0 | 0 | 0 | 0 | 0
3203 | 0 | 0 | 0 | 0 | 0
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
