december454/Microcontroller-Engine-Governor/Data-Logging/Experiments/Mechanical Governor/Adjustment Test.xlsx

Sheet: Adjustment Test
Time | RPM | Steps Remaining | PID p | PID i | PID d | RPM Change | P Cmd | I Cmd | D Cmd
1226 | 0 | 0 | 0 | 0 | 0 | 0 | 0 | 0 | 0
1276 | 0 | 0 | 0 | 0 | 0 | 0 | 0 | 0 | 0
1326 | 0 | 0 | 0 | 0 | 0 | 0 | 0 | 0 | 0
1376 | 0 | 0 | 0 | 0 | 0 | 0 | 0 | 0 | 0
1426 | 0 | 0 | 0 | 0 | 0 | 0 | 0 | 0 | 0
1476 | 0 | 0 | 0 | 0 | 0 | 0 | 0 | 0 | 0
1526 | 0 | 0 | 0 | 0 | 0 | 0 | 0 | 0 | 0
1576 | 0 | 0 | 0 | 0 | 0 | 0 | 0 | 0 | 0
1626 | 0 | 0 | 0 | 0 | 0 | 0 | 0 | 0 | 0
1676 | 0 | 0 | 0 | 0 | 0 | 0 | 0 | 0 | 0
1726 | 0 | 0 | 0 | 0 | 0 | 0 | 0 | 0 | 0
1776 | 0 | 0 | 0 | 0 | 0 | 0 | 0 | 0 | 0
1826 | 0 | 0 | 0 | 0 | 0 | 0 | 0 | 0 | 0
1876 | 0 | 0 | 0 | 0 | 0 | 0 | 0 | 0 | 0
1926 | 0 | 0 | 0 | 0 | 0 | 0 | 0 | 0 | 0
1976 | 0 | 0 | 0 | 0 | 0 | 0 | 0 | 0 | 0
2026 | 0 | 0 | 0 | 0 | 0 | 0 | 0 | 0 | 0
2076 | 0 | 0 | 0 | 0 | 0 | 0 | 0 | 0 | 0
2126 | 0 | 0 | 0 | 0 | 0 | 0 | 0 | 0 | 0
2176 | 0 | 0 | 0 | 0 | 0 | 0 | 0 | 0 | 0
2226 | 0 | 0 | 0 | 0 | 0 | 0 | 0 | 0 | 0
2276 | 0 | 0 | 0 | 0 | 0 | 0 | 0 | 0 | 0
2326 | 0 | 0 | 0 | 0 | 0 | 0 | 0 | 0 | 0
2376 | 0 | 0 | 0 | 0 | 0 | 0 | 0 | 0 | 0
2426 | 0 | 0 | 0 | 0 | 0 | 0 | 0 | 0 | 0
2476 | 0 | 0 | 0 | 0 | 0 | 0 | 0 | 0 | 0
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
