december454/Microcontroller-Engine-Governor/Data-Logging/3-29-2023/3-29-2023 - PID Tuning - Corrected Dynamic D Gain - (P 02 I 005 D 2) - More Debug Info.txt

------ Microcontroller Engine Governor - Version: 1.16 ------
-------------------------------------------------------------
PID Gains:        Kp: 0.020000   Ki: 0.005000   Kd: 2.000000
-------------------------------------------------------------
Set RPM:             3600    |  Min RPM:                300
                             |
RPM Precision        30       |  PID I Precision:         100
                             |
Start Steps:         850     |  Max Steps:               1200
                             |
RPM Calc Interval:   1       |  Num Magnets:             1
                             |
LCD Update Interval: 400     |  Serial Update Interval:  50
-------------------------------------------------------------

Time,RPM,Steps Remaining, PID p, PID i, PID d, RPM Change, P Cmd, I Cmd, D Cmd
90,inf,0,0,0,0,0.00,0,0,0
140,3735.99,0,0,0,0,0.00,0,0,0
190,3714.71,0,0,0,0,0.00,0,0,0
240,3745.32,0,0,0,0,0.00,0,0,0
290,3724.86,0,0,0,0,0.00,0,0,0
340,3764.12,0,0,0,0,0.00,0,0,0
390,3697.31,0,0,0,0,0.00,0,0,0
440,3763.17,0,0,0,0,0.00,0,0,0
490,3766.01,0,0,0,0,0.00,0,0,0
540,3755.63,0,0,0,0,0.00,0,0,0
590,3796.51,0,0,0,0,0.00,0,0,0
640,3714.71,0,0,0,0,0.00,0,0,0
690,3715.63,0,0,0,0,0.00,0,0,0
740,3695.49,0,0,0,0,0.00,0,0,0
790,3734.13,0,0,0,0,0.00,0,0,0
840,3715.63,0,0,0,0,0.00,0,0,0
890,3726.71,0,0,0,0,0.00,0,0,0
940,3715.63,0,0,0,0,0.00,0,0,0
990,3675.57,0,0,0,0,0.00,0,0,0
1040,3715.63,0,0,0,0,0.00,0,0,0
1090,3647.86,0,0,0,0,0.00,0,0,0
1140,3704.62,0,0,0,0,0.00,0,0,0
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
                             |
RPM Calc Interval:   1       |  Num Magnets:             1
                             |
LCD Update Interval: 400     |  Serial Update Interval:  50
-------------------------------------------------------------
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
