december454/Microcontroller-Engine-Governor/Data-Logging/3-29-2023/3-29-2023 - PID Tuning - PID I as alt P gain - (P 013 I 025 D 0_1) - More Debug Info.txt

------ Microcontroller Engine Governor  P Cmd, I Cmd, D Cmd
90,inf,0,0,0,0,0.00,0,0,0
140,3488.37,0,0,0,0,0.00,0,0,0
------ Microcontroller Engine Governor - Version: 1.16 ------
-------------------------------------------------------------
PID Gains:        Kp: 0.013000   Ki: 0.025000   Kd: 0.100000
-------------------------------------------------------------
Set RPM:             3600    |  Min RPM:                300
                             |
RPM Precision        10       |  PID I Precision:         70
                             |
Start Steps:         850     |  Max Steps:               1200
                             |
RPM Calc Interval:   1       |  Num Magnets:             1
                             |
LCD Update Interval: 400     |  Serial Update Interval:  50
-------------------------------------------------------------

Time,RPM,Steps Remaining, PID p, PID i, PID d, RPM Change, P Cmd, I Cmd, D Cmd
90,inf,0,0,0,0,0.00,0,0,0
140,3504.67,0,0,0,0,0.00,0,0,0
190,3531.90,0,0,0,0,0.00,0,0,0
240,3505.49,0,0,0,0,0.00,0,0,0
290,3515.35,0,0,0,0,0.00,0,0,0
340,3523.61,0,0,0,0,0.00,0,0,0
390,3577.39,0,0,0,0,0.00,0,0,0
440,3567.18,0,0,0,0,0.00,0,0,0
490,3500.58,0,0,0,0,0.00,0,0,0
540,3546.10,0,0,1,0,15.15,0,1,0
590,3543.59,0,0,1,0,26.99,1,2,0
640,3528.58,0,0,0,0,14.17,1,3,0
690,3501.40,0,1,0,0,29.67,3,4,0
740,3557.87,0,0,1,0,-38.40,4,6,0
790,3544.42,0,0,1,0,20.22,4,8,0
840,3578.24,0,0,0,0,-24.58,4,9,0
890,3569.73,0,0,0,0,32.58,4,10,0
940,3581.66,0,0,0,0,-20.41,4,10,0
990,3543.59,0,0,1,0,21.90,4,12,0
1040,3610.11,0,0,0,0,-34.42,4,12,0
1090,3585.94,0,0,0,0,24.17,4,12,0
1140,3599.71,0,0,0,0,10.18,4,12,0
1190,3595.40,0,0,0,0,-41.43,4,12,0
1240,3646.97,0,0,-1,0,-32.52,4,13,0
1290,3595.40,0,0,0,0,-0.87,4,13,0
1340,3641.66,0,0,-1,0,-26.33,4,14,0
1390,3628.45,0,0,0,0,33.66,4,15,0
1440,3628.45,0,0,0,0,-45.07,4,15,0
1490,3617.07,0,0,0,0,29.01,4,16,0
1540,3586.80,0,0,0,0,37.26,4,16,0
1590,3583.37,0,0,0,0,17.20,4,16,0
1640,3602.31,0,0,0,0,34.64,4,16,0
1690,3594.54,0,0,0,0,-32.02,4,16,0
1740,3622.31,0,0,0,0,-16.54,4,16,0
1790,3614.46,0,0,0,0,19.26,4,16,0
1840,3610.11,0,0,0,0,-33.57,4,16,0
1890,3596.26,0,0,0,0,-19.90,4,16,0
1940,3636.36,0,0,0,0,-41.83,4,16,0
1990,3571.43,0,0,0,0,13.66,4,16,0
2040,3624.06,0,0,0,0,-29.53,4,16,0
2091,3585.09,0,0,0,0,28.50,4,16,0
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
