december454/Microcontroller-Engine-Governor/Data-Logging/3-29-2023/3-29-2023 - PID Tuning - Corrected Dynamic D Gain - (P 02 I 005 D 2) - More Debug Info.xlsx

Sheet: 3-29-2023 - PID Tuning - Correc
Time | RPM | Steps Remaining | PID p | PID i | PID d | RPM Change | P Cmd | I Cmd | D Cmd
140 | 3735.99 | 0 | 0 | 0 | 0 | 0 | 0 | 0 | 0
190 | 3714.71 | 0 | 0 | 0 | 0 | 0 | 0 | 0 | 0
240 | 3745.32 | 0 | 0 | 0 | 0 | 0 | 0 | 0 | 0
290 | 3724.86 | 0 | 0 | 0 | 0 | 0 | 0 | 0 | 0
340 | 3764.12 | 0 | 0 | 0 | 0 | 0 | 0 | 0 | 0
390 | 3697.31 | 0 | 0 | 0 | 0 | 0 | 0 | 0 | 0
440 | 3763.17 | 0 | 0 | 0 | 0 | 0 | 0 | 0 | 0
490 | 3766.01 | 0 | 0 | 0 | 0 | 0 | 0 | 0 | 0
540 | 3755.63 | 0 | 0 | 0 | 0 | 0 | 0 | 0 | 0
590 | 3796.51 | 0 | 0 | 0 | 0 | 0 | 0 | 0 | 0
640 | 3714.71 | 0 | 0 | 0 | 0 | 0 | 0 | 0 | 0
690 | 3715.63 | 0 | 0 | 0 | 0 | 0 | 0 | 0 | 0
740 | 3695.49 | 0 | 0 | 0 | 0 | 0 | 0 | 0 | 0
790 | 3734.13 | 0 | 0 | 0 | 0 | 0 | 0 | 0 | 0
840 | 3715.63 | 0 | 0 | 0 | 0 | 0 | 0 | 0 | 0
890 | 3726.71 | 0 | 0 | 0 | 0 | 0 | 0 | 0 | 0
940 | 3715.63 | 0 | 0 | 0 | 0 | 0 | 0 | 0 | 0
990 | 3675.57 | 0 | 0 | 0 | 0 | 0 | 0 | 0 | 0
1040 | 3715.63 | 0 | 0 | 0 | 0 | 0 | 0 | 0 | 0
1090 | 3647.86 | 0 | 0 | 0 | 0 | 0 | 0 | 0 | 0
1140 | 3704.62 | 0 | 0 | 0 | 0 | 0 | 0 | 0 | 0
1190 | 3676.47 | 0 | 0 | 0 | 0 | 0 | 0 | 0 | 0
1240 | 3656.75 | 0 | 0 | 0 | 0 | 0 | 0 | 0 | 0
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
