december454/Microcontroller-Engine-Governor/Data-Logging/3-29-2023/3-29-2023 - PID Tuning - Tweaking Equations - (P 015 I 002 D 6) - More Debug Info.xlsx

Sheet: 3-29-2023 - PID Tuning - Tweaki
Time | RPM | Steps Remaining | PID p | PID i | PID d | RPM Change | P Cmd | I Cmd | D Cmd
1735 | 0 | 0 | 0 | 0 | 0 | 0 | 0 | 0 | 0
1785 | 0 | 0 | 0 | 0 | 0 | 0 | 0 | 0 | 0
1835 | 0 | 0 | 0 | 0 | 0 | 0 | 0 | 0 | 0
1885 | 0 | 0 | 0 | 0 | 0 | 0 | 0 | 0 | 0
1935 | 0 | 0 | 0 | 0 | 0 | 0 | 0 | 0 | 0
1985 | 0 | 0 | 0 | 0 | 0 | 0 | 0 | 0 | 0
2035 | 0 | 0 | 0 | 0 | 0 | 0 | 0 | 0 | 0
2085 | 0 | 0 | 0 | 0 | 0 | 0 | 0 | 0 | 0
2135 | 0 | 0 | 0 | 0 | 0 | 0 | 0 | 0 | 0
2185 | 0 | 0 | 0 | 0 | 0 | 0 | 0 | 0 | 0
2235 | 0 | 0 | 0 | 0 | 0 | 0 | 0 | 0 | 0
2285 | 0 | 0 | 0 | 0 | 0 | 0 | 0 | 0 | 0
2335 | 0 | 0 | 0 | 0 | 0 | 0 | 0 | 0 | 0
2385 | 0 | 0 | 0 | 0 | 0 | 0 | 0 | 0 | 0
2435 | 0 | 0 | 0 | 0 | 0 | 0 | 0 | 0 | 0
2485 | 0 | 0 | 0 | 0 | 0 | 0 | 0 | 0 | 0
2535 | 0 | 0 | 0 | 0 | 0 | 0 | 0 | 0 | 0
2585 | 0 | 0 | 0 | 0 | 0 | 0 | 0 | 0 | 0
2635 | 0 | 0 | 0 | 0 | 0 | 0 | 0 | 0 | 0
2685 | 0 | 0 | 0 | 0 | 0 | 0 | 0 | 0 | 0
2735 | 0 | 0 | 0 | 0 | 0 | 0 | 0 | 0 | 0
2785 | 0 | 0 | 0 | 0 | 0 | 0 | 0 | 0 | 0
2835 | 0 | 0 | 0 | 0 | 0 | 0 | 0 | 0 | 0
2885 | 0 | 0 | 0 | 0 | 0 | 0 | 0 | 0 | 0
2935 | 0 | 0 | 0 | 0 | 0 | 0 | 0 | 0 | 0
2985 | 0 | 0 | 0 | 0 | 0 | 0 | 0 | 0 | 0
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
