december454/Microcontroller-Engine-Governor/Contract Course - Spring 2023/Final-Program-Simulator/Final-Program-Simulator.ino

// Griffin White
// 3-9-2023
// Spring 2023 Contract Course
// Engine Governor: Final Program (Engine Simulator) - Version 1.03

const String version = "1.04";
/* Version 1.04 Changes:
 * * * * * * * * * * * *
 * RPM calculation timer (timeElapsed) now uses microseconds instead of milliseconds. Significant precision improvement.
 */


const int hallSensorPin = 2;                  // Pin for hall effect sensor.
const int numMagnets = 8;                     // Number of magnets on the flywheel.
const int rpmPrecision = 2;                   // Acceptable discrepency between desired and actual RPM.
const int in1 = 3, in2 = 4, in3 = 5, in4 = 6; // Pins for the stepper motor driver.
const int updateInterval = 8;                 // Number of pulses between each calculation of the RPM.
const int minRpm = 300;   
const int startupSteps = 900;   
const int rpmPrecisionI = rpmPrecision + 20;
const int maxSteps = 1200; 
const int serialUpdateInterval = 100;             // Update interval (ms) for the serial output.
const int lcdUpdateInterval = 400;  

int pidP = 0, pidI = 0, pidD = 0;

double desiredRpm = 500;      // Desired RPM.
double rpm = 0;               // Current RPM.
double rpmDiff = 0;           // Difference between the current RPM and desired RPM.
double rpmDiffPrev = 0; 
int sensorActivations = 0;    // Number of times the hall sensor has been activated.
int stepsRemaining = 0;       // Number of stepper motor steps remaining.
int stringIndex = 0;          // Current index within a String being printed to the LCD display.
int minLoopTime = 9999;
int maxLoopTime = 0;
int serialOutputTimePrev = 0;
String stringRpm = "0";       // String representation of the current rpm. 
bool throttleRpmUpdated = false;
boolean directionFlag = false; 

double Kp=1.1, Ki=.001, Kd=0;        // PID variables.  

#include <Wire.h>               // LCD library.
#include <LiquidCrystal_I2C.h>  // LCD library.
#include "Timer.h"              // Timer library.
#include "CheapStepper.h"       // Stepper motor control library.

Timer timeElapsed(MICROS);      // Timer object for RPM calculations.
Timer displayUpdateTimer(MILLIS);    // Timer object for updating the LCD.
Timer pidTimeElapsed(MILLIS);
Timer loopTime(MILLIS);
Timer serialUpdateTimer(MILLIS);
Timer serialOutputTimer(MILLIS);

CheapStepper stepperMotor(in1, in2, in3, in4);  // CheapStepper Object.
LiquidCrystal_I2C lcd(0x27,20,4);               // LCD Object.

void setup() {
  pinMode(hallSensorPin,INPUT_PULLUP);  // Setting the hallSensorPin pinMode to INPUT_PULLUP.
  attachInterrupt(digitalPinToInterrupt(hallSensorPin),countPulse,FALLING); // Attctching an interrupt to the hallSensorPin.
  Serial.begin(115200);                   // Initializing serial output.
  displayUpdateTimer.start();                // Starting the display update timer.
  pidTimeElapsed.start();
  serialOutputTimer.start();
  printDebugInfo();
}

void loop() {
  loopTime.start();
  // If the number of sensorActivations is sufficient to calculate the RPM.
  if (sensorActivations >= updateInterval)    
    calcRpm();

  // If the current RPM is outside of the acceptable range.
  if (abs(rpmDiff) > rpmPrecision)
    adjustThrottle();
  else
    stepperMotor.stop();
//
//  if(displayUpdateTimer.read() >= 400){
//    //Serial.print("RPM: ");
//    //Serial.println(rpm);
//    //Serial.print("Steps Remaining: ");
//    //Serial.println(stepsRemaining);
//    //displayUpdate.start();    
//    updateDisplay();
//  }

  if (serialOutputTimer.read() >= serialUpdateInterval){
    serialOutput();
    serialOutputTimer.start();
  }
  

  if (loopTime.read() > maxLoopTime)
    maxLoopTime = loopTime.read();
  else if (loopTime.read() < minLoopTime)
    minLoopTime = loopTime.read();
}

// Method for calculating the average RPM after a specified number of revolutions.
void calcRpm(){
  // Calculating RPM: (sensor pulses / (time elapsed * 60 sec * 1000000 μs)) / number of magnets on flywheel.
  rpm = (((double)sensorActivations / timeElapsed.read()) * 60000000) / numMagnets;
  sensorActivations = 0;      // Resetting the number of sensor activations.
  timeElapsed.start();        // Resetting the timer.
  rpmDiff = desiredRpm - rpm; // Calculating the difference between the current RPM and desired RPM.  

  throttleRpmUpdated = true;  // Flagging that the RPM was just updated.
}

// Method for adjusting the throttle.
void adjustThrottle(){
  // If the RPM has been updated since the last method call, recalculate the number of stepper motor steps.
  if (throttleRpmUpdated){
    stepsRemaining = calculatePid();  // Set stepsRemaining equal to the output of the PID loop.
    throttleRpmUpdated = false;       // Flagging that the new RPM has been acknowldged.
  }

  if (stepsRemaining > 0){      

    stepperMotor.step(directionFlag);
    stepsRemaining--;
  }  
}

void countPulse(){      
  sensorActivations++;      // Increment the number of sensorActivations.      
}

int calculatePid(){  
  pidP = Kp * rpmDiff;
  pidD = Kd * ((rpmDiff - rpmDiffPrev) / pidTimeElapsed.read());  

  if (abs(rpmDiff) > rpmPrecision)
    pidI += pidI + (Ki * rpmDiff);
  else
    pidI = 0;
  
  pidTimeElapsed.start();

  int total = pidP + pidI + pidD;

  if (total >= 0)
    directionFlag = false;
  else
    directionFlag = true;
  
  return abs(total); 
}

// Method for updating the LCD display.
void updateDisplay(){
  if (stringIndex == 7){
    stringIndex = 0;
    lcd.setCursor(8,1);
    displayUpdateTimer.start();   
//    Serial.print("Main Loop Time - Min: ") ;
//    Serial.print (minLoopTime);
//    Serial.print(" Max: ") ;
//    Serial.println (maxLoopTime);
//    Serial.print("RPM: ");
//    Serial.print(rpm);
//    Serial.print(" Steps Remaining: ");
//    Serial.println(stepsRemaining);
    displayUpdateTimer.start();  
  }
  else{
    if (stringIndex == 0){
      stringRpm = String(rpm) + "        ";      
    }
      
    lcd.print(stringRpm.charAt(stringIndex));
    stringIndex++;     
  }    
}

void serialOutput(){
  Serial.print(millis());
  Serial.print(',');
  Serial.print(rpm);
  Serial.print(',');
  Serial.print(stepsRemaining);
  Serial.print(',');
  Serial.print(pidP);
  Serial.print(',');
  Serial.print(pidI);
  Serial.print(',');
  Serial.println(pidD);
}

void printDebugInfo(){
  Serial.println ((String)"------- Microcontroller Governor Sim -- Version: " + version + " -------");
  Serial.println ("-------------------------------------------------------------");
  Serial.println ((String)"PID Gains:        Kp: " + Kp + "       Ki: " + Ki + "       Kd: " + Kd);
  Serial.println ("-------------------------------------------------------------");
  Serial.println ((String)"Set RPM:             " + desiredRpm        + "  |  Min RPM:                " + minRpm);
  Serial.println ("                             |");
  Serial.println ((String)"RPM Precision        " + rpmPrecision      + "       |  PID I Precision:         " + rpmPrecisionI);
  Serial.println ("                             |");
  Serial.println ((String)"Start Steps:         " + startupSteps      + "     |  Max Steps:               " + maxSteps);
  Serial.println ("                             |");
  Serial.println ((String)"RPM Calc Interval:   " + updateInterval    + "       |  Num Magnets:             " + numMagnets);
  Serial.println ("                             |");
  Serial.println ((String)"LCD Update Interval: " + lcdUpdateInterval + "     |  Serial Update Interval:  " + serialUpdateInterval);
  Serial.println ("-------------------------------------------------------------\n");
  Serial.println ((String)"Time,RPM,Steps Remaining, PID p, PID i, PID d");
}
