december454/Microcontroller-Engine-Governor/(commit log)

2023-02-19 Add files via upload
    Fixed filename length issue.
    [Engine-Governor-State-Based-Adaptive-Aggression.ino]
2023-02-20 Began working on Interrupt Test
2023-02-20 Update Test-Interrupt_Hall_Sensor.ino
    Testing interrupt functionality, while there are other operations taking place in the main loop.
2023-02-20 Update Engine-Governor-State-Based.ino
    Added comment about design error concerning the timer.
    [Engine-Governor-State-Based.ino]
2023-02-20 Update Test-Single_Magnet.ino
    Corrected typo.
    [Test-Single_Magnet.ino]
2023-02-20 RPM via Interrupt Test
    Calculating RPM after a set amount of time has passed.
2023-02-21 Update Test-Interrupt_Hall_Sensor.ino
    Display now updates at a fixed interval.
    [Test-Interrupt_Hall_Sensor.ino]
2023-02-26 Update Test-PID-Loop.ino
    Implemented basic PID functionality, still needs to be tuned.
    Organized / commented code.
2023-02-26 Implemented custom PID code.
    Wrote simple PID control function, no longer using the "PID_v1" library.
2023-02-27 Create Test-LCD_Write_Time.ino
    Testing the time it takes to write to an LCD. Comparing "LiqudCrystal" library to "LiqudCrystal_I2C". The I2C board seems to have significantly worse performance. I will look into replacing it with a traditional 1602 LCD.
2023-02-27 Corrected PID loop typo.
    Corrected typo in PID derivative calculation.
2023-02-27 Updated PID gains.
2023-02-27 Update Test-PID-Loop.ino
    Added code to test the impact of writing to the i2c LCD. Measured the min and max loop time (ms) for the main loop.
2023-03-02 Cleaned up formatting in Test-PID-Loop.
2023-03-02 Added serial output. Tweaked constants.
    Added serial output for logging RPM / steps.
    Tweaked stepper motor parameters.
    Disabled I & D tuning from PID loop for initial testing.
2023-03-02 Version 1.01
    * Program will re-initialize the stepper motor once the engine has stopped.
    * Program will monitor whether or not the engine is running.
    * Program will reset RPM to 0 once the engine has stopped.
    [Final-Program.ino]
2023-03-03 Version 1.02
    * Limit switch is now activated on wide-open throttle, instead of fully closed throttle.
    * Added safety to prevent the stepper from attempting to go beyond wide-open throttle.
    [Final-Program.ino]
2023-03-04 Corrected date for V. 1.02
    [Final-Program.ino]
2023-03-06 Version 1.03
    * Program now features different PID values for startup vs normal operation.
    * PID Tuning, tuning Kd gain.
    * Updated PID 'D' formula.
2023-03-07 Create Final-Program-Simulator.ino
    This is an offshoot of the "Test-PID-Loop" program. That program has grown beyond its original scope; it is now mainly being used as a testbed for the main program, designed to run on the simulator instead of the engine.
    All further developments will be done in this new program.
2023-03-07 Version 1.01
    * Reworked PID loop operation and "directionFlag" assignemnt. PID derivative calculations now function as intended.
    * Cleaned up formatting, removed unused code.
    [Final-Program-Simulator.ino]
2023-03-07 Version 1.04
    * Removed startup & normal operation PID gains from V 1.03.
    * Reworked PID loop operation and "directionFlag" assignment. PID derivative calculations now function as intended.
    [Final-Program.ino]
2023-03-08 Version 1.05
    * Controller now uses a traditional 1602 LCD display, instead of an I2C controlled LCD.
    * Program now uses the much quicker "LiquidCrystal" library instead of the "LiquidCrystal_I2C" library.
2023-03-08 Version 1.02
    * Corrected "directionFlag" assignment. (true and false were swapped)
    [Final-Program-Simulator.ino]
2023-03-08 Version 1.06
    * Added switch to enable / disable the stepper motor.
    * All calls to the "initializeStepper" function are now within the main loop. It will continuously be called until the stepper switch is turned on.
2023-03-08 Corrected error in comments.
    Comments on "directionFlag" assignment were incorrect. (rpmDiff < 0 means that the RPM is too high)
    [Engine-Governor-Final-Commented.ino]
2023-03-09 Version1.03
    * Added debug info which prints to serial upon system startup.
    * Program now outputs comma separated values of time, RPM, steps, & PID variables via serial throughout operation.
    * Serial baud rate increased from 9600 to 115200.
    * Added extra constants from the "Final-Program" so that the debug info is can output in the same format.
2023-03-09 Version 1.07
    * Program now outputs comma separated values of time, RPM, steps, & PID variables via serial throughout operation; this is intended for data logging..
    * Removed old serial output code from "updateDisplay" function.
    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
2023-03-09 Version 1.08
    * Corrected major bug with "initializeStepper" function call. Program would repeatedly call this function while engine was running. This has been resolved.
    [Final-Program.ino]
2023-03-10 Version 1.09
    * PID Tuning.
    * Changed "rpmCalcInterval" from 8 to 1. RPM is now calculated at each flywheel rotation. * Changed "serialUpdateInterval" from 100 ms to 50 ms.
    * Improved formatting for PID gain in debug output.
2023-03-10 Version 1.04
    * RPM calculation timer (timeElapsed) now uses microseconds instead of milliseconds. Significant precision improvement.
2023-03-15 Added data log files from test runs.
    [3-10-2023 - Control (PID P Only - MILLIS).xlsx, 3-10-2023 - Test (PID P Only - MICROS.xlsx, Test4 - Good Results.xlsx]
2023-03-15 Added new photos.
    Added new photos showing the improved carburetor design and changes to the electronics enclosure.
2023-03-20 Version 1.11
    * PID Tuning. Dynamic D gain.
    * PID D gain becomes less aggressive as the RPM approaches the setpoint.
2023-03-20 Version 1.12
    * Improved dynamic D gain.
    * D gain remains constant while rpmDiff >= 300, decreases while rpmDiff >= 200, and then is set to zero while rpmDiff < 200.
    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
2023-03-21 Uploaded new data logs.
    Test runs from 3-20-2023.
    [3-20-2023 - Load Test (15A Chop Saw - Rigid CM14500) - Dynamic D Gain Improved .xlsx, 3-20-2023 - PID Tuning - (Control - No D Gain).xlsx, 3-20-2023 - PID Tuning - Dynamic D Gain Improved 2.xlsx, 3-20-2023 - PID Tuning - Dynamic D Gain Improved.xlsx]
2023-03-27 Uploaded new data logs.
    [3-22-2023 - Stepper Pre-Load - Control (No Throttle Adjustment).xlsx, 3-22-2023 - Stepper Pre-Load 2.xlsx, 3-22-2023 - Stepper Pre-Load.xlsx, 3-24-2023 - Mech Gov - No Load 2.xlsm, 3-24-2023 - PID Tuning - (I 003).xlsx, 3-24-2023 - Tuning - RPM Precision 30 2.xlsx]
2023-03-27 Version 1.13
    * Corrected error in PID I equation.
    * RPM precision.
    * Startup steps.
    [Final-Program.ino]
2023-03-27 Version 1.14
    * Dynamic D Control Removed
    * D RPM Delta Filtered
    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
2023-03-27 Version 1.15
    * PID D control changes, special behavior for major RPM changes.
    * Serial output now prints RPM change since last PID calculation. Useful for tuning PID D gain.
2023-03-30 Uploaded new data logs. Reorganized All Data Logs.
    [3-10-2023 - Control (PID P Only - MILLIS).xlsx, 3-10-2023 - Simulator - Microseconds Test (Control - Milliseconds).xlsx, 3-10-2023 - Simulator - Microseconds Test.xlsx, 3-10-2023 - Test (PID P Only - MICROS.xlsx, 3-20-2023 - Load Test (15A Chop Saw - Rigid CM14500) - Dynamic D Gain Improved .xlsx, 3-20-2023 - PID Tuning - (Control - No D Gain).xlsx, 3-20-2023 - PID Tuning - Dynamic D Gain Improve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]
2023-03-31 Added Data Logs for Experiment Trials
    No Throttle Input: No Load
    No Throttle Input: Constant Load
    Mechanical Governor: No Load
    Mechanical Governor: Constant Load
    [Adjustment Test.xlsx, Trial 1.xlsx, Trial 2.xlsx, Trial 3.xlsx, Trial 4.xlsx, Trial 5.xlsx, Trial 6.xlsx, Trial 7.xlsx]
2023-04-04 Added Data Logs for Experiment Trials
    All experiments for Mechanical Governor.
    [4-3-2023 - PID Tuning - Corrected PID D - (P 013 PA 025 D 1) - Disable Major RPM Change.xlsx, 4-3-2023 - PID Tuning - Corrected PID P Alt - (P 013 PA 025 D 0) - Disable Major RPM Change.xlsx, 4-3-2023 - PID Tuning - Corrected PID P Alt - (P 013 PA 025 D 1) - Disable Major RPM Change.xlsx, 4-3-2023 - PID Tuning - PID P Alt - (P 013 PA 025 D 1) - Disable Major RPM Change.xlsx, 4-3-2023 - PID Tuning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]
2023-04-05 Uploaded additional data logs from PID tuning.
    [4-4-2023 - PID Tuning - PID P Alt - (P 013 I 025 D 1) - Dynamic D Disabled.xlsx, 4-4-2023 - PID Tuning - PID P Alt - (P 02 I 025 D 2) - Major RPM Change Disabled.xlsx, 4-5-2023 - PID Tuning - PID P Alt - (P 013 I 025 D 0_1).xlsx, 4-5-2023 - PID Tuning - PID P Alt - (P 013 I 025 D 3) - Dynamic D Gain Disabled.xlsx, 4-5-2023 - PID Tuning - PID P Alt - (P 02 I 025 D 3) - Dynamic D Gain Updated.xlsx]
2023-04-05 Version 1.16
    * PID I removed.
    * Alternate PID P gain added.
    * Alternate PID D gain added.
    * Serial output now print the total number of steps commanded by each PID component.
    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
2023-04-06 Uploaded Excel files for all experiment data logs.
    [Trial 1.xlsx, Trial 10.xlsx, Trial 2.xlsx, Trial 3.xlsx, Trial 4.xlsx, Trial 5.xlsx, Trial 6.xlsx, Trial 7.xlsx]
2023-04-10 Uploaded Excel Summaries of All Experiments
    [Summary - Mech Gov - Abrupt Load Decrease.xlsx, Summary - Mech Gov - Constant Load.xlsx, Summary - Mech Gov - Load Increase (Initially No Load).xlsx, Summary - Mech Gov - Load Increse (Initially Constant Load).xlsx, Summary - Mech Gov - No Load.xlsx, Summary - Micocontroller Gov - No Load.xlsx, Summary - Micrcontroller Gov - Load Decrease.xlsx, Summary - Microcontroller Gov - Constant Load.xlsx]
2023-04-10 Uploaded Final Excel spreadsheets for individual trials.
    Spreadsheets now include calculations and charts.
    [Trial 1.xlsx, Trial 10.xlsx, Trial 2.xlsx, Trial 3.xlsx, Trial 4.xlsx, Trial 5.xlsx, Trial 6.xlsx, Trial 7.xlsx]
2023-04-10 Corrected Typo in Filename
    [Summary - Mech Gov - Load Decrease.xlsx]
2023-04-19 Added rough draft of Spring 2023 final report.
